matthieu-lapeyre/phd_thesis/media/poppy/conception/head_inspiration.jpg

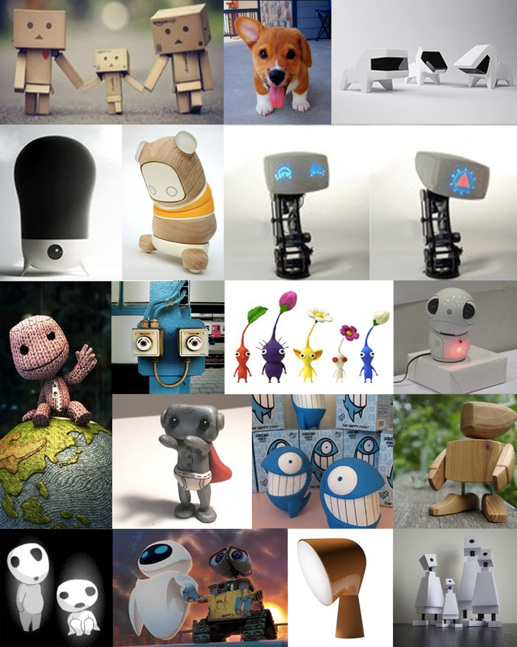
media/poppy/conception/head_inspiration.jpg
