matthieu-lapeyre/phd_thesis/media/poppy/conception/knee_w_spring.png

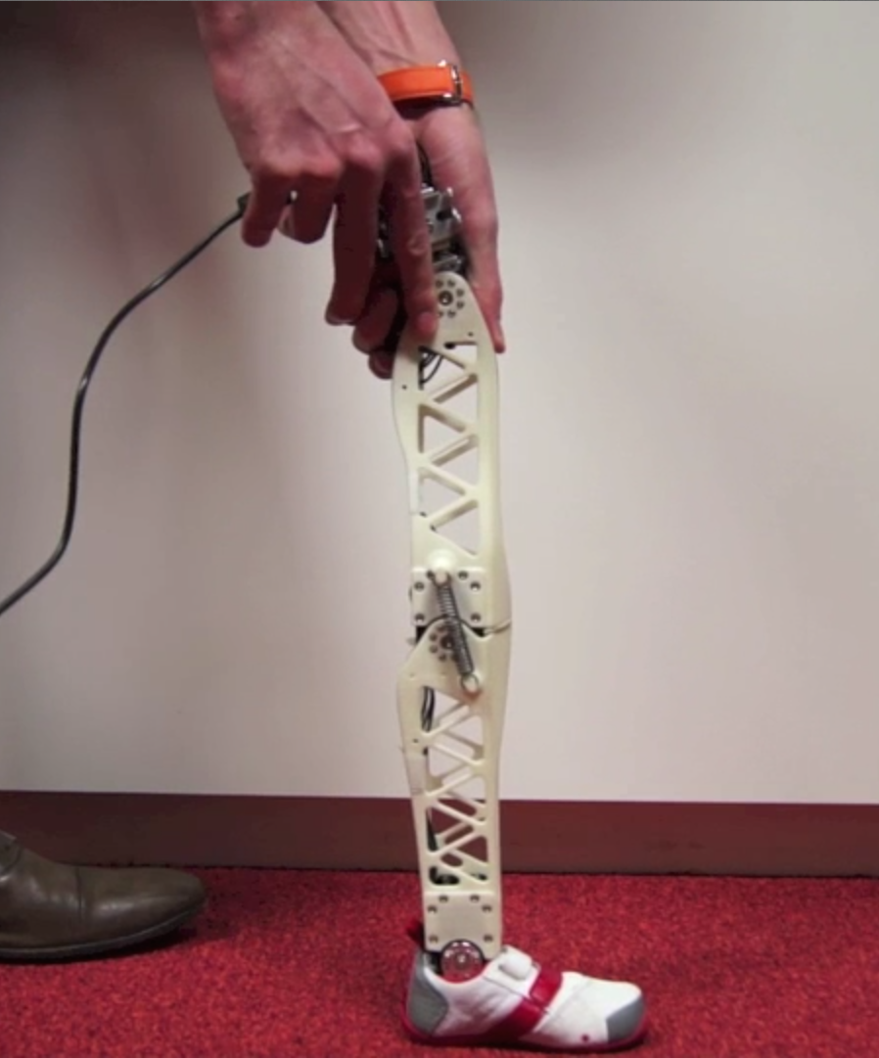
media/poppy/conception/knee_w_spring.png
