matthieu-lapeyre/phd_thesis/README.md

phd_thesis
==========

Redaction of my PhD Thesis
