matthieu-lapeyre/phd_thesis/latex/content/titlepages.tex

% !TEX root = ../thesis.tex
% %
% % ------------------------------------  --> cover title page
% \begin{titlepage}
%     \pdfbookmark[0]{Cover}{Cover}
%     \flushright
%     \hfill
%     \vfill
%     {\LARGE\thesisTitle} \par
%     \rule[5pt]{\textwidth}{.4pt} \par
%     {\Large\thesisName}
%     \vfill
%     \textit{\large\thesisDate} \\
%     Version: \thesisVersion
% \end{titlepage}

% ------------------------------------  --> main title page
\begin{titlepage}
    \pdfbookmark[0]{Titlepage}{Titlepage}
    \tgherosfont

    % \begin{figure}[!t]
    % % \centering
    %     \subfloat{\includegraphics[width=5cm]{Universite_Bordeaux_logo.jpg}}
    %     \hfil
    %     \subfloat{\includegraphics[width=5cm]{Universite_Bordeaux_logo.jpg}}
    % \end{figure}

    % \begin{figure}
      % {\raggedleft
      % \begin{minipage}{6cm}
      % \includegraphics[width=6cm]{Universite_Bordeaux_logo.jpg}
      % \end{minipage}}

    % \begin{figure}
    %     \begin{minipage}{.1\textwidth}
    %         \includegraphics[width=6cm]{Universite_Bordeaux_logo.jpg}
    %     % \hfill
    %     \end{minipage}
    % \end{figure}

    % \begin{figure}
    %     \begin{minipage}{.9\textwidth}
    %     \hfill
    %         \includegraphics[width=6cm]{Universite_Bordeaux_logo.jpg}
    %     \end{minipage}
    % \end{figure}

    \centering

    {\Large \thesisUniversitytwo} \\
    \textsf{\thesisUniversityInstitute} \\[4mm]
    % \textsf{\thesisUniversityDepartment} \\
    % \textsf{\thesisUniversityGroup} \\

    \vfill
    {\large \thesisSubject} \\[5mm]
    {\LARGE \color{ctcolormain}\textbf{\thesisTitle} \\[10mm]}
    {\Large \thesisName} \\ [2mm]
    {\large \thesisUniversity \\
    \thesisUniversityDepartment} \\[4mm]

    \vfill
    \begin{minipage}[t]{.21\textwidth}
        \raggedleft
        {\small \textit{Reviewer}}
    \end{minipage}
    \hspace*{15pt}
    \begin{minipage}[t]{.7\textwidth}
        {\large \thesisFirstReviewer} \\
        {\small \thesisFirstReviewerTitle},
        {\small \thesisFirstReviewerUniversity}
    \end{minipage} \\[5mm]
    \begin{minipage}[t]{.21\textwidth}
        \raggedleft
        {\small \textit{Reviewer}}
    \end{minipage}
    \hspace*{15pt}
    \begin{minipage}[t]{.7\textwidth}
        {\large \thesisSecondReviewer} \\
        {\small \thesisSecondReviewerTitle},
        {\small \thesisSecondReviewerUniversity}
    \end{minipage} \\[5mm]
    \begin{minipage}[t]{.21\textwidth}
        \raggedleft
        {\small \textit{President}}
    \end{minipage}
    \hspace*{15pt}
    \begin{minipage}[t]{.7\textwidth}
        {\large \thesisPresident} \\
        {\small \thesisPresidentTitle},
        {\small \thesisPresidentUniversity}
    \end{minipage} \\[5mm]
    \begin{minipage}[t]{.21\textwidth}
        \raggedleft
        {\small \textit{Examinator}}
    \end{minipage}
    \hspace*{15pt}
    \begin{minipage}[t]{.7\textwidth}
        {\large \thesisExaminator} \\
        {\small \thesisExaminatorTitle},
        {\small \thesisExaminatorUniversity}
    \end{minipage} \\[5mm]

    \begin{minipage}[t]{.21\textwidth}
        \raggedleft
        {\small \textit{Supervisor}}
    \end{minipage}
    \hspace*{15pt}
    \begin{minipage}[t]{.7\textwidth}
        {\large \thesisFirstSupervisor}\\
        {\small \thesisUniversityTitle},
        {\small \thesisUniversity}
    \end{minipage} \\[15mm]

    \thesisDate \\

\end{titlepage}

% ------------------------------------  --> lower title back for single page layout
\hfill
\vfill
{\small
\textbf{\thesisName} \\
\textit{\thesisTitle} \\
\thesisSubject\\
\thesisDate \\
Reviewers: \thesisFirstReviewer\ and \thesisSecondReviewer \\
Jury members: \thesisPresident, \thesisFirstReviewer, \thesisSecondReviewer, \thesisExaminator\ and \thesisFirstSupervisor\\
Supervisor: \thesisFirstSupervisor\\[1.5em]
\textbf{\thesisUniversity} \\
% \textit{\thesisUniversityGroup} \\
% \thesisUniversityInstitute \\
\thesisUniversityDepartment \\
\thesisUniversityStreetAddress \\
\thesisUniversityPostalCode\ \thesisUniversityCity\\
France
}
