matthieu-lapeyre/phd_thesis/latex/content/titlepages_fr.tex

% !TEX root = ../thesis.tex
%
% ------------------------------------  --> cover title page
\begin{titlepage}
    \pdfbookmark[0]{Cover}{Cover}
    \flushright
    \hfill
    \vfill
    {\LARGE\thesisTitle} \par
    \rule[5pt]{\textwidth}{.4pt} \par
    {\Large\thesisName}
    \vfill
    \textit{\large\thesisDate} \\
    Version: \thesisVersion
\end{titlepage}

% ------------------------------------  --> main title page
\begin{titlepage}
    \pdfbookmark[0]{Titlepage}{Titlepage}
    \tgherosfont
    \centering

    {\Large \thesisUniversitytwo} \\
    \textsf{\thesisUniversityInstitute} \\[4mm]
    % \textsf{\thesisUniversityDepartment} \\
    % \textsf{\thesisUniversityGroup} \\

    \vfill
    {\large \thesisSubjectFr} \\[5mm]
    {\LARGE \color{ctcolormain}\textbf{\thesisTitleFr} \\[10mm]}
    {\Large \thesisName} \\ [2mm]
    {\large \thesisUniversity \\
    \thesisUniversityDepartment} \\[4mm]

    \vfill
    \begin{minipage}[t]{.21\textwidth}
        \raggedleft
        {\small \textit{Rapporteur}}
    \end{minipage}
    \hspace*{15pt}
    \begin{minipage}[t]{.7\textwidth}
        {\large \thesisFirstReviewer} \\
        {\small \thesisFirstReviewerTitle},
        {\small \thesisFirstReviewerUniversity}
    \end{minipage} \\[5mm]
    \begin{minipage}[t]{.21\textwidth}
        \raggedleft
        {\small \textit{Rapporteur}}
    \end{minipage}
    \hspace*{15pt}
    \begin{minipage}[t]{.7\textwidth}
        {\large \thesisSecondReviewer} \\
        {\small \thesisSecondReviewerTitle},
        {\small \thesisSecondReviewerUniversity}
    \end{minipage} \\[5mm]
    \begin{minipage}[t]{.21\textwidth}
        \raggedleft
        {\small \textit{Président}}
    \end{minipage}
    \hspace*{15pt}
    \begin{minipage}[t]{.7\textwidth}
        {\large \thesisPresident} \\
        {\small \thesisPresidentTitle},
        {\small \thesisPresidentUniversity}
    \end{minipage} \\[5mm]
    \begin{minipage}[t]{.21\textwidth}
        \raggedleft
        {\small \textit{Examinateur}}
    \end{minipage}
    \hspace*{15pt}
    \begin{minipage}[t]{.7\textwidth}
        {\large \thesisExaminator} \\
        {\small \thesisExaminatorTitle},
        {\small \thesisExaminatorUniversity}
    \end{minipage} \\[5mm]

    \begin{minipage}[t]{.21\textwidth}
        \raggedleft
        {\small \textit{Directeur}}
    \end{minipage}
    \hspace*{15pt}
    \begin{minipage}[t]{.7\textwidth}
        {\large \thesisFirstSupervisor}\\
        {\small \thesisUniversityTitle},
        {\small \thesisUniversity}
    \end{minipage} \\[15mm]

    \thesisDateFr \\

\end{titlepage}

% ------------------------------------  --> lower title back for single page layout
\hfill
\vfill
{\small
\textbf{\thesisName} \\
\textit{\thesisTitleFr} \\
\thesisSubjectFr\\
\thesisDateFr \\
Rapporteurs: \thesisFirstReviewer\ and \thesisSecondReviewer \\
Membres du jury: \thesisPresident, \thesisFirstReviewer, \thesisSecondReviewer, \thesisExaminator\ and \thesisFirstSupervisor\\
Directeur: \thesisFirstSupervisor\\[1.5em]
\textbf{\thesisUniversity} \\
% \textit{\thesisUniversityGroup} \\
% \thesisUniversityInstitute \\
\thesisUniversityDepartment \\
\thesisUniversityStreetAddress \\
\thesisUniversityPostalCode\ \thesisUniversityCity\\
France
}
