matthieu-lapeyre/phd_thesis/latex/content/chapter/OP_RP_review.tex

% !TEX root = ../../thesis.tex

\cleartoleftpage
\includepdf{../media/chapter_illustration/3DprintedBlender.pdf}

\chapter{The open hardware and 3D printing revolution}
\label{cha:3Dprint-OSH}

% \cleanchapterquote{third industrial revolution}{the economist}

\section{Introduction} % (fold)

With the democratization of personal computers and the development of the internet, computer science and related applications have seen a great expansion. Open source software played a major role, indeed most of the web servers are running on the Linux operating system and Apache, while open source software like WordPress, Qt, Firefox, VLC and so on have permitted the realization of a wide variety of applications in daily life~\parencite{peeling2001analysis}.

However, while copying and sharing bits of software is virtually free and can often be run on any computer, producing the atoms of a real object both has a potentially high cost and requires expert tooling. Thus, the production of the mechanic or electronic hardware components is limited to two options: either it is handcrafted or mass produced. Also, the step between the handcrafted prototype and mass production is so large that only big companies can achieve it. Conventional manufacturing processes require the production of specific tools, the programming of complex machines, the human intervention to put the part along the different tool and so on, most of the costs are in the up-front tooling, and the more complicated a product is, the more it costs. Thus, most companies would not accept to run a whole production process just for a few units and if they accept the cost will be so high that most prototypes never find a way of reaching people outside the workshop where they had been created. So until now, production in small or medium series has been extremely difficult to achieve because it has not been profitable.
Only big companies have been able to raise enough money to produce new hardware, meaning niche products and personalization are left aside.

Over the last few years, a novel evolution has begun that is going to completely change the current rules of production and distribution of goods. This evolution is acting on both technological and political/societal front, which tends to confirm the claims of those who argue it will be the next industrial revolution~\parencite{anderson2012makers}. Indeed, new rapid prototyping technologies are emerging and make production cheap, fast and easy to anyone. At the same time, the associated machines and tools are diffused under open source hardware licenses, acting as an unexpected lever arm toward the diffusion of these technologies to anyone. All these radical changes are contextualized by the phenomenon of \emph{makers} and the exponential growth of associative production spaces (e.g Fab Lab, Makerspace, Tech Shop or Hackerspace).

In this chapter, we will first present and discuss ground-breaking 3D printing technology. Then we will present the open source hardware movement and how its interaction with 3D printing is changing the current production paradigm.

\section{The 3D printing revolution} % (fold)

Prototyping is an essential step in a product development and manufacturing cycle. It allows for the form and the functionalities of a new product to be tested before large investment in tooling for mass production. Until the last decade, prototypes were largely handmade by skilled craftsmen, adding weeks or months to the product development time.

\begin{figure}[tb]
\centering
    \subfloat[][Nylon]{\label{fig:3Dprinted_part}}
    \hfil
    \subfloat[][Steel]{\label{fig:3Dprinted_steel}}
    \hfil
    \subfloat[][Odd Guitar]{\label{fig:3Dprinted_guitar}}
    \caption{Some examples of 3Dprinted parts, which were until now impossible to produce. In addition, it can be done with a large range of material from wax to titanium.}
    \label{fig:3D_printed_objects}
\end{figure}

The term 3D printing  encompasses various processes for making a three-dimensional object from a digital model, primarily through additive processes in which successive layers of material are laid down under computer control.
Accurate parts can be produced right from a digital model in few hours and with minimum handling tasks. Consequently, errors are minimized and product development costs and lead times substantially reduced. It has been claimed that rapid prototyping can cut new product costs by up to 70\% and the time to market them by 90\%~\parencite{waterman1994rapid}.

Recent progress in the 3D printing process means 3D printing can be considered not only as a way to produce prototypes but also as an actual production technique. Indeed, the layered method of assembly allows intricate designs - geometries, which are either impossible or too expensive to achieve with conventional metal casting (see \figurename~\ref{fig:3D_printed_objects}).

In this section we detail the different 3D printing techniques available with pros and cons, then we will discuss the expected changes in the industrial sector.

\subsection{Multiple techniques} % (fold)

The term 3D printing encompasses several different additive processes.

\subsubsection{Fused Deposition Modeling (FDM)} % (fold)

The FDM technique relies on melting and selectively depositing a thin filament of thermoplastic polymer (ABS - PLA) in a cross-hatching fashion to form each layer of the part. The material is in the form of a wire supplied in sealed spools, which is mounted on the machine, and the wire is threaded through the FDM head. The head moves in the horizontal X and Y directions to produce each layer through zigzag movements. The supporting table moves in the vertical direction and is lowered after the completion of each layer (see \figurename~\ref{fig:FDM_process}).

\begin{figure}[tb]
    \centering
        \subfloat[][FDM process]{\label{fig:FDM_process}}
        \hfil
        \subfloat[][FDM result example]{\label{fig:FDM_part}}
        \hfil
    \caption{The FDM technique relies on melting and selectively depositing a thin filament of thermoplastic polymer (ABS - PLA) in a cross-hatching fashion to form each layer of the part.}
    \label{fig:FDM_technique}
\end{figure}

It is a technique that is really low-cost and friendly to the office environment but is limited by its slowness on dense parts, the need for supports and its lack of precision for detail, thin walls and surface finish (see \figurename~\ref{fig:FDM_part}).

\subsubsection{Stereo-Lithography (SLA)} % (fold)

This technique relies on a photosensitive monomer resin, which forms a polymer and solidifies when exposed to ultraviolet (UV) light. The UV laser beam moves in a horizontal direction and is focused on the top layer to polymerize the photosensitive resin (see \figurename~\ref{fig:SLA_process}). Due to the absorption and scattering of the beam this reaction only takes place near the surface. Then the cured layer of polymer is lowered by the platform (Z axis) so that a fresh layer of liquid resin covers the part.

\begin{figure}[tb]
    \centering
        \subfloat[][SLA process]{\label{fig:SLA_process}}
        \hfil
        \subfloat[][Some parts made with a SLA printer]{\label{fig:SLA_parts}}
        \hfil
    \caption{The stereolithography technique: a UV laser beam polymerizes the top layer of a photosensitive resin in a horizontal direction (X/Y) while the platform moves in a vertical direction.}
    \label{fig:SLA_technique}
\end{figure}

This technique has several advantages, such as a good surface finish (see \figurename~\ref{fig:SLA_parts}), and is capable of producing highly detailed parts with thin walls, but is limited by material (only photopolymers) and support structures are always needed which can be difficult to remove.

\subsubsection{Selective Laser Sintering (SLS)} % (fold)
The Selective Laser Sintering process uses a high-power (25-50W) CO2 laser beam that melts and fuses finely powdered material spread on a layer. Before the powder is sintered, the entire bed is heated to just below the melting point of the material in order to minimize thermal distortion and facilitate fusion with the previous layer.
While the laser moves on the horizontal plane, the platforms move along the vertical axis -through a distance corresponding to the layer thickness (usually 0.01 mm) - and a counter-rotating roller spreads a precise amount of fresh powder above the sintered layer. The unsintered powder serves as the support for overhanging portions if there are any in the subsequent layers.

\begin{figure}[tb]
    \centering
        \subfloat[][SLS process]{\label{fig:SLS_process}}
        \hfil
        \subfloat[][]{\label{fig:SLS_part}}
        \hfil
    \caption{The Selective Laser Sintering process uses a high-power laser beam that melts and fuses finely powdered material spread on a layer.}
    \label{fig:SLS_technique}
\end{figure}

This technique has a really interesting advantage: it is compatible with different materials (Polyamide, Alumide), moreover it does not require support and mechanical properties of parts are homogeneous (the same in any direction). However, this technique requires some handling to extract extra powder from the part and SLS 3D printers are very expensive (+\$50K).

\subsubsection{Direct Metal Laser Sintering (DMLS)} % (fold)

Direct Metal Laser Sintering is very similar to the SLS process but uses a high-powered 200 watt Yb-fiber optic laser in order to fuse metal powder into a solid part by melting it locally (see \figurename~\ref{fig:DMLS_Process}). Parts are built up additively layer-by-layer, typically using layers 20 micrometres thick. This process allows for highly complex geometries to be created directly from the 3D CAD data, fully automatically, in hours and without any tooling. DMLS is a net-shape process, producing parts with high accuracy and detailed resolution, good surface quality and excellent mechanical properties (see \figurename~\ref{fig:DMLS_part}). However, this is obviously the most expensive technique.

\begin{figure}[tb]
    \centering
        \subfloat[][DMLS part]{\label{fig:DMLS_Process}}
        \hfil
        \subfloat[][DMLS part]{\label{fig:DMLS_part}}
        \hfil
    \caption{Direct Metal Laser Sintering is very similar to the SLS process but uses a high-powered 200 watt Yb-fiber optic laser in order to fuse metal powder into a solid part by melting it locally.}
    \label{fig:DMLS_technique}
\end{figure}

\subsection{Major impact expected in days to come} % (fold)

The 3D printing is revolutionizing the way people can produce parts. On one hand, it brings very affordable numeric production tools to a wide audience. Using these tools, communities have emerged with Fablab, makerspace or hackerspace, where people can create together new projects involving specific and home-made hardware components. As computers have allowed people to produce in their garage new software or websites and eventually develop a novel e-economy, the 3D printing open the landscape of possibilities for hobbyists to innovate by developing novel hardware prototypes and niche products at a fraction of the cost of classical manufacturing techniques.

On the other hand, these techniques also open new horizons for the industry. At The University of Southern California, Professor Behrokh Khoshnevis has built a robot equipped with a nozzle that spews out concrete. This  colossal 3D printer can build a house in 24 hours and therefore dramatically reduces its cost.

Another example is the SuperDraco engine (see \figurename~\ref{fig:superdraco}), this rocket engine has its combustion chamber 3D-printed by direct metal laser sintering (DMLS). The regeneratively-cooled combustion chamber is made of Inconel; a family of nickel-chromium alloy that is noteworthy for its high strength and toughness.

\begin{formal}
    Through 3D printing, robust and high-performing engine parts can be created at a fraction of the cost and time of traditional manufacturing methods. SpaceX is pushing the boundaries of what additive manufacturing can do in the 21st century, ultimately making our vehicles more efficient, reliable and robust than ever before.

    \signed{Elon Musk, SpaceX CEO/CTO and Tesla Motors CEO.}
\end{formal}

Thus, parts for vehicles can be optimized to be lighter and - simultaneously - incredibly robust (see \figurename~\ref{fig:EADS_hinge}). The AMAZE project has been able to print airplane wing sections as well as jet engine parts, and the ESA hopes to one day print a satellite as one piece:
\begin{formal}
    This novel technology offers many advantages. 3D printing, formally known as additive manufacturing, can create complex shapes that are impossible to manufacture with traditional casting and machining techniques. Little to no material is wasted and cutting the number of steps in a manufacturing chain offers enormous cost benefits.

    \signed{European Space Agency (ESA)}
\end{formal}

\begin{figure}[tb]
\centering
    \subfloat[][The SuperDraco rocket engine has a combustion chamber: 3D-printed - SpaceX.]{\label{fig:superdraco}}
    \hfil
    \subfloat[][A conventional hinge is seen in the background and a 3D-printed metal hinge is seen in the foreground - EADS.]{\label{fig:EADS_hinge}}
    \caption{Thanks to its special properties, 3D printing is hitting the industry}
    \label{fig:industrie_printing}
\end{figure}

\subsection{Conclusion} % (fold)

3D printers open new horizons as they are able to produce parts which were, until now, either not possible or extremely expensive to produce using classical techniques while adding several key abilities:
\begin{itemize}
    \item \textbf{Accessible:} 3D printed parts can be obtained everywhere, either by personal printing or by using an online service\footnote{examples: i.materialise, Shapeways or Sclupteo}.
    \item \textbf{Low cost:}  from tens of cents if produced on a personal printer to tens of euros if outsourced through web services. Also, the cost is not proportional to the part’s complexity, meaning designers are free to explore the shape they want with almost no constraints.
    \item \textbf{Fast:} Production takes only a few hours from scratch and does not require any specific upfront tooling.
    \item \textbf{Skill-free:} while the production process is fully digital, few or no specialist skills are required.
    \item \textbf{Multi-material, precise and robust:} the current 3D printers can create precise (up to 0.1mm) parts from different materials such as Polyamide, PLA, ABS and even titanium or flexible material. The obtained parts are robust and can often be used as final parts for several years.
    \item \textbf{Reduces the number of parts:} 3D printing permits the printing of complex parts and even assembled parts as complex as bearings or gearboxes. This means we can replace multiple parts that have to be assembled by a single ready-to-use part right after production.
\end{itemize}

\section{The open hardware movement} % (fold)

The concept of "open-source hardware" or "open hardware" is not as well known or widespread as the free software or open-source software concepts yet. However, it shares the same principles: anyone should be able to see the source (the design documentation in case of hardware), study it, modify it and share it.

\subsection{Open hardware in the industrial history.} % (fold)

In the 18th century, London and Lyon (France) were two majors silk manufacturing towns. Because London was on the way to taking the lead, Lyon tried a new and original policy for innovation. They decided to freely diffuse new techniques. Inventors were invited to the city hall to present their innovations publicly. They were then rewarded a first time for the presentation, and a second time when the innovation was actually implemented on Lyon machines. This policy was followed by decades of cumulative inventions such as perforated paper tape (1725 B. Bouchon), punched card programming (1728, J-B. Falcon), the Jacquard loom (1801, J-M. Jacquard), and the sewing machine (1829, B.Thimonnier). Meanwhile, silk production in London was governed by patents, techniques were kept secret and monopolized by their inventors~\parencite{alain1997fate}.

The impact of these two opposed political choices turned out largely in Lyon’s favour. In 1815, Lyon had 14,500 looms and London 12,000. But in 1853, Lyon had 60,000 looms while London fell to only 5,000 and became a silk importer.

Lyon stimulated inventions and disseminated innovation: looms became programmable, order processing and production agile, parts were standardized, counter-tops parts appeared, services grew, the Lyon loom park was up to date and operational.
In London, the industry was controlled by investors, customers had to order large series, the choice available decreased, waiting periods were longer, the artisans became employees, wages fell and the state of the London looms park deteriorated.

The Lyon policy created a win-win ecosystem creating both job opportunities and advanced technology. Thanks to this choice, the city took the lead over London.

\subsection{Definition of Open Hardware } % (fold)

The Open Source Hardware Association (OSHWA) aims to be the voice of the open hardware community. It promotes the use and development of open source hardware for education and economic development, to collect, compile and publish data on the open source movement and organize the movement around shared principles.

Also the Open Source Hardware Association defines\footnote{Complete definition available on \url{http://www.oshwa.org/definition/}.} open source hardware as:

\begin{row}{4}{2}
    \begin{cell}{3}
        \emph{Hardware whose design is made publicly available so that anyone can study, modify, distribute, make, and sell the design or hardware based on that design. The hardware’s source, the design from which it is made, is available in the preferred format for making modifications to it. Ideally, open source hardware uses readily-available components and materials, standard processes, open infrastructure, unrestricted content, and open-source design tools to maximize the ability of individuals to make and use hardware. Open source hardware gives people the freedom to control their technology while sharing knowledge and encouraging commerce through the open exchange of designs.}
    \end{cell}
    \begin{cell}{1}
        \begin{NFfigure}
            \centering
                
            \caption{The open source hardware logo}
            \label{fig:ohw-logo}
        \end{NFfigure}
    \end{cell}
\end{row}

\subsection{Open source hardware licenses} % (fold)

The Open Source Hardware Association definition is not enough, a legal framework is needed to both protect and promote open hardware projects. This is the role of open source licenses which will be discussed in this section.

In general, there are two broad classes of open-source licenses: copyleft and permissive. Copyleft licenses (sometimes referred to as “viral”) are those that require derivative works to be released under the same license as the original; common copyleft licenses include the GNU General Public License (GPL) and the Creative Commons Attribution-ShareAlike license. Other copyleft licenses have been specifically designed for hardware; they include the CERN Open Hardware License (OHL) and the TAPR Open Hardware License (OHL). Permissive licenses are those that allow for proprietary (closed) derivatives; they include the FreeBSD license, the MIT license, and the Creative Commons Attribution license

\subsubsection{Creative Commons licenses} % (fold)
\begin{row}{4}{2}
    \begin{cell}{3}
        Founded in 2001, Creative Commons is a non-profit organization that enables the sharing and use of creativity and knowledge through free legal tools. They provide free and understandable licenses standardizing the way to share and use creative work. Thanks to the use of several modules, which can be combined, the Creative Commons licenses permit the creator to modify his copyright terms to best suit his needs. First intended for artistic and cultural content such as music and writing, the Creative Commons are now used also to share open source hardware files.
    \end{cell}
    \begin{cell}{1}
        \begin{NFfigure}
            \centering
                
            \caption{Creative Commons logo}
            \label{fig:cc_logo}
        \end{NFfigure}
    \end{cell}
\end{row}
The Creative Commons licenses are based on four major condition modules:
\begin{description}
    \item[Attribution (BY)]: requiring attribution to the original author.
    \item[Non Commercial (NC)]: requiring the work to not be used for commercial purposes.
    \item[No Derivative works (ND)]: allowing only the original work, without derivatives
    \item[Share Alike (SA)]: allowing derivative works under the same or a similar license (later or jurisdiction version).
\end{description}

The combination of these modules leads to six licenses (see \figurename~\ref{fig:all-cc-licenses}) but related to open hardware, only two of them are considered as open source following the OSHW definition:
\begin{description}
    \item[Attribution CC BY] People can distribute, remix, tweak and build upon the licensed work, even commercially, as long as they credit the authors of the original creation.
    \item[Attribution-ShareAlike CC BY-SA] People can distribute, remix, tweak and build upon the licensed work, even commercially, as long as they credit the authors and license their new creations under identical terms. \textbf{This license is often compared to the “copyleft” free and open source software licenses.}
\end{description}

\begin{figure}[tb]
    \begin{center}
        
    \end{center}
    \caption{The combination of the 4 Creative Commons modules give 6 licenses allowing creators to choose how they want to share their work and how "open" they are.}
    \label{fig:all-cc-licenses}
\end{figure}

\subsubsection{CERN OHL} % (fold)

Inspired by the open source software movement, the Open Hardware Repository\footnote{\url{http://www.ohwr.org/}} was created to enable hardware developers to share the results of their R\&D activities. The recently published (March 2013) CERN Open Hardware License offers the legal framework to support this knowledge and technology exchange.

The CERN–OHL is to hardware what the General Public Licence (GPL) is to software. It defines the conditions under which a licensee will be able to use or modify the licensed material and is compliant with the OSHWA definition criteria. In the spirit of knowledge sharing and dissemination, the CERN Open Hardware Licence (CERN OHL) governs the use, copying, modification and distribution of hardware design documentation, and the manufacture and distribution of products\footnote{License details available on \url{http://www.ohwr.org/projects/cernohl/wiki}}.

\subsubsection{TAPR Open Hardware License (OHL)}
Specifically designed for open hardware, and avoids the issues other licenses have with focusing on copyright protection of documentation instead of the right to make, distribute, or use a product based on that documentation\footnote{The full text of the TAPR Open Hardware License (OHL) is available here: \url{http://www.tapr.org/ohl.html}}. It requires that all derived works use the same license and include before and after documentation if any changes were made.

\subsection{Some famous open hardware projects} % (fold)

Based on the open source hardware philosophy, several companies and projects have been created over the past ten years (see \figurename~\ref{fig:oh_evolution}).

\begin{figure}[tb]
\centering
    \subfloat[][Creation of new open hardware projects per year between 2005 and 2011.]{\label{fig:oh_project_evolution}}
    \hfil
    \subfloat[][Start-up creation based on open hardware distribution]{\label{fig:oh_startup_creation}}
    \caption{Evolution of the open source hardware movement in the past decades. Graph extracted from \emph{HOPE 2010 - How to run an open source hardware company}}
    \label{fig:oh_evolution}
\end{figure}

Several kinds of object have began to have an open source version, even the most advanced ones such as laptops (Novena project\footnote{\url{https://www.crowdsupply.com/kosagi/novena-open-laptop}}), reflex camera (OpenReflex\footnote{\url{http://www.instructables.com/id/3D-Printed-Camera-OpenReflex/}}) or even cars (LocalMotors\footnote{\url{https://localmotors.com/vehicles/}}, OSVehicle\footnote{\url{http://www.osvehicle.com/}}).

\subsubsection{Arduino} % (fold)
\label{sec:arduino-review}
One of the most meaningful open hardware project is Arduino. Massimo Banzi was a teacher from the Interaction Design Institute Ivrea in Italy. His students were using \emph{BASIC Stamp}\footnote{A BASIC Stamp module is a single-board computer that runs the Parallax PBASIC language interpreter in its microcontroller.} for a cost of \$100 and often complained they couldn't find an inexpensive, powerful microcontroller to drive their arty robotic projects.

\begin{row}{4}{2}
    \begin{cell}{3}
      In 2005 Banzi and David Cuartielles, a Spanish microchip engineer, decided to design their own board. The Arduino project aimed to offer an affordable and easy to use electronics board for a student-friendly price: \$30. The first wiring design was done during the Ph.D. thesis of Hernando Barragan~\parencite{barragan2004wiring} and the software by another student: David Cuartielles.
      After the wiring platform was complete, researchers worked to make it lighter, less expensive, and available to the open source community.
    \end{cell}
    \begin{cell}{1}
        \begin{NFfigure}
            \centering
                
            \caption{The Arduino logo}
            \label{fig:arduino_logo}
        \end{NFfigure}
    \end{cell}
\end{row}

The Arduino story was one of the first hardware projects with a real desire to promote innovation through open source, so to make it work they had to find an appropriate licensing solution that could apply to their board. After some investigation, they realized that if they simply looked at their project differently, (i.e. considering the source files as documentation\footnote{\emph{"You could think of hardware as piece of culture you want to share with other people"}, Banzi. }), they could use a license from Creative Commons normally used for cultural works such as music and writing.

They define their work as:

\begin{formal}
  Arduino is a platform for prototyping interactive objects using electronics. It consists of both hardware and software: a circuit board that can be purchased at low cost or assembled from freely-available plans; and an open-source development environment and library for writing code to control the board. Arduino comes from a philosophy of learning by doing and strives to make it easy to work directly with the medium of interactivity. It extends the principles of open source to the realm of hardware, supporting a community of people working with and extending the platform. It has been used in universities around the world and in numerous works of interactive art.

  \signed{Mellis~\parencite{mellis2007arduino}}
\end{formal}

By 2006, Arduino has sold 5,000 boards, the next year 30,000. Following the idea of open source collaboration the community eventually grows until 100,000 people and thousand of side projects and derivatives emerged. In 2013, Arduino has registered over 700,000 official boards but has estimated that there is at least one derivative or clone board per every official one.

Today, Arduino is a very successful project with more than 1,000,000 boards sold and a wide range of low-cost electronics boards\footnote{http://arduino.cc/en/Main/Products}. Moreover, there are now dozens of open-hardware oriented companies building new products on top of Arduino environment, the most famous ones being Sparkfun\footnote{\url{http://www.sparkfun.com/}} and Adafruit\footnote{\url{http://www.adafruit.com/}}.

\subsubsection{Shapeoko}

\begin{figure}[!ht]
    \begin{center}
        
    \end{center}
    \caption{The shapeoko v2 is a low cost and open source CNC 2.5 axes.}
    \label{fig:shapeoko}
\end{figure}

Designed by Edward Ford, Shapeoko (see \figurename~\ref{fig:shapeoko}) is a simple, low cost (\$685) and open source (CC-BY-SA) CNC milling machine. It is based on two other open hardware projects: MakerSlide\footnote{Open a source linear bearing system under Creative Common BY-SA licenses: \url{http://makerslide.com/}} for linear motion and an Arduino board for the control.

\subsubsection{RepRap} % (fold)

The RepRap project started in 2005 and based on the Fab@Home\footnote{\url{http://www.fabathome.org/}} principles, developed a multi-purpose open source 3D printer using Fused Deposition Modeling, a technique with the particularity of being largely self-replicating:

\begin{formal}
    RepRap is an open-source, self-replicating, rapid prototyping machine. It is a robot that uses fused-filament fabrication1 to make engineering components and other products from a variety of thermoplastic polymers. RepRap has been designed to be able automatically to print out a significant fraction of its own parts. All its remaining parts have been selected to be standard engineering materials and components available cheaply worldwide. As the machine is free and open-source anyone may – without royalty payments – make any number of copies of it either for themselves or for others, using RepRap machines themselves to reproduce those copies.

    \signed{~\cite{jones2011reprap}}
\end{formal}

\begin{figure}[tb]
\centering
    \subfloat[][RepRap v2]{\label{fig:RepRap_v2}}
    \hfil
    \subfloat[][MakerBot Replicator v1]{\label{fig:makerbot-replicator}}
    \caption{Two examples of very low-cost FDM 3D printers.}
    \label{fig:RepRap_project}
\end{figure}

Distributed under GNU General Public License, the RepRap (see \figurename~\ref{fig:RepRap_v2}) was one of the first low-cost 3D printers. Thanks to the fact that it is genuinely collaborative, this project generated such a large number of variations and interpretations that is difficult to even count. One of them is the famous Makerbot Replicator (see \figurename~\ref{fig:makerbot-replicator}). Now Makerbot is one of the major worldwide general public 3D printer distributors.

\section{Conclusion}

The emergence of new and accessible rapid prototyping techniques changes ways of producing things. Because it is now quick, simple and cheap to make things, it opens the realm of possibility of sharing hardware because anyone can produce it.

The 3D printing and open source hardware are complementary. Indeed, open source projects are more relevant when, as the software, people contributing can build the project at home. In this way, 3D printing can act as a lever arms for open hardware projects while open hardware projects are meaningful to widespread the use of 3D printers.

Also, Arduino has shown how useful can be open hardware projects and opened new perspectives allowing non-expert people to easily create interactive objects. While ones could think open sourcing is dangerous for economic viability, Arduino demonstrated that it actually generates new kind of economy, derivative contributing to the development of the community rather than stealing commercial parts.

Following this example, Tesla Motor have recently released open source all their patents about electric cars. Elon Musk\footnote{SpaceX CEO/CTO and Tesla Motors CEO} is a genuine inventor, yet also a very good businessman. This act is not a philanthropic idea, it will actually permit Tesla to develop its economy. Indeed, they are the only active actor on the electric car market. To increase the market, more actor are needed. By releasing their patents, Tesla hopes to create dynamically favorable to the expansion of their market. By this way, they target to have a good part of a big market rather than having a big part of a small market.

Therefore, using 3D printing technique and open hardware distribution model appear to be promising for the future of technology and economic development.
