matthieu-lapeyre/phd_thesis/latex/content/chapter/morphology-role.tex

% !TEX root = ../../thesis.tex

\newpage
\section{Experimental evaluation of the role of the morphology: the thigh shape} % (fold)
\label{sec:morphology-role}

The role of morphology in robot bipedal locomotion has been particularly explored through the research on passive dynamic walkers~\parencite{wisse2007passive}. The most famous example concerns Tad MacGeer's work~\parencite{mcgeer1990passive}. Thanks to the understanding of the intrinsic dynamics of its structure, McGeer has managed to create a 2D biped robot capable of producing several steps without any controller or motor.
The only control of this robot is obtained through the interaction between the intrinsic inertia of the structure and gravity.
This work has been pursued with the appearance of semi-passive walkers combining both specific passive properties and low power actuation to increase their robustness~\parencite{Anderson2005}. We can note the work of Collins~\parencite{collins2005bipedal} which explored the case of a semi-passive 3D biped robot. Its morphology is based on a particular mass distribution, knee locking, round feet and springs on the legs to generate an efficient walking gait while keeping its lateral and frontal balance.
The concept of the 3D semi-passive robot has been pushed even further with the realization of a complete humanoid robot with a torso, arms and head: the robot Denise~\parencite{wisse2005three} and Flame presented in~\parencite{Hobbelen2008}.

\begin{figure}[!t]
\centering
    \subfloat[][bended thighs]{\label{fig:poppy_with_bended_legs}}
    \hfil
    \subfloat[][straight thighs]{\label{fig:poppy_with_classical_legs}}
    \caption{We evaluate the effect of thigh morphology on the bipedal locomotion dynamic.
    Experiments are made using the Poppy humanoid platform.
    In this paper, we compare two thigh morphologies: (a) thigh bended by an angle of 6\textsuperscript{o} and (b) a more classical approach with straight thighs.}
    \label{fig:poppy_compared}
\end{figure}

The geometry and distribution of mass in the body has complex influences on bipedal locomotion. Several studies have, for example, explored the role of the foot and ankle morphology for bipedal walking in both humans~\parencite{Adamczyk2006}~\parencite{Hughes1990} and robots~\parencite{hobbelen2005ankle}~\parencite{Davis2010}. However, to our best knowledge no research has focused on the role of the thigh for bipedal locomotion.  A few robots like HRP-4C~\parencite{kaneko2009cybernetic} and Kenshiro humanoid~\parencite{nakanishi2013design} robots seem to visually have a morphological design close to the thigh shape of Poppy, but no comparative study of the role of this shape was presented so far.

Thanks to the mechanical design of Poppy, allowing easy, cheap and fast morphological modifications, we are able to experiment with various thigh shapes on the robot’s dynamics and find out what impact those have. In particular, in this experiment, we will focus on its bio-inspired thigh shape, bended by an angle of 6\textsuperscript{o}. We will investigate the impact of this thigh design on balance and bipedal locomotion using a comparison with a more traditional straight thigh (see Fig.~\ref{fig:poppy_compared}).

% The results presented in the upcoming sections have been published in the Humanoids 2013 conference proceeding~\parencite{lapeyre:hal-00861110}.

\subsection{Understanding the role of the thigh shape in humans} % (fold)

If we look closely at the morphology of the human femur, it appears that it is inclined by an angle of 6\textsuperscript{o}. This makes the feet closer to the projection of the center of gravity (CoG) (see Fig.~\ref{fig:human_thigh_experiments}) therefore it reduces the distance travelled by the CoG to move from foot to another.

The model presented in appendix~\ref{appendix:thigh_model} has been used during the conception of Poppy to decide the use of bended thigh rather than classic straight one. This simple model, based on an inverted pendulum, shows this particular shape may enhance the stability in two main ways during the walking gait:

\begin{itemize}
    \item As the feet are closer to the center of gravity, the lateral translation of the CoG necessary to transfer the mass of the robot from one foot to another is reduced (see Fig~\ref{fig:human_thigh_experiments}). In the case of Poppy's morphology, thanks to the $6$\textsuperscript{o} bended thigh, the lateral motion of the CoG is reduced by about 30\% ($ 5 cm$ instead of $7.1 cm$).
    \item During the stance phase, the CoG initial conditions are slightly modified. Therefore, it reduces the CoG falling speed in the beginning. So if we consider the first 700 ms of the system behavior simulation and compare the two systems, the mean of the CoG falling speed is reduced by around 56\% in the bended thigh case.
\end{itemize}

\begin{figure}[tb]
\centering
    \subfloat[][Effect of bended human femur on human bipedal locomotion]{\label{fig:human_thigh_experiments}}
    \hfil
    \subfloat[][Implementation of the bended thigh on the poppy platform]{\label{fig:thigh_of_poppy}}
    \caption{The human femur is inclined by an angle of 6\textsuperscript{o}, this reduces the distance traveled by the CoG to be supported from one leg to the other during walking. We reproduced it on Poppy and suggest exploring its impact on the robot dynamics.}
    \label{fig:poppy_thigh_experiment}
\end{figure}

\subsection{Experimenting with variable thigh properties on Poppy} % (fold)

The simple model described in appendix~\ref{appendix:thigh_model} showed that a slight inclination (6\textsuperscript{o}) of the thigh can theoretically achieve a significant gain in the lateral stability of the robot during the two main phases of the walking gait (i.e. single stance phase and double stance phase).
Yet this model is very simple and Poppy allows to experiments easily the role of morphology in the real world with all its complexity.

Therefore, we modified the thigh shape and printed it. As shown on the \figurename~\ref{fig:thigh_drawings}, the only modified parameter is the thigh bending angle, two cases: 6\textsuperscript{o} and 0\textsuperscript{o}.

\begin{figure}[p]
    \begin{center}
        
    \end{center}
    \caption{Blueprints of the two thighs tested in this experiment. The only parameter explored is the bending angle of the thigh: 6\textsuperscript{o} and 0\textsuperscript{o}}
    \label{fig:thigh_drawings}
\end{figure}

In this section, we describe representative experiments, which evaluate the actual gain of the thigh shape on the real Poppy platform. To do this, we used both a pair of straight thighs and the bended thighs presented above. We will compare Poppy's reactions with those different legs (see \figurename~\ref{fig:poppy_compared} and \figurename~\ref{fig:thigh_drawings}) on three experiments:
\begin{itemize}
    \item Evaluate the falling speed during single support stance.
    \item Measure the lateral translation to move the CoG Form one foot to the other.
    \item Record the upper body motion during bipedal locomotion.
\end{itemize}

\subsubsection{Single support falling velocity} % (fold)
\label{ssub:falling_velocity}
The experiment evaluates the velocity of fall when Poppy is supported on only one foot and compare it with the theoretical results obtained in~\ref{sub:exp_theoritical_model}. To do so, the robot's head is tracked by an Optitrack\footnote{\url{http://www.naturalpoint.com/optitrack/products/v120-trio/}} device and markers are placed on the head. In postural balance on two feet, a motor order triggers the rise of a foot which unbalances the robot (see Fig.~\ref{fig:falling_experiment_dispositif}) and causes its lateral fall (see Fig.~\ref{fig:fall_of_poppy}). This experiment was repeated about fifteen times for the two cases studied, i.e. with bended legs (Fig.~\ref{fig:poppy_with_bended_legs}) and with straight legs (Fig.~\ref{fig:poppy_with_classical_legs}).

\begin{figure}[ht]
\centering
    \subfloat[][ Initial perturbation provoked by the sudden raise of one foot]{\label{fig:falling_experiment_dispositif}}
    \hfil
    \subfloat[][ view of Poppy’s lateral fall over time]{\label{fig:fall_of_poppy}}
    \caption{Run of the single support falling experiment.
    The markers on Poppy’s headband track its absolute position over time.}
    \label{fig:falling_experiment}
\end{figure}

Experiments results are shown in Fig.~\ref{fig:falling_results}. The blue color is assigned to experiments with bended thighs while the red color is assigned to straight thighs. For each case, the light color corresponds to the standard deviation and the dark color to the 95\% confidence interval of the mean value. The first figure~(\ref{fig:fall_result_position}) refers to the head altitude position over time and the second~(\ref{fig:fall_result_velocity}) to the falling velocity of the head. Dashed lines represent theoretical results obtained with the model presented in section~\ref{fig:model_thigh_appendix}. We notice the strong similarity both on the shape and on the difference between the two morphologies studied. Yet, there is a slight time shift between theoretical and experimental results. This can be explained by the inertia of the real robot which was not taken into account during the simulation.

\begin{figure}[ht]
\centering
    \subfloat[][Vertical head position]{\label{fig:fall_result_position}}
    \hfil
    \subfloat[][Vertical head falling velocity]{\label{fig:fall_result_velocity}}
    \caption{Results of the single support falling experiment.
    The blue color is associated with experiments conducted with bended thighs while the red color is assigned to straight thighs.
    For each case, the light color corresponds to the standard deviation and the dark color to the 95\% confidence interval of the mean value while dashed lines represent theoretical results.
    These figures show the vertical position (a) and vertical falling velocity (b) of the head of Poppy over time for each case studied.
    The curve’s behavior change after 800 min is due to the fact that we catch the robot before it touches the ground.}
    \label{fig:falling_results}
\end{figure}

These figures show a clear improvement for the version of Poppy with bended thighs (blue curves) with a 200 min time shift compared to the straight thighs (as illustrated on the attached video\footnote{\url{http://flowers.inria.fr/Humanoid2013/}\label{video}}).
Thanks to this delay, the falling speed is reduced by about 56\% during the first 700ms. Thus, the robot remains almost stationary for 600 min (400 min in the case of straight thigh).  Poppy’s typical walking gait  takes a period of one second so the mono-pedal stance phase lasts around 420 min~\parencite{lapeyre2013poppy}. Considering that the robot remains stationary during more time than the single stance phase, we can imagine that the lateral balance control will be reduced during the walking gait.

\subsubsection{Double support CoG transfer} % (fold)
\label{sub:cog_motion}

In this experiment, we evaluate the lateral movement of the robot necessary to cause a displacement of its center of gravity from one foot to the other and we verify the theoretical results obtained previously. For this, Poppy is placed on a force platform to measure the displacement of its center of pressure. The absolute movements of the robot are tracked with an OptiTrack device and markers placed at the head and lower back (approximately the position of the actual center of gravity). The robot is kept rigid in a neutral position and a human physically pushed it from left to right until it reached its lateral falling limit. As this operation is not very accurate, the experiment is repeated one hundred times.

\begin{table}[ht]
\centering
\begin{tabular}{|l|c|c|c|}
  \hline &      Straight tigh &                     Bended Tigh &                   diff(\%) \\
  \hline CoP & 74.6 {\scriptsize$\pm$9.0} mm &     49.8 {\scriptsize$\pm$7.7} mm & 33\\
  Head & 100.1{\scriptsize$\pm$14.4} mm&     62.9{\scriptsize$\pm$22.0} mm &  37\\
  Lower Back & 64.1{\scriptsize$\pm$11.5} mm&      43.4{\scriptsize$\pm$15.0} mm &  32 \\
  \hline
\end{tabular}
\caption{Summary of the results obtained during the experiment on the lateral motion needed to transfer the robot’s mass from one foot to the other.}
\label{tab:CoG_motion}
\end{table}

Table~\ref{tab:CoG_motion} presents for each area considered (i.e. center of pressure (under feet), lower back and head motion) the amplitude of the lateral motion (in millimeters) needed to translate the CoG of the robot from one foot to the other for the two versions of Poppy’s thigh design. The last columns summarize the relative difference between the two conceptions (in percent). One can note that the results show a reduction of lateral movement of around 30\%. Thanks to the shape of the thigh, the lateral displacement of the upper body required to move the CoG from one foot to the other can be reduced.

The results presented on the two first experiments show improvement for two main aspects needed during bipedal locomotion: lateral stability and mass transfer. In the next experiment, we will evaluate if there is a significant performance gain in a complex dynamic phase such as bipedal walking.

\subsubsection{Walking dynamic} % (fold)
\label{sub:walking_dynamic}

As explained in the introduction and description of the platform, Poppy has been specially designed to study bipedal walking and human-robot interaction.

Here the experiment consists of playing an open-loop walking pattern while the robot is guided through the physical interaction with a human. The user’s role is to provide both balance and control of mass transfer. By producing small lateral motion on the upper-body, they can help the robot to move its CoG from one foot to another.

\begin{figure}[tb]
    \centering
    
    \caption{Proceeding of the walking experiment.
    Poppy is tracked by an Optitrack trio while it is walking on a treadmill set at 1.8km/h.
    An expert user provides the sagittal balance needed throughout the experiment.}
    \label{fig:walking_experiment}
\end{figure}

The gait is based on the actual human sagittal joint kinematic~\parencite{Nester2003}: hip, knee, ankle (see Fig.~\ref{fig:CPG}.a). A direct transposition of the human joint kinematic on the Poppy's morphology results in a walking speed which is too fast to be handled by users (see Fig.~\ref{fig:CPG}.b). A simple reduction of a joint’s amplitude leads to an unsuitable leg trajectory where toes bump into the ground during the swing phase (see Fig.~\ref{fig:CPG}.c). So to ensure enough clearance during the swing phase and suitable walking speed for the guidance with a user, we modified the trajectories of the joints by hand to both reduce the length step and increase the foot clearance (see Fig.~\ref{fig:CPG}.d). The actual gait on Poppy is shown in Fig.~\ref{fig:humanoids2013_cpg_on_poppy}.

\begin{figure}[tb]
    \centering
    
    \caption{Trajectories of toes generated by the walking pattern a) Kinematics of human walking
    with human morphology b) Direct transposition of human kinematics onto Poppy's morphology
    c) Reducing amplitude of the human kinematics joints with Poppy's morphology d) Walking pattern
    used for the experiment with Poppy}
    \label{fig:CPG}
\end{figure}

\begin{figure}[tb]
    \centering
    
    \caption{Walking gait CPG described on Fig.~\ref{fig:CPG}.d applied on the actual Poppy robot.
    The CPG generates a human-like walking gait allowing the robot to walk at 1.8km/h and involves straight legs during the stance phase.
    There is no balance control, but stability is obtained through physical guidance with a trained expert user.}
    \label{fig:humanoids2013_cpg_on_poppy}
\end{figure}

In this experiment, we are interested in the dynamic of Poppy especially on the frontal plane and we will compare the effect of the thigh shape on this dynamic. Poppy walks on a treadmill following the walking gait described above. An expert user trained to keep the robot in the correct walking cycle provides guidance to the robot. This is done by keeping the robot in a vertical position and supporting, in a compliant manner, the lateral movement of the robot as illustrated in attached videos. The user is asked to do the best he can to minimize the movement/forces he applies in both morphologies to reduce the bias towards the two designs experimented. All proprioceptive sensors are recorded at 50hz while an Optitrack device associated  with markers located at the head and lower back measure the absolute displacements of the robot (see Fig.~\ref{fig:walking_experiment}).

Poppy’s movement is recorded for around 1800 walking gait cycles for each thigh design (around 90,000 data points for each case). Data are folded over to extract the gait behavior over a gait cycle. Results are presented in Fig.~\ref{fig:walk_result}. As previously, the blue color is assigned to experiments with bended thighs, the red color is assigned to straight thighs. For each case, the light color corresponds to the standard deviation and the dark color to the 95\% confidence interval of the mean value.

\begin{figure}[p]
    \subfloat[][Lateral head displacement]{\label{fig:head_position}}
    \hfil
    \subfloat[][Lateral lower back displacement]{\label{fig:low_back_position}}
    \hfil
    \subfloat[][Sagittal head acceleration]{\label{fig:head_acceleration_x}}
    \hfil
    \subfloat[][Lateral head acceleration]{\label{fig:head_acceleration_y}}
    \hfil
    \subfloat[][Speed of rotation in the frontal plane]{\label{fig:head_gyro_x}}
    \hfil
    \subfloat[][Head inclinaison]{\label{fig:head_tilt_x}}
    \caption{Results obtained during the walking experiment.
    The blue color is associated with experiments conducted with bended thighs while the red color is assigned to straight thighs.
    For each case, the light color corresponds to the standard deviation and the dark color to the 95\% confidence interval of the mean value.
    All data are folded over to extract the mean gait behavior and its standard deviation over a walking gait cycle expressed in percent.}
    \label{fig:walk_result}
\end{figure}

The two first figures (i.e. ~\ref{fig:head_position} and ~\ref{fig:low_back_position}) show the lateral motion of the upper body in millimeters over the gait cycle. We notice that for the two designs, the motion pattern shown by the upper body (head and lower back) is similar. However, in the case of the bended thigh (blue) the amplitude of the motion is reduced by about 45\%. Another interesting effect concerns the head perturbations shown on figures ~\ref{fig:head_acceleration_x}, and ~\ref{fig:head_acceleration_y}. Here also, patterns are similar but in the case of the bended thigh the head is clearly less perturbed by the walking dynamic, with a reduction in amplitude of approximately 30\%. Five pictures were taken while Poppy was walking and were stacked in Fig.~\ref{fig:poppy_walking_compared}. This shows a qualitative point of view of the walking dynamic for both studied cases.
We notice that the lateral motion of the version of Poppy with bended thighs~\ref{fig:poppy_walking_bended} is small compared to the version with straight thighs~\ref{fig:poppy_walking_straight}.

\begin{figure}[ht]
\centering
    \subfloat[][bended thigh]{\label{fig:poppy_walking_bended}}
    \hfil
    \subfloat[][straight thigh]{\label{fig:poppy_walking_straight}}
    \caption{Five pictures have been taken while Poppy was walking and were stacked to obtain a qualitative view of the difference in the walking behavior in relation to the morphology of the thigh.}
    \label{fig:poppy_walking_compared}
\end{figure}

\subsection{Conclusion on the thigh shape role for bipedal locomotion} % (fold)
We focus on the shape of the Poppy thigh and its effect on the robot’s dynamic. We studied the role of morphology in the reduction and simplification of the control needed to perform a complex task such as bipedal walking. We have presented the simple theoretical model we used for the design of Poppy’s thigh based on the inverse pendulum dynamic. We have conducted experiments to evaluate the improvements of the bended thigh on the real robot dynamic and compared it to the model. Since Poppy’s structural design allows easy, cheap and fast morphological modifications, we were able to try another thigh design. We also used a pair of straight thighs which is a more classical approach in humanoid conception. The experimental comparison between the two thighs design confirmed the theoretical results, the bio-inspired thigh design improves Poppy’s dynamic in two main ways useful for bipedal walking:
\begin{itemize}
    \item It reduces the falling velocity by almost 60\% when the robot is on one foot (single support phase).
    \item It reduces the lateral motion needed to transfer the mass of the robot from one foot to the other (double support phase) by 30\%.
\end{itemize}
It is really interesting to note that such a small modification of the robot morphology has a very significant impact on the robot’s behaviour.

These results are interesting, but they do not reflect the Poppy’s real walking dynamic. To evaluate the effect of the bended thigh on bipedal locomotion, we conducted a third experiment where Poppy is walking on a treadmill. In this experiment, we show that the bended thigh has an effect on a complex dynamic task such as the biped locomotion: it reduces the motion amplitude on the upper body  by 45\% and increases the head stability by 30\%. We choose these metrics due to our experimental constraints (fixed speed, social guidance) as a qualitative evaluation of the walking gait. Moreover, it provides us with an intuitive, yet incomplete evaluation of the walking. Many other measures could have been chosen or combined such as speed, energy consumption or robustness to external perturbations. It is still complicated to understand which metric is the most adapted for robotic biped locomotion. As human beings are trained to recognize a bipedal gait, users can provide guidance to the robot for both safety of exploration and evaluation of the walking behaviour.

% subsection Results (end)
