matthieu-lapeyre/phd_thesis/latex/content/chapter/poppy.tex

% !TEX root = ../../thesis.tex

\cleartoleftpage
\includepdf{../media/chapter_illustration/papaver_rhoeas}
\chapter{The development of Poppy} % (fold)
\label{cha:poppy-dev}

\section{Introduction} % (fold)

\begin{figure}[tb]
\centering
    \subfloat[][Nao]{\label{fig:nao_platform}}
    \hfil
    \subfloat[][Darwin-Op]{\label{fig:darwin_platform}}
    \hfil
    \subfloat[][Acroban]{\label{fig:acroban_platform}}
    \caption{None of the existing platforms in 2012 was suitable for exploring the role of morphology. Nao was impossible to modify. Darwin Op and Acroban used aluminium parts that are really difficult and expensive to produce.}
    \label{fig:2012_Humanoids}
\end{figure}

In 2012, when we started this project, none of the existing humanoid platforms was suitable for exploring the role of morphology. There were two kinds of platforms. On one hand commercial robots that are rather easy to use and accessible but with a static and frozen morphology. On the other hand, prototype robots produced in labs to address specific experimentation needs, studying interesting morphologies but complicated to use and impossible to reproduce outside the lab. In both cases, only a few are open source, limiting hacks, extensions or modifications of their morphologies even further.

In the Flowers Lab, we had both kinds of robots. We used Nao (see \figurename~\ref{fig:nao_platform}) to study human-robot interaction (\cite{rouanet2009integrated} \cite{rouanet2012apprendre}). It was really convenient for use by researchers who are not interested in hardware issue since they are addressing more high-level research challenges. Yet such a platform is limited as it is not possible to modify the robot if it is not strictly adapted to our experiment. For example, back at this time the Nao camera was not efficient, with a closed field of view and a slow frame rate. We have difficulty achieved 5 frames/seconds. Although we had the necessary skills to hack Nao and change the camera to fit our needs, its hardware was not designed to be changed. Improving the vision performance would only be possible with the addition of an external camera on the Nao head which could ruin the user experience. In addition, it would have been interesting to explore how the camera parameters (FOV, framerate, resolution...) can change the user experience but again, it is not possible with this robot.

We also used Acroban (see \figurename~\ref{fig:acroban_platform}) designed by Olivier Ly~\parencite{ly2011bio}. It is a handcrafted humanoid platform created to explore certain morphological properties, especially compliance, with the aim of achieving dynamic locomotion and playful physical human-robot interaction.
While it actually allows modification of its is morphology, it is manufactured from aluminium mechanical parts, Robotis Dynamixel motors, scotch, and rubber bands cobbled together, and changing it requires a lot of efforts. The manufacture of aluminium parts required is especially complicated and requires either very good handiwork or a 3-axis CNC.
In addition, its use was quite complicated and while several researchers could have been interested in Acroban to study human-robot interaction and social acceptance, It was not possible to use it without significant mechanical work.
Finally, the material and manufacturing process make the platform non-stationary. Even if a lab manages to reproduce it, there is a high probability that the physical properties will not be the same. Therefore, the diffusion and the reproducibility of results are limited.

A last alternative would be the use of Darwin Op robot (see \figurename~\ref{fig:darwin_platform}) which is both open source and easily accessible (Robotis sells it already assembled for \$10K), yet as Acroban its hardware consists of manufactured metal parts making its morphology very difficult and expensive to modify. Moreover, even if Darwin is open source and very popular, to our knowledge its morphology has never be modified by the research community\footnote{We can also notice the lack of community management tools such as wiki, forum and correct versioning system. If someone create a variation of Darwin, there is no place where he can share it.}.

Thus one of the main goals was to successfully design a humanoid robot which can merge the advantages of both kind of robot, i.e. simple, accessible, reproducible and allowing to easily change and hack its morphology for scientific experiments that can be both customized and shared.

\subsection{An experiment-proof robot} % (fold)
\label{sec:experiment-proof}

Most researchers can attest to the difficulty and frustration faced while conducting robotic experimentation in the real world. We are challenged daily by bugs, technical issues, unpredicted events and side effects. While a bug in software can be fixed, an error with a hardware platform can cause damage to the robot and postpone the results of an experiment by several weeks.

Therefore, many researchers in robotics avoid technical issues associated with the real world experimentation by using simple models and physical simulation. But the real world is extremely more complex and richer than the virtual one.
Some high-level behaviour experiments are conducted in simulators based on the hypothesis that real-world constraints are not relevant, yet it is really certain?
Indeed, while the real world constitutes a lot of constraints, it is also rich in complex physical effects (gravity, friction, inertia), which should be taken into consideration and could be very useful if interacting with the agent.

As we saw in the related work (chapter~\ref{cha:morphology-review}), the emergence of complex behaviours appears thanks to the interaction between the real world and simple robotic systems. We cannot program behaviour because behaviour is the result of interaction  between the program and the real world. Thus, we cannot design behaviour without the ecological niche of the robot~\cite{Steels1991emergence}.

While using simulators can be helpful as a first step to design robots, it appears incomplete when showing results on the role of morphology without real world experimentation.
Therefore, when one wants to study the role of morphology on robot behavior, being able to explore it in the real world is of paramount importance. Unfortunately, current tools make the experimental step really hard to achieve for researchers.

Throughout our work on building cognitive and developmental learning algorithms~(\cite{Oudeyer07},\cite{moulin2013exploration}), we have experienced these issues, especially while building and using Acroban~\cite{ly2011bio} and during the Ergo robot experience (see chapter~\ref{cha:art}). Much time has been spent debugging non-robust technologies, but it has been very instructive for understanding those that are efficient and those that should be avoided.
Therefore, Poppy has been designed based on the background experience we have acquired building using robots acting in the real world.

\begin{description}
    \item[Robustness and Safety:] Demanding and lengthy real-world experimentation necessitates that the robot be robust and safe. It should be able to sustain experiments and fall down without easily breaking. At the same time, one should ensure that physical interaction with the robot is safe for humans.
    \item [Precision, stationary:]Experiments should be repeatable, implying that the robot properties should be stationary.
    \item [Breakable, repairable:] Breaking should not be costly and the robot should be easily repairable.
    \item [Transportable:] To allow for experiments in natural environments, possibly involving interaction with non-technical humans, the robot should be transportable outside the laboratory.
    \item [Easy and fast to duplicate:]If the robotic platform is to be reused  in this way, it must be easy and fast to duplicate.
    \item [Affordable:] To ensure widespread use, a key factor is to keep the cost of the platform relatively low. The more labs can be involved, the greater the scientific impact.
\end{description}

To respond to these needs we created Poppy (see \figurename~\ref{fig:poppyv0.1_overview}).

\subsection{Overview} % (fold)

Poppy is a small and lightweight 25-DoFs humanoid robot (see section~\ref{sec:poppy-modularity}), whose morphological design allows for quick and simple modification by non-expert people. This is achieved thanks to the use of the 3D printing technique for the mechanical structure and Arduino based electronics architecture (see section~\ref{sec:poppy-electronic}). Its motors are common and widely used off-the-shelf Robotis actuators, and allow for compliant control and soft physical human-robot interaction. The pypot library (see chapter~\ref{cha:pypot}) enables programming beginners as well as advanced roboticists to control the robot and is adapted to the modularity of Poppy’s hardware.

\begin{figure}[tb]
    \begin{center}
        
    \end{center}
    \caption{Overview of Poppy beta with the main specs and features. This figure will be updated when the final release of Poppy is ready.}
    \label{fig:poppyv0.1_overview}
\end{figure}

Its current morphology takes inspiration from the human functional morphology: a large number of joints (25 motors), the limbs respect human proportions, it has five joints in the torso and its thighs are bended by a $6\deg$ angle, similar to human ones (see section~\ref{sub:poppy-leg-design}).

All the work and material involved in building, creating and using Poppy is distributed under open source and open hardware licenses. The 3D-printed skeleton and the electronics boards are under Creative Commons licenses while the pypot library is distributed under GPLv3 licenses.

Poppy is the first open source and 3D-printed complete humanoid robot, the design of such a novel platform will be discussed in the following sections.

\section{Exploring morphological variants} % (fold)
\label{sec:poppy-modularity}

The whole structure must be easily reconfigurable both for the purposes of repairing and hacking. This means the process of replacing Poppy's parts must be simple, low-cost and not require time or special tooling. Also, in order to have a real impact in the open hardware community, special attention is given to the modularity and the reusability of our technological bricks.
Poppy is fully modular (mechanic, electronic, software) allowing freely exploration and modification of Poppy's body.
Its modularity and the use of 3D printing make Poppy highly hackable. Therefore, it can be easily adapted to particular experimental setups and allows diverse exploration into its morphology.

\subsection{3D printed parts} % (fold)

We introduced for the first time the use of 3D-printed mechanical parts in our work when we built the ergo-robot installation (August 2011 - see chapter~\ref{cha:art}). The result was impressive as the parts were robust, precise, low-cost and fast to produce. Very convinced by this technology and with a keen desire to be free to explore robot morphology, we decided to build the whole mechanical structure of Poppy based on 3D printing techniques.

\subsubsection{Technique used} % (fold)

Several 3D techniques exist and were presented in the related work (see chapter~\ref{cha:3Dprint-OSH}). The Stereo-Lithography\footnote{This technique relies on a photosensitive monomer resin, which forms a polymer and solidifies when exposed to ultraviolet (UV) light.} (SLA) is very precise yet the material is not well adapted to support mechanical stresses.

Alternatively, we can use Fused Deposition Modelling\footnote{The FDM technique relies on melting and selectively depositing a thin filament of thermoplastic polymer (ABS - PLA) in a cross-hatching fashion to form each layer of the part.} (FDM), which has the great advantage of being very low cost (2000\$ for the printer + 40\$/kg of material) and therefore, accessible directly in the lab. The parts produced are good yet the finish is not perfect and often needs to be reworked by hand. Also, the process creates non-uniform parts, less resistant on one axis. Above all the FDM printers have low reliability, leading to a large number of printing failures. Nevertheless, low-cost FDM printers are really useful when we just want to produce initial or single-use parts.

We preferred the use of Selective Laser Sintering (SLS)\footnote{The process uses a high power (25-50W) CO2 laser beam, which melts and fuses finely powdered material spread on a layer.}. This 3D printing process allows the production of almost any shape without constraint. In addition, the price of the part depends on the total size and not on the complexity of the shape. This permits the production of very optimized shapes without increasing the total price of the robot. Moreover, the use of polyamide material produces high-quality parts with very good mechanical properties: uniform, lightweight, flexible and robust.

The table~\ref{tab:materials} compares mechanical properties of polyamide with classic metallic materials. We can see the relatively good properties of the polyamide material. The young modulus represents the stiffness of the part. The polyamide one has a very low young modulus meaning it is very flexible while keeping correct yield strength and very low density.

\begin{table}[tb]
    \centering
    \begin{tabularx}{0.8\linewidth }{l X X X}
        \textbf{Material} & \textbf{Mass Density $\rho$ ($kg/m^3$)} &  \textbf{Yield strength $\sigma$~($MPa$)} & \textbf{Young Modulus $E$($GPa$)}\\
        % \hline
        Polyamide & $930$ & $49$ & $1.65$\\

        Aluminum & $2700$ & $200$ & $70$\\

        Steel & $7500-8000$ & $350$ & $200$\\

        Titanium & $4500$ & $1200$ & $114$\\

    \end{tabularx}

    \caption{Comparison of material properties.
    The Young modulus represents the stiffness of the material while the yield strength corresponds to the maximal stress tolerable before plastic deformation.}
    \label{tab:materials}
\end{table}

An SLS printer is much too costly for a lab, but outsourcing the production to an external company\footnote{\url{http://i.materialise.com/}} is real easy\footnote{In most cases, the company offers automatic scalable orders through an on-line platform} and relatively low cost\footnote{Printing all the parts to build a Poppy costs about 1200\texteuro HT.}

\subsection{Exploring morphological variants} % (fold)

3D printing is a key feature of Poppy that permits the exploration of morphological variants. Indeed, it is now cheap and easy to produce custom parts, and because Poppy is open source, anyone has access to the source files and can freely change the parameters he or she wants. Indeed, Poppy is designed using Solidworks, a parametric CAD Software very widespread in small-size engineering companies. The parametric modeling allows to create mechanical parts those design are based on a set of parametric sketches and functions. Parameters can be modified and the final part will be changed accordingly\footnote{If designed correctly}. Therefore, it is possible to easily change the mechanical structure and properties just by tuning associated parameters in the source file and re-printing the part (see \figurename~\ref{fig:exploring-morpho-poppy}).

\begin{figure}[p]
    \centering
        
    \caption{The use of 3D printing open new perspectives to explore the role of morphology in the robotics field. Indeed, we can now easily produce on-site new mechanical parts, therefore it is possible to create numerous variations of body properties. Poppy's modularity makes the part substitution easy and fast so we can directly iterate with real world experiments. Then we can share online a reproducible experimental setup.}
    \label{fig:exploring-morpho-poppy}
\end{figure}

Moreover, 3D printing does not only permit the shape of a part to be changed, it can actually produce it with different materials. In particular, Direct Metal Laser Sintering (DMLS) - very similar to the SLS process - permits to produce the same parts using materials such as steel\footnote{http://i.materialise.com/materials/stainless-steel} or titanium\footnote{\url{http://i.materialise.com/materials/titanium}}. It is, therefore, possible to extend the exploration to material mechanical properties (e.g. flexibility, density).

\subsection{Scalable actuation} % (fold)
\label{sub:scalable-actuation}
As explained in chapter~\ref{cha:methodology}, the chosen methodology relies on the all-in-one Robotis actuator. They are really convenient to use as they directly embed drivers, encoders and communication buses. They are also quite powerful, robust and rather precise. This is done by the combination of Maxon motors, metal gearbox and precise magnetic rotation sensor (resolution: 0.1\textsuperscript{o}).

Also, Robotis offers a range of motors with different actuation power (see \figurename~\ref{fig:dynamixel_powa}). They are different in size and power but their API remains the same and we can easily switch from one to another without either changing the code or the electronic integration. Yet, even if the size changes, the footprint keeps the same pattern (see \figurename~\ref{fig:dynamixel_dimension}).

Poppy is designed with Solidworks, a parametric modeler that offers features like configurations which define sets of parameters. Configurations allow to create multiple variations of a part or assembly model within a single document. Configurations provide a convenient way to develop and manage families of models with different dimensions, components, or other parameters. It is, therefore, possible to create, for each part, a configuration compatible with each motor just by setting the suitable parameters. The \figurename~\ref{fig:leg_configuration} shows an example with Poppy's leg.

\begin{figure}[p]
    \centering
        
    \caption{Example of the use of mechanical configuration. Here the CAD source of the leg involves 2 configurations so it can be compatible with Dynamixel MX-28 (up) or Dynamixel MX-64 (down). Configuration defines the set of parameter suitable for both and can be changed just in one mouse click.}
    \label{fig:leg_configuration}
\end{figure}

It just takes a couple of minutes to transform a part designed for Dynamixel MX-28 to one compatible with Dynamixel MX-64 as we only have to change the parametric dimensions accordingly to the Robotis motor shape. Then it is possible to switch from one to another with one click.
On Poppy, most of the parts are already distributed with multiple configurations suitable for different motors power. It allows the actuation power to be scaled and introduces it also as an experimental (discrete) variable.

\subsection{Electronic} % (fold)

Unlike the mechanical parts, there is no quick and low-cost solution for producing custom electronics yet.
However, exploring morphology may also require the sensors space (e.g. number, type, properties, positions) to be varied. As we explained in the chapter~\ref{cha:morphology-review}, we address this challenge through the use of the Arduino environment.

Arduino has developed both hardware and software, so creating and programming electronics systems becomes very easy. Their boards have plenty of I/O pins (digital and analog) suitable to power and control almost any electronics components. Also, these pins can be used to handle low-level communication such as UART, SPI and I2C, useful to plug sub-module (e.g. IMU, LCD Matrix, tactile interface and so on).
The software they developed abstracts the complexity of low level control\footnote{we can turn a led on/off with just one line of code.} and communication\footnote{Using just print-like functions we can communicate on serial bus.} very well. Therefore, it allows wide variety and flexibility in the extension of the electronic system while keeping an ease of use adapted to a non-expert audience.
In addition, Arduino has a growing community - already relatively large - which creates, shares and produces low-cost, various and multipurpose electronic components. Actually almost all kinds of sensors have an Arduino version with ready-to-use hardware and software.

Being able to change the morphology easily is of paramount importance in the Poppy project. Using Arduino-compatible architecture permits electronic modularity, which means the sensory-motor space can be considered as an experimental variable.

\section{Lightweight} % (fold)
\label{sec:lightweight-robot}

Many humanoid robots use powerful motors often associated with highly accurate sensors. This has a cost, both in terms of weight and computation resources. Moreover, to ensure the accuracy of the sensory-motor space it is necessary to design very rigid mechanical parts. The whole structure obtained is powerful but very heavy and not very agile due to inertia.
In the Poppy platform, lightness is very important both for dynamic properties and safety:
\begin{itemize}
    \item for a given actuation power, reducing the link mass reduces its inertia and permits the agility and the responsiveness to be increased,
    \item makes Poppy a platform that is easier to manipulate and transport outside the lab,
    \item makes the robot safer for people as well as for itself when it falls (and it will definitely fall a number of times).
\end{itemize}

\begin{figure}[!t]
    \centering
        
    \caption{Using small actuation power reduces the amount of stress applied on the mechanical structure. Thus, it is possible to reduce the robustness of mechanical parts by removing the matter. Because the global weight is reduced, we can use smaller actuation power, and so on.}
    \label{fig:virtuous_circle}
\end{figure}

The lightness was achieved by combining low-power actuation and optimized structure. Indeed when combined, it creates a kind of virtuous circle where the reduction of the maximum torque reduces the strength on mechanical parts. Because less force intensity is applied, we can remove material from parts. Because we have a lighter mechanical structure we can reduce the actuation power required and so on.

Also using low-power actuation has several interesting advantages:

\begin{itemize}
    \item The actuation being the main cost of the robot (>60\%), using the least powerful motors significantly reduces the total cost of the robot.
    \item Low-power actuators mean a safer robot. Indeed, in the case of a programming error, the robot is not powerful enough to hurt someone or itself.
    \item on a research challenge level, it constrains the possible movements to the ones requiring little strength, the result being certainly more human-like.
\end{itemize}

Therefore Poppy was designed using the weakest and lightest motors i.e. MX-28\footnote{Robotis motors are quite heavy (72, 126 and 153g respectively for MX-28, MX-64 and MX-106) in comparison of the Futaba servo-motors, 20-50g for a comparable output torque see \url{http://www.futaba-rc.com/servos/brushless.html}}, except for a few particular joints (such as the hips) while the mass reduction of the mechanical parts was achieved by using truss design.

Truss is a well-known design technique from structural mechanics to create lightweight yet very robust structures. It is mainly used in civil engineering (see \figurename~\ref{fig:truss_bridges}) but can also be used in planes, which require lightness and strength resistance.

\begin{figure}[tb]
    \begin{center}
        
    \end{center}
    \caption{The truss structure has been massively used in civil engineering, especially to construct bridges. Here is shown several truss structure configurations.}
    \label{fig:truss_bridges}
\end{figure}

The principle is based on beam theory and permits to increase the second moment of area of a beam cross-section (see \figurename~\ref{fig:leg_section}), which is an important property in the calculation of deflection, the main weakness of a long beam.

The second moment of area is computed as follow:
\begin{center}
    $I_x = \iint_s y^2 dxdy$

    $I_y = \iint_s x^2 dxdy$
\end{center}
where $s = dxdy$ is the surface integrated along the two axes of the cross-sectioned surface. We can see the  on each dimension varies with a quadratic factor meaning the variation is not linear. Therefore, matter placed far away from the origin is much more effective in increasing the second moment of area.
Thus, the main idea is to remove -the no effective- matter at the center and place it on the rim. In truss structure, the matter is assembled by linkage avoiding local deformation.

\begin{figure}[!ht]
\centering
    \subfloat{\label{fig:Poppy_leg_section}}
    \hfil
    \subfloat{\label{fig:basic_leg_section}}
    \caption{Comparison of poppy's leg section and a rectangular beam having the same second moment of area.}
    \label{fig:leg_section}
\end{figure}

The \figurename~\ref{fig:leg_section} shows the comparative cross section of two beams with the same second moment of area value. More precisely, the \figurename~\ref{fig:Poppy_leg_section} is a cross section of Poppy's leg while the figure \figurename~\ref{fig:basic_leg_section} is a basic beam with a rectangular profile.
It would require a section such as $b=27.72 mm$ and $h=27.59 mm$ for the rectangular to have the same quadratic momentum as the truss design (i.e. $I_x = 54.862 mm^4$ and $I_y = 53.260 mm^4$ measured with Solidworks).
Considering the length of the leg part (i.e. $190 mm$), the total mass would be equal to $142 g$ instead of $47 g$ for the actual leg. This corresponds to a reduction of 70\% of the mass.

\begin{figure}[!tb]
\centering
    \subfloat[][Poppy's arm mechanical structure]{\label{fig:poppy_arm_truss}}
    \hfill
    \subfloat[][Poppy's leg mechanicalt structure]{\label{fig:poppy_leg_truss}}
    \caption{The whole design of Poppy is based on the use of truss structure to reduce its weight while keeping sufficient robustness.}
    \label{fig:poppy_truss_structure}
\end{figure}

All of Poppy’s limbs are based on this structure and have been optimized using finite element analysis (FEA) to perform structural simulation and validate the performance and safety factors of parts.
Thanks to the use of this design on all of Poppy's limbs (see \figurename~\ref{fig:poppy_truss_structure}), we managed to have -certainly- the most lightweight humanoid robot with 3.5kg relative to its 83 cm height.

\clearpage
\input{content/chapter/poppy-design-details.tex}
\input{content/chapter/poppy-electronic.tex}
\input{content/chapter/poppy-head-design.tex}

\section{Limitations} % (fold)

The design and the choices we made have raised several limitations:

\subsection{Simplicity} % (fold)
Creating a robot  for which one of the main objectives is to be easy to duplicate imposes strong constraints on the design. As we saw in chapter~\ref{cha:experimental-methods}, humanoid robots often have a complex design involving many components. Achieving such complexity is not possible if we want to keep the robot easy and quick to assemble by non-expert users. Therefore, Poppy's mechanics is simple, with only one part per motor. However, there are several joints whose performance could be improved by changing the design. For example, just by adding a complementary mechanism such as a reduction gear, we could increase the applied torque on a critical joint (e.g. knee, ankle, hip).

\subsection{No hands} % (fold)
The current version of Poppy does not have articulated hands. The grasping ability was not a top priority and is challenging, so we preferred to only design fixed hands. There are several laboratories working on this topic so we hope one of them will be interested in contributing to the Poppy project and design articulated hands. We have already been in contact with the Bristol Robotics Lab and the Open hand project for this purpose.

\subsection{Motor modularity} % (fold)
Parametric modelling is great if we want to create a variation of the same pattern with different dimensions. Thus, we can easily create configurations of all Robotis Dynamixel motors. Yet, if we are interested in using another motor brand, the configuration will not be direct and we will have to redo a part of the design process to ensure the compatibility.

\subsection{Electronic} % (fold)
\label{sub:electronic-limitations}

The electronics we developed are compatible with the exploration of morphology for sensory space because they have a lot of I/O ports to extend Poppy's sensorimotor space. Yet there are several limitations that make the final solution unsatisfactory.

Commonly used electronic components are not designed for robotic integration but rather for building small personal computers. Thus even if the electronic boards are often quite small, they have big common connectors such as USB, HDMI and Ethernet, which are of course never placed exactly where they should be for integration on the robot.
Above all, cables are really annoying; they take up a surprising amount of room (connector size, the wire length and they are heavy) while being totally useless for our applications.

Also the size of the IO Board is finally fairly big, more so than expected and while it is still compatible with Poppy’s design, it is too large, with a shape that is too strange to be appropriate for other open source projects.

Great open source projects keep their work modular so other projects can use one or several modules directly. Therefore the IO Board is not compatible with such principles and we are currently moving toward building modular Poppy electronics (we will discuss this new version in the discussion see section~\ref{sec:improve-hardware-modularity}). Yet this IO Board was the first electronic board developed in the Poppy project and through the experience we acquired a better understanding of electronic integration.

\section{Conclusion} % (fold)

Thanks to the methodology presented in the chapter~\ref{cha:methodology}, the design and production of a completely new humanoid robot has been very fast and low cost. Indeed, the project began at the end of May 2012 and the first fully-functional version of Poppy (the one we can see in \figurename~\ref{fig:TER_cognitic}) was presented at the end of September 2012 at Collège de France. The cumulative work of all the different people involved was equivalent to about 8 months and cost less than \texteuro10,000 in the material.

Because of the lack of easy and cheap tooling to produce a custom electronics board, the new design of the electronic architecture took more time and several elements are still in progress for.

\begin{figure}[tb]
    \begin{center}
        
    \end{center}
    \caption{Time lapse of the assembly is available here: \url{https://vimeo.com/96262428}}
    \label{fig:poppy_components}
\end{figure}

Yet Poppy cost about \texteuro8,000 and it only takes one or two days to assemble (see \figurename~\ref{fig:poppy_components}). Also its morphological design allows for modularity both for the mechanics, as the parametric parts can be easily customized and reprinted, and for the electronics thanks to the compatibility with the Arduino environment. This modularity is completed by the control library which will be presented in the next chapter.

Examples of variations in Poppy’s morphology will be presented in chapter~\ref{cha:changing_morphology}. Also thanks to its simple design, Poppy can be relevant for educational and artistic purposes. Applications will be presented in chapter~\ref{cha:education} and chapter~\ref{cha:art}.

% If we had to do it today we would make the same mistakes.

% In particular, even if we tried to remove most of the necessary cables, we saw it is still complicated to integrate. We really have to develop a board that does not require any wires at all.

% Actually, I spent more time looking for the fitting cable on the web than thinking about the electronics architecture. The wire-problem is often underestimated and, therefore, becomes one of the biggest problems for robotics. We experienced the same issue during the ergo-robot experiment and during the use of Poppy with artists (see chapter REF). So basically, the wire problem is one of the most overlooked issues…
