matthieu-lapeyre/phd_thesis/media/poppy/conception/IO_board.pdf

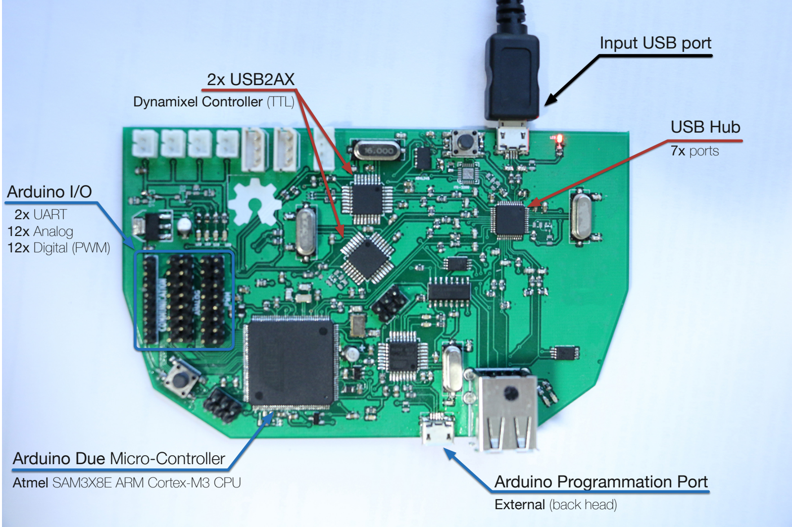
[picture p3: page 1]

### Arduino I/O

2x UART
12x Analog
12x Digital (PWM)

### Arduino Due Micro-Controller

Atmel SAM3X8E ARM Cortex-M3 CPU

### USB Hub

### 2x USB2AX

Dynamixel Controller (TTL)

7x ports

### Arduino Programmation Port

External (back head)

### Input USB port
