matthieu-lapeyre/phd_thesis/media/poppy/approach/conception_iterative.pdf

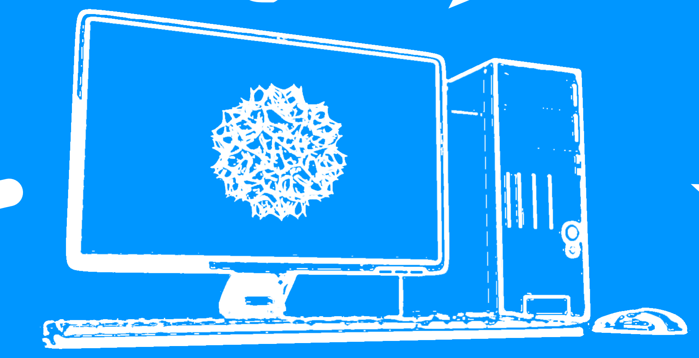
[picture p4: figure]
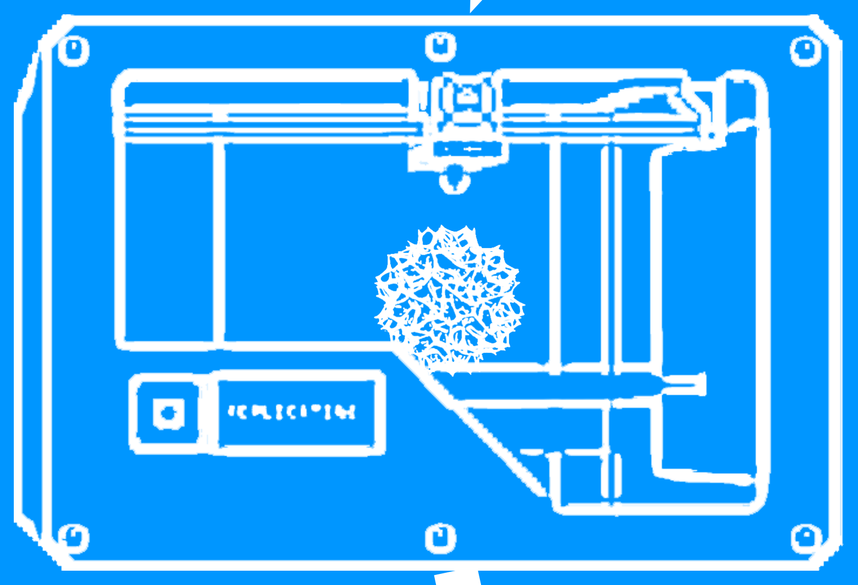
[picture p5: figure]

3D printing

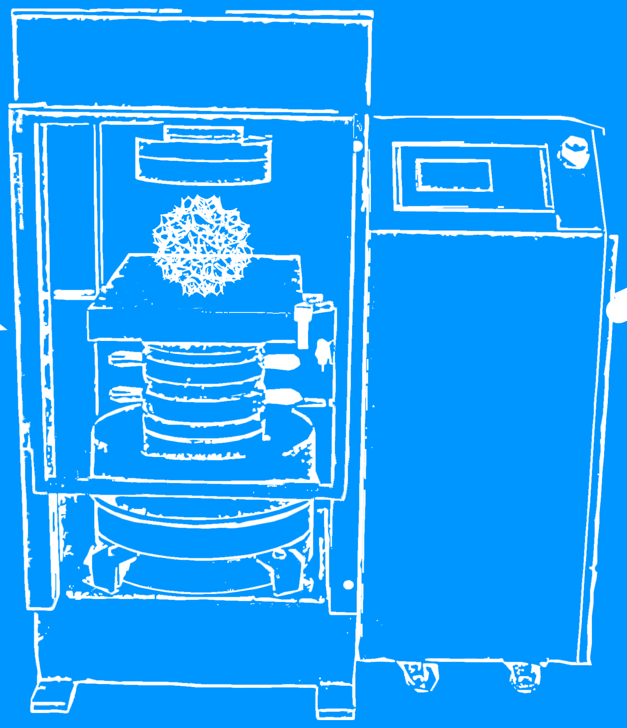
[picture p6: figure]

Experiences/Tests/Measures

CAD Design Initial Idea

## Fast design process:
