matthieu-lapeyre/phd_thesis/media/poppy/approach/arduino_electronique.pdf

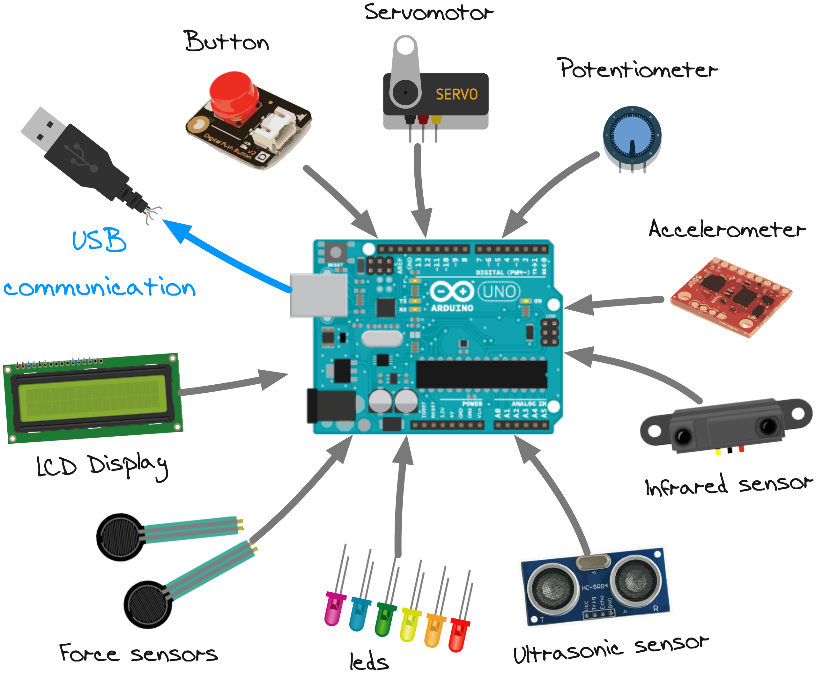
[picture p7: page 1]

Force sensors | leds | Ultrasonic sensor

LCD Display

Servomotor

Infrared sensor

Potentiometer

Button

Accelerometer USB
communication
