matthieu-lapeyre/phd_thesis/latex/thesis.tex

% **************************************************
% Document Class Definition
% **************************************************
\documentclass[%
    paper=A4,                   % paper size --> A4 is default in Germany
    twoside=true,               % onesite or twoside printing
    openright,                  % doublepage cleaning ends up right side
    parskip=full,               % spacing value / method for paragraphs
    chapterprefix=true,         % prefix for chapter marks
    11pt,                       % font size
    headings=normal,            % size of headings
    bibliography=totoc,         % include bib in toc
    listof=totoc,               % include listof entries in toc
    titlepage=on,               % own page for each title page
    captions=tableabove,        % display table captions above the float env
    draft=false,                % value for draft version
]{scrreprt}%
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
       {\printtext[bibhyperref]{% Include labelname in hyperlink
          \DeclareFieldAlias{bibhyperref}{default}% Prevent nested hyperlinks
          \usebibmacro{cite:label}%
          \setunit{\addspace}%
          \usebibmacro{cite:labelyear+extrayear}}%
          \usebibmacro{cite:reinit}}
       {\iffieldequals{namehash}{\cbx@lasthash}
          {\ifthenelse{\iffieldequals{labelyear}{\cbx@lastyear}\AND
                       \(\value{multicitecount}=0\OR\iffieldundef{postnote}\)}
             {\setunit{\addcomma}%
              \usebibmacro{cite:extrayear}}
             {\setunit{\compcitedelim}%
              \usebibmacro{cite:labelyear+extrayear}%
              \savefield{labelyear}{\cbx@lastyear}}}
          {\printtext[bibhyperref]{% Include labelname in hyperlink
             \DeclareFieldAlias{bibhyperref}{default}% Prevent nested hyperlinks
             \printnames{labelname}%
             \setunit{\nameyeardelim}%
             \usebibmacro{cite:labelyear+extrayear}}%
             \savefield{namehash}{\cbx@lasthash}%
             \savefield{labelyear}{\cbx@lastyear}}}}
    {\usebibmacro{cite:shorthand}%
     \usebibmacro{cite:reinit}}%
  \setunit{\multicitedelim}}

\renewbibmacro*{textcite}{% Based on textcite bib macro from authoryear-comp.cbx
  \iffieldequals{namehash}{\cbx@lasthash}
    {\iffieldundef{shorthand}
       {\ifthenelse{\iffieldequals{labelyear}{\cbx@lastyear}\AND
                    \(\value{multicitecount}=0\OR\iffieldundef{postnote}\)}
          {\setunit{\addcomma}%
           \usebibmacro{cite:extrayear}}
          {\setunit{\compcitedelim}%
           \usebibmacro{cite:labelyear+extrayear}%
           \savefield{labelyear}{\cbx@lastyear}}}
       {\setunit{\compcitedelim}%
        \usebibmacro{cite:shorthand}%
        \global\undef\cbx@lastyear}}
    {\ifnameundef{labelname}
       {\printtext[bibhyperref]{% Include labelname in hyperlink
          \DeclareFieldAlias{bibhyperref}{default}% Prevent nested hyperlinks
          \iffieldundef{shorthand}
            {\usebibmacro{cite:label}%
             \setunit{%
               \global\booltrue{cbx:parens}%
               \addspace\bibopenparen}%
             \ifnumequal{\value{citecount}}{1}
               {\usebibmacro{prenote}}
               {}%
             \usebibmacro{cite:labelyear+extrayear}}
            {\usebibmacro{cite:shorthand}}%
          \ifthenelse{\iffieldundef{postnote}\AND
                      \(\value{multicitetotal}=0\AND\value{citetotal}=1\)}
            {\bibcloseparen% Include closing parenthesis in hyperlink
             \global\boolfalse{cbx:parens}}
            {}}}
       {\printtext[bibhyperref]{% Include labelname in hyperlink
          \DeclareFieldAlias{bibhyperref}{default}% Prevent nested hyperlinks
          \printnames{labelname}%
          \setunit{%
            \global\booltrue{cbx:parens}%
            \addspace\bibopenparen}%
          \ifnumequal{\value{citecount}}{1}
            {\usebibmacro{prenote}}
            {}%
          \iffieldundef{shorthand}
            {\iffieldundef{labelyear}
               {\usebibmacro{cite:label}}
               {\usebibmacro{cite:labelyear+extrayear}}%
             \savefield{labelyear}{\cbx@lastyear}}
            {\usebibmacro{cite:shorthand}%
             \global\undef\cbx@lastyear}%
          \ifthenelse{\iffieldundef{postnote}\AND
                      \(\value{multicitetotal}=0\AND\value{citetotal}=1\)}
            {\bibcloseparen% Include closing parenthesis in hyperlink
             \global\boolfalse{cbx:parens}}
            {}}%
          \savefield{namehash}{\cbx@lasthash}}}%
  \setunit{%
    \ifbool{cbx:parens}
      {\bibcloseparen\global\boolfalse{cbx:parens}}
      {}%
    \multicitedelim}}

\makeatother

\DefineBibliographyStrings{english}{%
backrefpage={cited on p\adddot},
backrefpages={cited on pp\adddot}
}

% **************************************************
% Document CONTENT
% **************************************************
\begin{document}

% --------------------------
% rename document parts
% --------------------------
\renewcaptionname{english}{\figurename}{Fig.}
\renewcaptionname{english}{\tablename}{Tab.}
\newcommand{\equationname}{Equation}

% --------------------------
% Front matter
% --------------------------
%French Part
\pagenumbering{roman}           % roman page numbing (invisible for empty page style)
\pagestyle{empty}               % no header or footers
\input{content/titlepages_fr}      % INCLUDE: all titlepages
\cleartoleftpage 
\cleardoublepage
\input{content/french_abstract}    

%English part
\cleartoleftpage 
\cleardoublepage
\pagenumbering{roman}           % roman page numbing (invisible for empty page style)
\pagestyle{empty}               % no header or footers
\input{content/titlepages}      % INCLUDE: all titlepages
\cleartoleftpage 
\input{content/abstract}        % INCLUDE: the abstracts (english and german)
\cleartoleftpage              % display just page numbers
\input{content/acknowledgement} % INCLUDE: acknowledgement

\pagestyle{plain} 
\cleartoleftpage 
\cleardoublepage
\setcounter{tocdepth}{1}        % define depth of toc
\tableofcontents                % display table of contents
\cleardoublepage

% --------------------------
% Body matter
% --------------------------
\pagenumbering{arabic}          % arabic page numbering
\setcounter{page}{1}            % set page counter
\pagestyle{maincontentstyle}    % fancy header and footer

\input{content/chapter/introduction.tex} %OK
\cleartoleftpage
\part{Related Work}
\input{content/chapter/robot_morphology_review.tex} %OK
\input{content/chapter/experimental_review.tex}
\input{content/chapter/OP_RP_review.tex}

\cleartoleftpage
\part{The Poppy project} % (fold)
\input{content/chapter/approach.tex} %OK
\input{content/chapter/poppy.tex} %ok
\input{content/chapter/pypot.tex} %OK

\cleartoleftpage
\part{Applications} % (fold)
\input{content/chapter/morphology.tex} %OK
\input{content/chapter/education.tex} %OK
\input{content/chapter/art.tex} %OK

\cleartoleftpage
\part{Discussions} % (fold)
\input{content/chapter/diffusion.tex}
\input{content/chapter/conclusion.tex}

% % --------------------------
% % Back matter
% % --------------------------
\cleardoublepage
\begin{appendices}
% \part*{Appendix}
\input{content/appendix/thigh_theory_model.tex}
\input{content/appendix/knee_optimization.tex}
\input{content/appendix/foot_fsr_optimization.tex}
% \input{content/appendix/education_material.tex}
% \input{content/appendix/blueprint.tex}
% \input{content/appendix/electronics.tex}
\end{appendices}

\cleardoublepage

{%
\setstretch{1.1}
\renewcommand{\bibfont}{\normalfont\small}
\setlength{\biblabelsep}{0pt}
\setlength{\bibitemsep}{0.5\baselineskip plus 0.5\baselineskip}
\printbibliography[nottype=online]
}
\cleardoublepage

\listoffigures
\cleardoublepage

\listoftables

\newpage
\thispagestyle{empty}
\mbox{}

\cleardoublepage

\input{content/colophon}
\cleardoublepage

% \input{template/content/declaration}
% \clearpage
% \newpage
% \mbox{}

% **************************************************
% End of Document CONTENT
% **************************************************
\end{document}
