matthieu-lapeyre/phd_thesis/media/chapter_illustration/seymour-papert.pdf

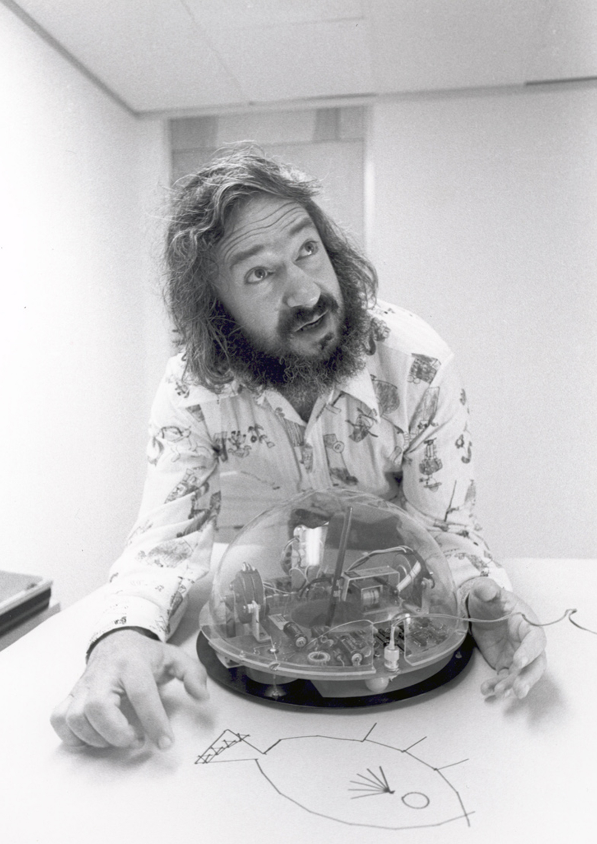
[picture p8: page 1]
