matthieu-lapeyre/phd_thesis/media/poppy/conception/knee_kinematic.pdf

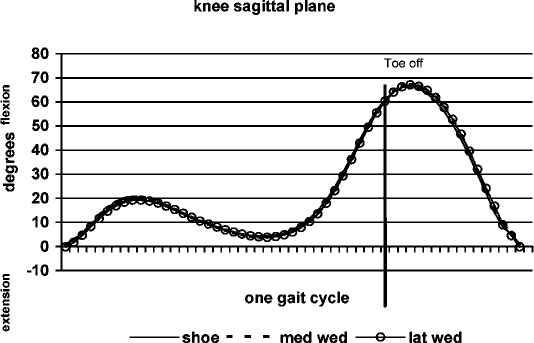
[picture p9: page 1]
