matthieu-lapeyre/phd_thesis/media/poppy/conception/leg_section.pdf

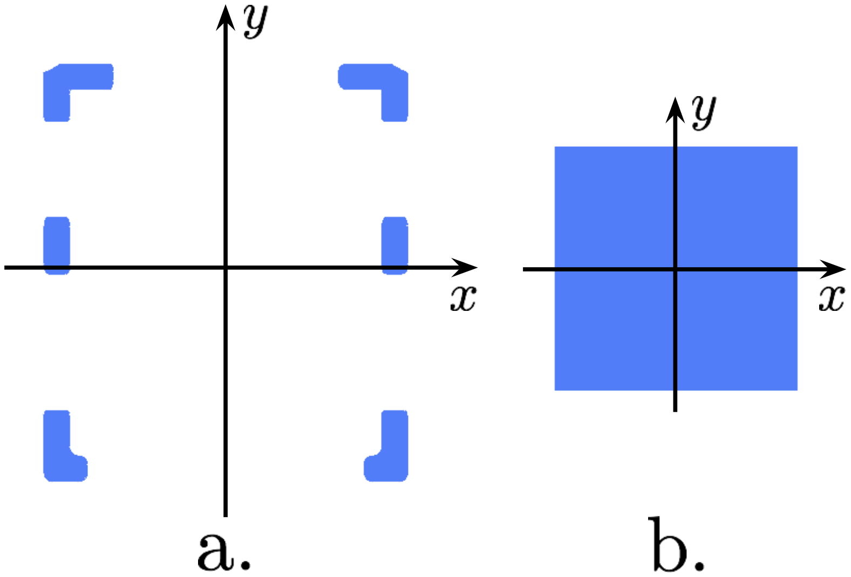
[picture p10: page 1]
