matthieu-lapeyre/phd_thesis/media/chapter_illustration/pypot.pdf

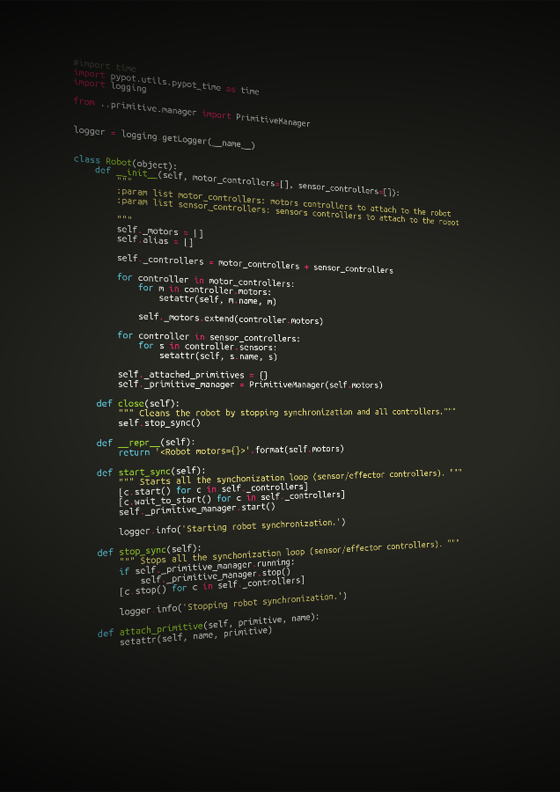
[picture p11: page 1]
