matthieu-lapeyre/phd_thesis/media/chapter_illustration/Nam_Jun_Paik.pdf

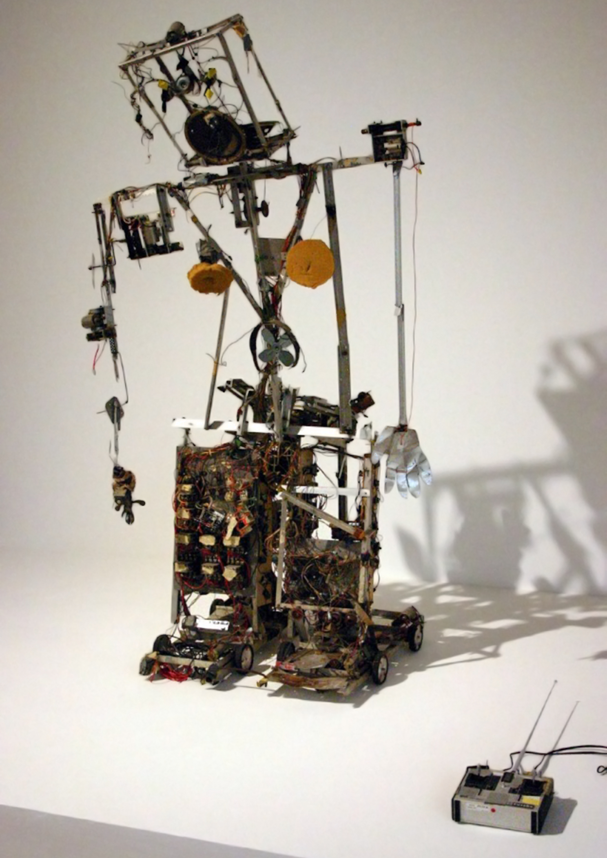
[picture p12: page 1]
