matthieu-lapeyre/phd_thesis/media/chapter_illustration/frankenstein.pdf

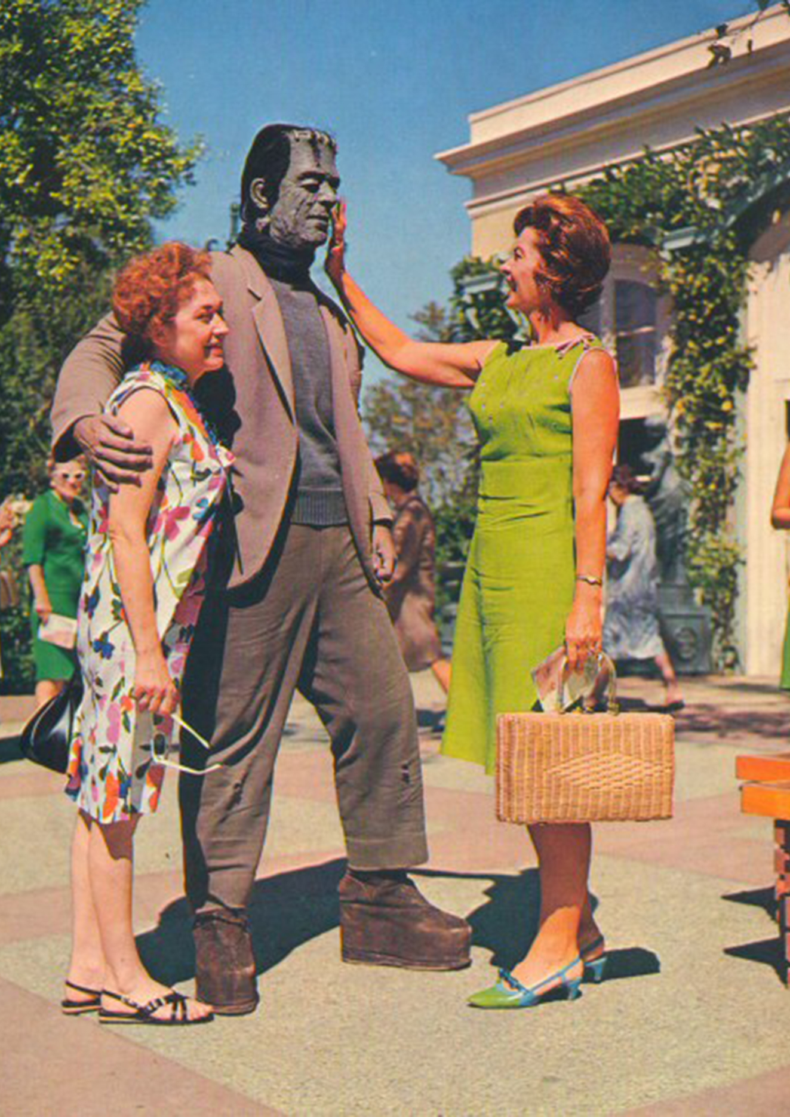
[picture p13: page 1]
