matthieu-lapeyre/phd_thesis/media/chapter_illustration/franki.pdf

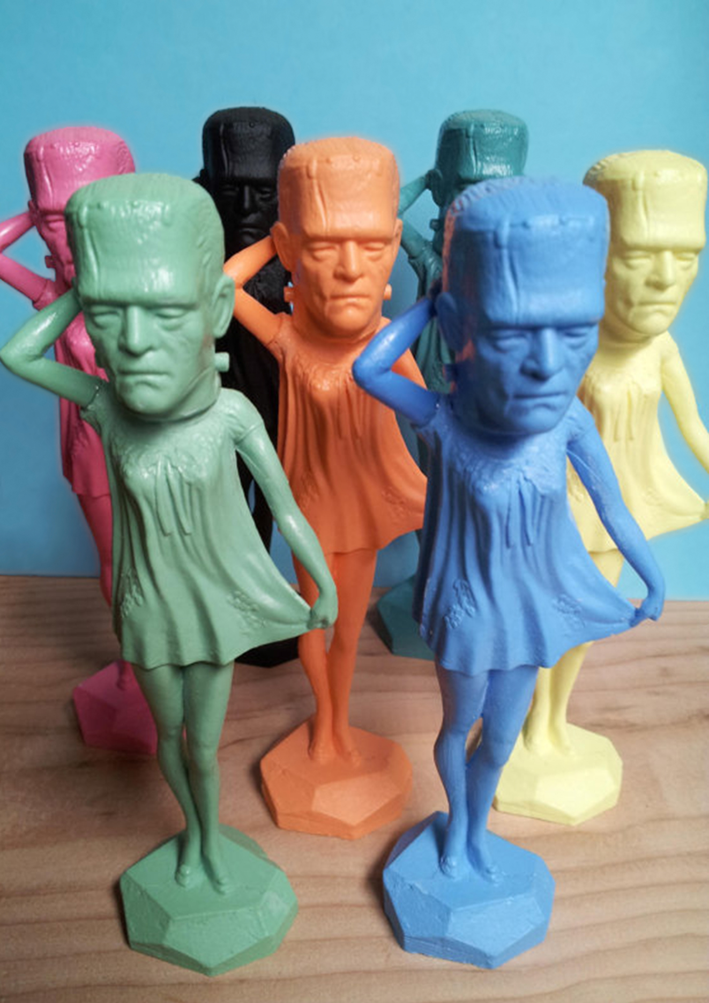
[picture p14: page 1]
