matthieu-lapeyre/phd_thesis/media/chapter_illustration/jansen.pdf

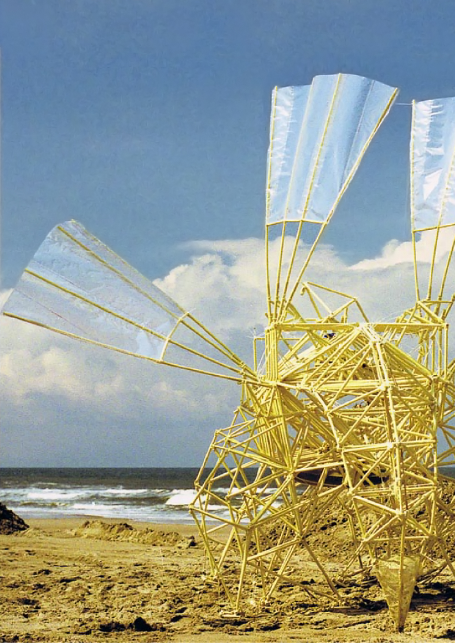
[picture p15: page 1]
