matthieu-lapeyre/phd_thesis/media/chapter_illustration/papaver_rhoeas.pdf

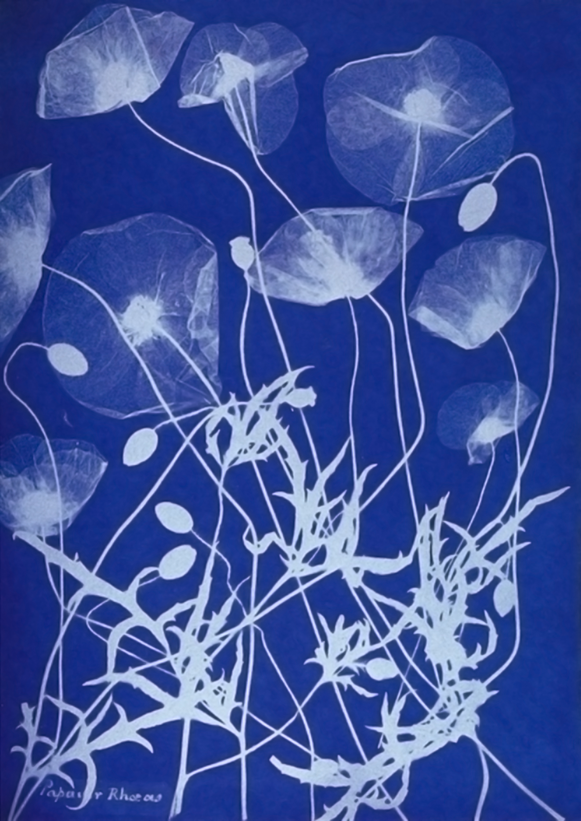
[picture p16: page 1]
