matthieu-lapeyre/phd_thesis/media/chapter_illustration/3DprintedBlender.pdf

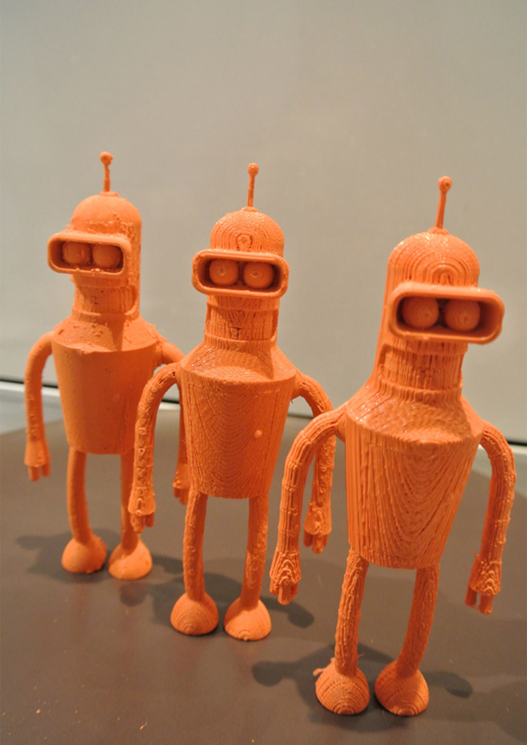
[picture p17: page 1]
