matthieu-lapeyre/phd_thesis/media/chapter_illustration/poppy_artist.pdf

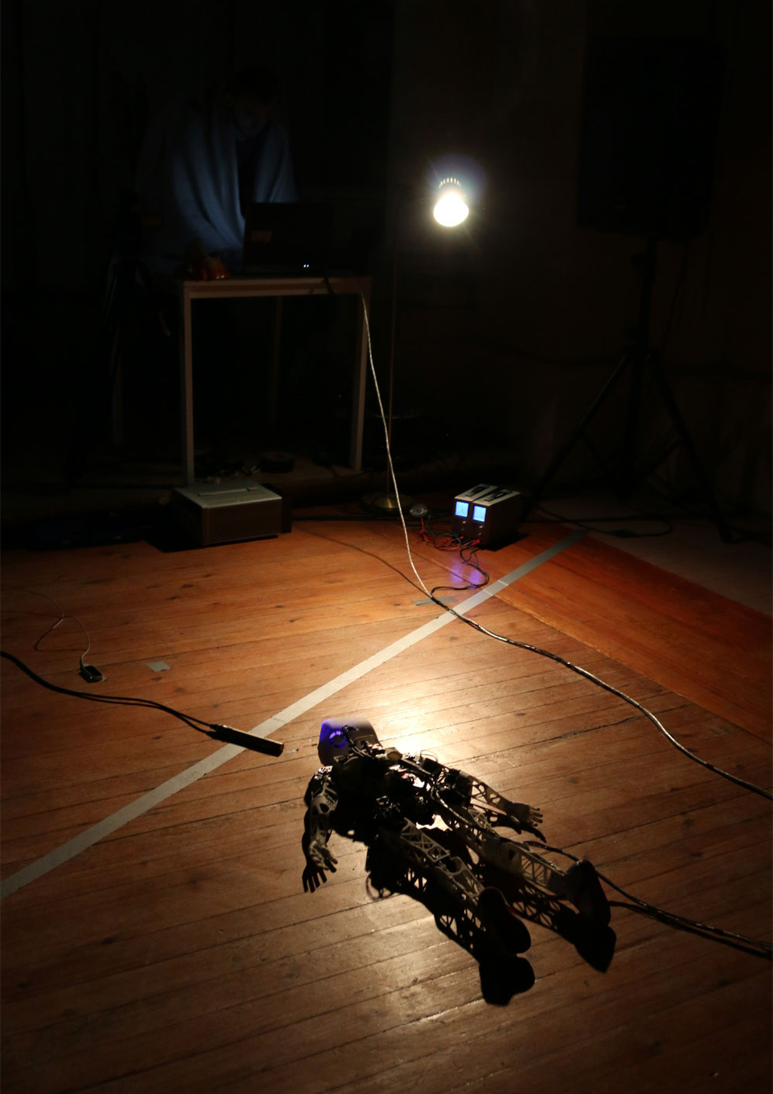
[picture p18: page 1]
