matthieu-lapeyre/phd_thesis/media/chapter_illustration/old_factory.pdf

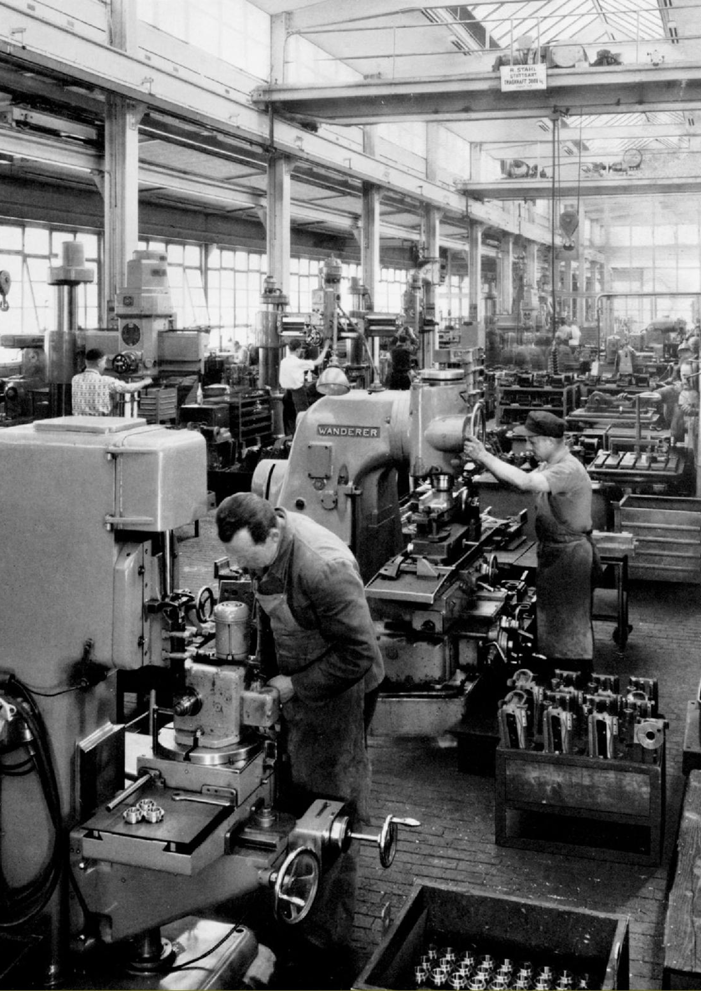
[picture p19: page 1]
