matthieu-lapeyre/phd_thesis/media/applications/art/etres-numerique/art_floor.jpg

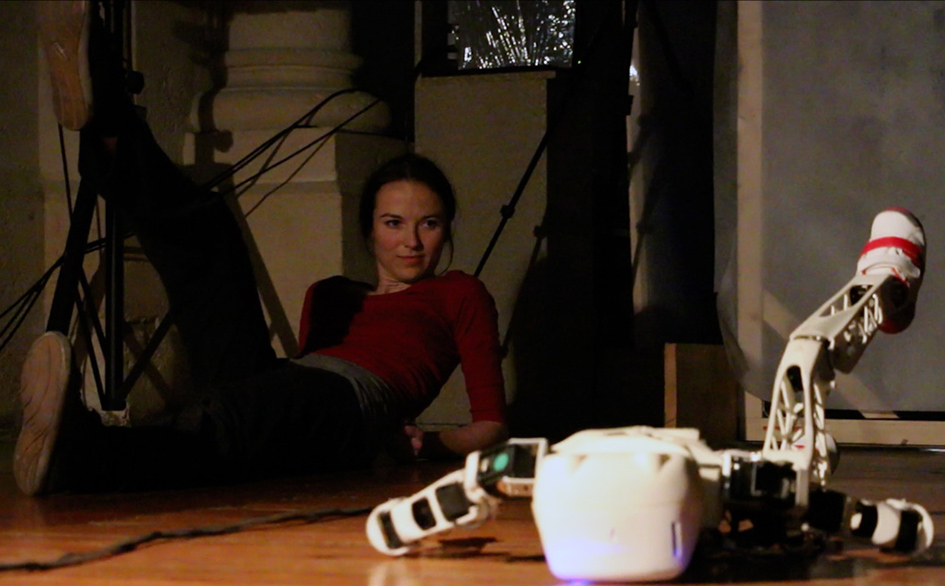
media/applications/art/etres-numerique/art_floor.jpg
