matthieu-lapeyre/phd_thesis/media/applications/art/etres-numerique/ENP_img2.jpg

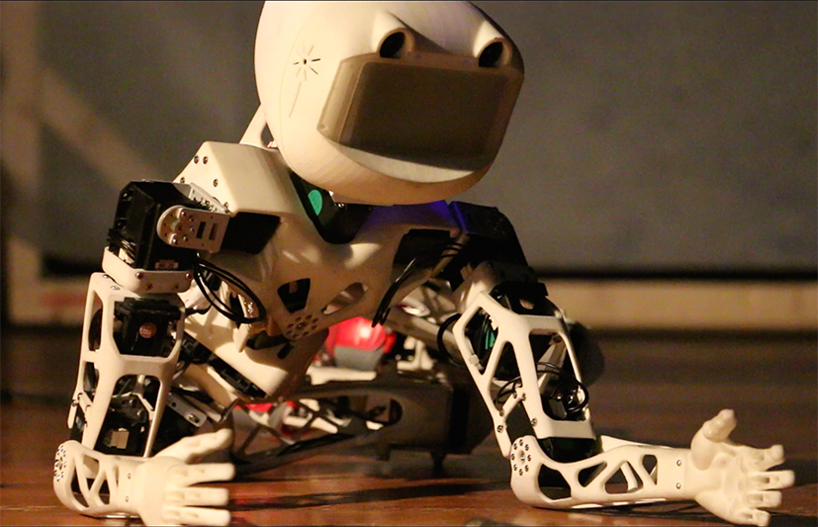
media/applications/art/etres-numerique/ENP_img2.jpg
