matthieu-lapeyre/phd_thesis/media/applications/art/etres-numerique/img3.jpg

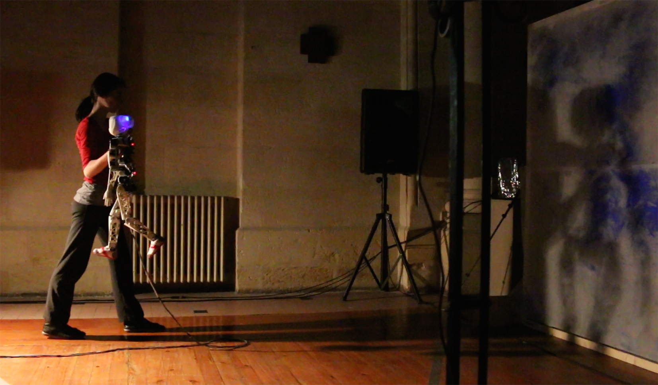
media/applications/art/etres-numerique/img3.jpg
