matthieu-lapeyre/phd_thesis/media/applications/art/etres-numerique/img6.jpg

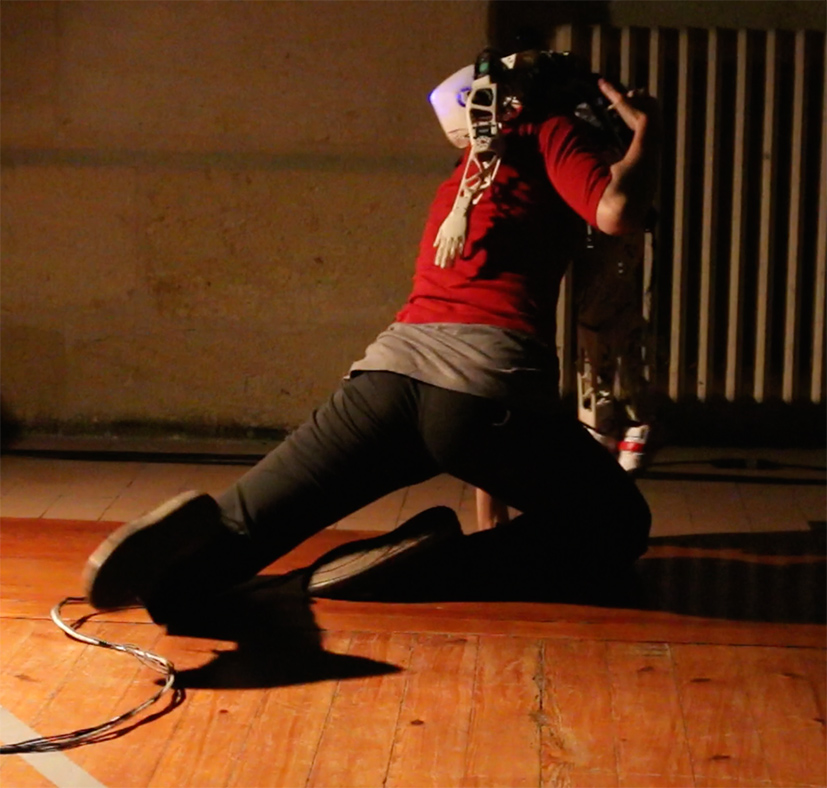
media/applications/art/etres-numerique/img6.jpg
