matthieu-lapeyre/phd_thesis/media/applications/art/etres-numerique/poppy_4ans.jpg

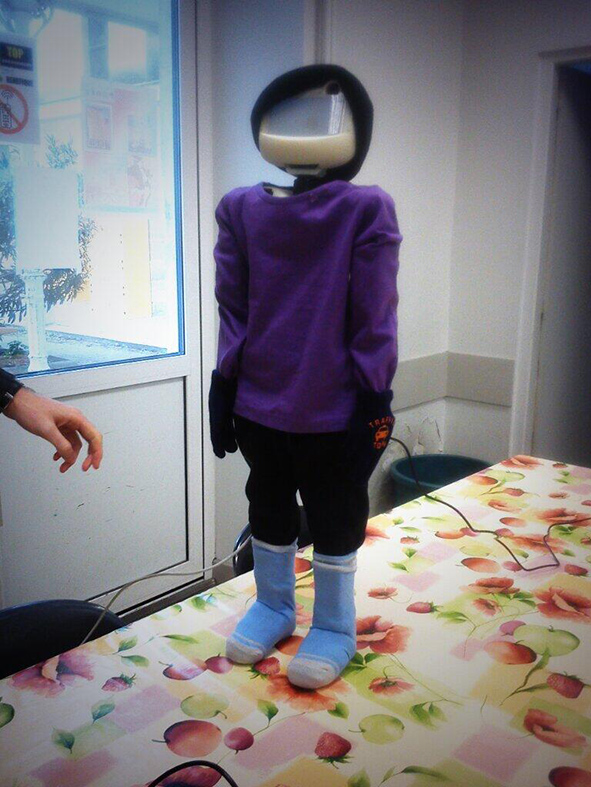
media/applications/art/etres-numerique/poppy_4ans.jpg
