matthieu-lapeyre/phd_thesis/media/applications/art/etres-numerique/poppy_dancer_stand_up.jpg

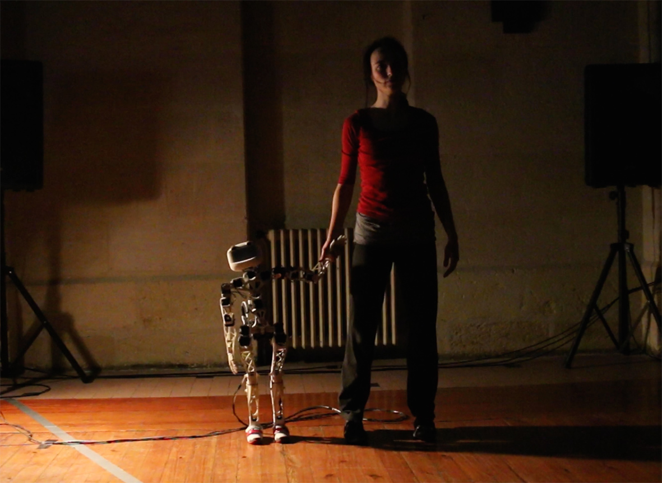
media/applications/art/etres-numerique/poppy_dancer_stand_up.jpg
