matthieu-lapeyre/phd_thesis/media/applications/art/etres-numerique/saintonge_chapel.JPG

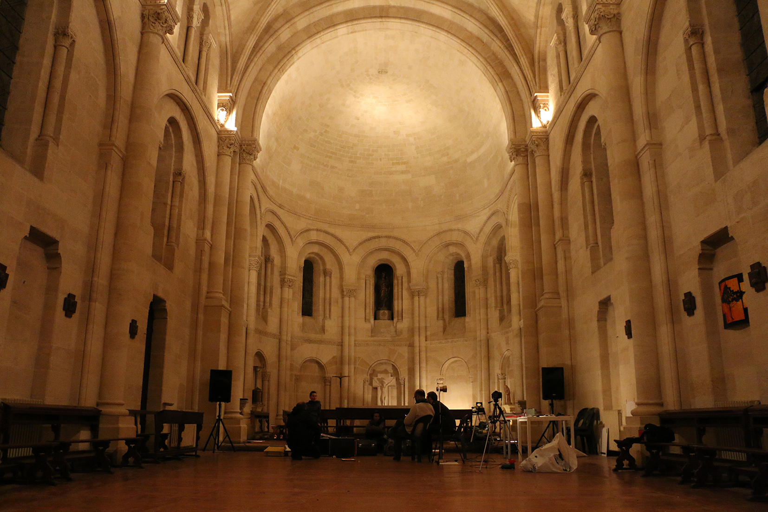
media/applications/art/etres-numerique/saintonge_chapel.JPG
