matthieu-lapeyre/phd_thesis/media/applications/art/references/bob_potts.gif

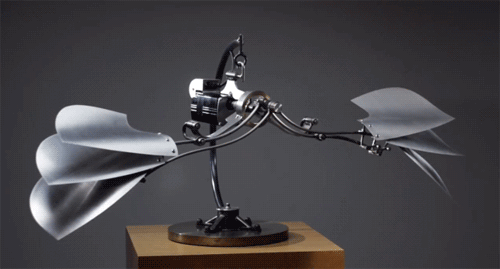
media/applications/art/references/bob_potts.gif
