matthieu-lapeyre/phd_thesis/media/applications/art/references/bob_potts.jpg

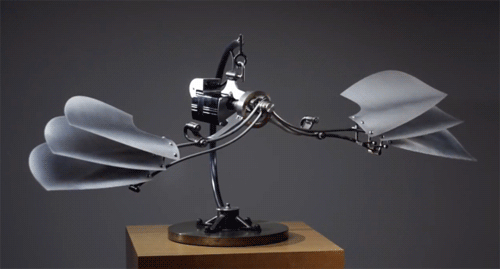
media/applications/art/references/bob_potts.jpg
