matthieu-lapeyre/phd_thesis/media/applications/art/references/chronophotography.jpg

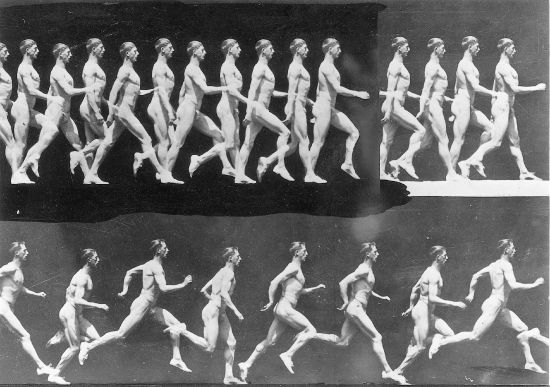
media/applications/art/references/chronophotography.jpg
