matthieu-lapeyre/phd_thesis/media/applications/art/references/chronophotography_duchamp.jpg

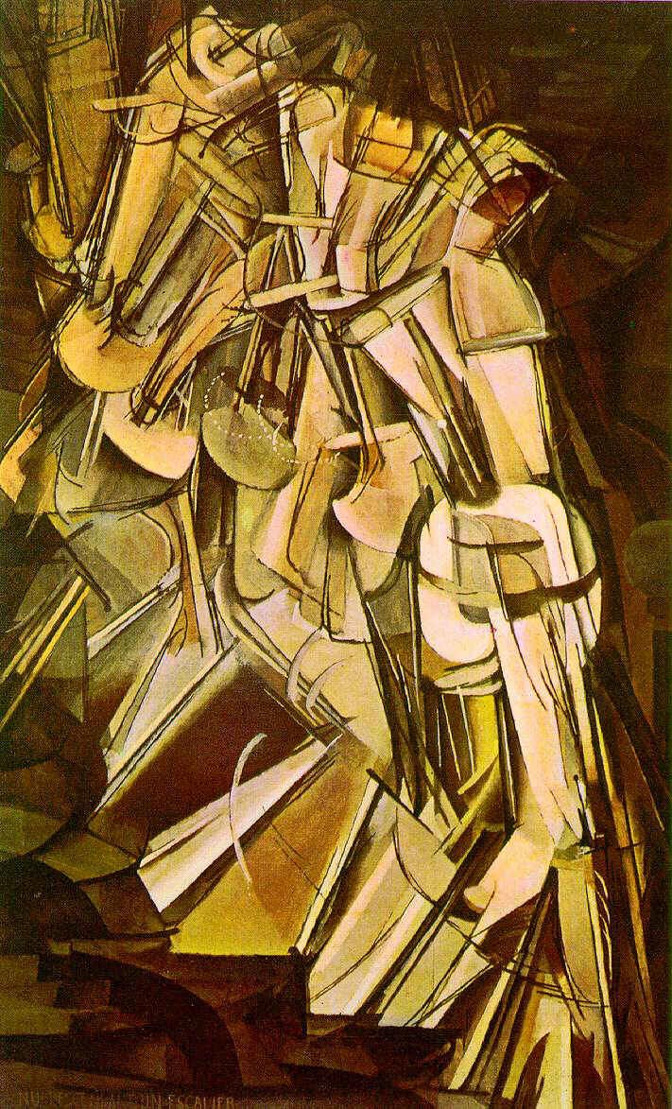
media/applications/art/references/chronophotography_duchamp.jpg
