matthieu-lapeyre/phd_thesis/media/applications/art/references/chronophotography_russolo.jpg

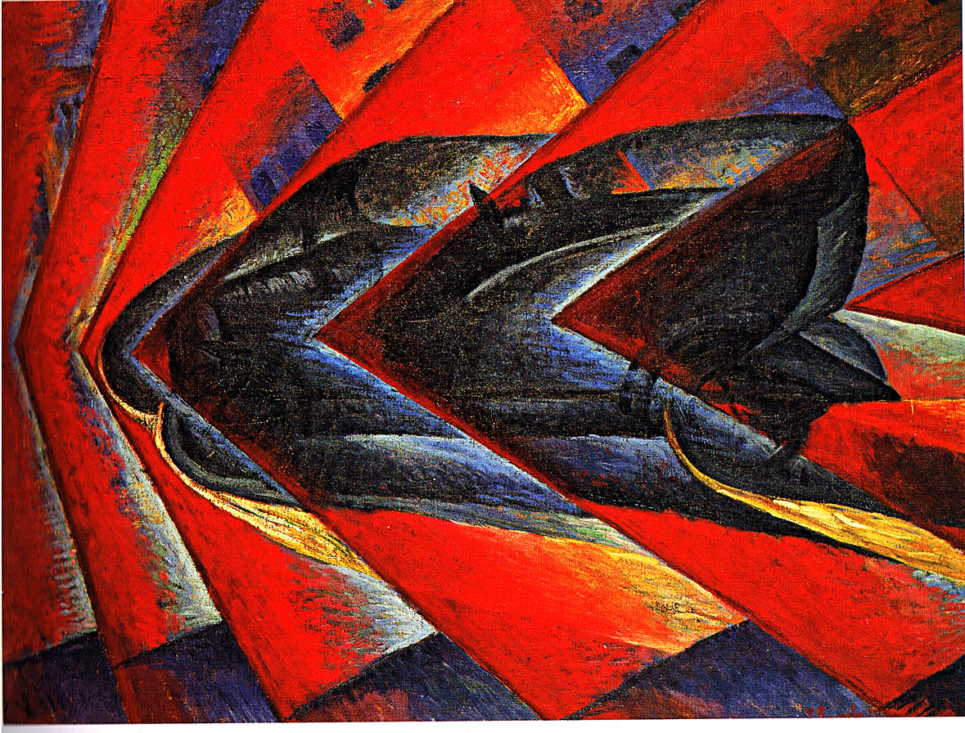
media/applications/art/references/chronophotography_russolo.jpg
