matthieu-lapeyre/phd_thesis/media/applications/art/references/ErgoRobots13.jpg

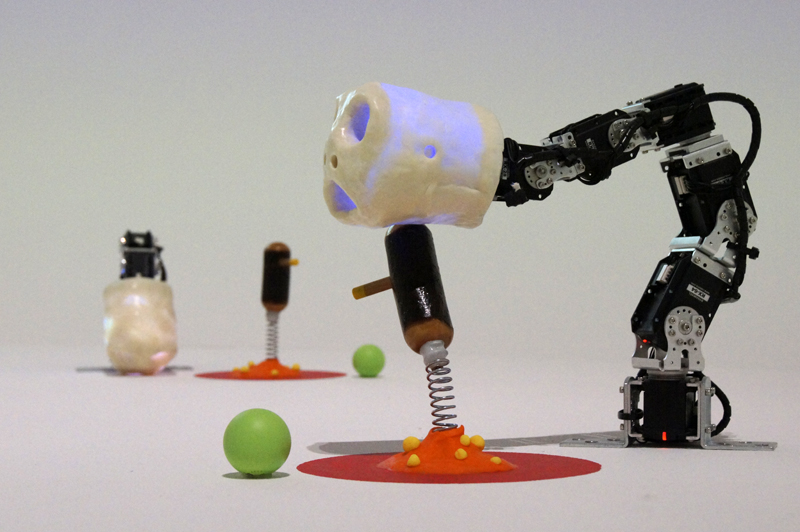
media/applications/art/references/ErgoRobots13.jpg
