matthieu-lapeyre/phd_thesis/media/applications/art/references/ErgoRobots14.jpg

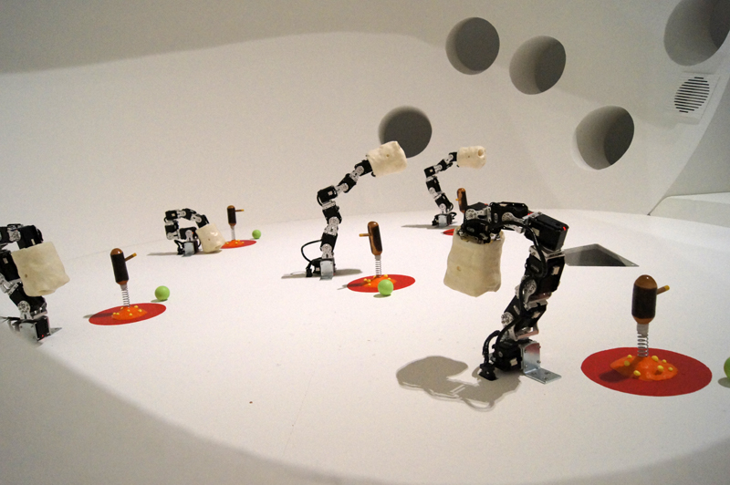
media/applications/art/references/ErgoRobots14.jpg
