matthieu-lapeyre/phd_thesis/media/applications/art/references/her-samantha.jpg

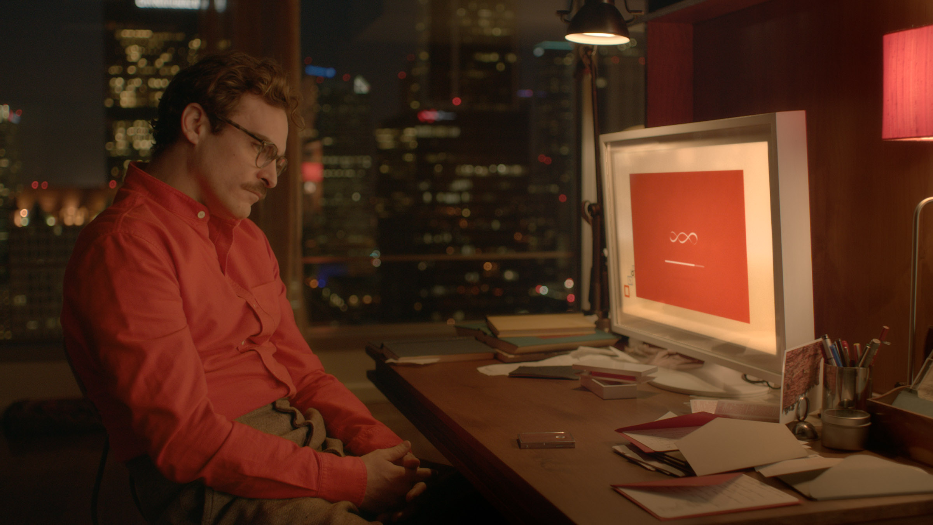
media/applications/art/references/her-samantha.jpg
