matthieu-lapeyre/phd_thesis/media/applications/art/references/r2d2.jpg

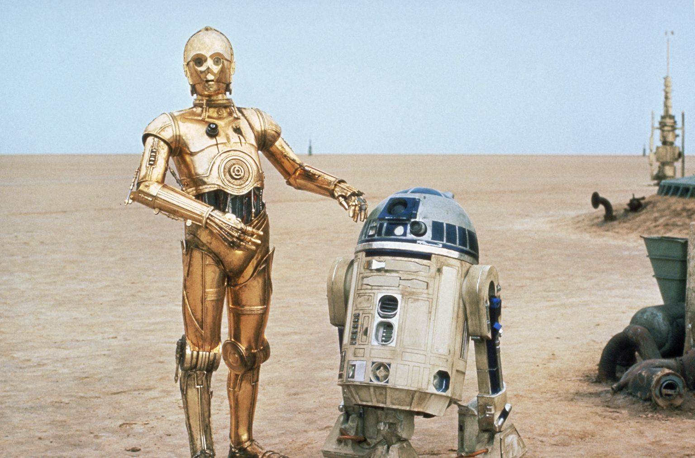
media/applications/art/references/r2d2.jpg
