matthieu-lapeyre/phd_thesis/media/applications/art/references/robot_and_frank.jpg

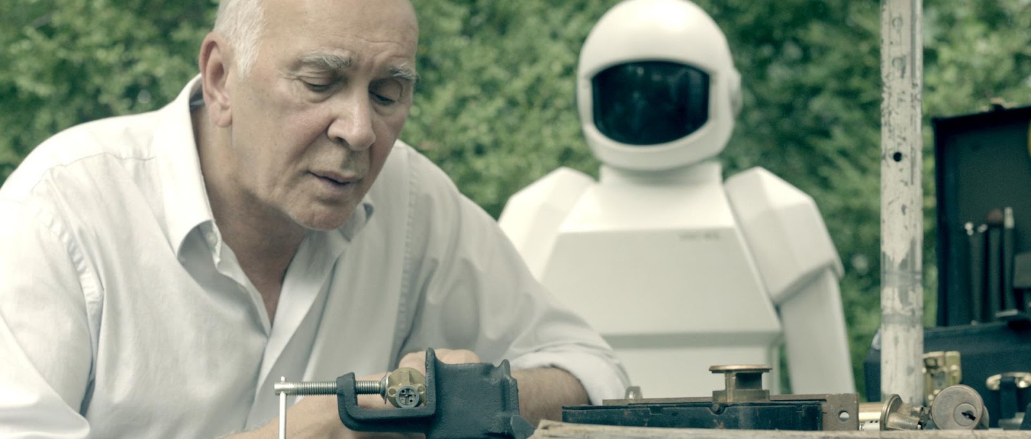
media/applications/art/references/robot_and_frank.jpg
