matthieu-lapeyre/phd_thesis/media/applications/education/arduino_IDE.png

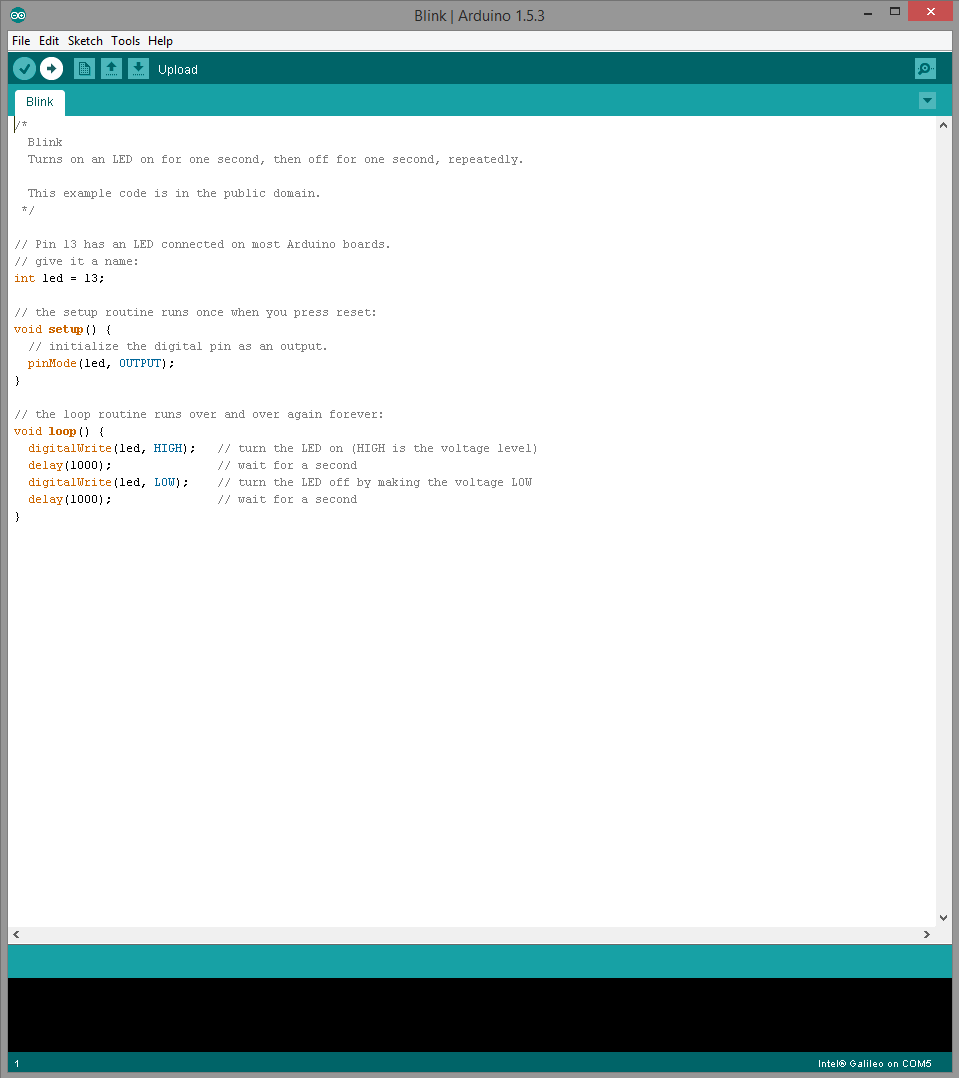
media/applications/education/arduino_IDE.png
