matthieu-lapeyre/phd_thesis/media/applications/education/TER_fear.jpg

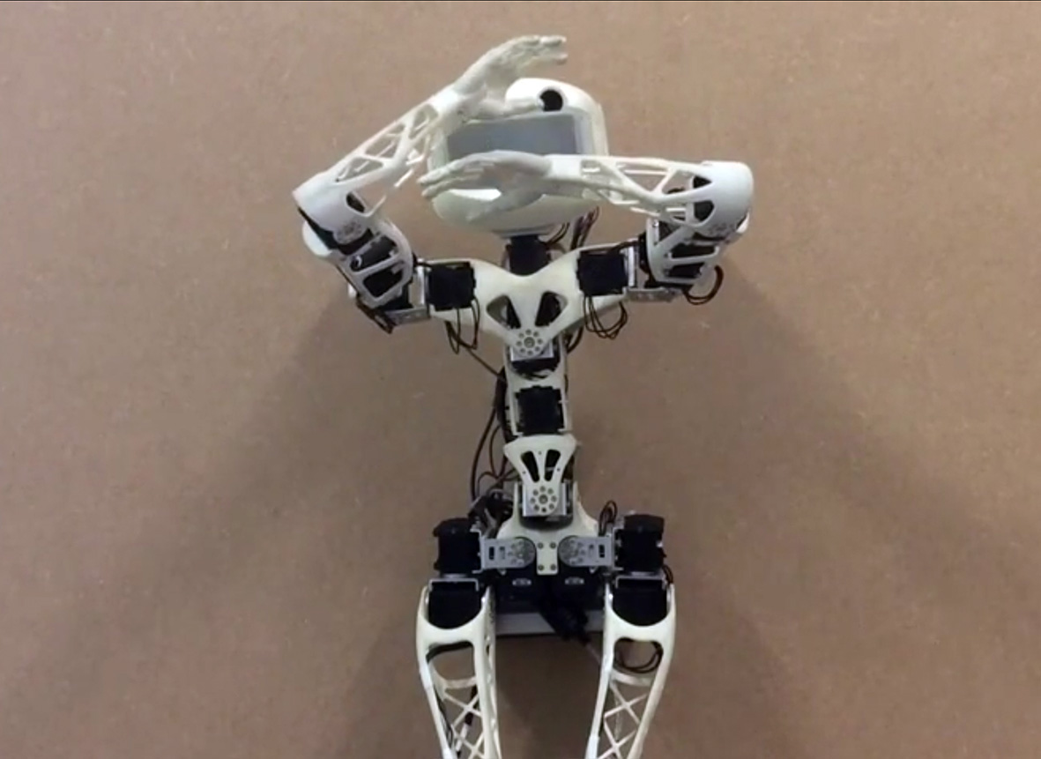
media/applications/education/TER_fear.jpg
