matthieu-lapeyre/phd_thesis/media/applications/education/TER_joy.jpg

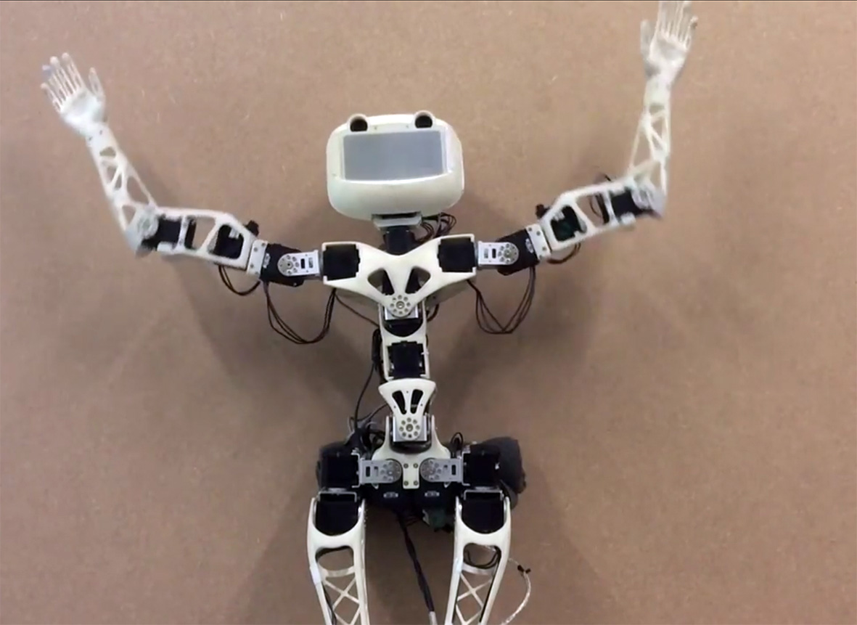
media/applications/education/TER_joy.jpg
