matthieu-lapeyre/phd_thesis/media/applications/education/TER_sad.jpg

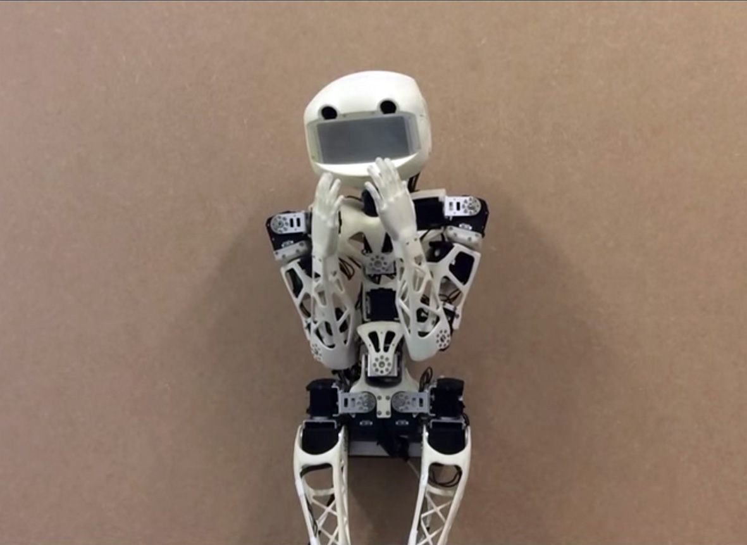
media/applications/education/TER_sad.jpg
