matthieu-lapeyre/phd_thesis/media/applications/education/TER_surprise.jpg

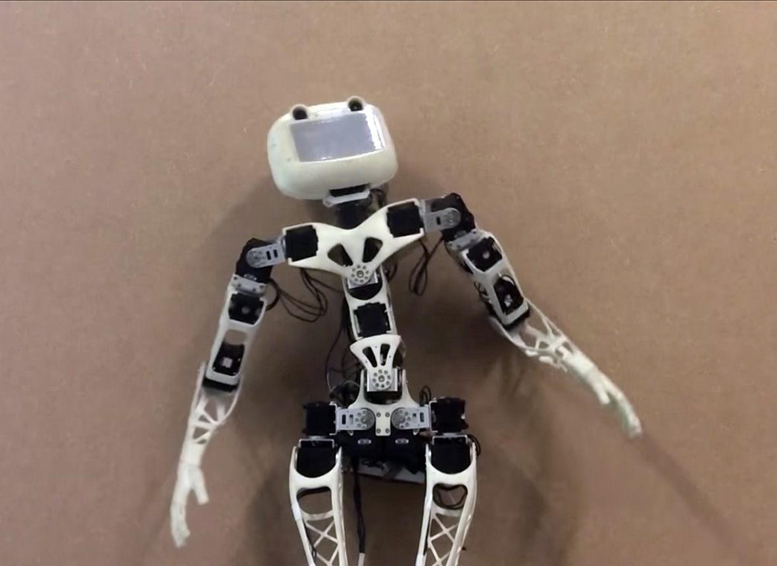
media/applications/education/TER_surprise.jpg
