matthieu-lapeyre/phd_thesis/media/applications/hackathon/art-robotique_universcience.jpg

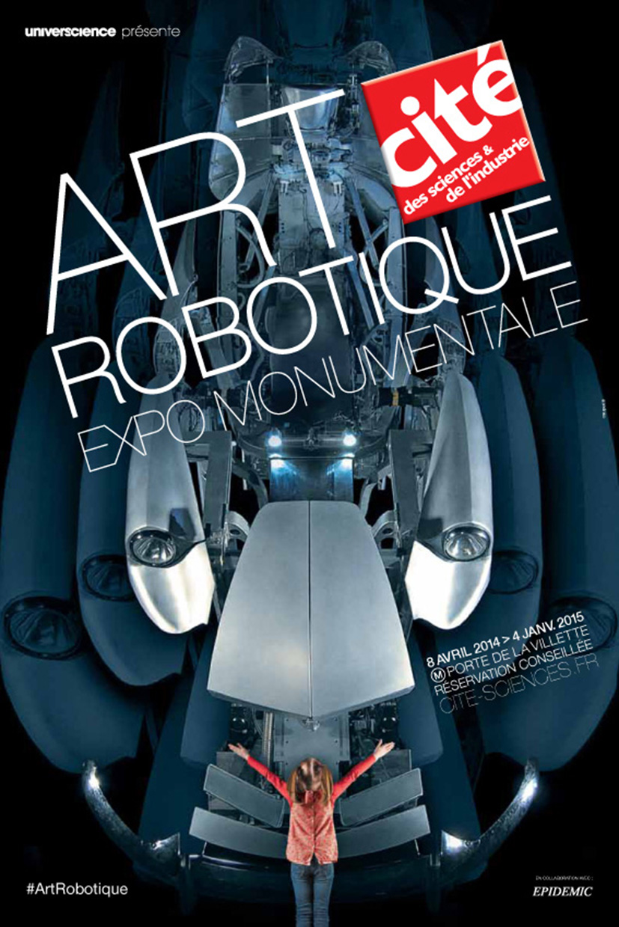
media/applications/hackathon/art-robotique_universcience.jpg
