matthieu-lapeyre/phd_thesis/media/applications/hackathon/hackathon_conception1.jpg

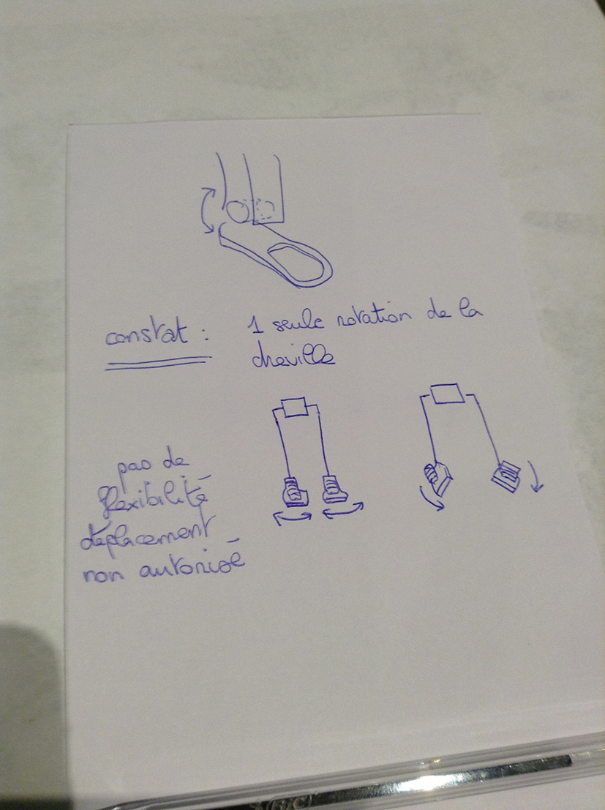
media/applications/hackathon/hackathon_conception1.jpg
