matthieu-lapeyre/phd_thesis/media/applications/hackathon/hackathon_conception2.jpg

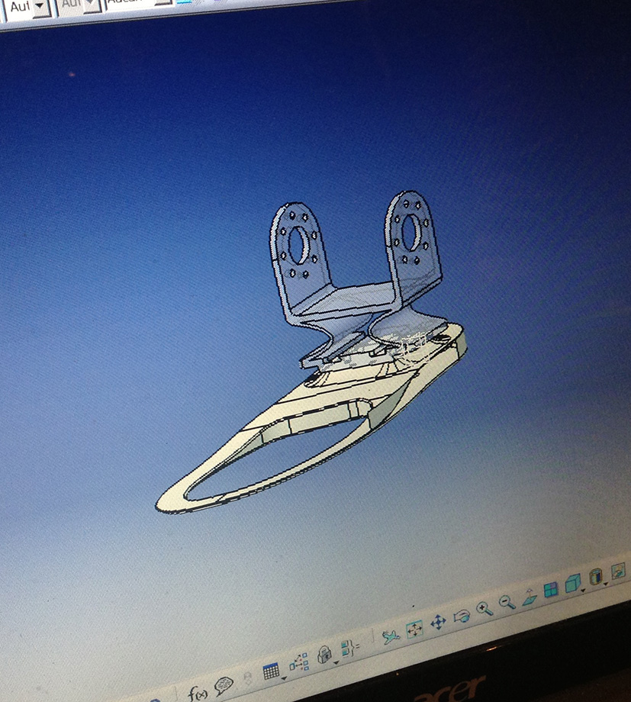
media/applications/hackathon/hackathon_conception2.jpg
