matthieu-lapeyre/phd_thesis/media/applications/hackathon/hackathon_conception3.jpg

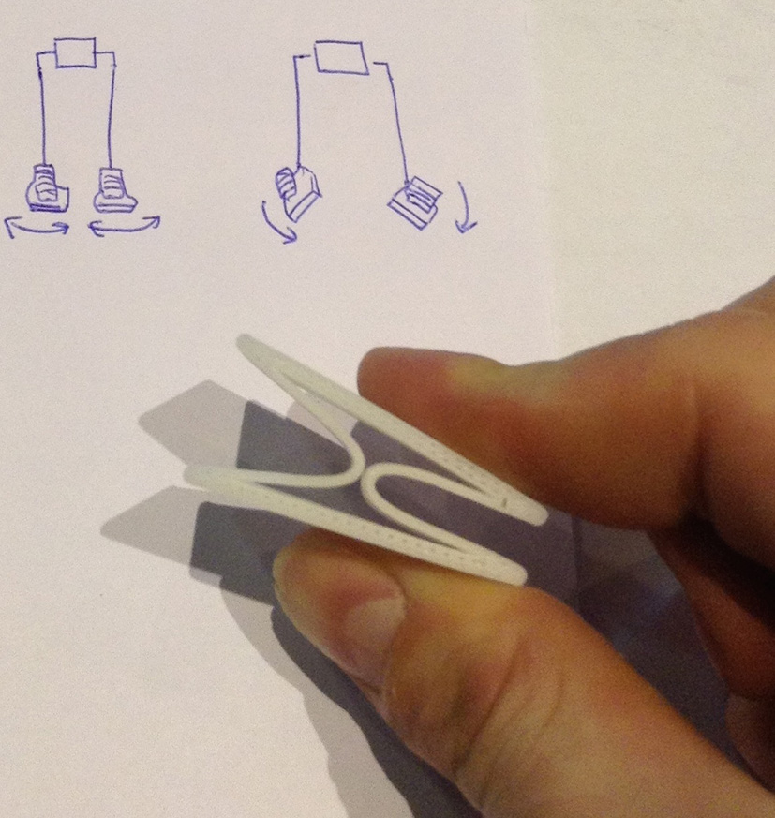
media/applications/hackathon/hackathon_conception3.jpg
