matthieu-lapeyre/phd_thesis/media/applications/hackathon/hackathon_intro.jpg

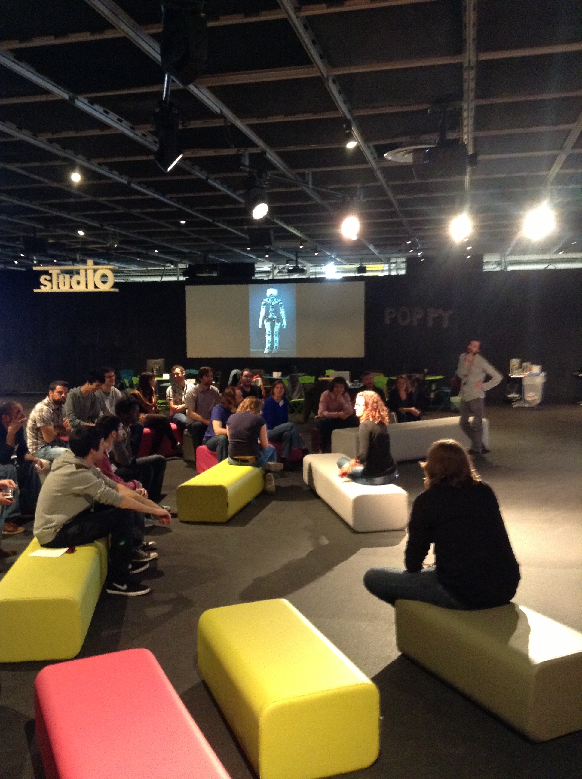
media/applications/hackathon/hackathon_intro.jpg
