matthieu-lapeyre/phd_thesis/media/applications/hackathon/photos_lowD/Photo 207.jpg

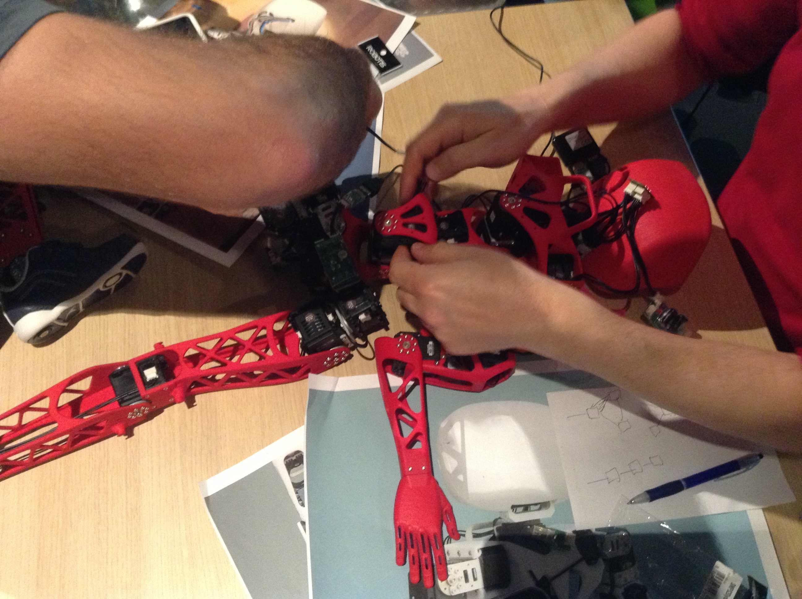
media/applications/hackathon/photos_lowD/Photo 207.jpg
