matthieu-lapeyre/phd_thesis/media/applications/hackathon/photos_lowD/Photo 219.jpg

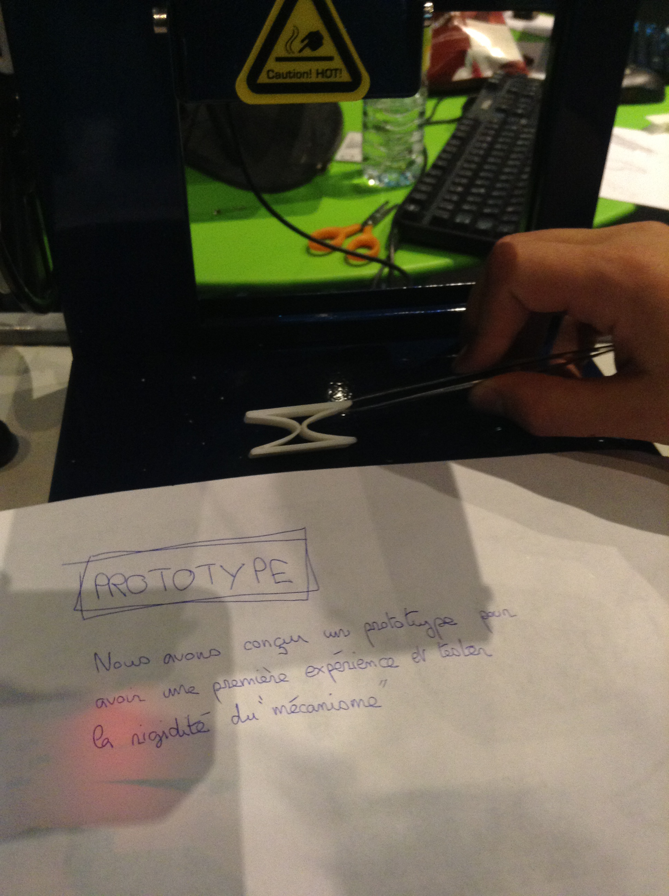
media/applications/hackathon/photos_lowD/Photo 219.jpg
