matthieu-lapeyre/phd_thesis/media/applications/hackathon/photos_lowD/Photo 221.jpg

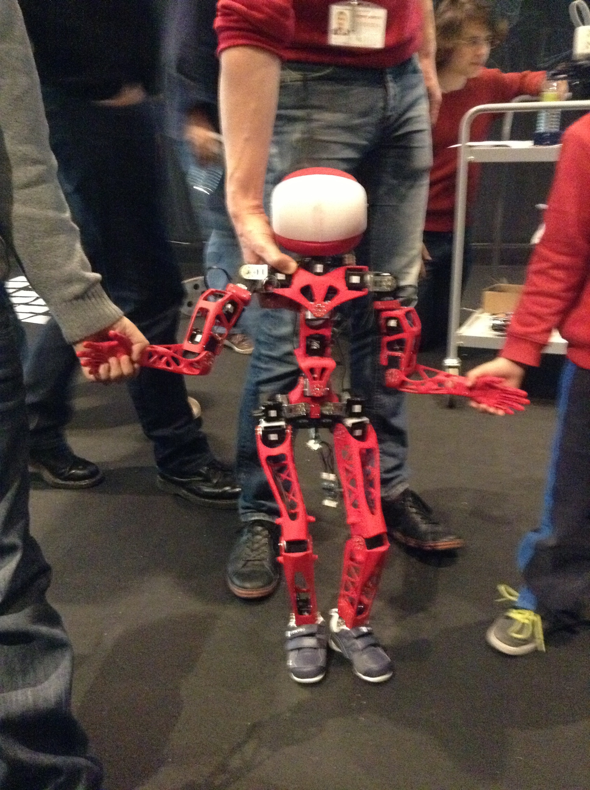
media/applications/hackathon/photos_lowD/Photo 221.jpg
