matthieu-lapeyre/phd_thesis/media/applications/hackathon/photos_lowD/Photo 249.jpg

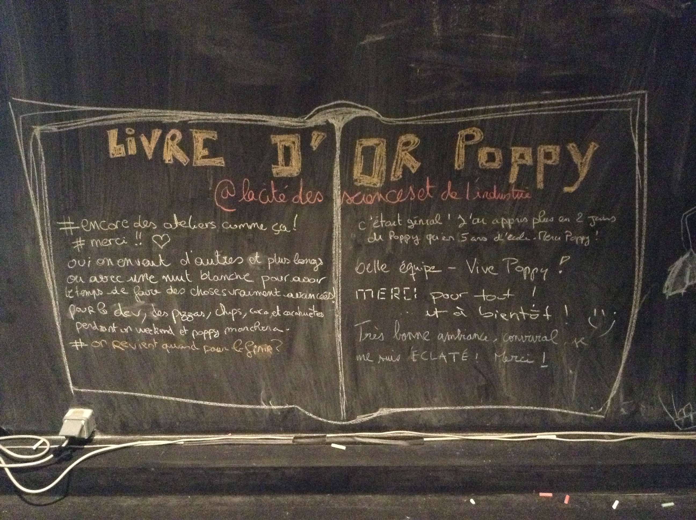
media/applications/hackathon/photos_lowD/Photo 249.jpg
