matthieu-lapeyre/phd_thesis/media/applications/hackathon/poppy_demo_universcience.jpg

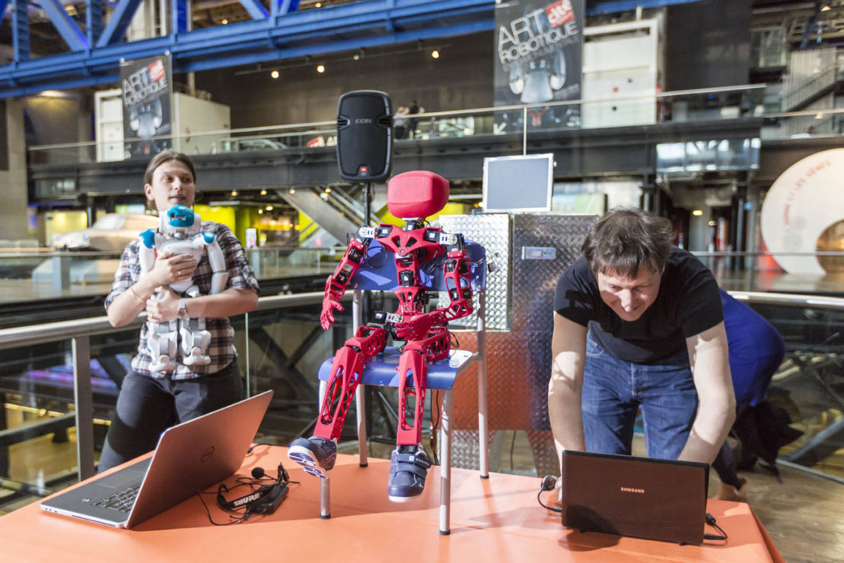
media/applications/hackathon/poppy_demo_universcience.jpg
