matthieu-lapeyre/phd_thesis/media/applications/morphology/foot_sensors.jpg

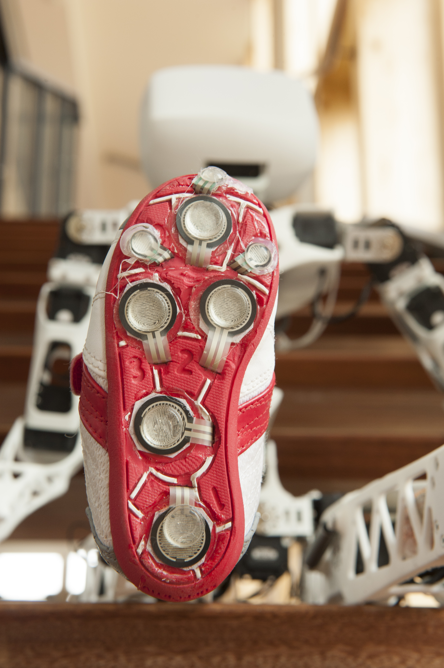
media/applications/morphology/foot_sensors.jpg
