matthieu-lapeyre/phd_thesis/media/applications/morphology/foot_sensors_proto.jpg

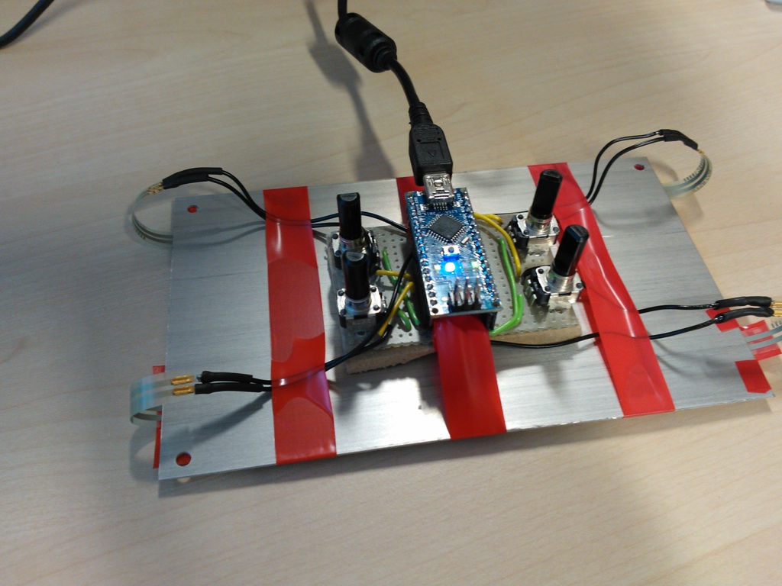
media/applications/morphology/foot_sensors_proto.jpg
