matthieu-lapeyre/phd_thesis/media/applications/morphology/FSR_explode_view.jpg

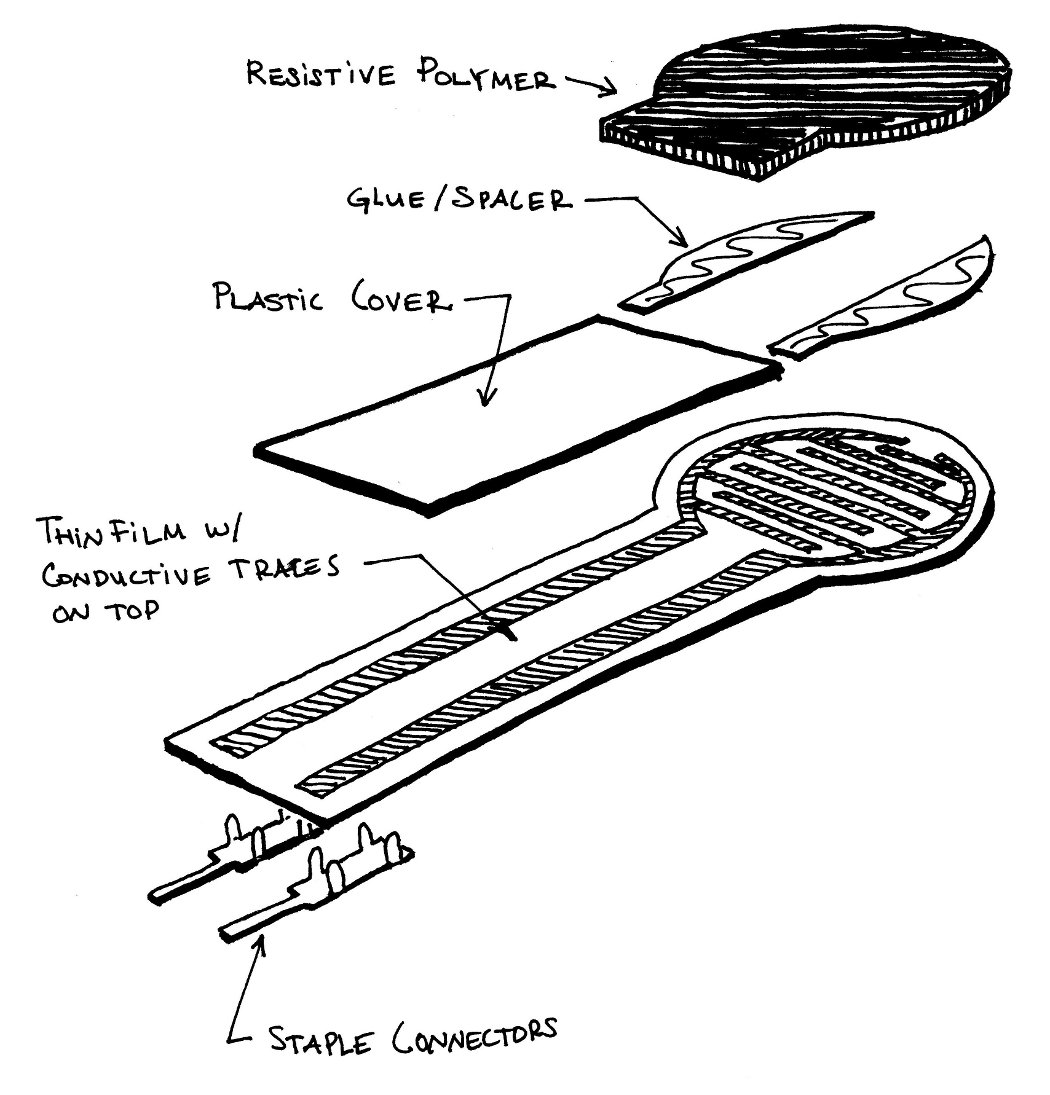
media/applications/morphology/FSR_explode_view.jpg
