matthieu-lapeyre/phd_thesis/media/applications/morphology/Gini_knee_design.jpg

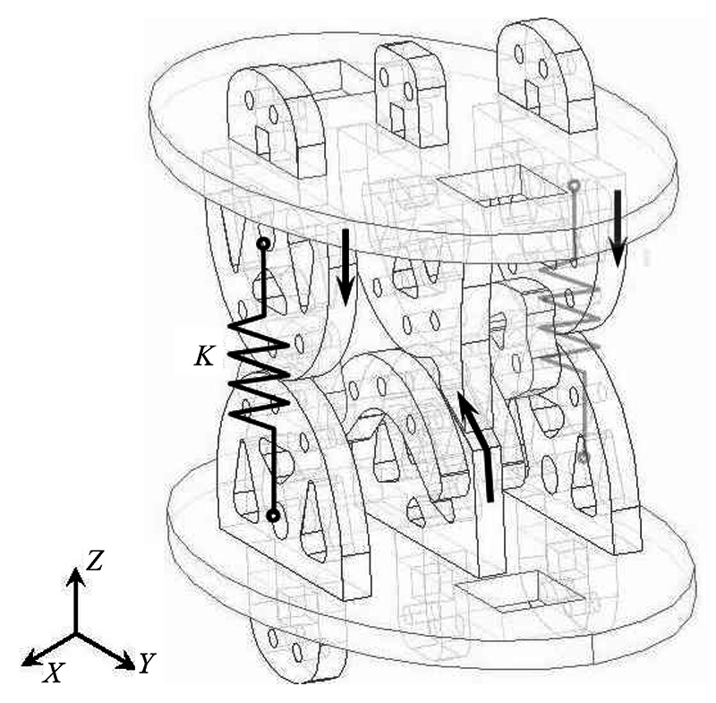
media/applications/morphology/Gini_knee_design.jpg
