matthieu-lapeyre/phd_thesis/media/applications/morphology/Gini_knee_mechanism.jpg

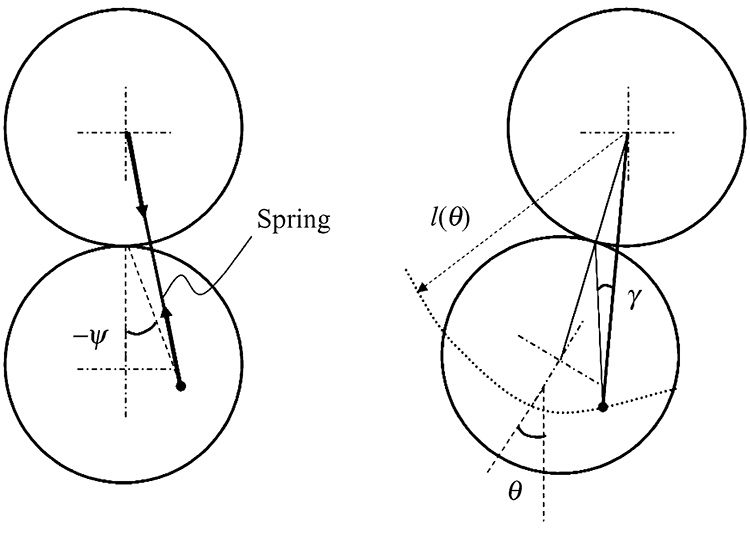
media/applications/morphology/Gini_knee_mechanism.jpg
