matthieu-lapeyre/phd_thesis/media/applications/morphology/human_GRF.jpg

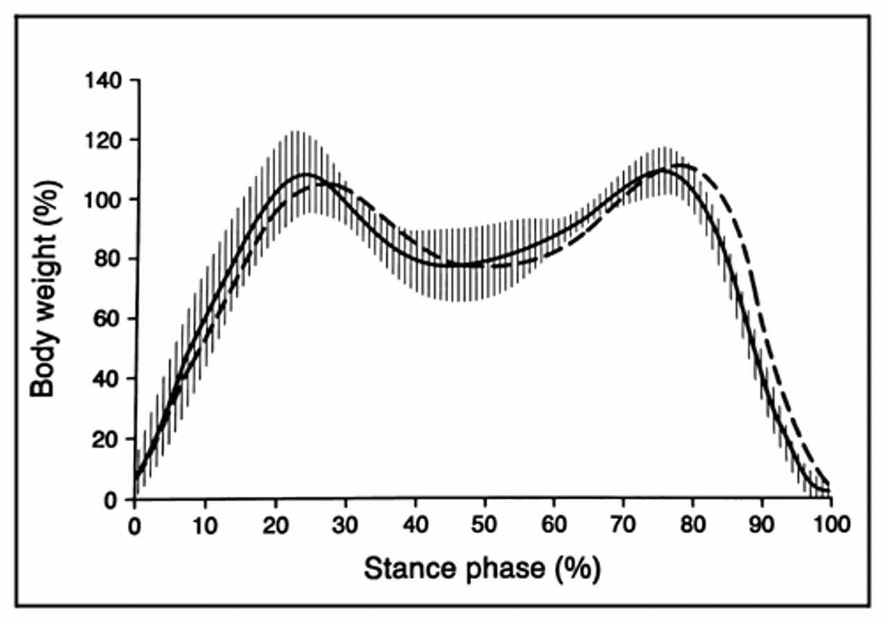
media/applications/morphology/human_GRF.jpg
