matthieu-lapeyre/phd_thesis/media/applications/morphology/human_GRF_variation.jpg

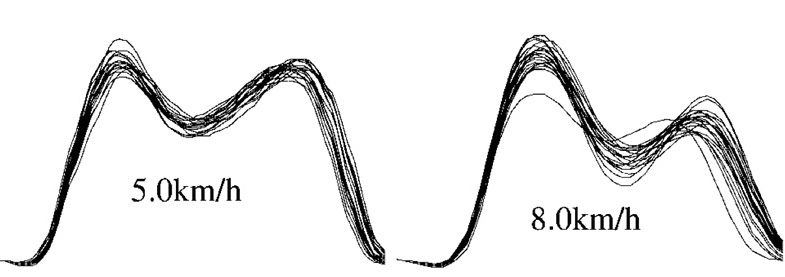
media/applications/morphology/human_GRF_variation.jpg
