matthieu-lapeyre/phd_thesis/media/applications/morphology/pic_foot_1.JPG

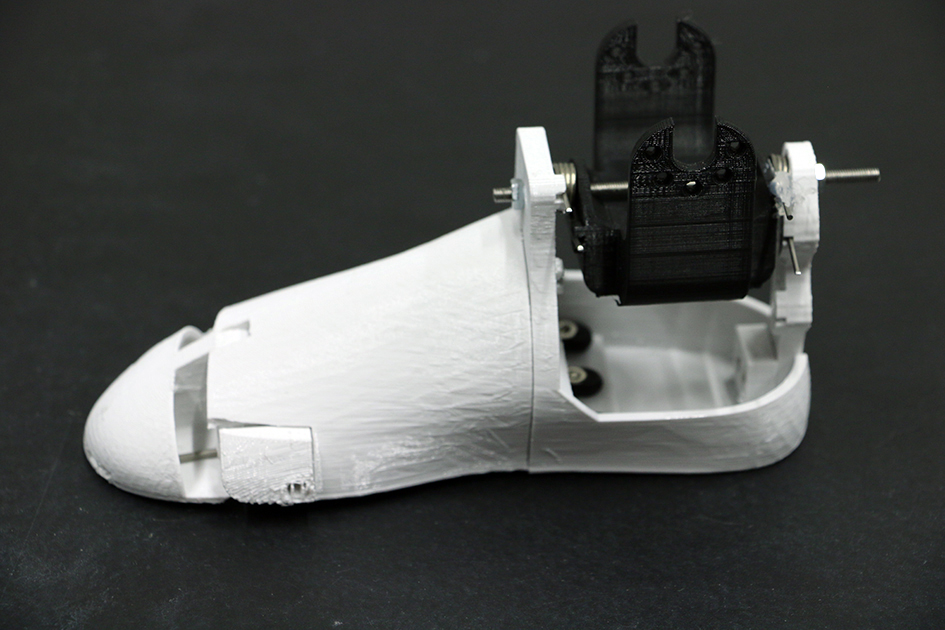
media/applications/morphology/pic_foot_1.JPG
