matthieu-lapeyre/phd_thesis/media/applications/morphology/pic_foot_2.JPG

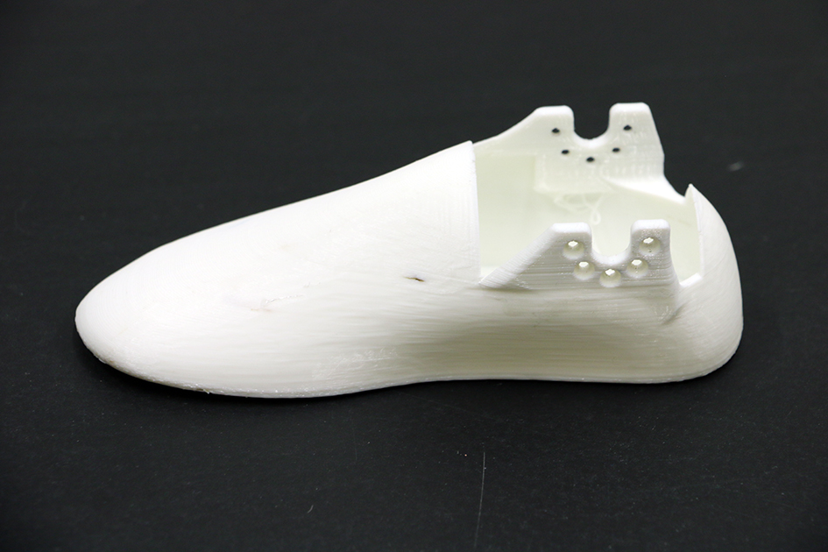
media/applications/morphology/pic_foot_2.JPG
