matthieu-lapeyre/phd_thesis/media/applications/morphology/pic_foot_3.JPG

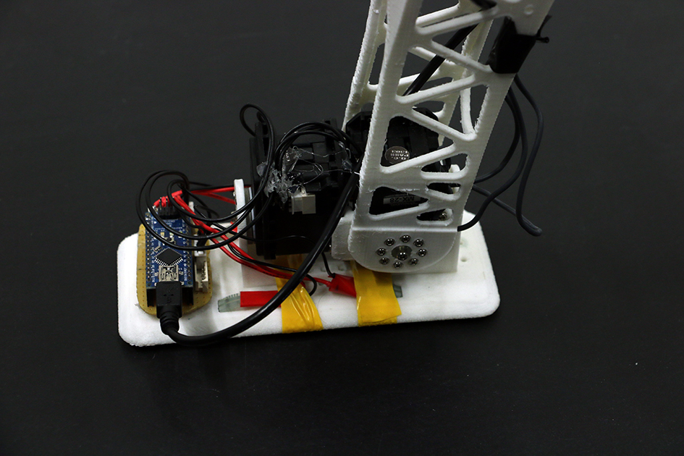
media/applications/morphology/pic_foot_3.JPG
