matthieu-lapeyre/phd_thesis/media/applications/morphology/pic_foot_4.JPG

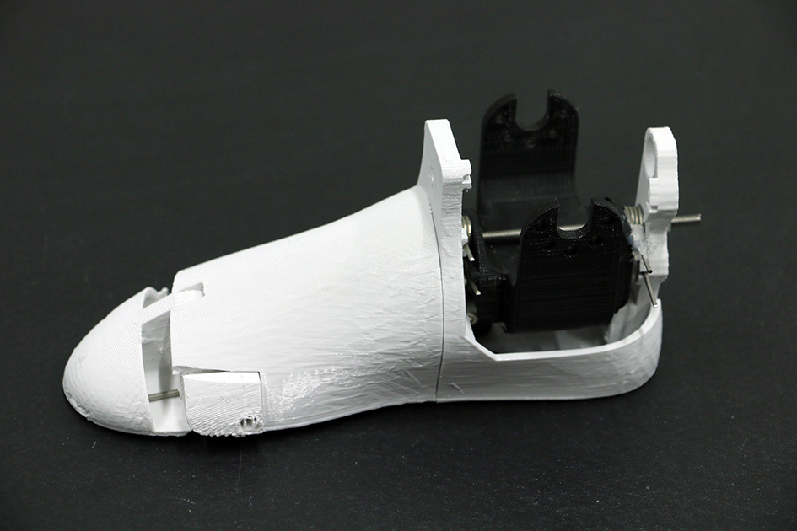
media/applications/morphology/pic_foot_4.JPG
