matthieu-lapeyre/phd_thesis/media/applications/morphology/pic_shoe.JPG

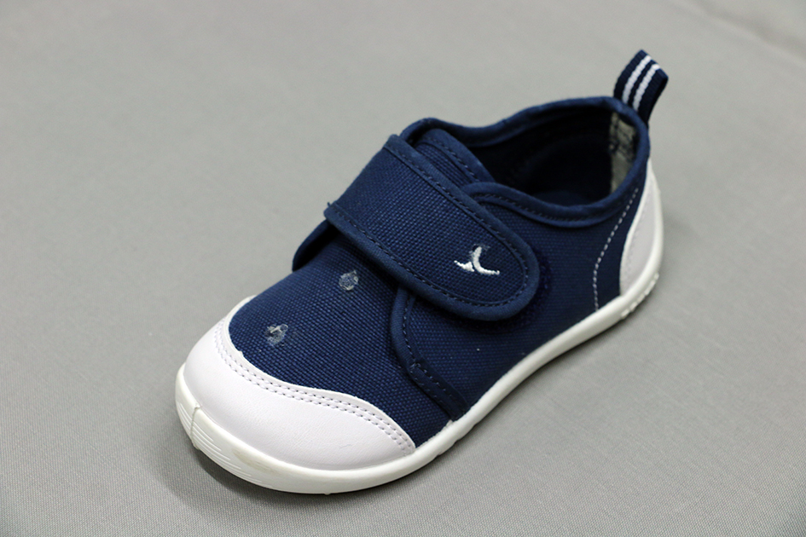
media/applications/morphology/pic_shoe.JPG
