matthieu-lapeyre/phd_thesis/media/applications/morphology/poppy_leg_arduino_nano.jpg

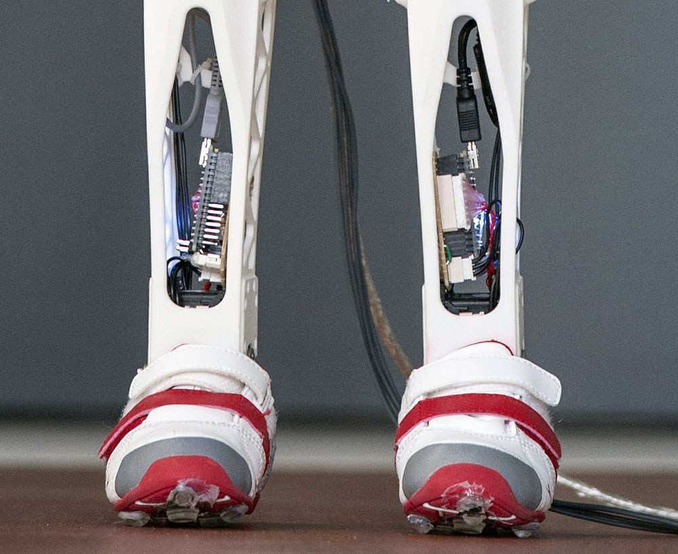
media/applications/morphology/poppy_leg_arduino_nano.jpg
