matthieu-lapeyre/phd_thesis/media/applications/morphology/poppy_semi_passive_knee.jpg

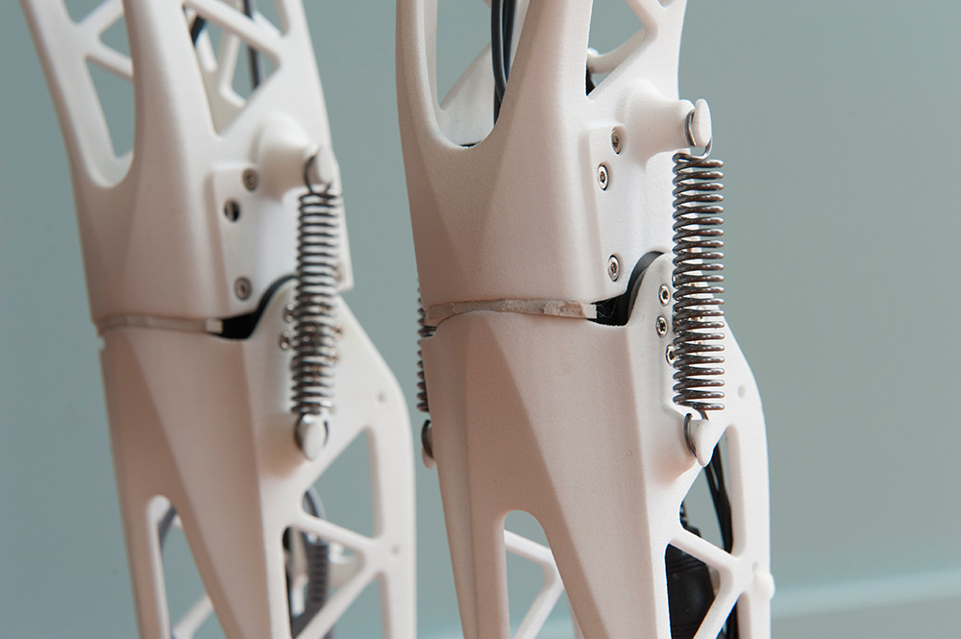
media/applications/morphology/poppy_semi_passive_knee.jpg
