matthieu-lapeyre/phd_thesis/media/classic_production_distribution.jpg

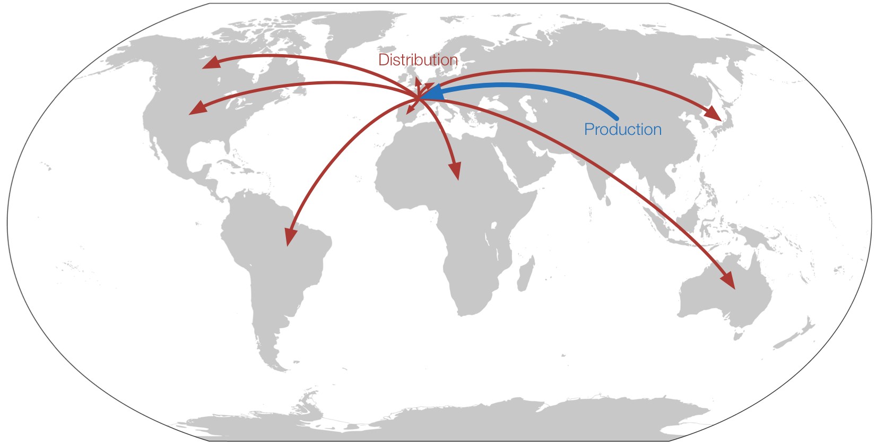
media/classic_production_distribution.jpg
