matthieu-lapeyre/phd_thesis/media/discussion/breazeal_and_jibo.jpg

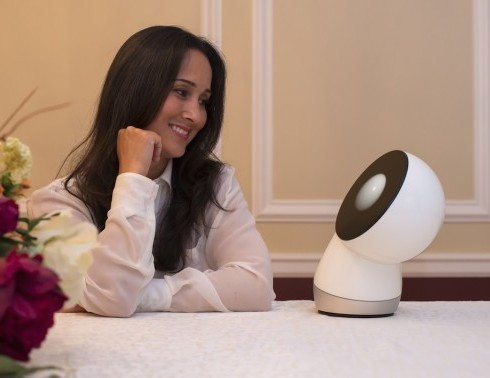
media/discussion/breazeal_and_jibo.jpg
