matthieu-lapeyre/phd_thesis/media/discussion/brooks_and_baxter.jpg

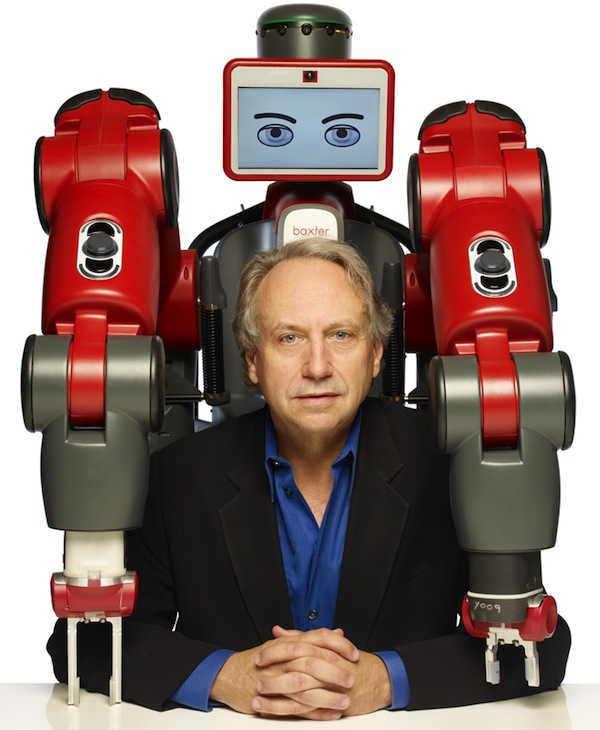
media/discussion/brooks_and_baxter.jpg
