matthieu-lapeyre/phd_thesis/media/discussion/compare-io-boards.jpg

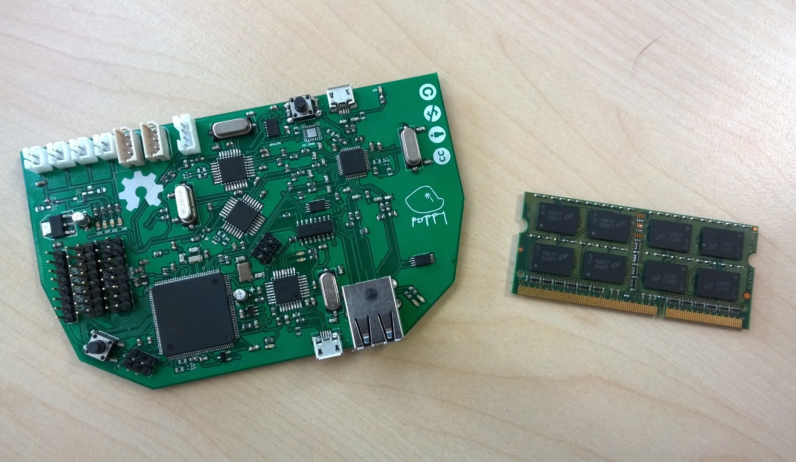
media/discussion/compare-io-boards.jpg
