matthieu-lapeyre/phd_thesis/media/discussion/io-module.png

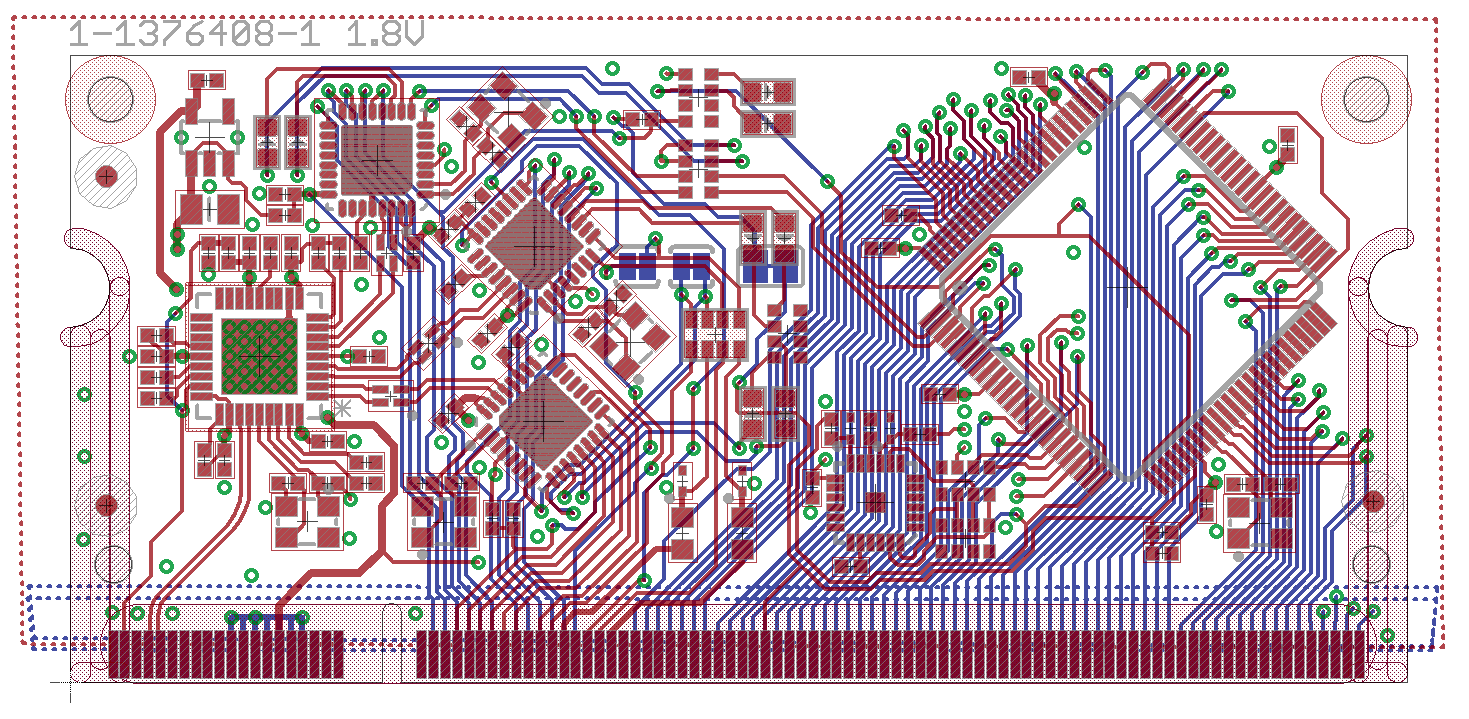
media/discussion/io-module.png
