matthieu-lapeyre/phd_thesis/media/discussion/motor_orientation.png

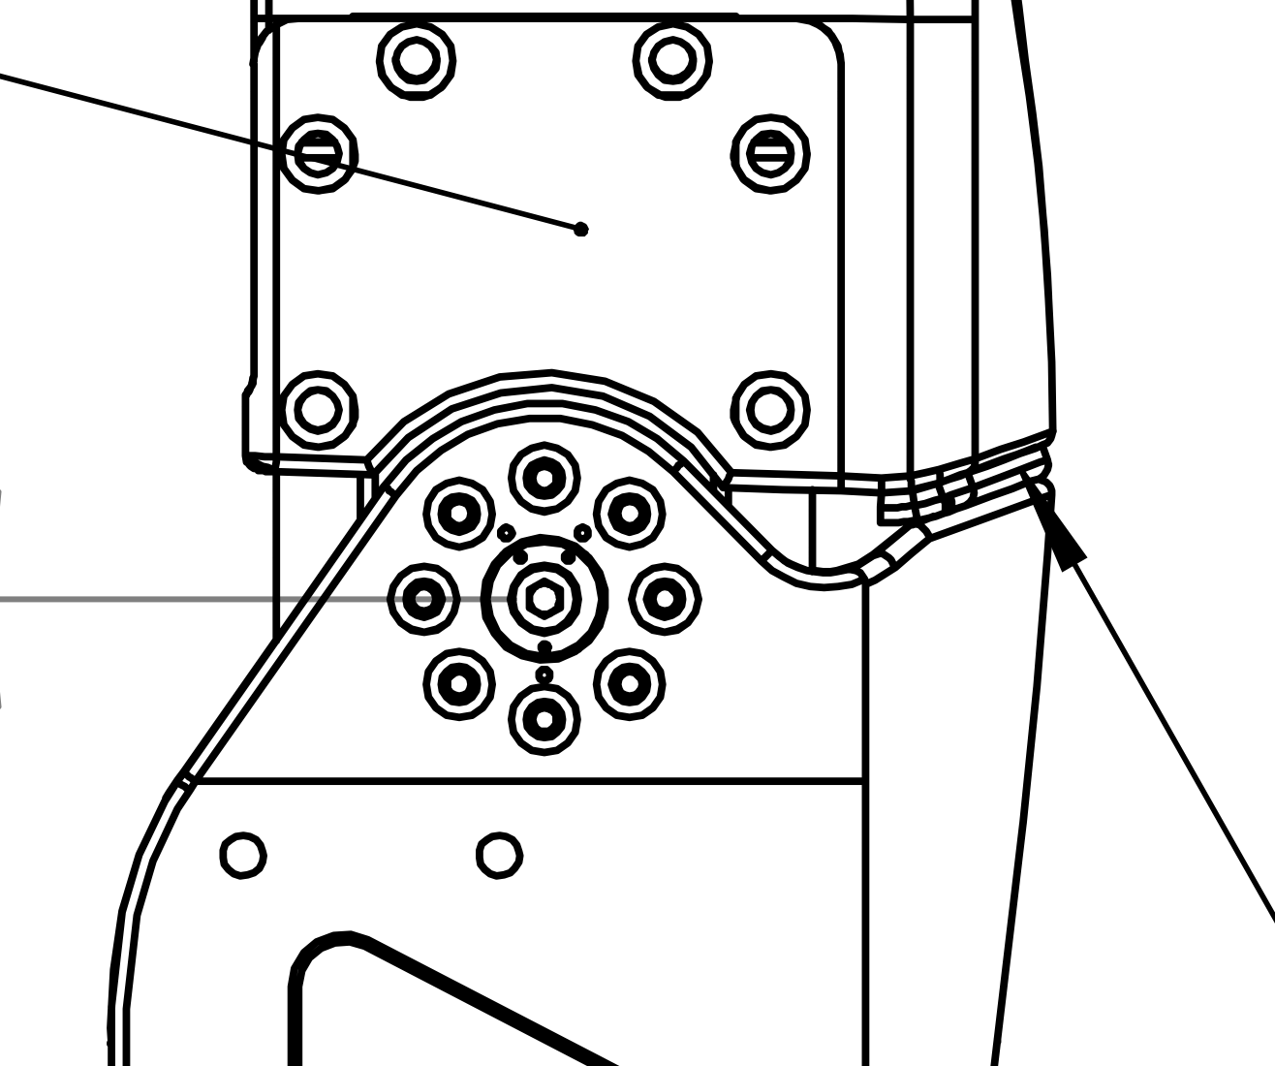
media/discussion/motor_orientation.png
