matthieu-lapeyre/phd_thesis/media/discussion/project-ara.jpg

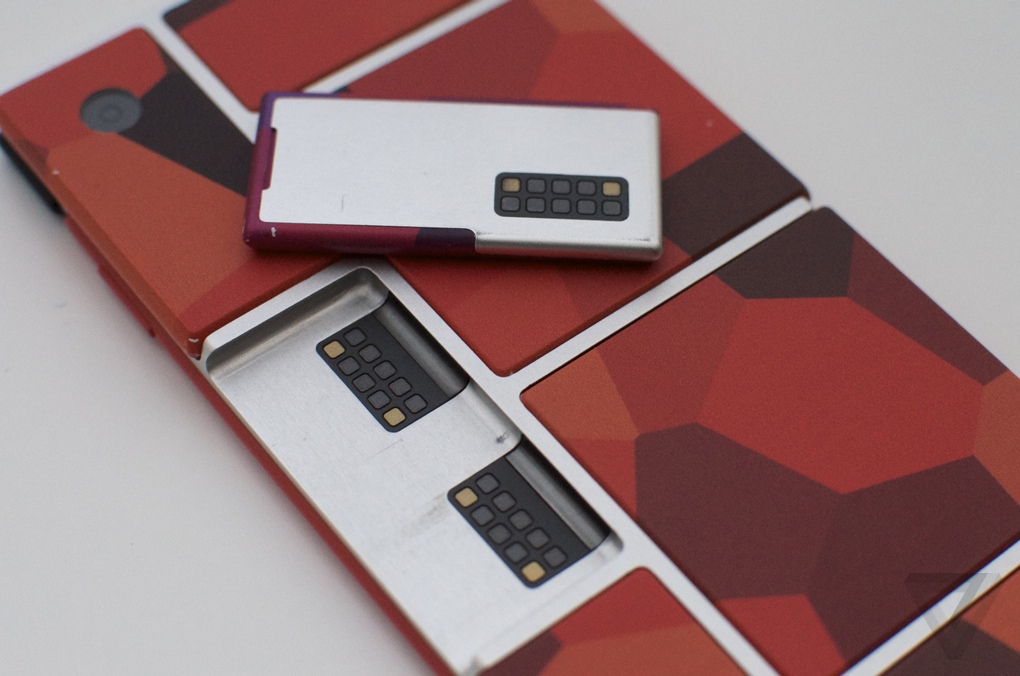
media/discussion/project-ara.jpg
