matthieu-lapeyre/phd_thesis/media/discussion/world_map.jpg

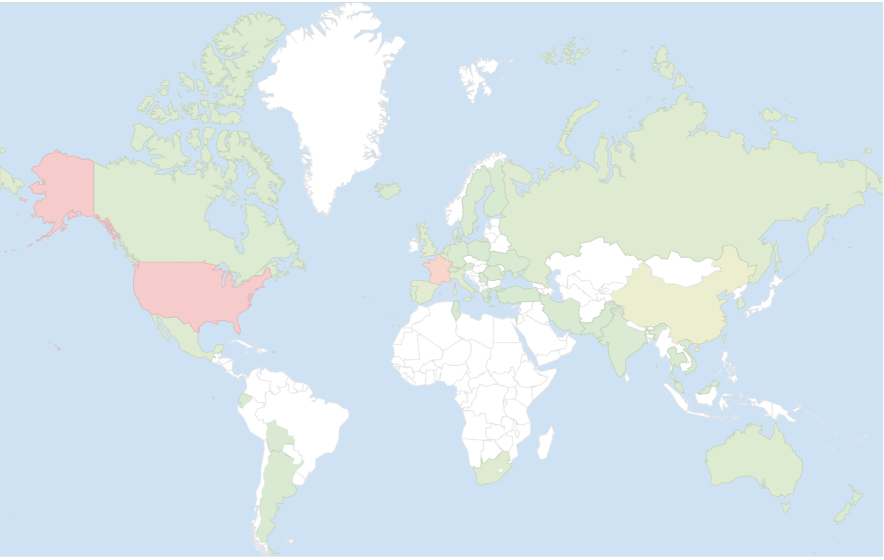
media/discussion/world_map.jpg
