matthieu-lapeyre/phd_thesis/media/fabusine_local.jpg

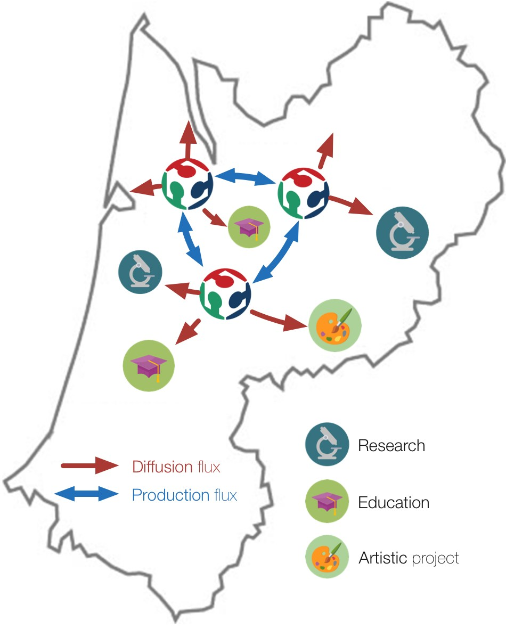
media/fabusine_local.jpg
