matthieu-lapeyre/phd_thesis/media/open_hardware/oh_project_evolution.jpg

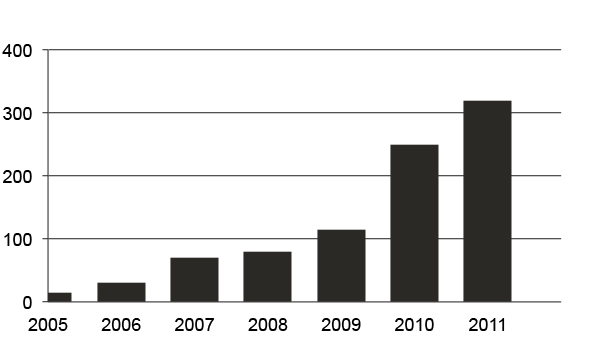
media/open_hardware/oh_project_evolution.jpg
