matthieu-lapeyre/phd_thesis/media/open_hardware/oh_startup_creation.jpg

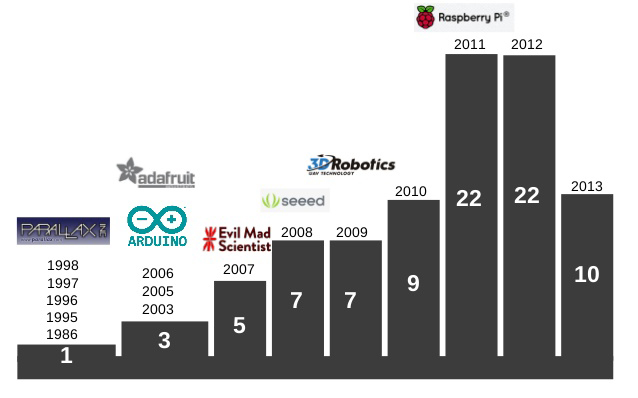
media/open_hardware/oh_startup_creation.jpg
