matthieu-lapeyre/phd_thesis/media/open_hardware/reprap_family_tree.png

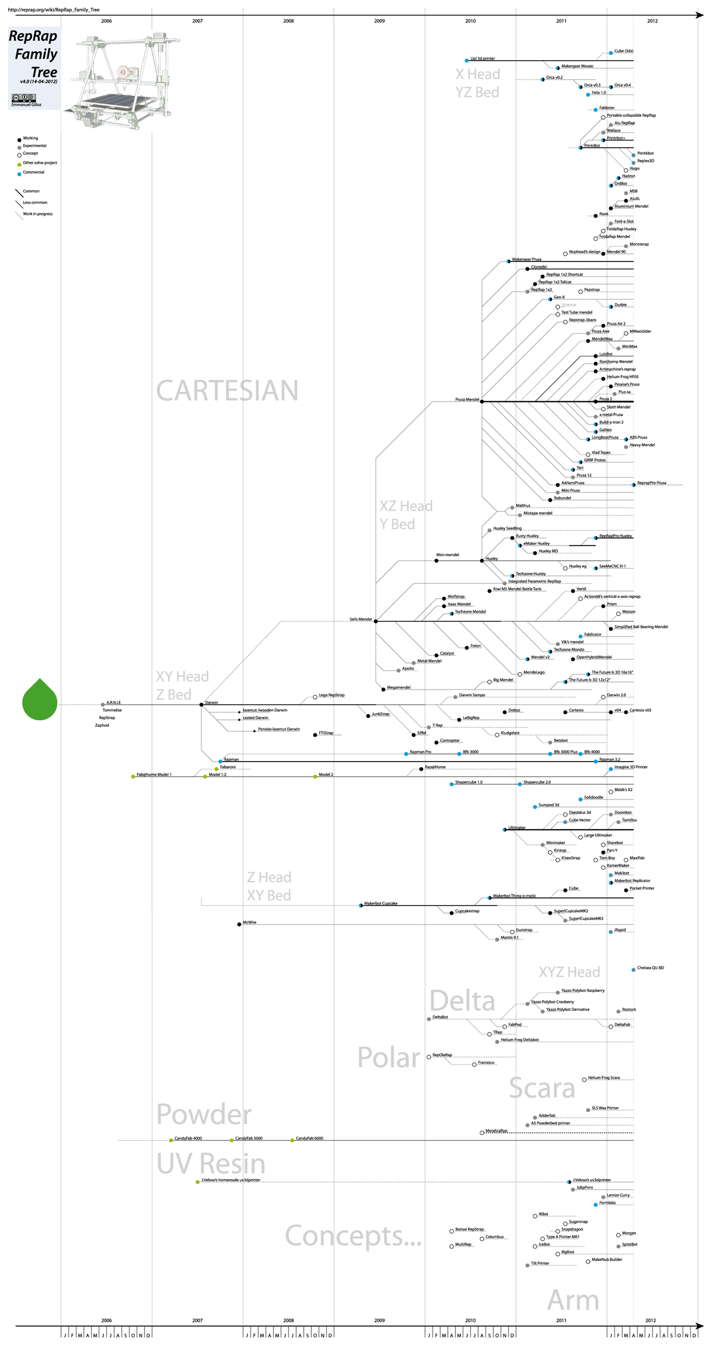
media/open_hardware/reprap_family_tree.png
