matthieu-lapeyre/phd_thesis/media/open_hardware/RepRap_v2.jpg

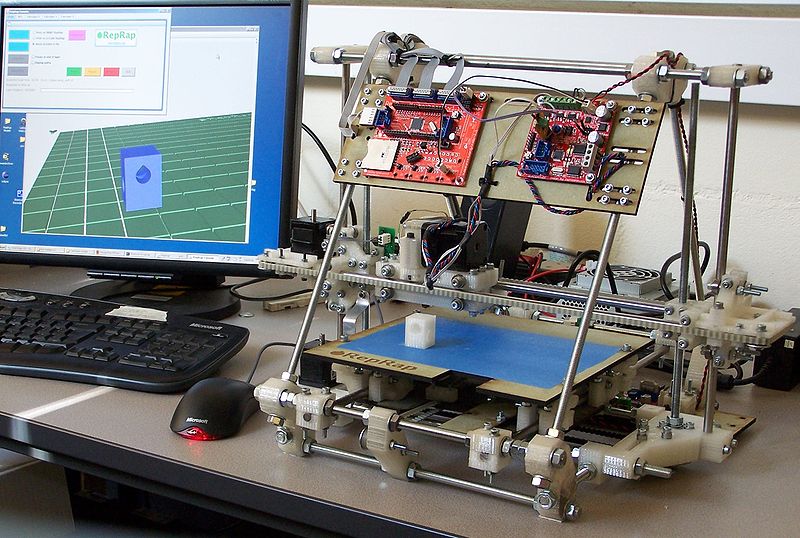
media/open_hardware/RepRap_v2.jpg
