matthieu-lapeyre/phd_thesis/media/open_hardware/shapeoko_v2.jpg

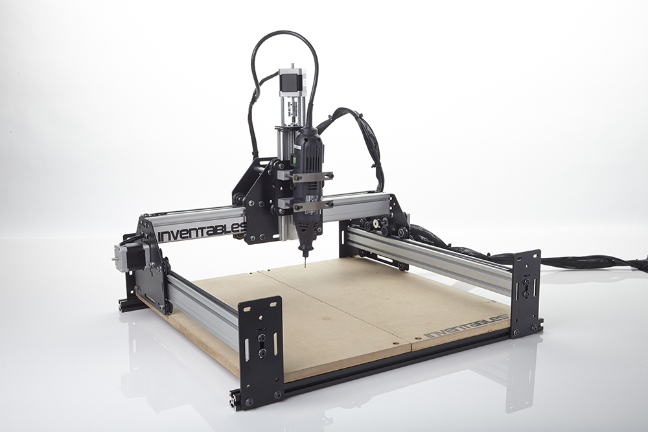
media/open_hardware/shapeoko_v2.jpg
