matthieu-lapeyre/phd_thesis/media/poppy/approach/comparaison-servomoteurs-dynamixel-robotis.png

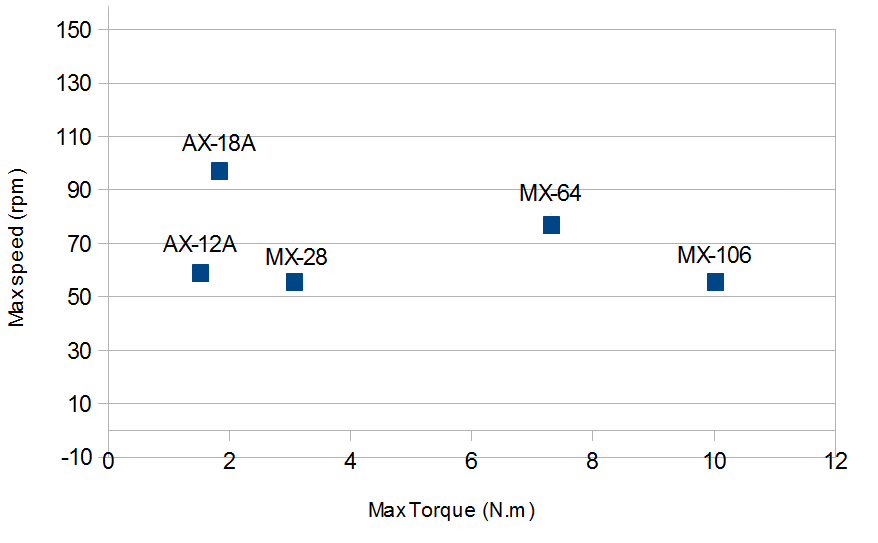
media/poppy/approach/comparaison-servomoteurs-dynamixel-robotis.png
