matthieu-lapeyre/phd_thesis/media/poppy/approach/dynamixel_actuator.jpg

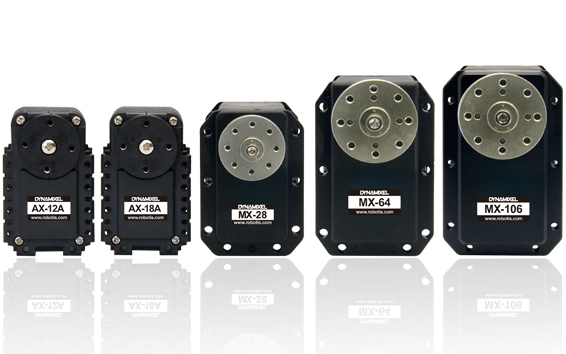
media/poppy/approach/dynamixel_actuator.jpg
