matthieu-lapeyre/phd_thesis/media/poppy/breazeal_kismet.jpg

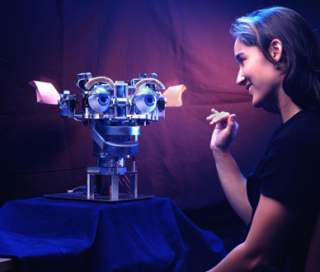
media/poppy/breazeal_kismet.jpg
