matthieu-lapeyre/phd_thesis/media/poppy/brooks_and_cog.jpg

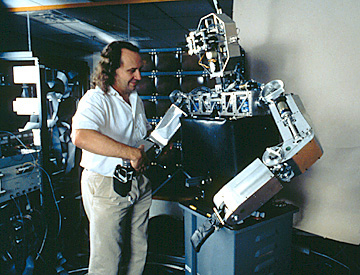
media/poppy/brooks_and_cog.jpg
