matthieu-lapeyre/phd_thesis/media/poppy/community/poppy_forum_bbpress.jpg

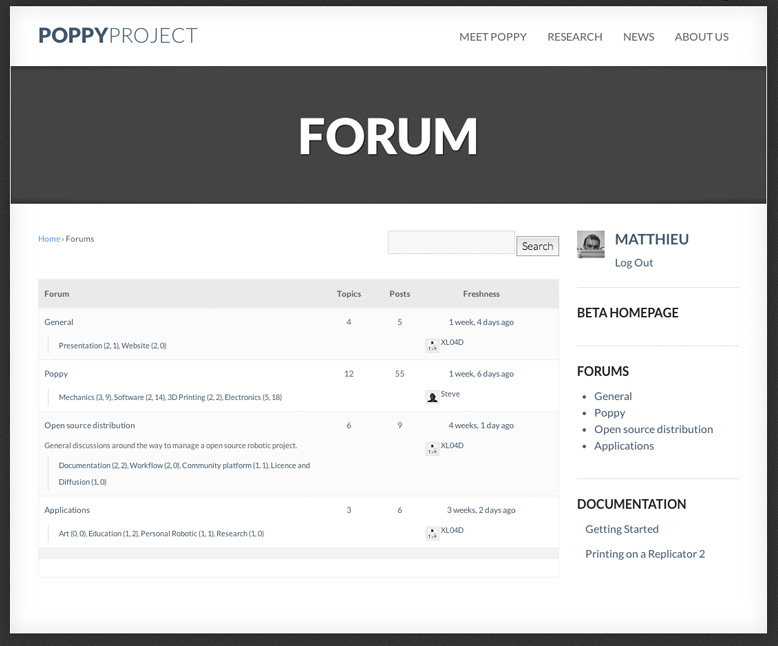
media/poppy/community/poppy_forum_bbpress.jpg
