matthieu-lapeyre/phd_thesis/media/poppy/community/poppy_forum_discourse.jpg

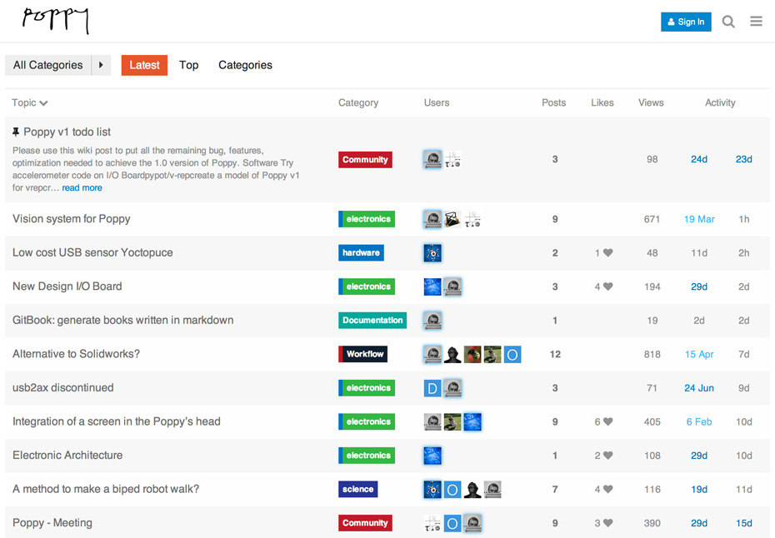
media/poppy/community/poppy_forum_discourse.jpg
