matthieu-lapeyre/phd_thesis/media/poppy/conception/basic_leg_section.jpg

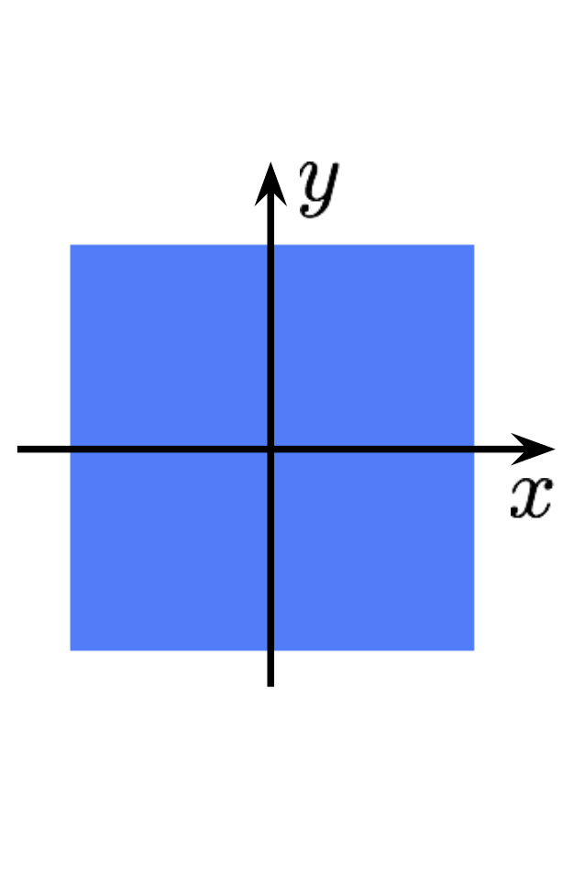
media/poppy/conception/basic_leg_section.jpg
