matthieu-lapeyre/phd_thesis/media/poppy/conception/first_poppy_clay.jpg

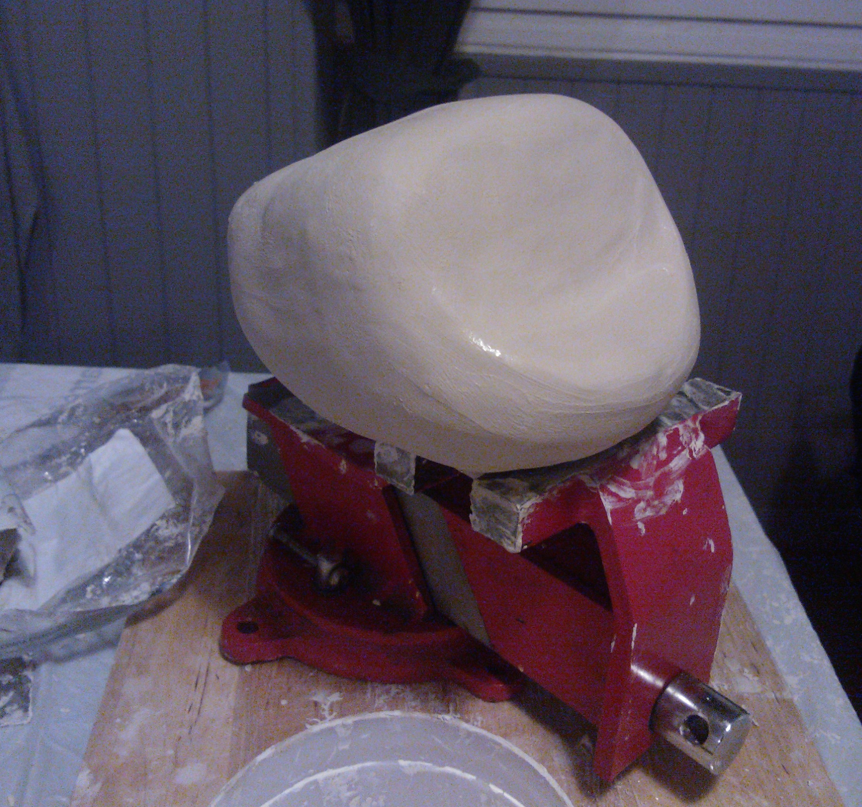
media/poppy/conception/first_poppy_clay.jpg
