matthieu-lapeyre/phd_thesis/media/poppy/conception/first_sketch.jpg

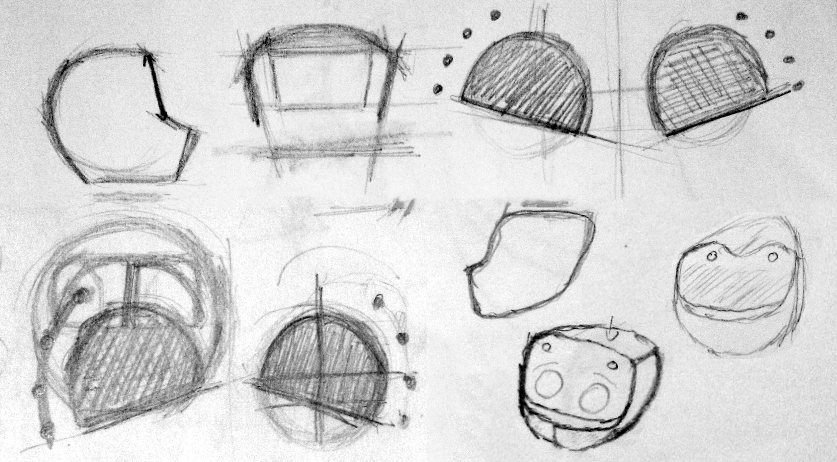
media/poppy/conception/first_sketch.jpg
