matthieu-lapeyre/phd_thesis/media/poppy/conception/head_beta.JPG

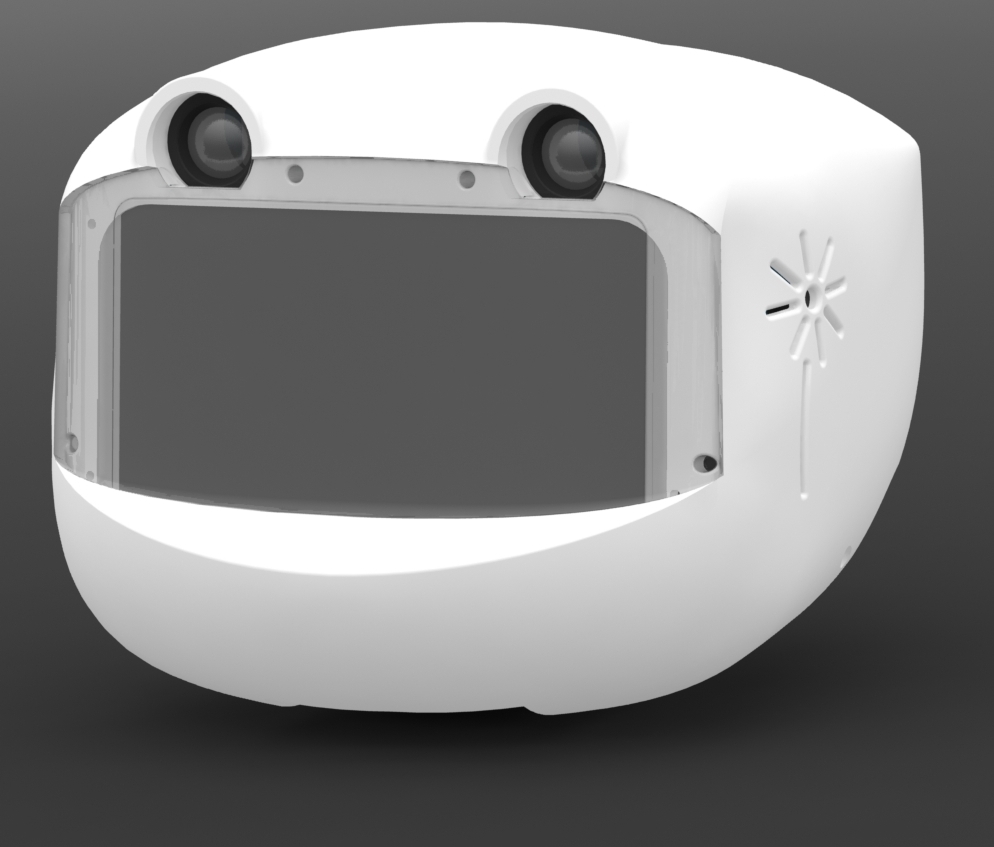
media/poppy/conception/head_beta.JPG
