matthieu-lapeyre/phd_thesis/media/poppy/conception/head_first_trial.jpg

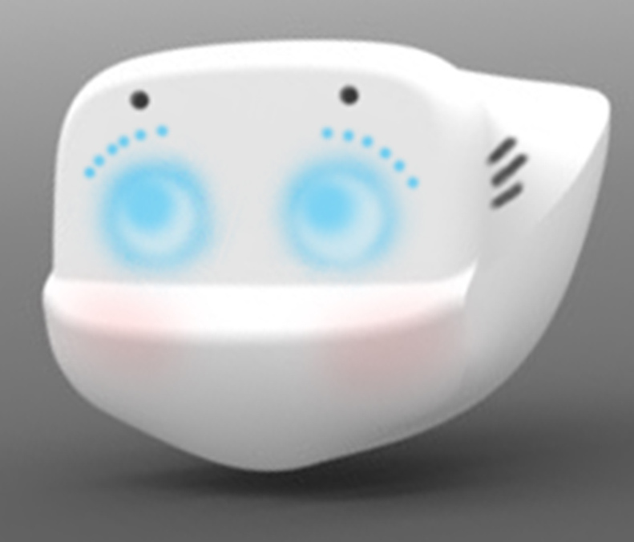
media/poppy/conception/head_first_trial.jpg
