matthieu-lapeyre/phd_thesis/media/poppy/conception/human_foot_lateral.png

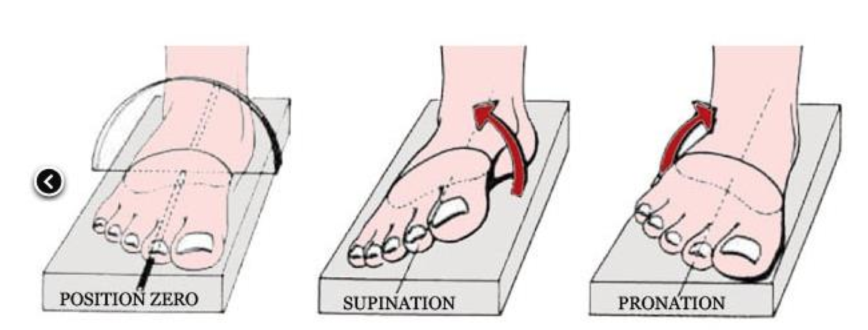
media/poppy/conception/human_foot_lateral.png
