matthieu-lapeyre/phd_thesis/media/poppy/conception/human_foot_sagittal.png

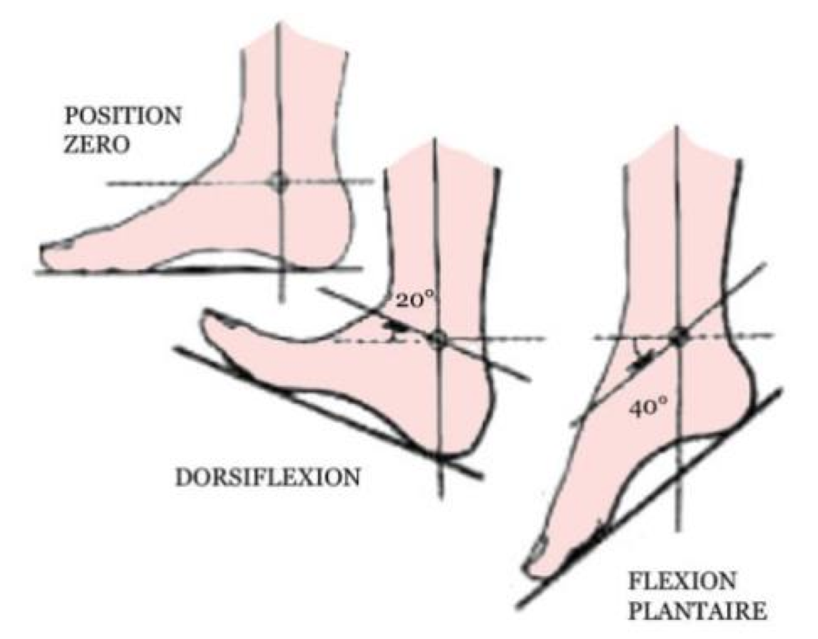
media/poppy/conception/human_foot_sagittal.png
