matthieu-lapeyre/phd_thesis/media/poppy/conception/human_trunk.jpg

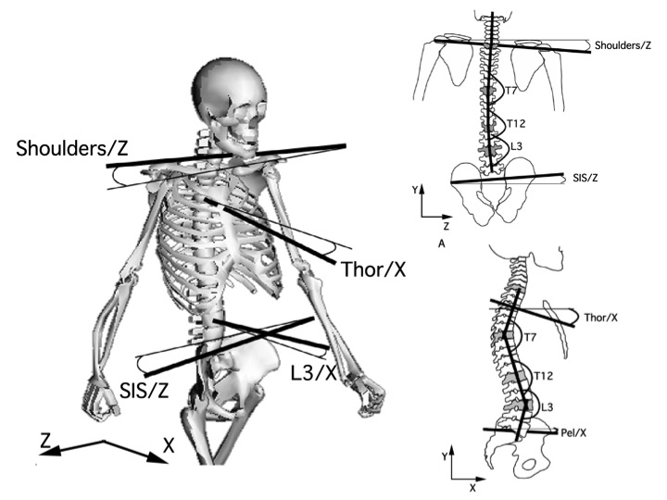
media/poppy/conception/human_trunk.jpg
