matthieu-lapeyre/phd_thesis/media/poppy/conception/io_board.jpg

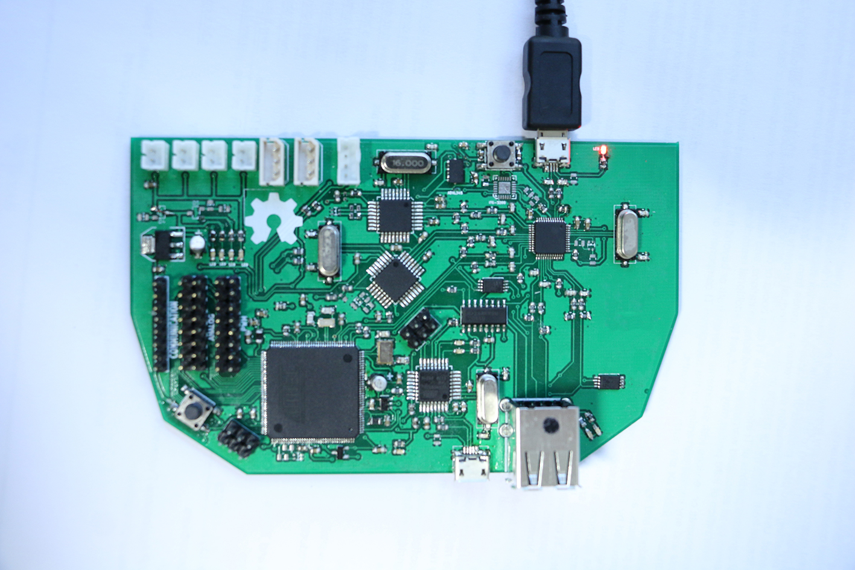
media/poppy/conception/io_board.jpg
