matthieu-lapeyre/phd_thesis/media/poppy/conception/io_board_simplify.jpg

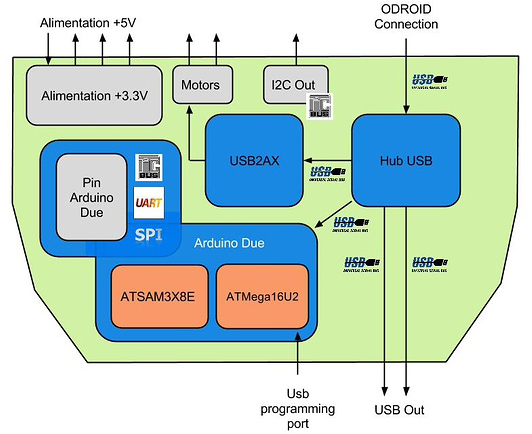
media/poppy/conception/io_board_simplify.jpg
