matthieu-lapeyre/phd_thesis/media/poppy/conception/knee_spring.jpg

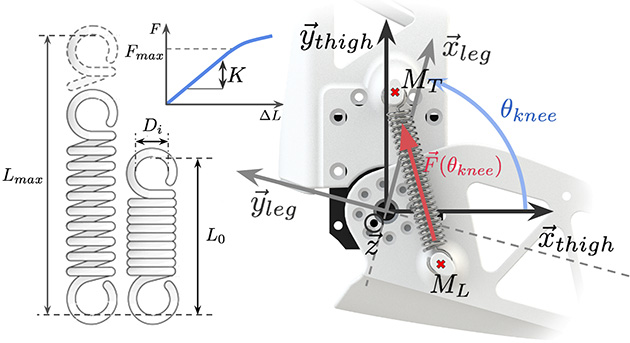
media/poppy/conception/knee_spring.jpg
