matthieu-lapeyre/phd_thesis/media/poppy/conception/knee_wout_spring.png

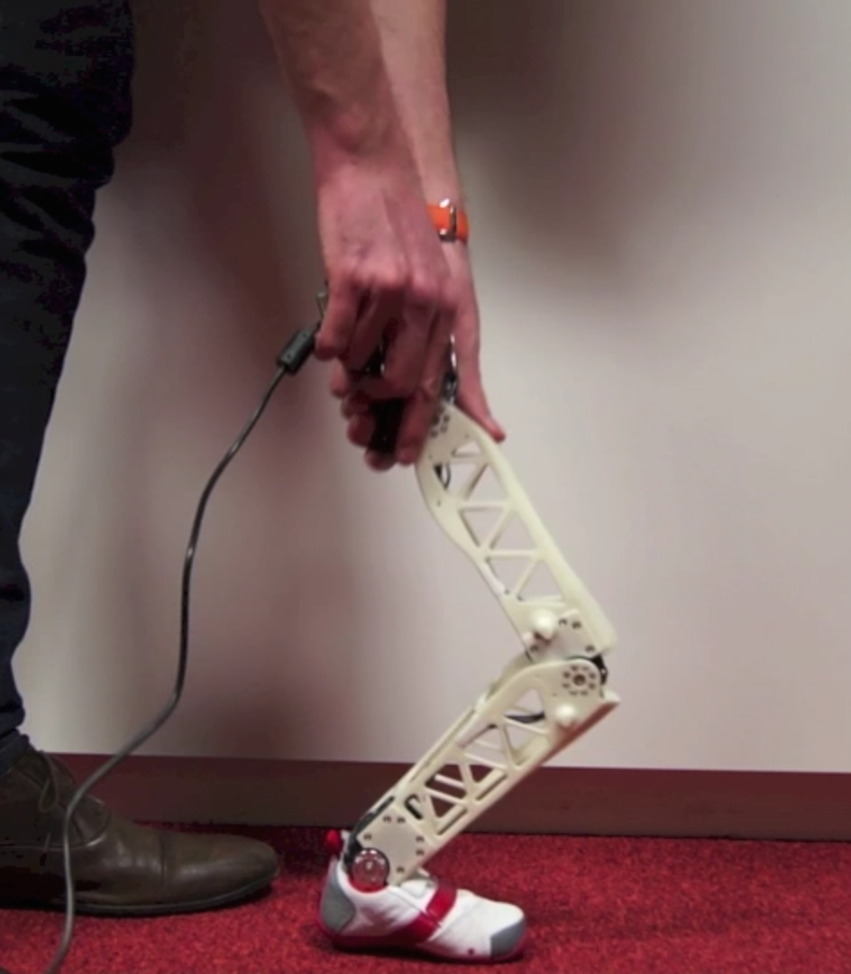
media/poppy/conception/knee_wout_spring.png
