matthieu-lapeyre/phd_thesis/media/poppy/conception/manga-screen.png

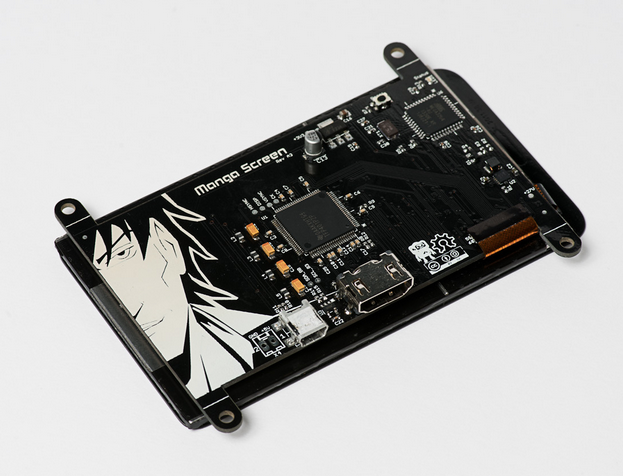
media/poppy/conception/manga-screen.png
