matthieu-lapeyre/phd_thesis/media/poppy/conception/poppy_beta_eyes.jpg

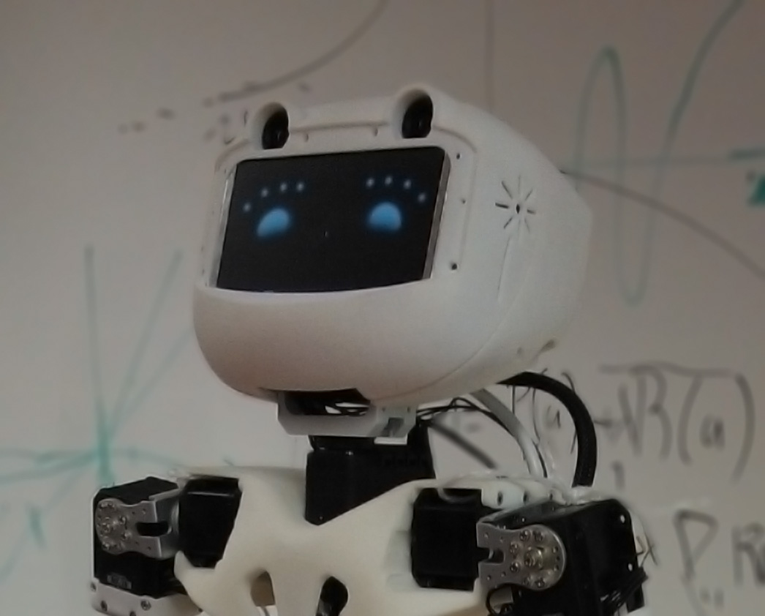
media/poppy/conception/poppy_beta_eyes.jpg
