matthieu-lapeyre/phd_thesis/media/poppy/conception/poppy_head_sketch.jpg

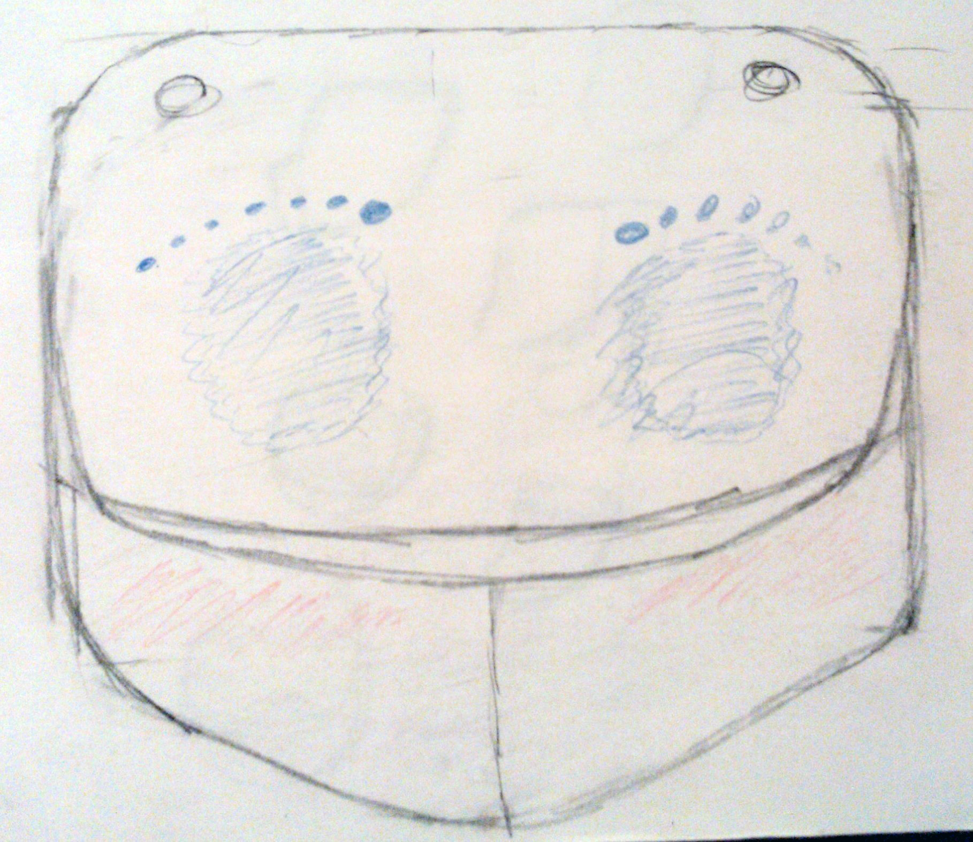
media/poppy/conception/poppy_head_sketch.jpg
