matthieu-lapeyre/phd_thesis/media/poppy/conception/Poppy_leg_section.jpg

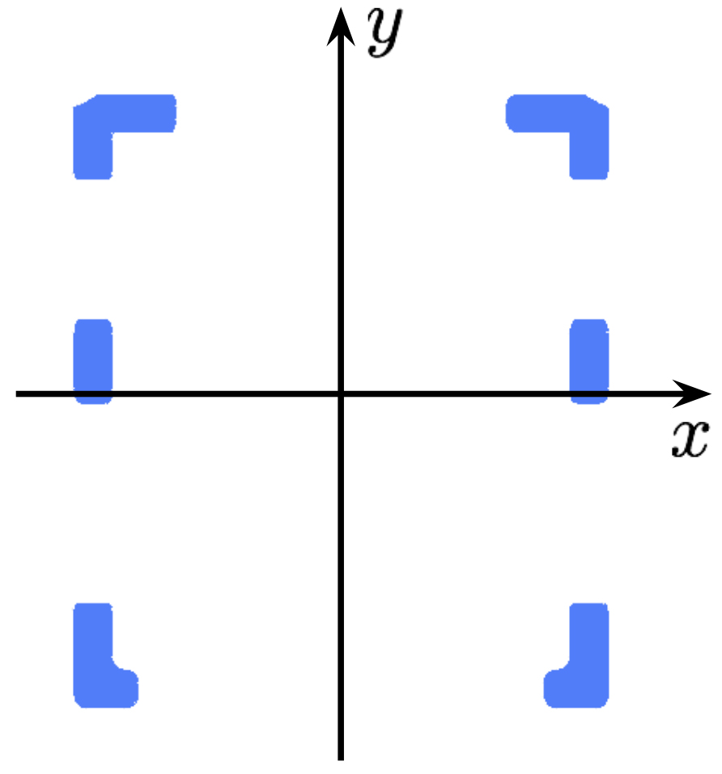
media/poppy/conception/Poppy_leg_section.jpg
