matthieu-lapeyre/phd_thesis/media/poppy/conception/poppy_screen.jpg

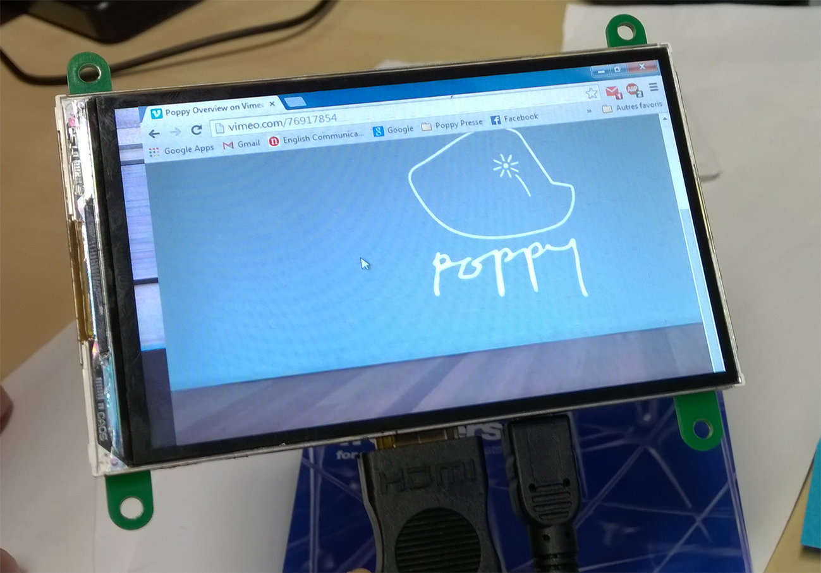
media/poppy/conception/poppy_screen.jpg
