matthieu-lapeyre/phd_thesis/media/poppy/conception/poppy_v1_head.JPG

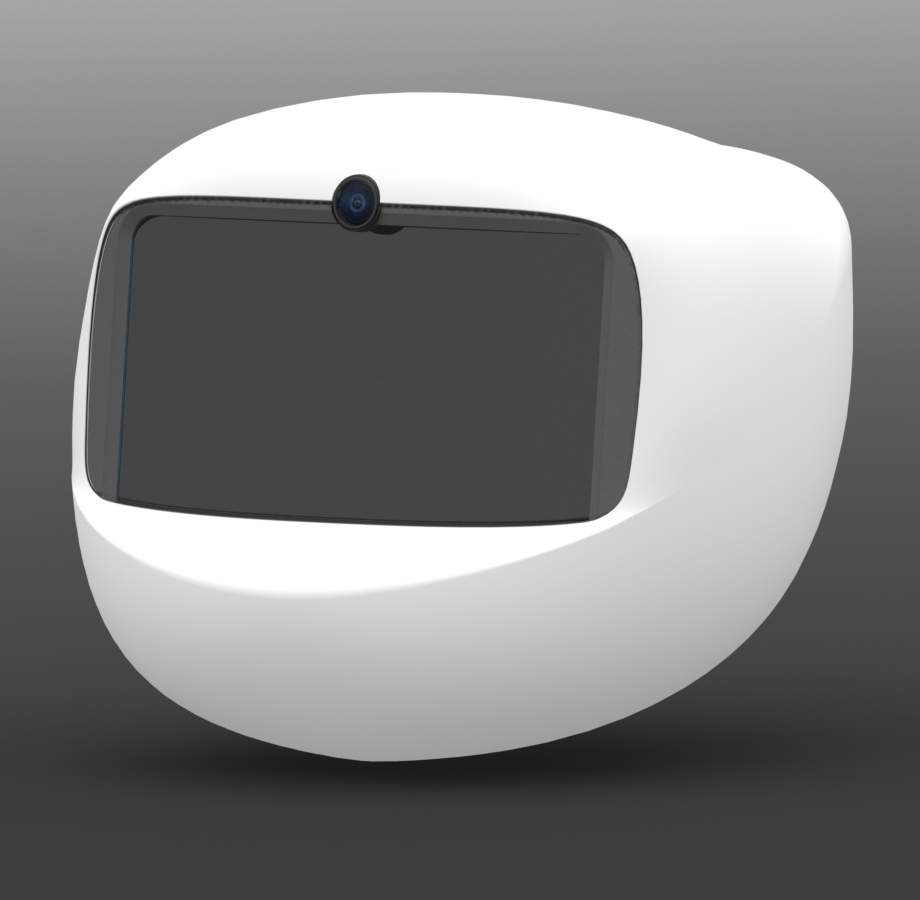
media/poppy/conception/poppy_v1_head.JPG
