matthieu-lapeyre/phd_thesis/media/poppy/conception/proportion_poppy.jpg

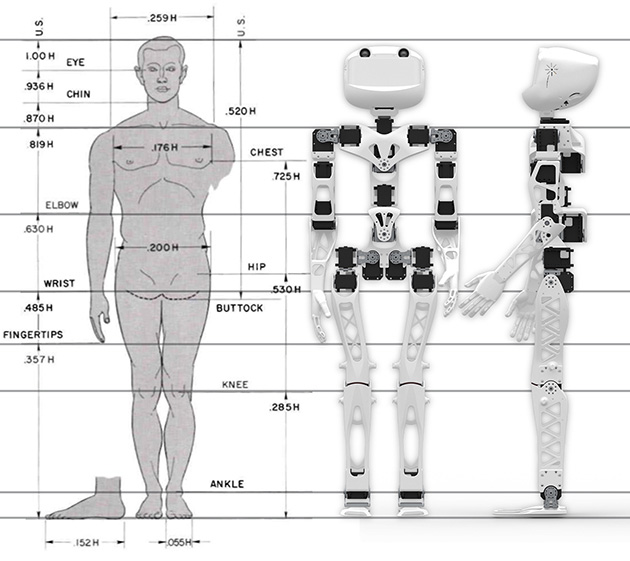
media/poppy/conception/proportion_poppy.jpg
