matthieu-lapeyre/phd_thesis/media/poppy/conception/torque_knee.png

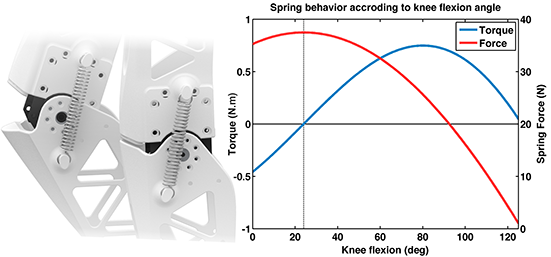
media/poppy/conception/torque_knee.png
