matthieu-lapeyre/phd_thesis/media/poppy/conception/truss_bridges.jpg

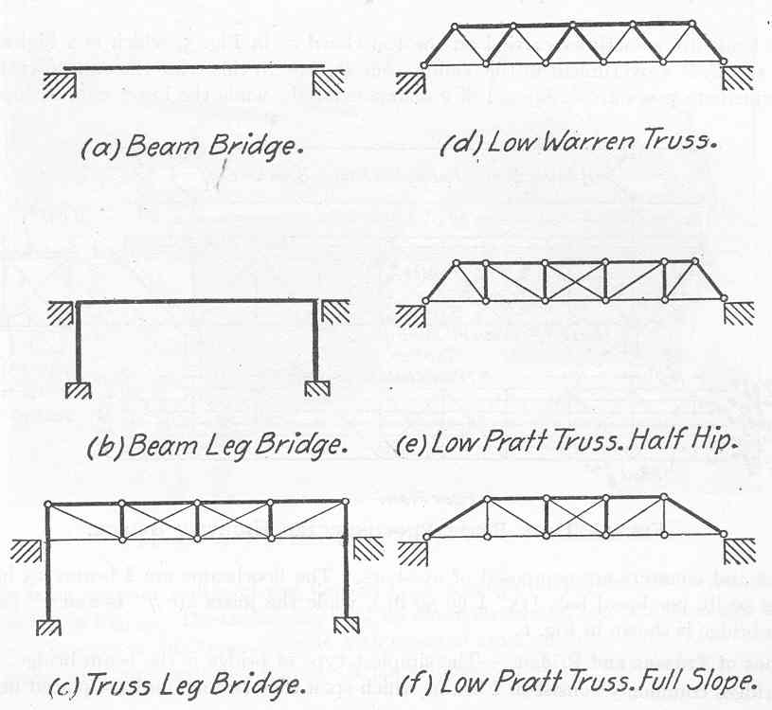
media/poppy/conception/truss_bridges.jpg
