matthieu-lapeyre/phd_thesis/media/poppy/conception/tyva_batteries.png

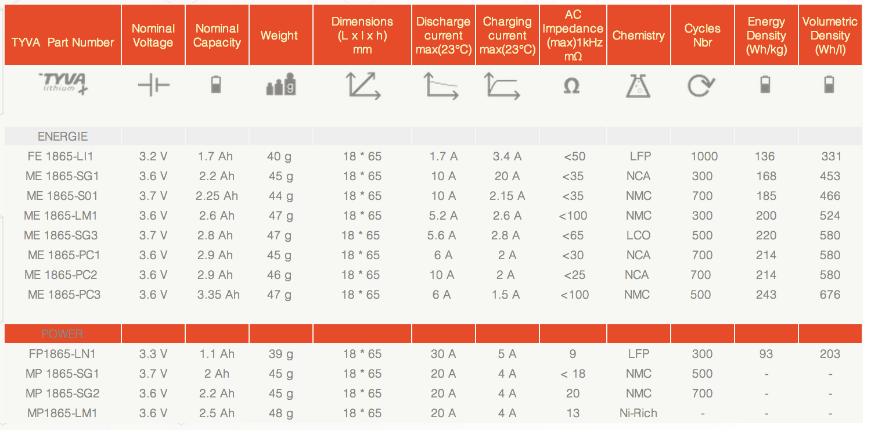
media/poppy/conception/tyva_batteries.png
