matthieu-lapeyre/phd_thesis/media/poppy/conception/tyva_battery_pack.jpg

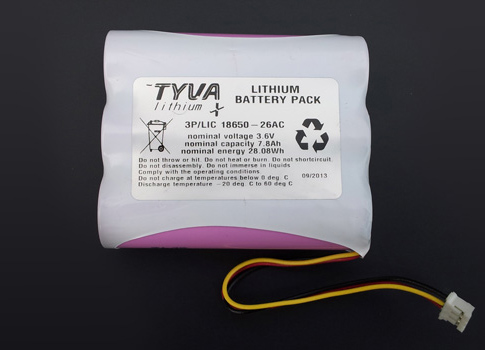
media/poppy/conception/tyva_battery_pack.jpg
