matthieu-lapeyre/phd_thesis/media/poppy/conception/usb2ax.jpg

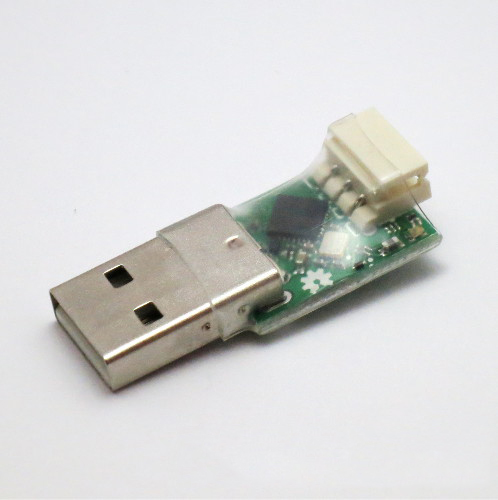
media/poppy/conception/usb2ax.jpg
