matthieu-lapeyre/phd_thesis/media/poppy/conception/USB2AX_vs_USB2Dxl.jpg

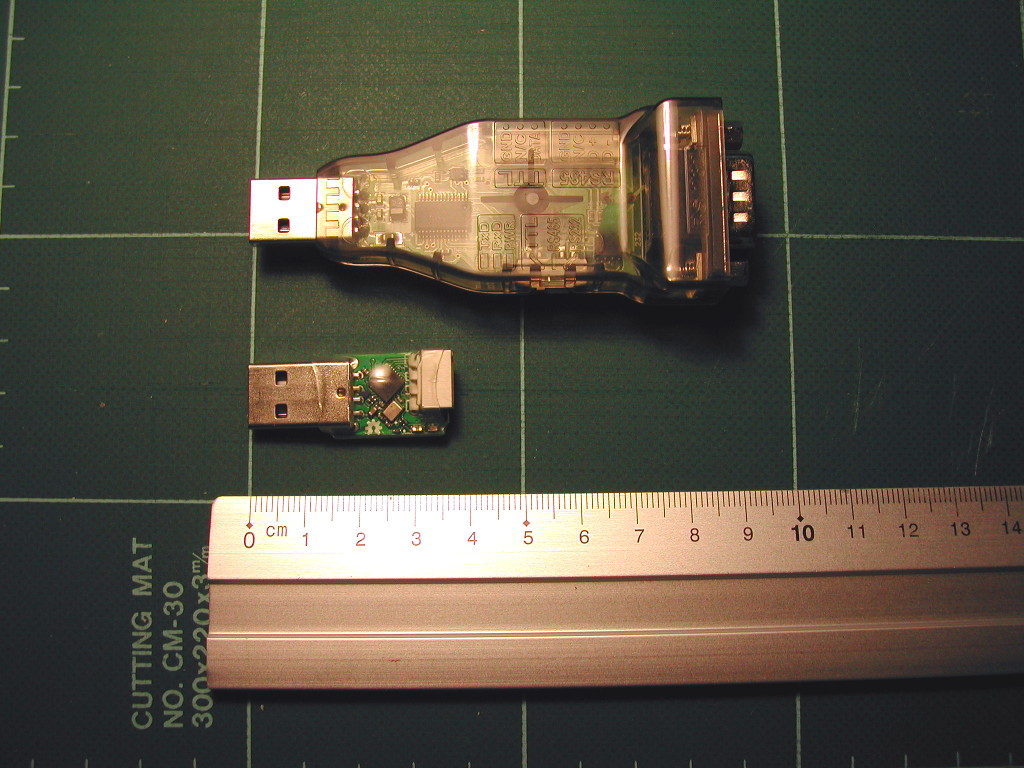
media/poppy/conception/USB2AX_vs_USB2Dxl.jpg
