matthieu-lapeyre/phd_thesis/media/poppy/conception/virtuous_circle.png

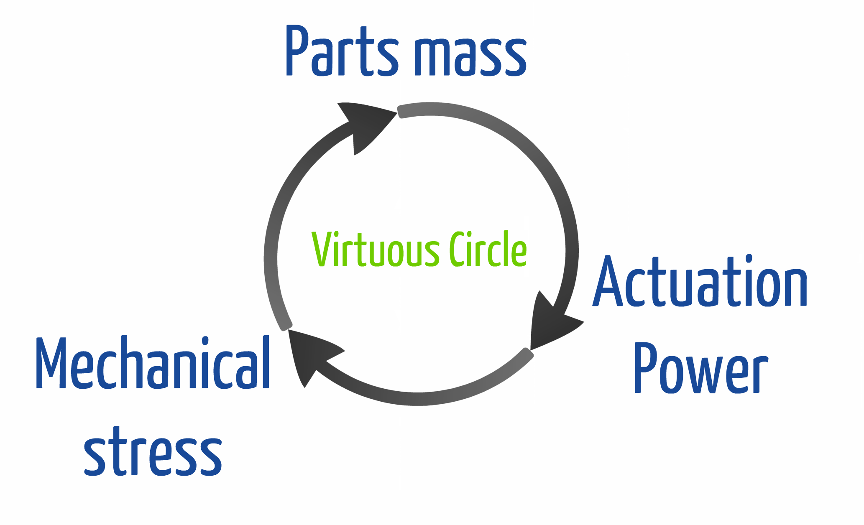
media/poppy/conception/virtuous_circle.png
