matthieu-lapeyre/phd_thesis/media/poppy/lapeyre_and_poppy.jpg

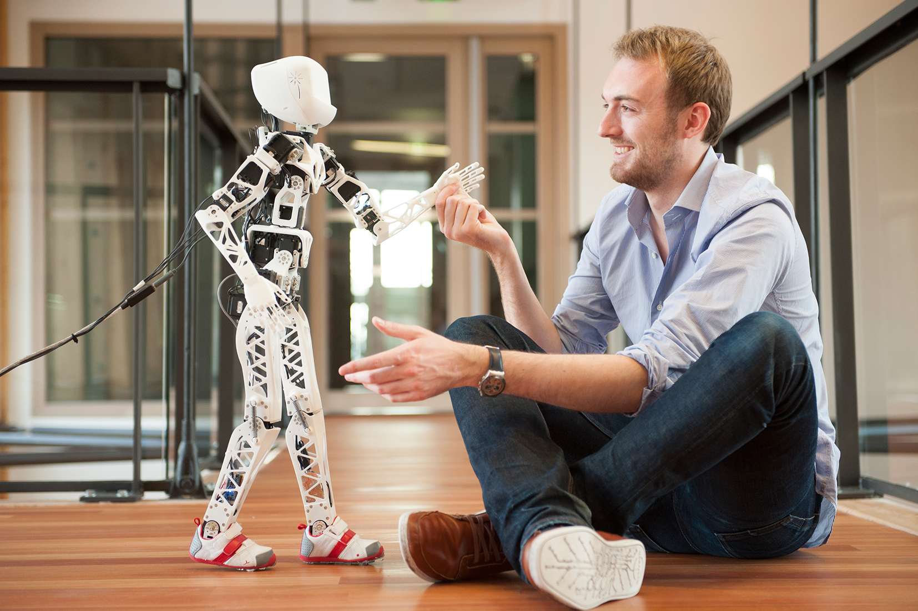
media/poppy/lapeyre_and_poppy.jpg
