matthieu-lapeyre/phd_thesis/media/poppy/pypot/ergo-robot-stem.jpg

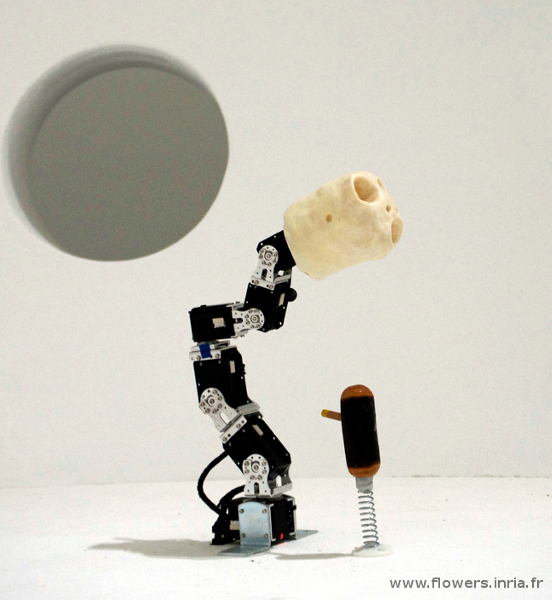
media/poppy/pypot/ergo-robot-stem.jpg
