matthieu-lapeyre/phd_thesis/media/poppy/pypot/ergo-robot.jpg

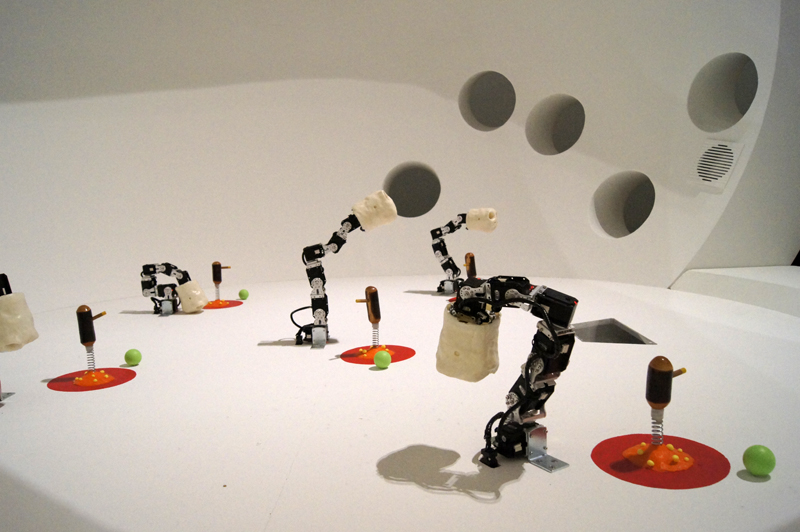
media/poppy/pypot/ergo-robot.jpg
