matthieu-lapeyre/phd_thesis/media/poppy/pypot/pypot_vrep.jpg

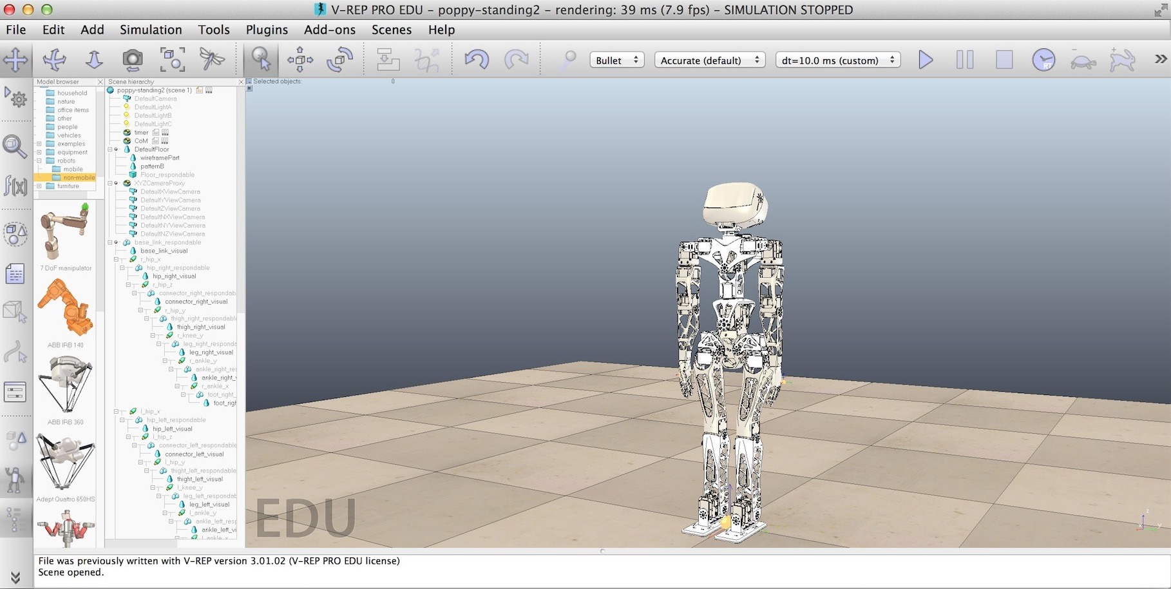
media/poppy/pypot/pypot_vrep.jpg
