matthieu-lapeyre/phd_thesis/media/related_work/3D_printing/nice_leg_prothesis.jpg

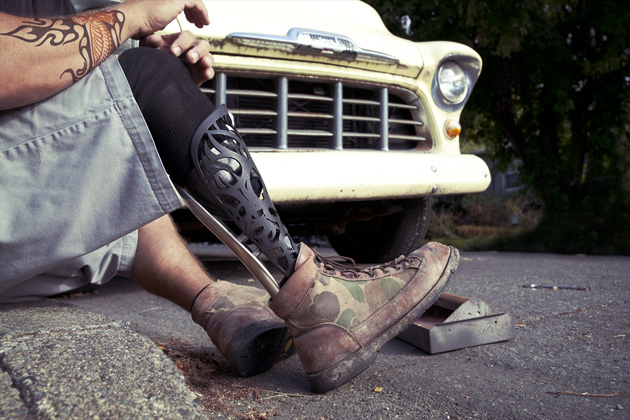
media/related_work/3D_printing/nice_leg_prothesis.jpg
