matthieu-lapeyre/phd_thesis/media/related_work/morphology/airfoil_bernouilli.png

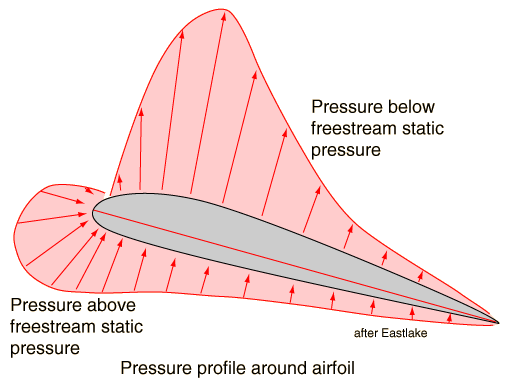
media/related_work/morphology/airfoil_bernouilli.png
