matthieu-lapeyre/phd_thesis/media/related_work/morphology/bernoulli_wing_lift.png

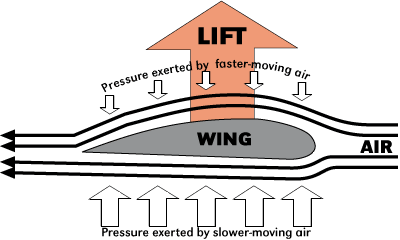
media/related_work/morphology/bernoulli_wing_lift.png
