matthieu-lapeyre/phd_thesis/media/related_work/morphology/cornell_biped_series.JPG

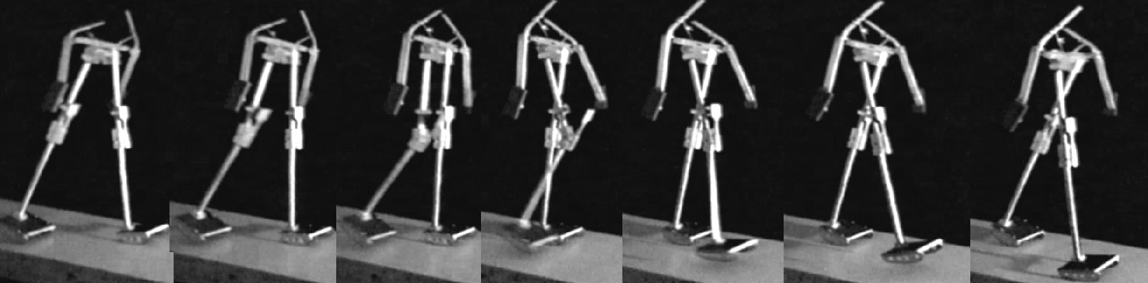
media/related_work/morphology/cornell_biped_series.JPG
