matthieu-lapeyre/phd_thesis/media/related_work/morphology/curta_calculator.jpg

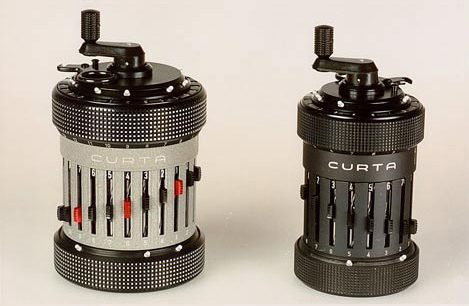
media/related_work/morphology/curta_calculator.jpg
