matthieu-lapeyre/phd_thesis/media/related_work/morphology/mcgeer_walker.jpg

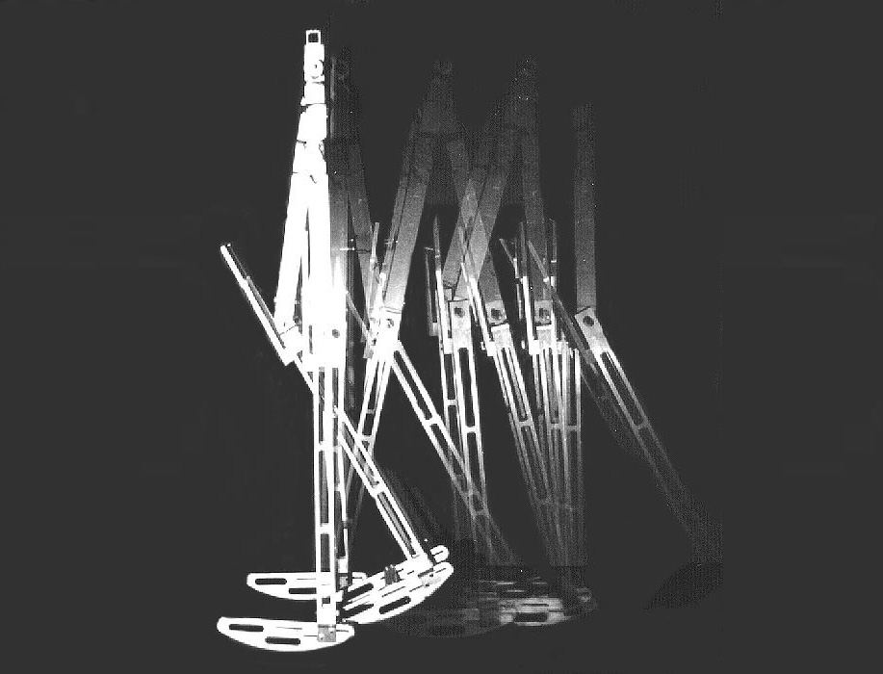
media/related_work/morphology/mcgeer_walker.jpg
