matthieu-lapeyre/phd_thesis/media/related_work/morphology/passive_walkers.jpg

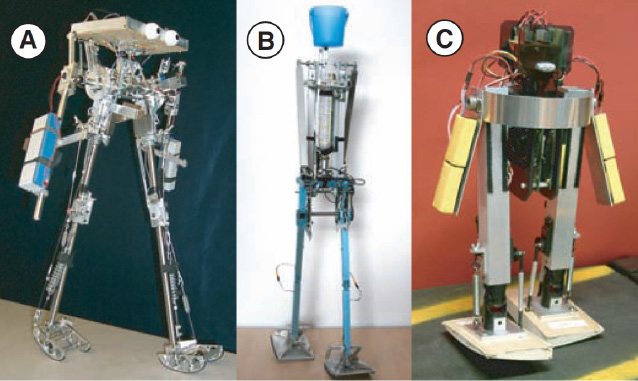
media/related_work/morphology/passive_walkers.jpg
