matthieu-lapeyre/phd_thesis/media/related_work/morphology/plane_explanation.jpg

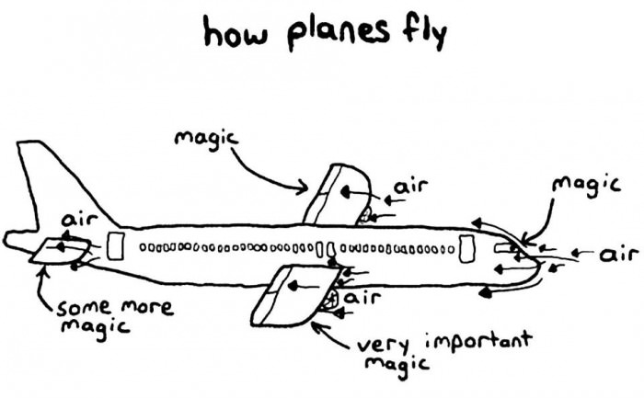
media/related_work/morphology/plane_explanation.jpg
