matthieu-lapeyre/phd_thesis/media/related_work/morphology/raptor-robot.jpg

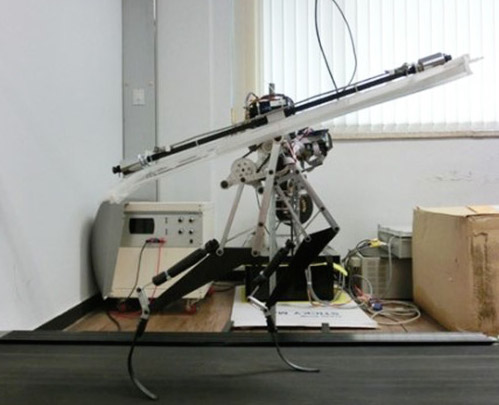
media/related_work/morphology/raptor-robot.jpg
