matthieu-lapeyre/phd_thesis/media/related_work/morphology/rhex.jpg

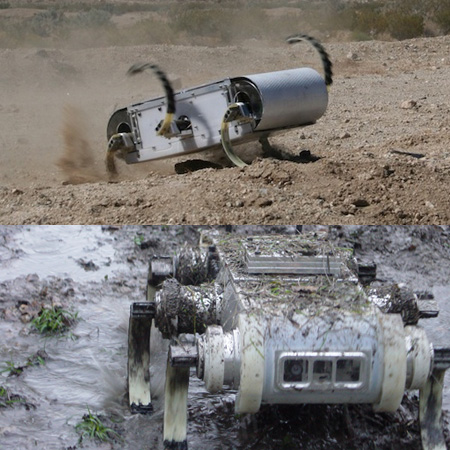
media/related_work/morphology/rhex.jpg
