matthieu-lapeyre/phd_thesis/media/related_work/morphology/simple_leg_wheel.jpg

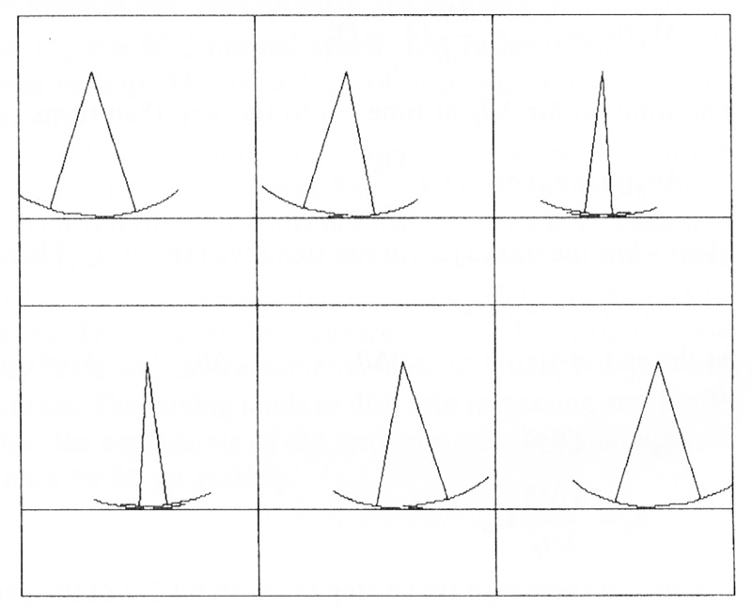
media/related_work/morphology/simple_leg_wheel.jpg
