matthieu-lapeyre/phd_thesis/media/related_work/morphology/simple_leg_wheel_trajectories.jpg

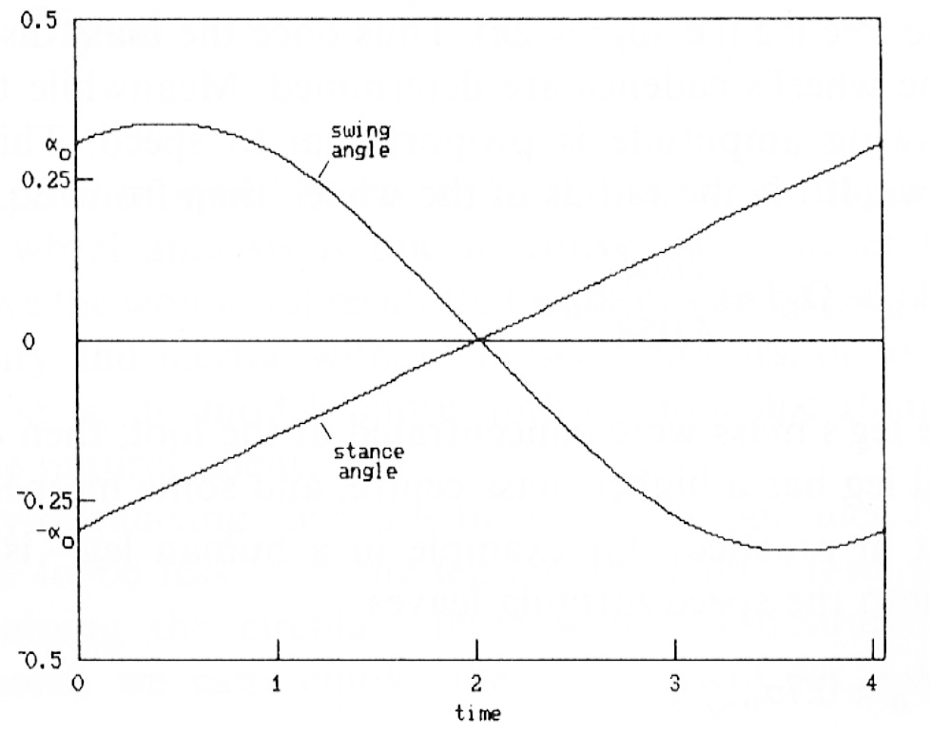
media/related_work/morphology/simple_leg_wheel_trajectories.jpg
