matthieu-lapeyre/phd_thesis/media/related_work/morphology/strandbeest_leg_element.jpg

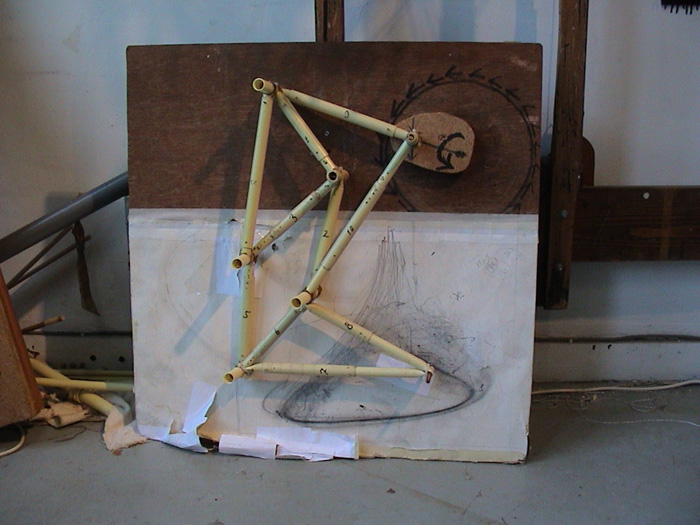
media/related_work/morphology/strandbeest_leg_element.jpg
