matthieu-lapeyre/phd_thesis/media/related_work/morphology/strandbeest_motion.jpg

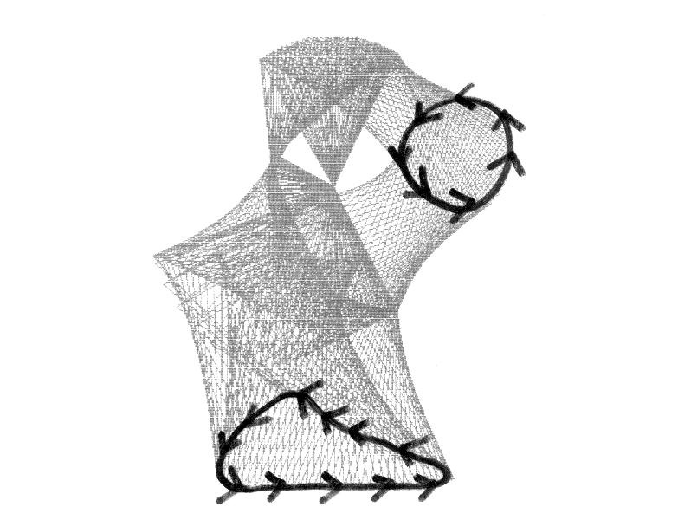
media/related_work/morphology/strandbeest_motion.jpg
