matthieu-lapeyre/phd_thesis/media/related_work/morphology/strandbeest_motion_pictures.jpg

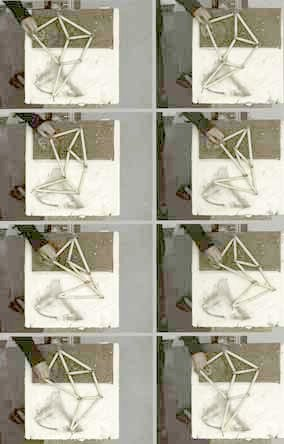
media/related_work/morphology/strandbeest_motion_pictures.jpg
