matthieu-lapeyre/phd_thesis/media/related_work/morphology/strandbeest_theory.jpg

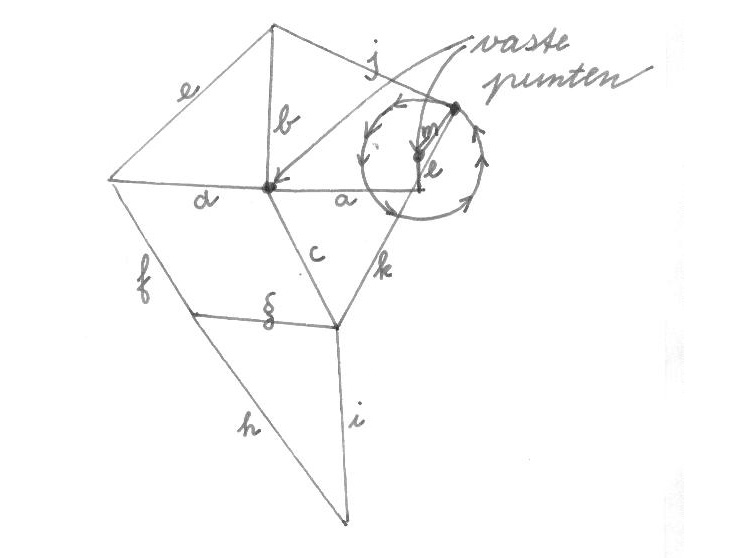
media/related_work/morphology/strandbeest_theory.jpg
