matthieu-lapeyre/phd_thesis/media/related_work/morphology/tad_mcgeer.jpg

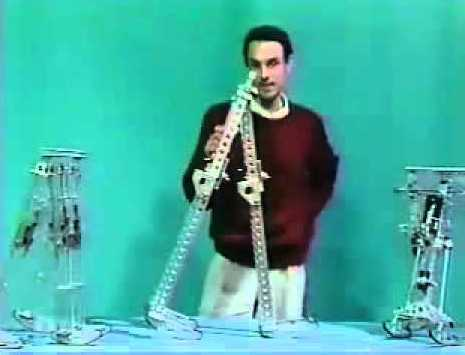
media/related_work/morphology/tad_mcgeer.jpg
