matthieu-lapeyre/phd_thesis/media/related_work/morphology/theo_jansen_beast.jpg

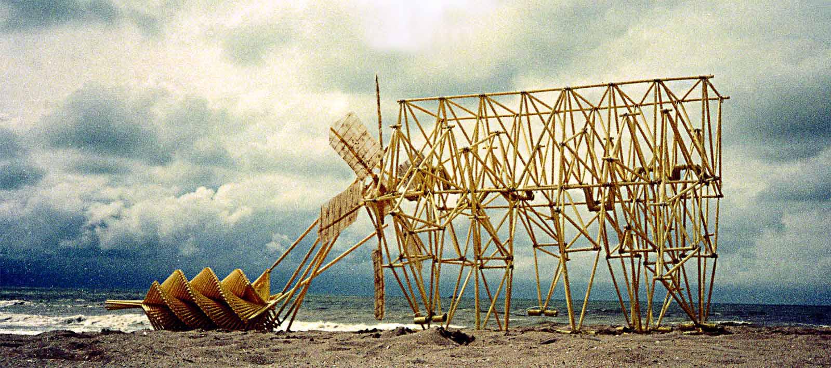
media/related_work/morphology/theo_jansen_beast.jpg
