matthieu-lapeyre/phd_thesis/media/related_work/morphology/turtoise_behavior.jpg

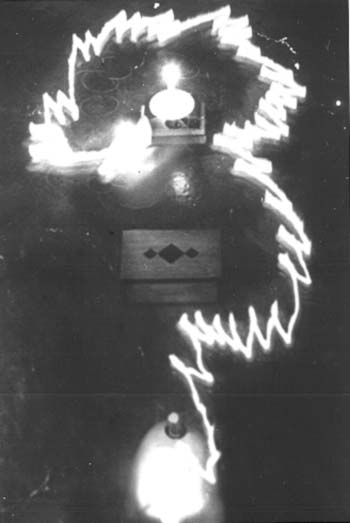
media/related_work/morphology/turtoise_behavior.jpg
