matthieu-lapeyre/phd_thesis/media/related_work/morphology/walter_turtoise_robot.jpg

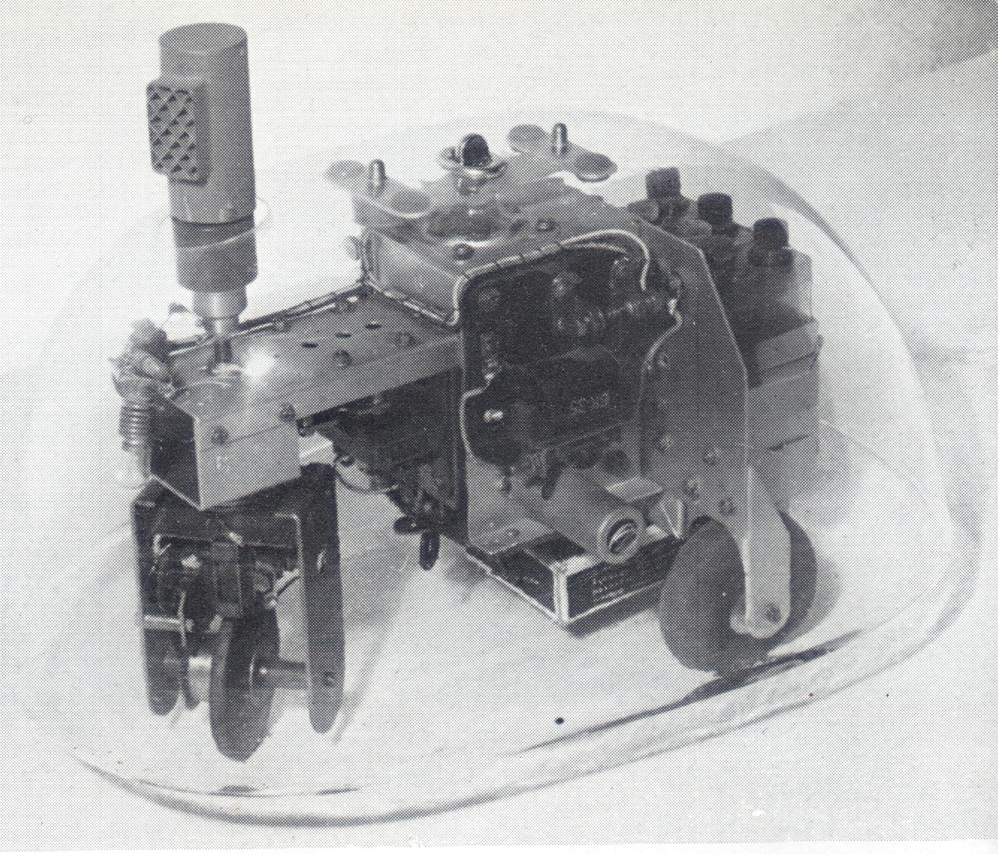
media/related_work/morphology/walter_turtoise_robot.jpg
