matthieu-lapeyre/phd_thesis/media/related_work/robotic_platforms/darwin_op_face.jpg

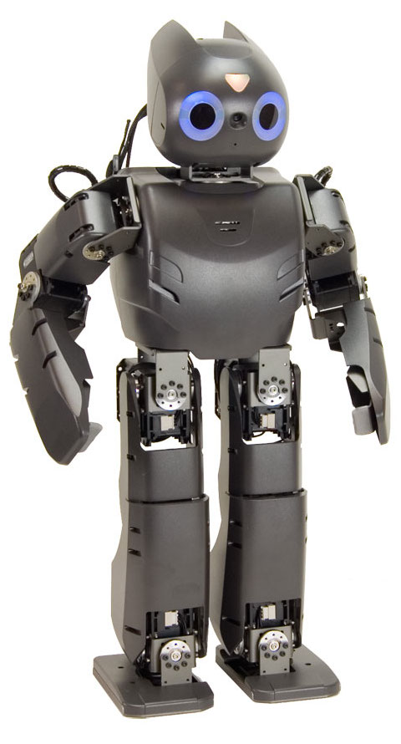
media/related_work/robotic_platforms/darwin_op_face.jpg
