matthieu-lapeyre/phd_thesis/media/related_work/robotic_platforms/denise.jpg

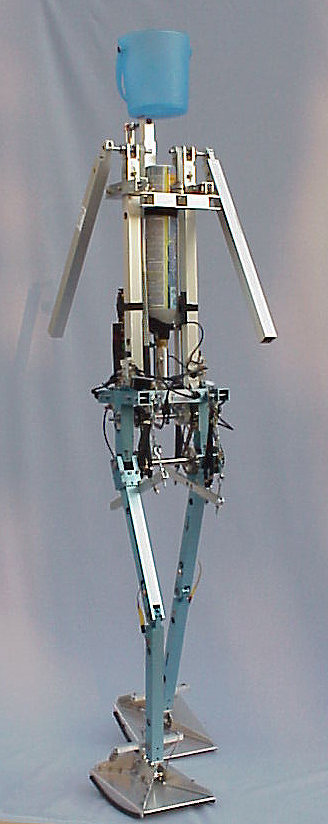
media/related_work/robotic_platforms/denise.jpg
