matthieu-lapeyre/phd_thesis/media/related_work/robotic_platforms/eccerobot.jpg

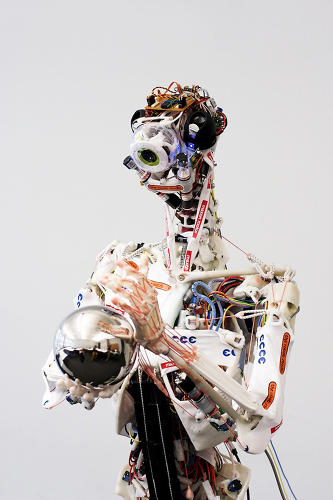
media/related_work/robotic_platforms/eccerobot.jpg
