matthieu-lapeyre/phd_thesis/media/related_work/robotic_platforms/flame.jpg

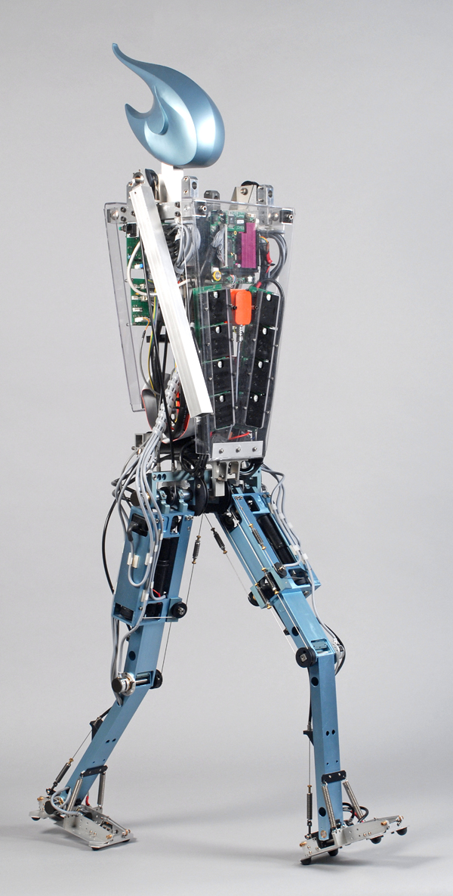
media/related_work/robotic_platforms/flame.jpg
