matthieu-lapeyre/phd_thesis/media/related_work/robotic_platforms/locokit-example.png

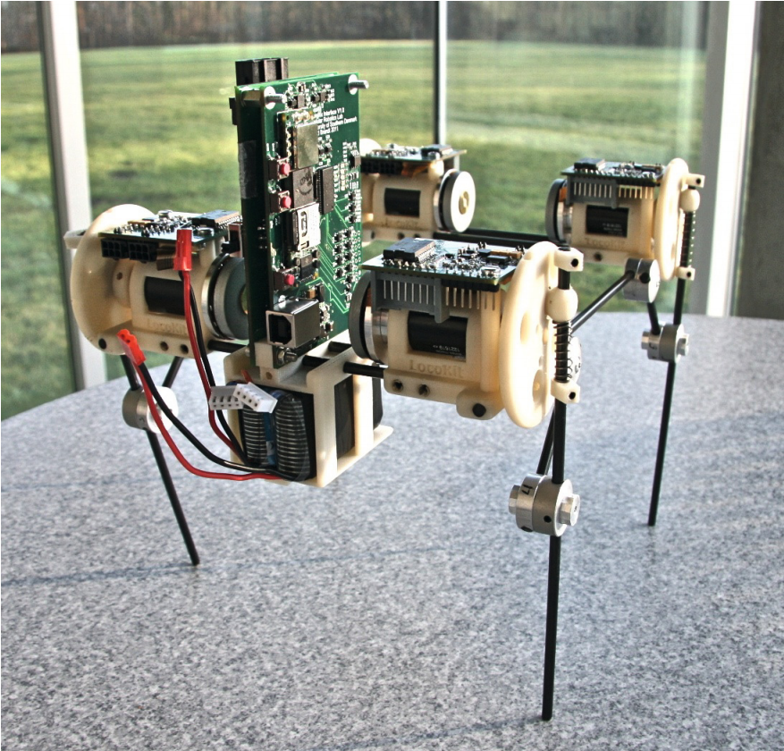
media/related_work/robotic_platforms/locokit-example.png
