matthieu-lapeyre/phd_thesis/media/related_work/robotic_platforms/nao_face.png

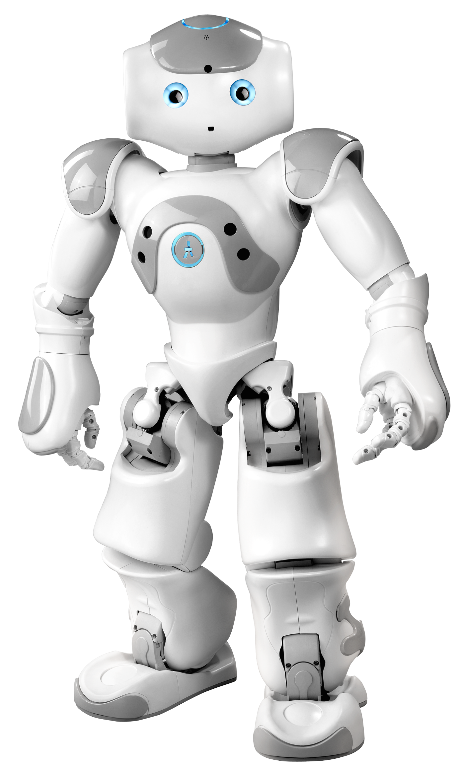
media/related_work/robotic_platforms/nao_face.png
