matthieu-lapeyre/phd_thesis/media/related_work/robotic_platforms/nimbro-op_1.jpg

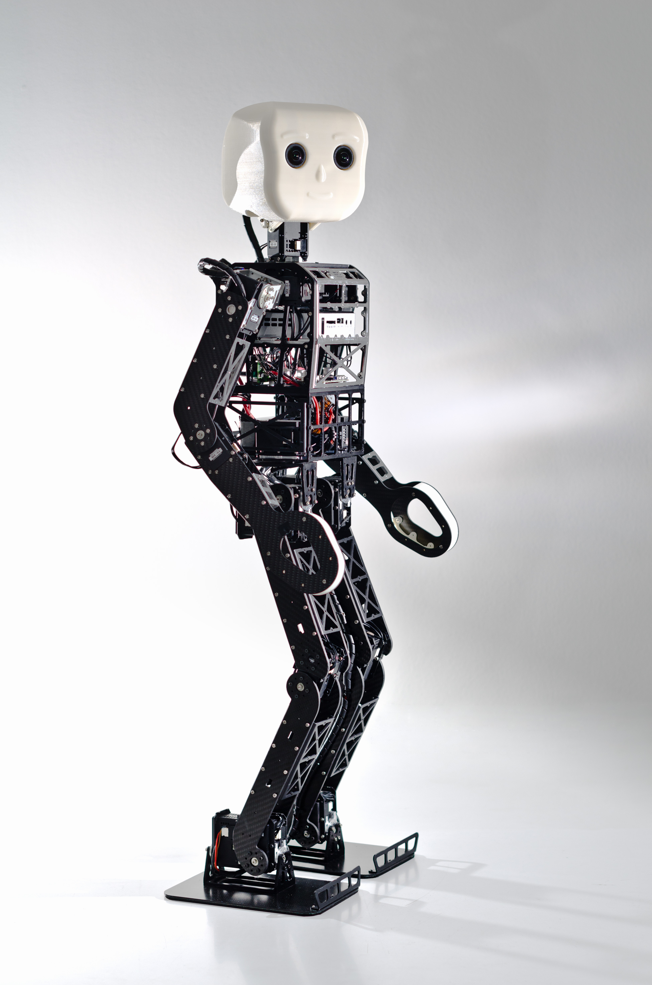
media/related_work/robotic_platforms/nimbro-op_1.jpg
