matthieu-lapeyre/phd_thesis/media/related_work/robotic_platforms/roombots.jpg

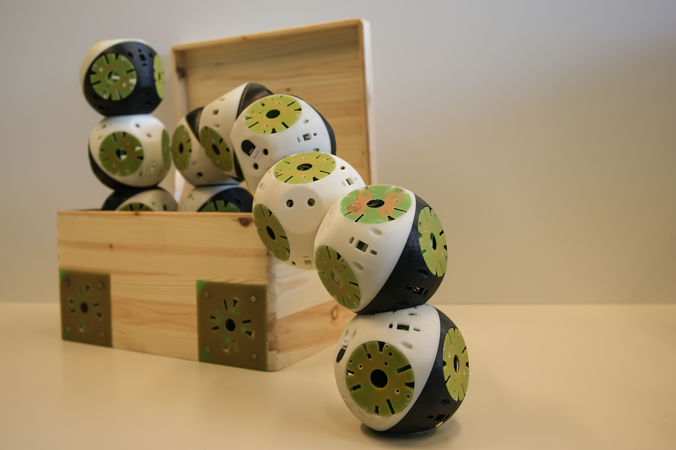
media/related_work/robotic_platforms/roombots.jpg
