matthieu-lapeyre/phd_thesis/media/related_work/robotic_platforms/SEA_basic_principle.png

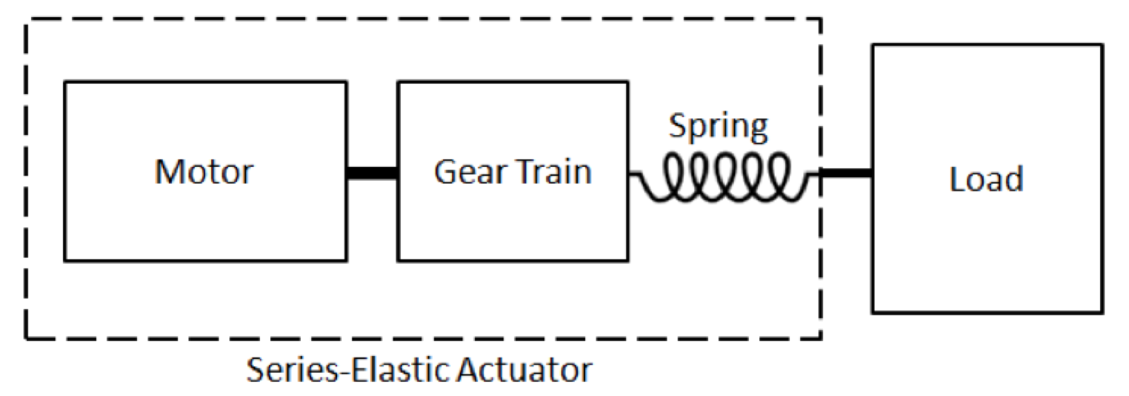
media/related_work/robotic_platforms/SEA_basic_principle.png
