matthieu-lapeyre/phd_thesis/media/poppy/poppy_components.jpg

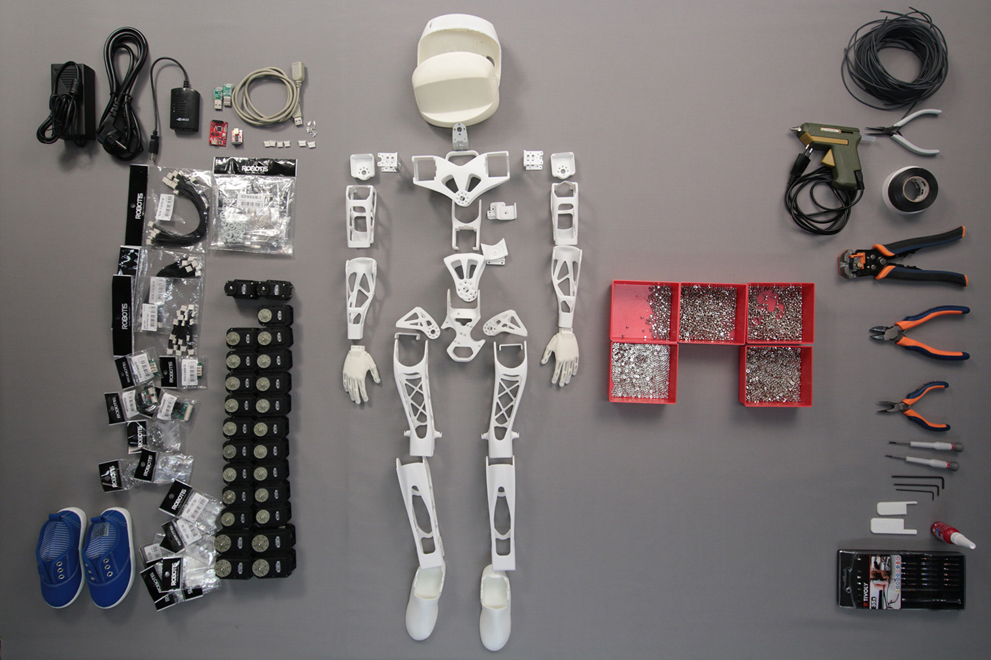
media/poppy/poppy_components.jpg
