matthieu-lapeyre/phd_thesis/media/related_work/morphology/comparison_cost_transport.jpg

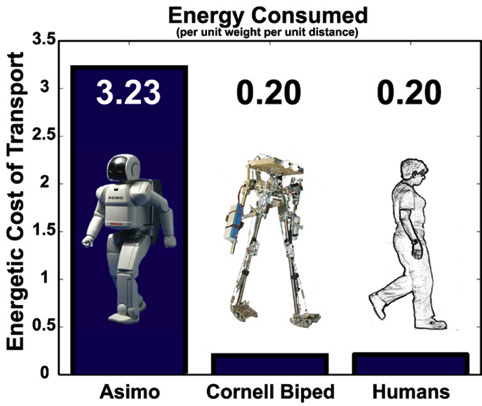
media/related_work/morphology/comparison_cost_transport.jpg
