matthieu-lapeyre/phd_thesis/media/related_work/robotic_platforms/locokit-parts.jpg

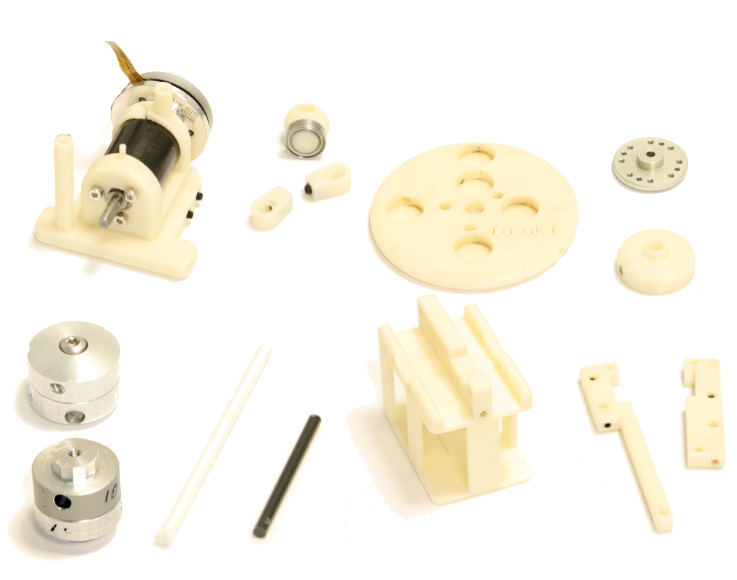
media/related_work/robotic_platforms/locokit-parts.jpg
