matthieu-lapeyre/phd_thesis/media/chapter_illustration/robot_setup.pdf

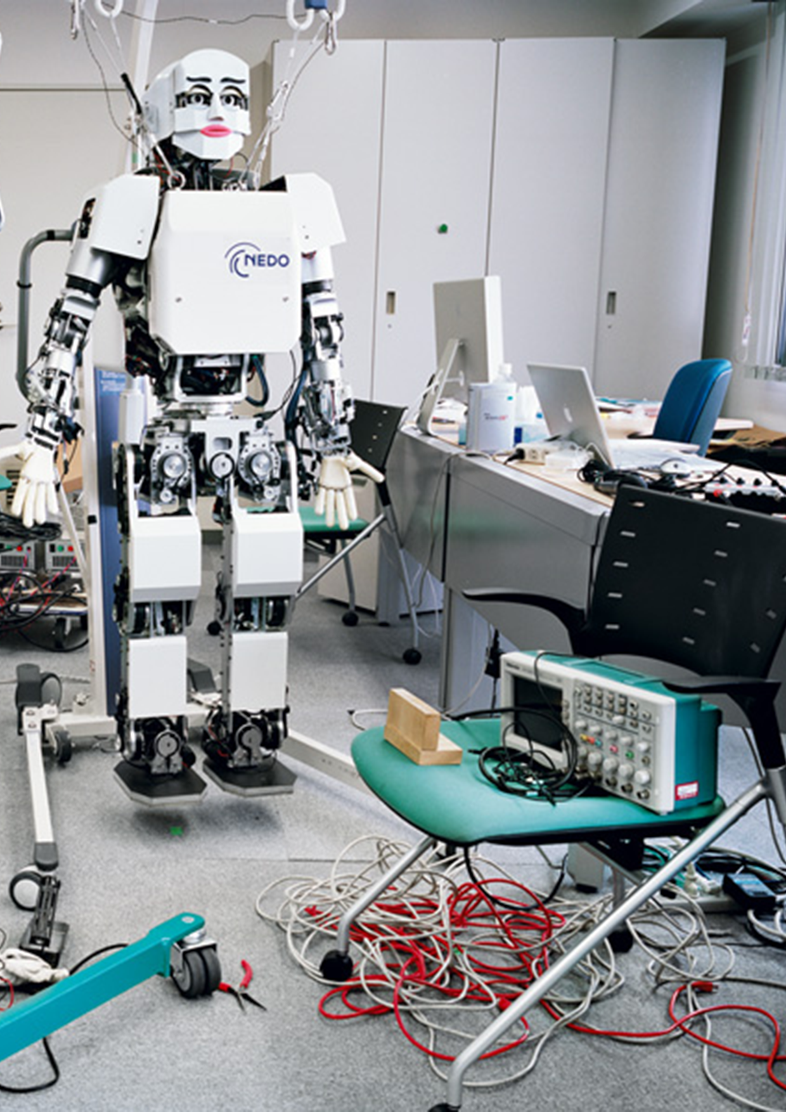
[picture p148: page 1]
