matthieu-lapeyre/phd_thesis/media/applications/hackathon/hackathon_assembly2.jpg

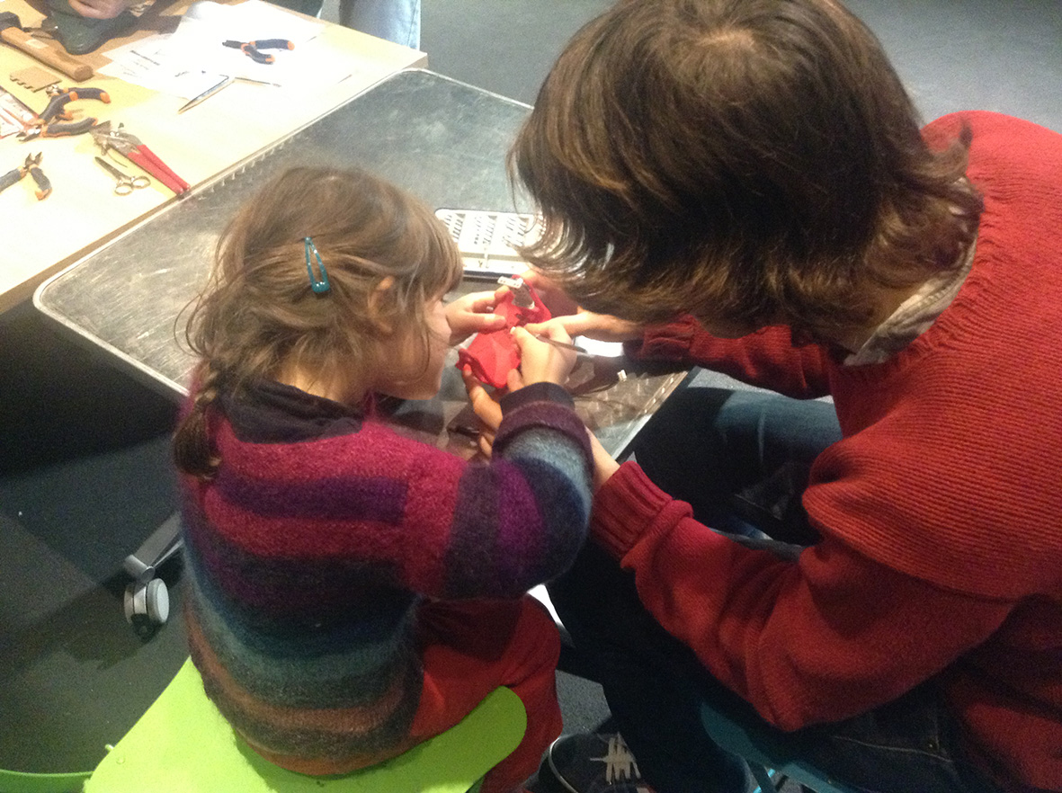
media/applications/hackathon/hackathon_assembly2.jpg
