matthieu-lapeyre/phd_thesis/media/applications/morphology/pic_setup.jpg

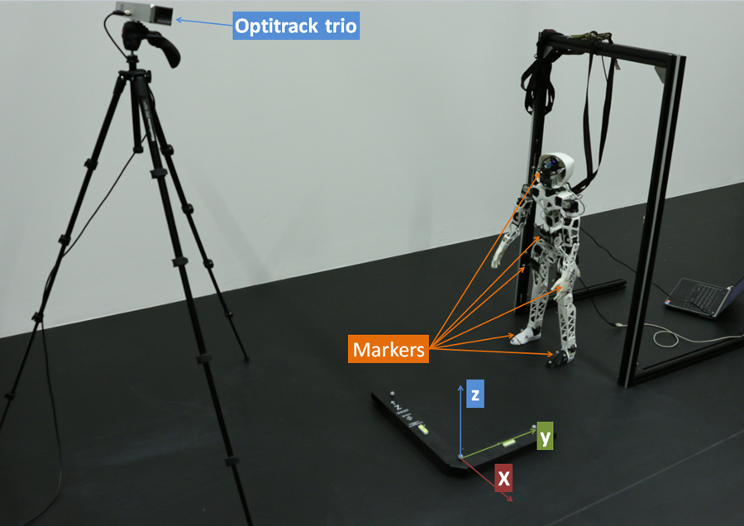
media/applications/morphology/pic_setup.jpg
