matthieu-lapeyre/phd_thesis/media/open_hardware/makerbot-replicator.jpg

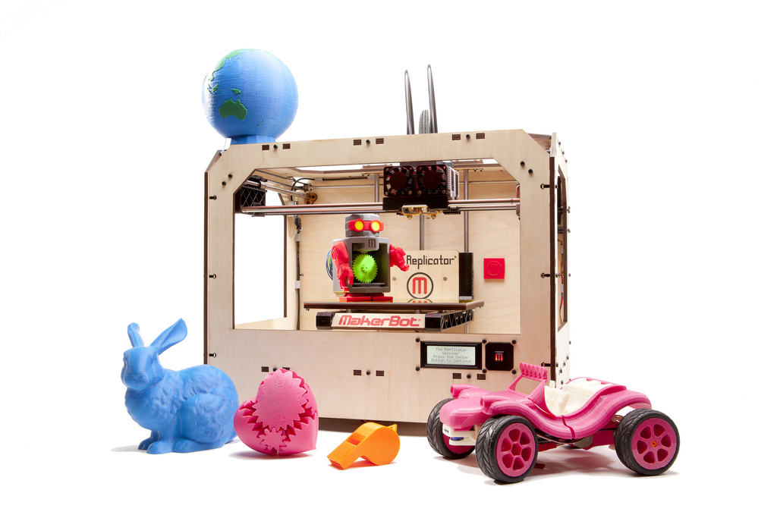
media/open_hardware/makerbot-replicator.jpg
