matthieu-lapeyre/phd_thesis/media/poppy/conception/head_beta_assembled.jpg

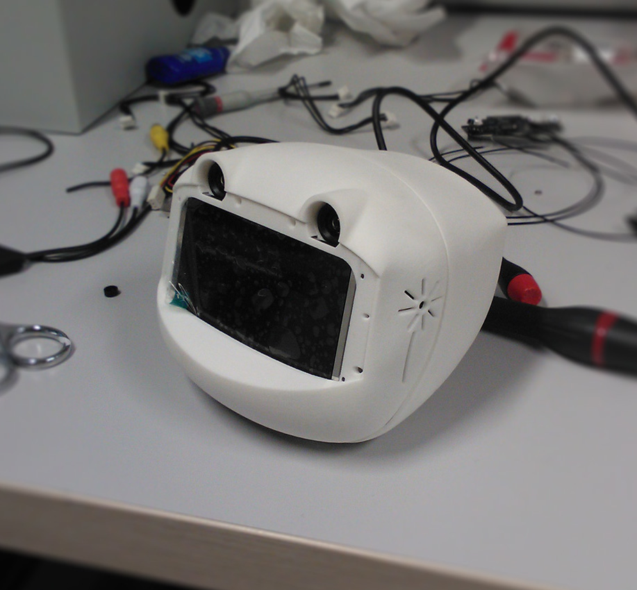
media/poppy/conception/head_beta_assembled.jpg
