matthieu-lapeyre/phd_thesis/media/related_work/3D_printing/3D_printed_odd_guitar.jpg

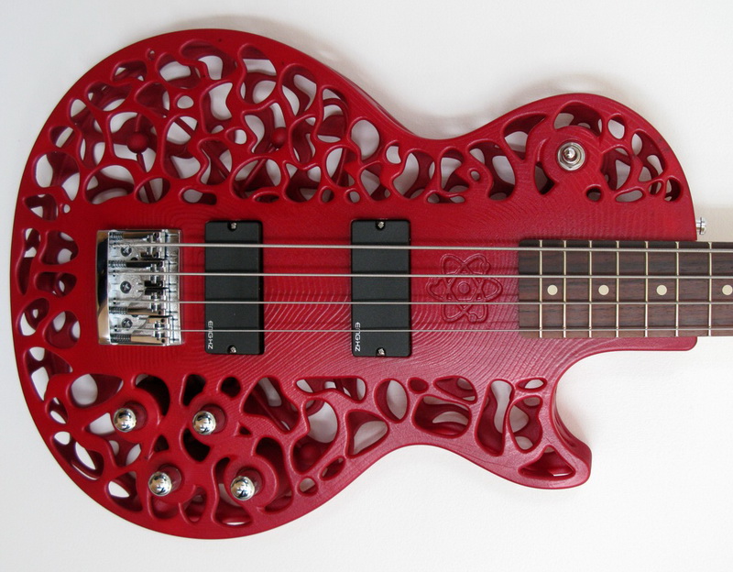
media/related_work/3D_printing/3D_printed_odd_guitar.jpg
