matthieu-lapeyre/phd_thesis/media/related_work/3D_printing/complex_3Dprint_steel.jpg

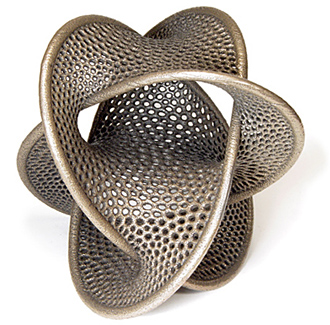
media/related_work/3D_printing/complex_3Dprint_steel.jpg
