matthieu-lapeyre/phd_thesis/media/related_work/3D_printing/complex_heat_exchanger.jpg

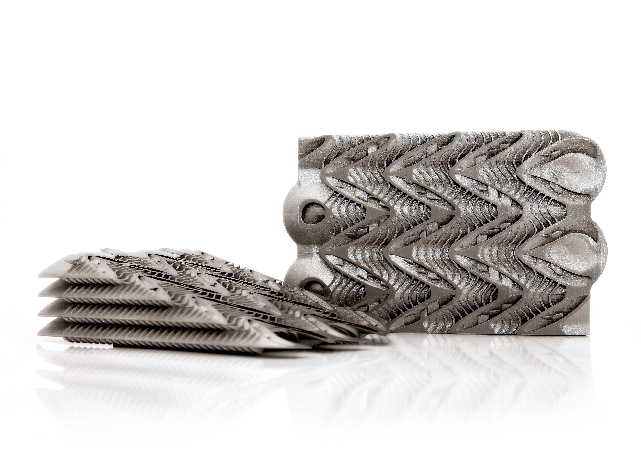
media/related_work/3D_printing/complex_heat_exchanger.jpg
