matthieu-lapeyre/phd_thesis/media/related_work/3D_printing/EADS_3D_printed_hinge.jpg

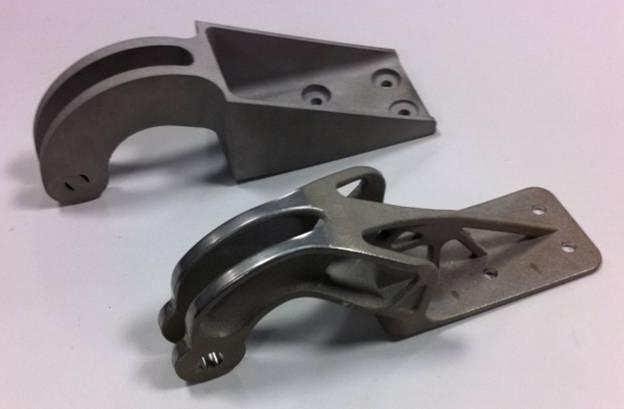
media/related_work/3D_printing/EADS_3D_printed_hinge.jpg
