matthieu-lapeyre/phd_thesis/media/related_work/3D_printing/SLS-printer.jpg

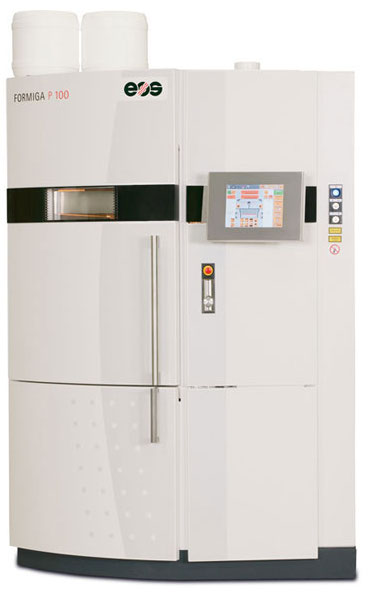
media/related_work/3D_printing/SLS-printer.jpg
