matthieu-lapeyre/phd_thesis/media/related_work/3D_printing/SLS_part.jpg

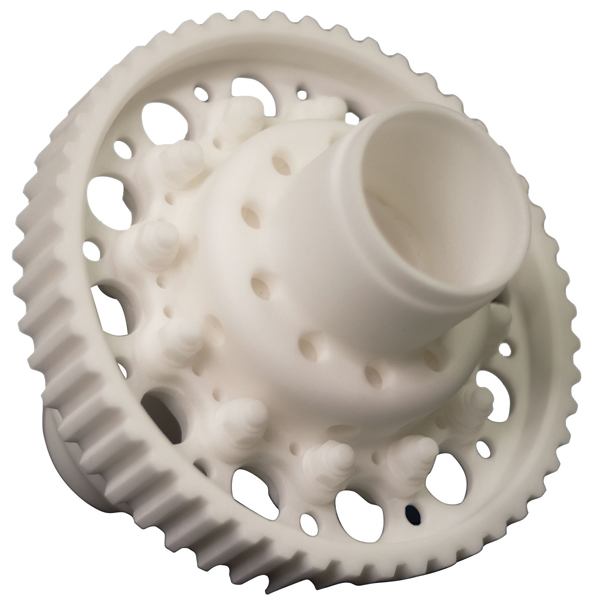
media/related_work/3D_printing/SLS_part.jpg
