matthieu-lapeyre/phd_thesis/media/related_work/3D_printing/SLS_technique.jpg

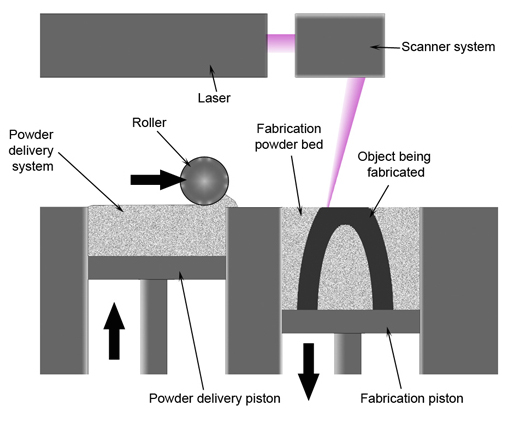
media/related_work/3D_printing/SLS_technique.jpg
