matthieu-lapeyre/phd_thesis/media/related_work/3D_printing/sPro60_SLS_printer.png

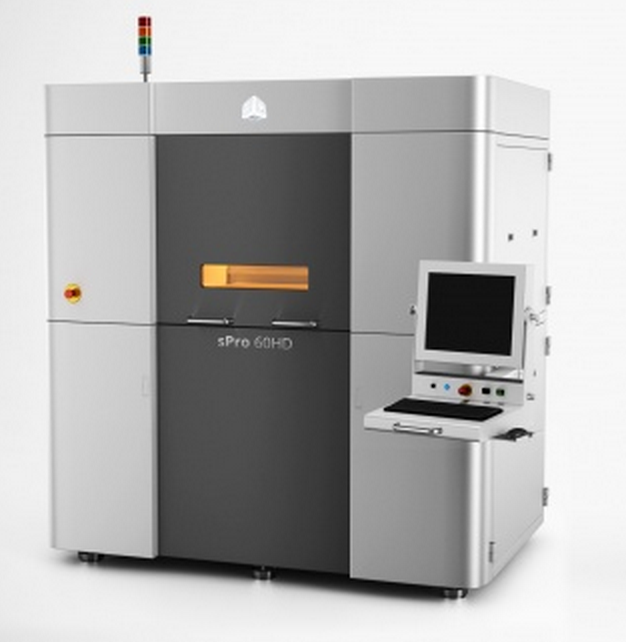
media/related_work/3D_printing/sPro60_SLS_printer.png
