matthieu-lapeyre/phd_thesis/media/related_work/3D_printing/superdraco.jpg

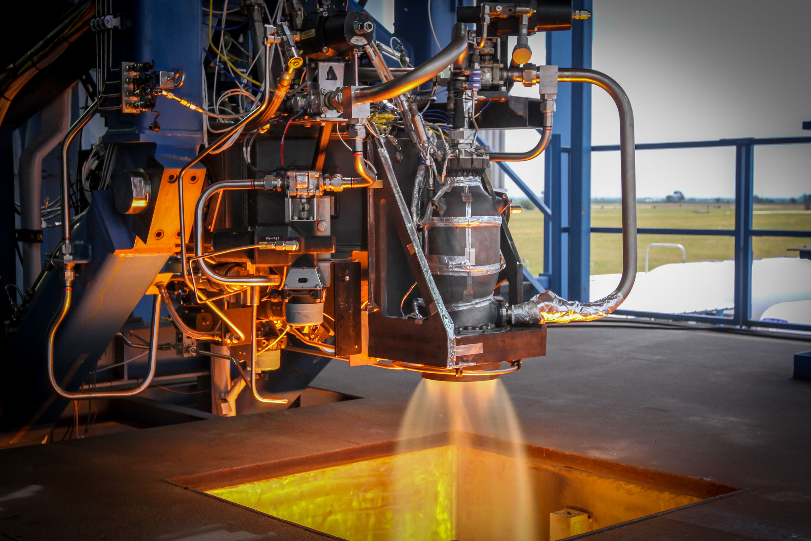
media/related_work/3D_printing/superdraco.jpg
