matthieu-lapeyre/phd_thesis/media/related_work/morphology/hist-z1-reconstruct.jpg

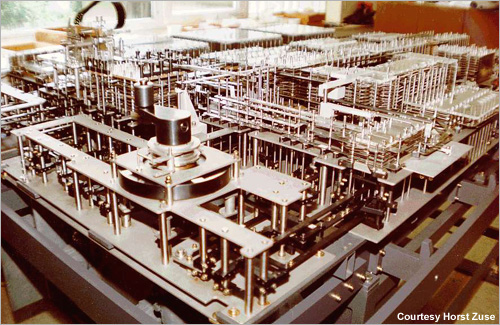
media/related_work/morphology/hist-z1-reconstruct.jpg
