matthieu-lapeyre/phd_thesis/media/applications/morphology/results/criteria_dist.pdf

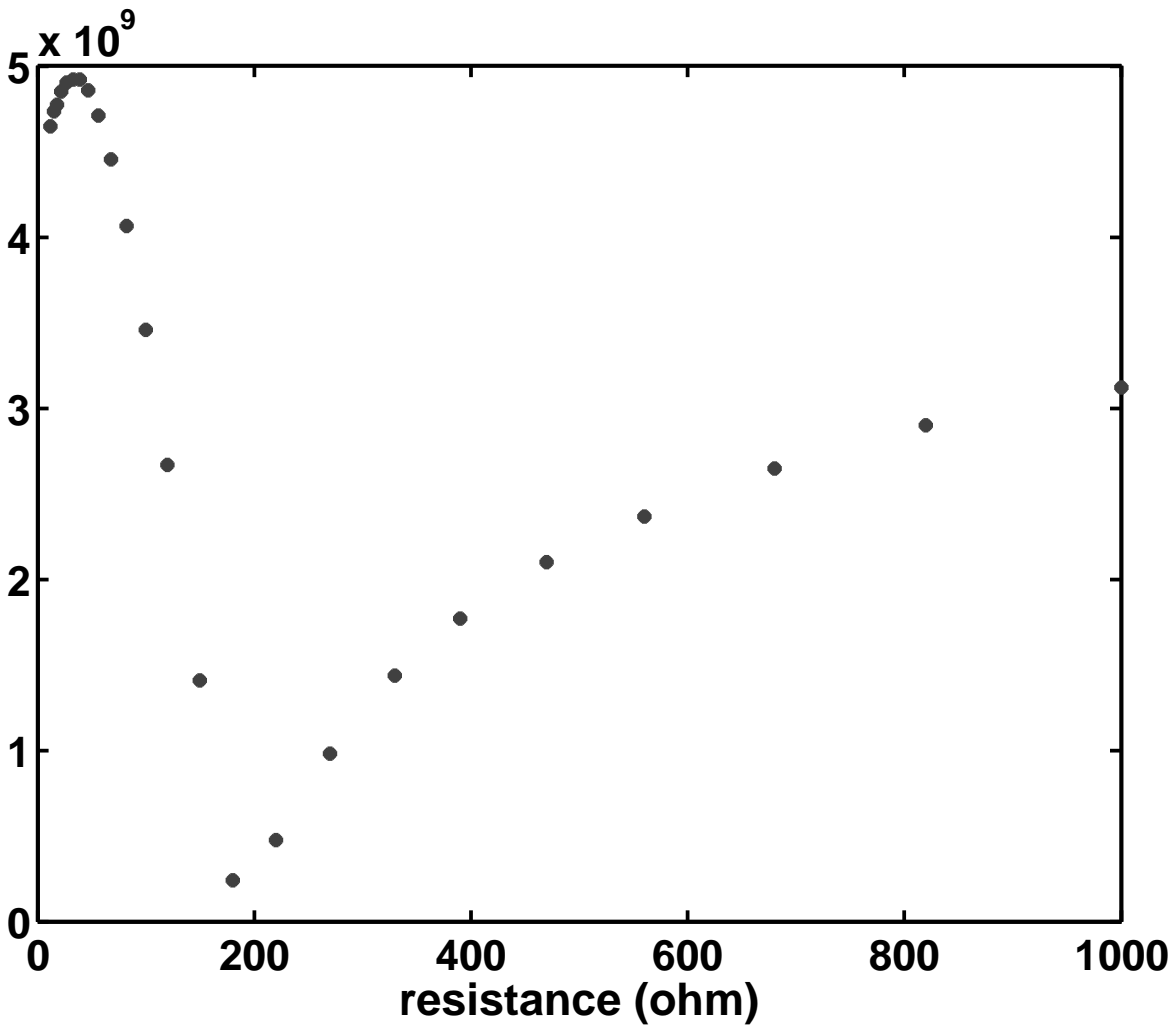
[picture p169: figure]
resistance (ohm)
