matthieu-lapeyre/phd_thesis/media/thigh_experiment/dispositif_experience_marche.pdf

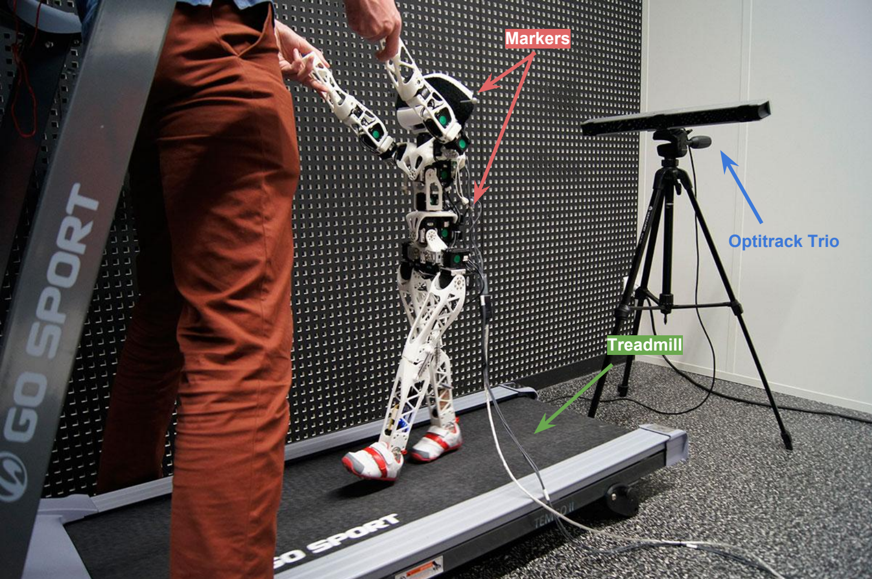
[picture p170: page 1]

Markers

Optitrack Trio

Treadmill
