matthieu-lapeyre/phd_thesis/media/thigh_experiment/dynamic_thigh_model.pdf

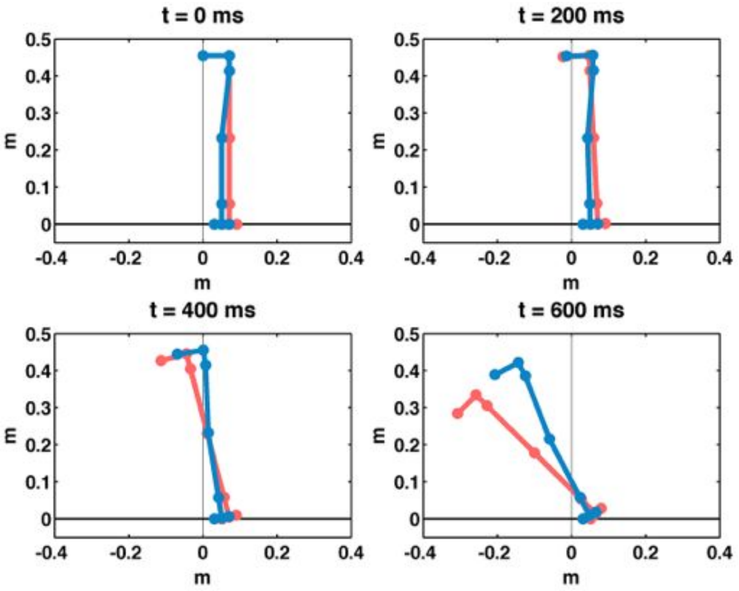
[picture p171: page 1]
