matthieu-lapeyre/phd_thesis/media/thigh_experiment/falling_compare.pdf

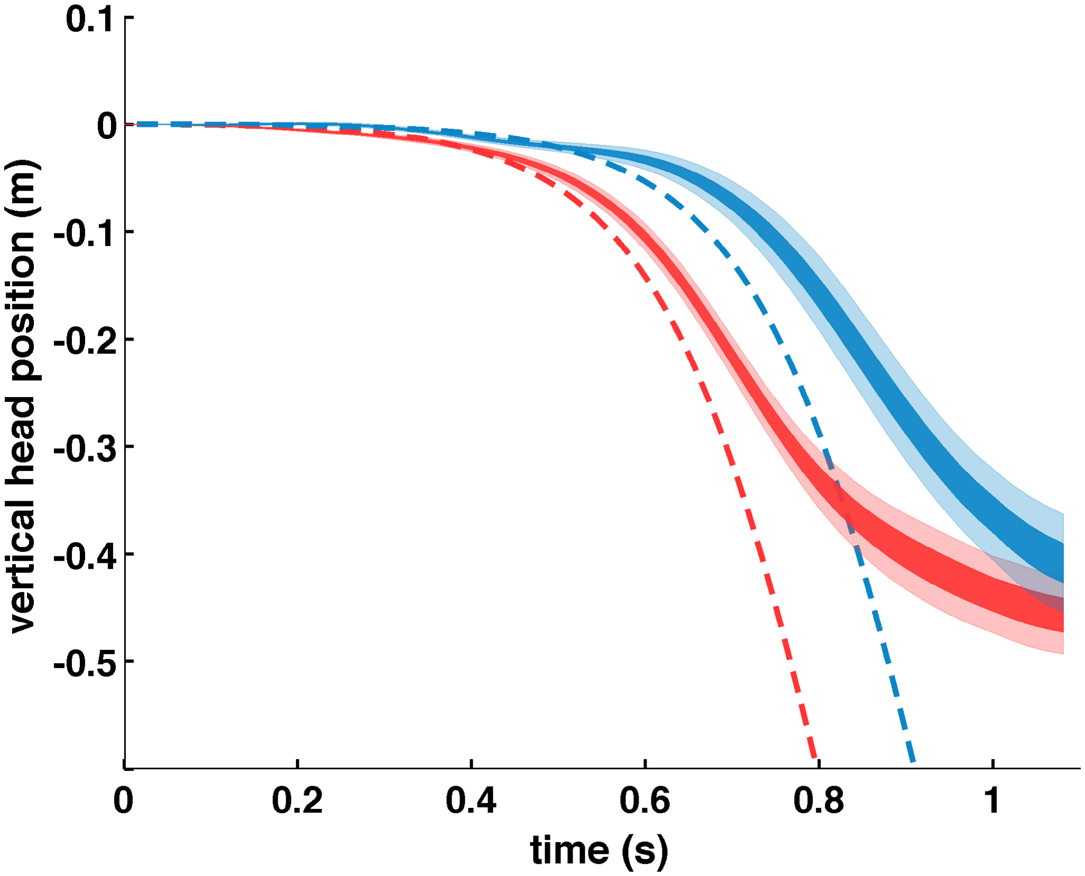
[picture p172: page 1]
