matthieu-lapeyre/phd_thesis/media/thigh_experiment/marche_accel_x_signal.pdf

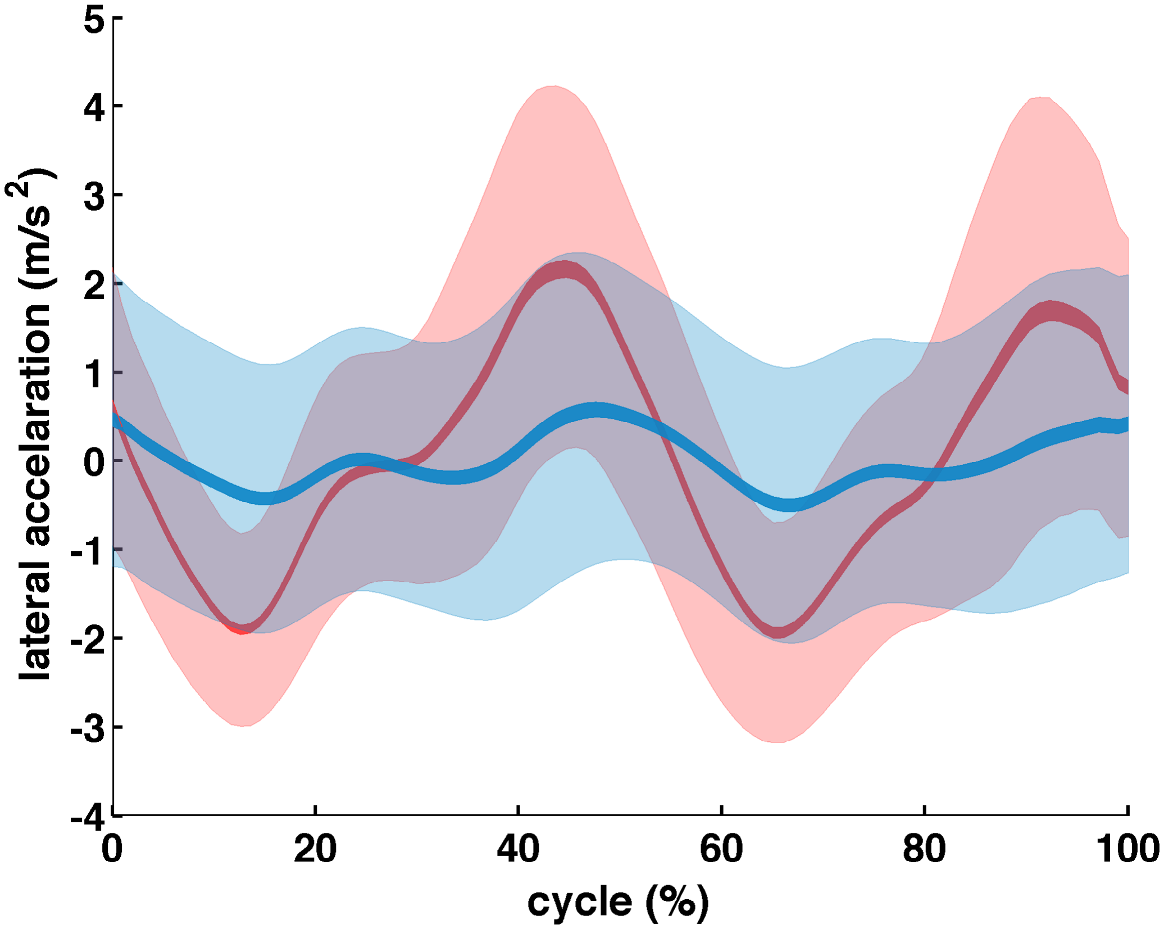
[picture p173: page 1]
