matthieu-lapeyre/phd_thesis/media/thigh_experiment/marche_accel_y_signal.pdf

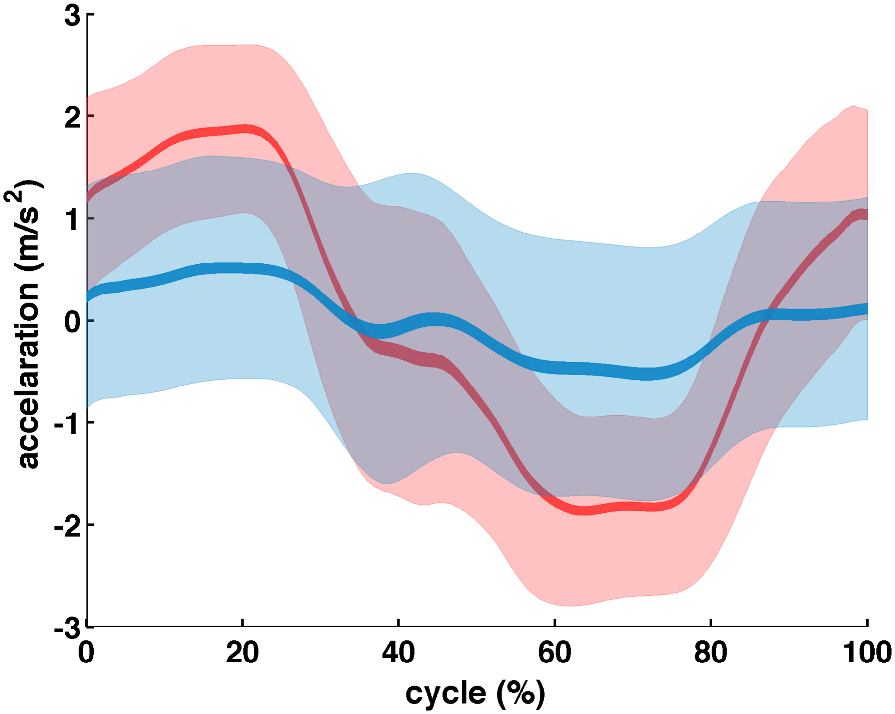
[picture p174: page 1]
