matthieu-lapeyre/phd_thesis/media/thigh_experiment/marche_head_motion.pdf

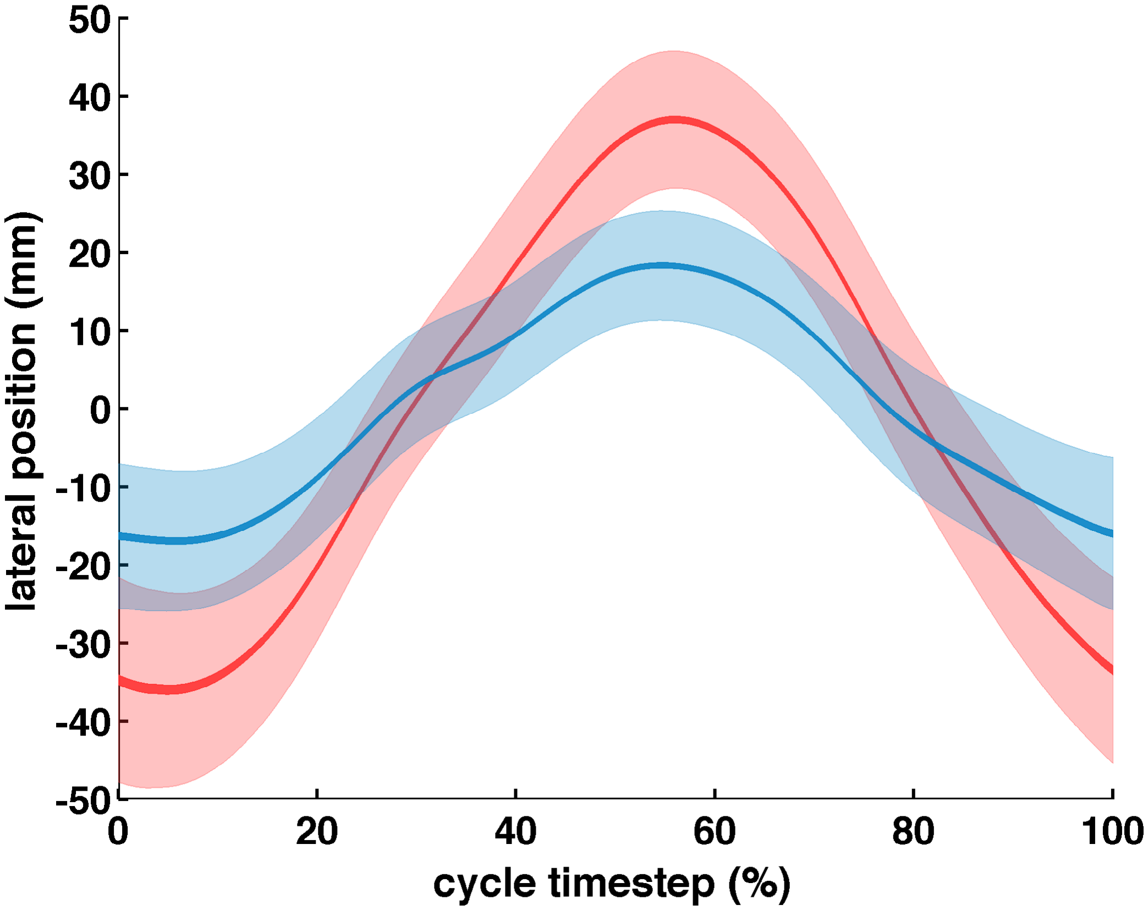
[picture p175: page 1]
