matthieu-lapeyre/phd_thesis/media/thigh_experiment/marche_low_back_motion.pdf

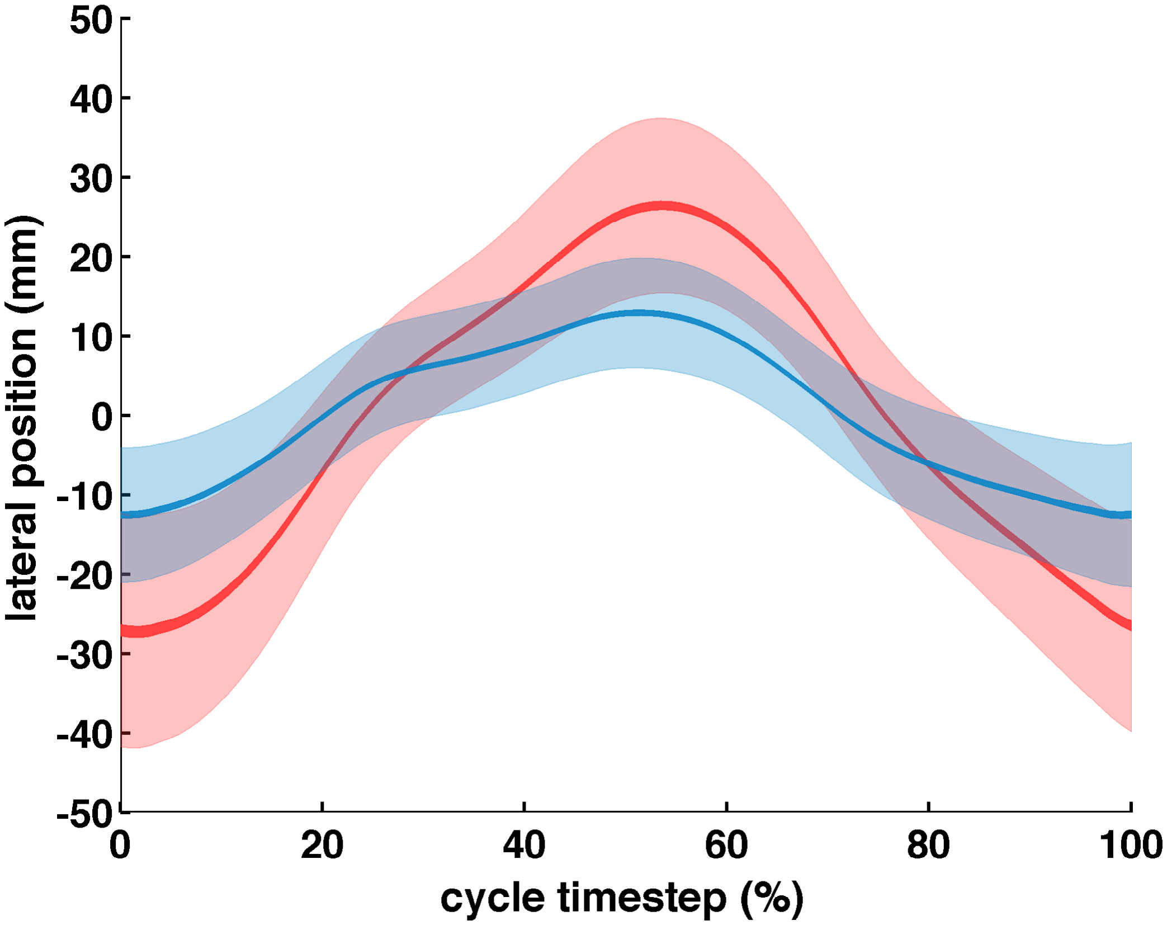
[picture p176: page 1]
