matthieu-lapeyre/phd_thesis/media/thigh_experiment/marche_tilt_x_signal.pdf

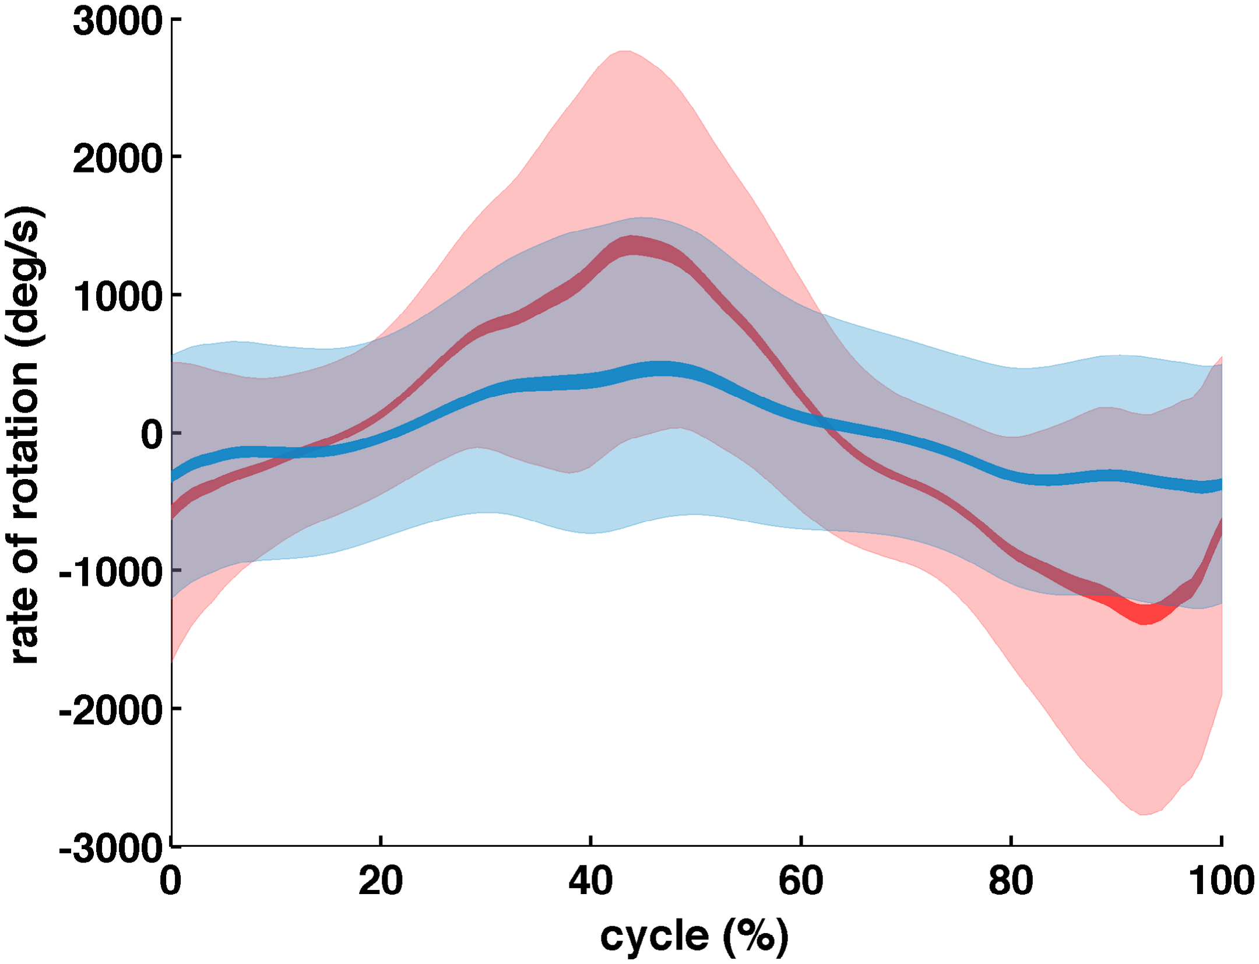
[picture p177: page 1]
