matthieu-lapeyre/phd_thesis/media/thigh_experiment/marche_tilt_y_signal.pdf

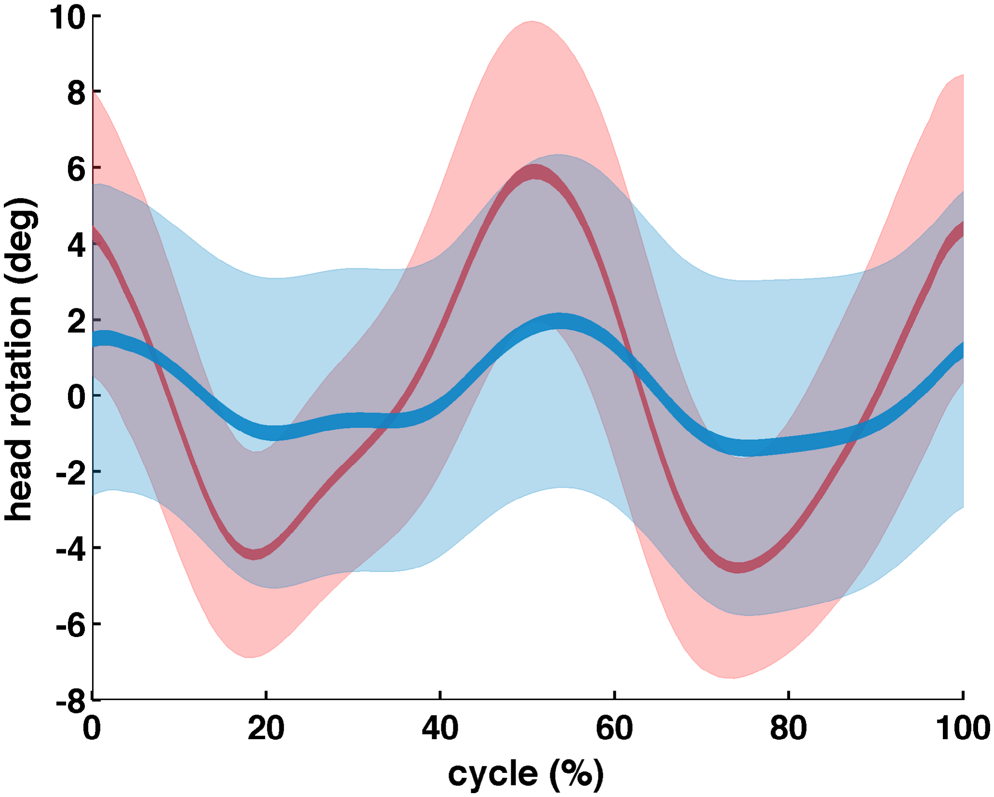
[picture p178: page 1]
