matthieu-lapeyre/phd_thesis/media/thigh_experiment/poppy_bended_tigh_square.pdf

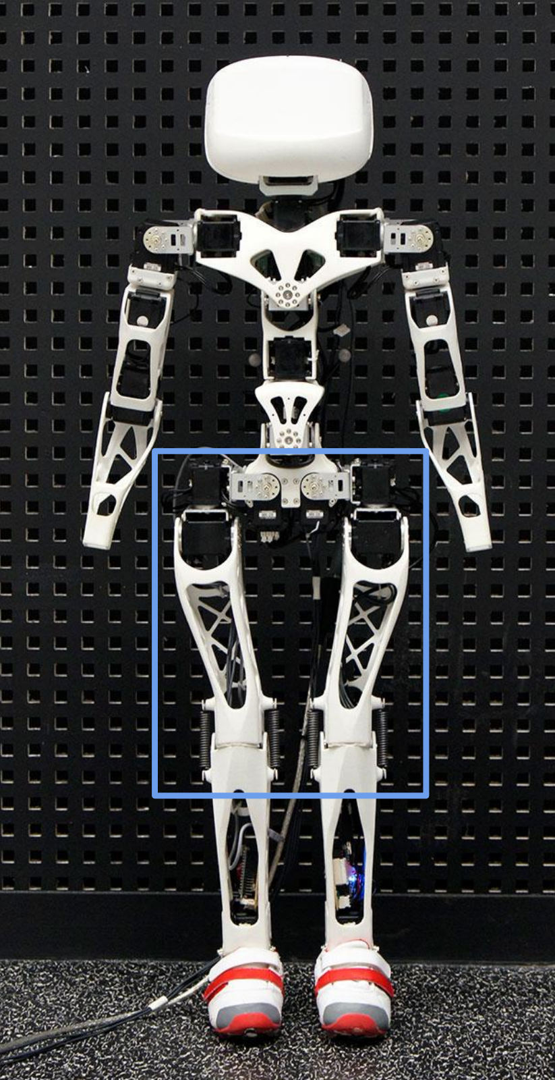
[picture p179: page 1]
