matthieu-lapeyre/phd_thesis/media/thigh_experiment/poppy_straight_tigh_square.pdf

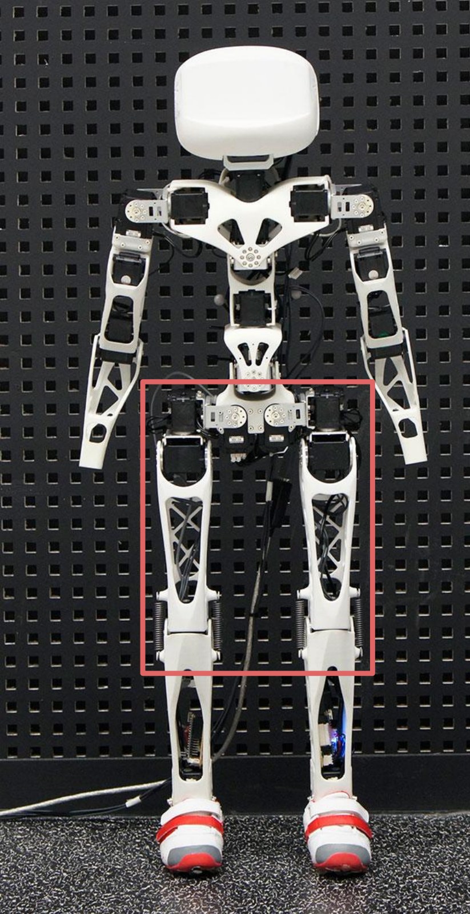
[picture p180: page 1]
