matthieu-lapeyre/phd_thesis/media/thigh_experiment/velocity_compare.pdf

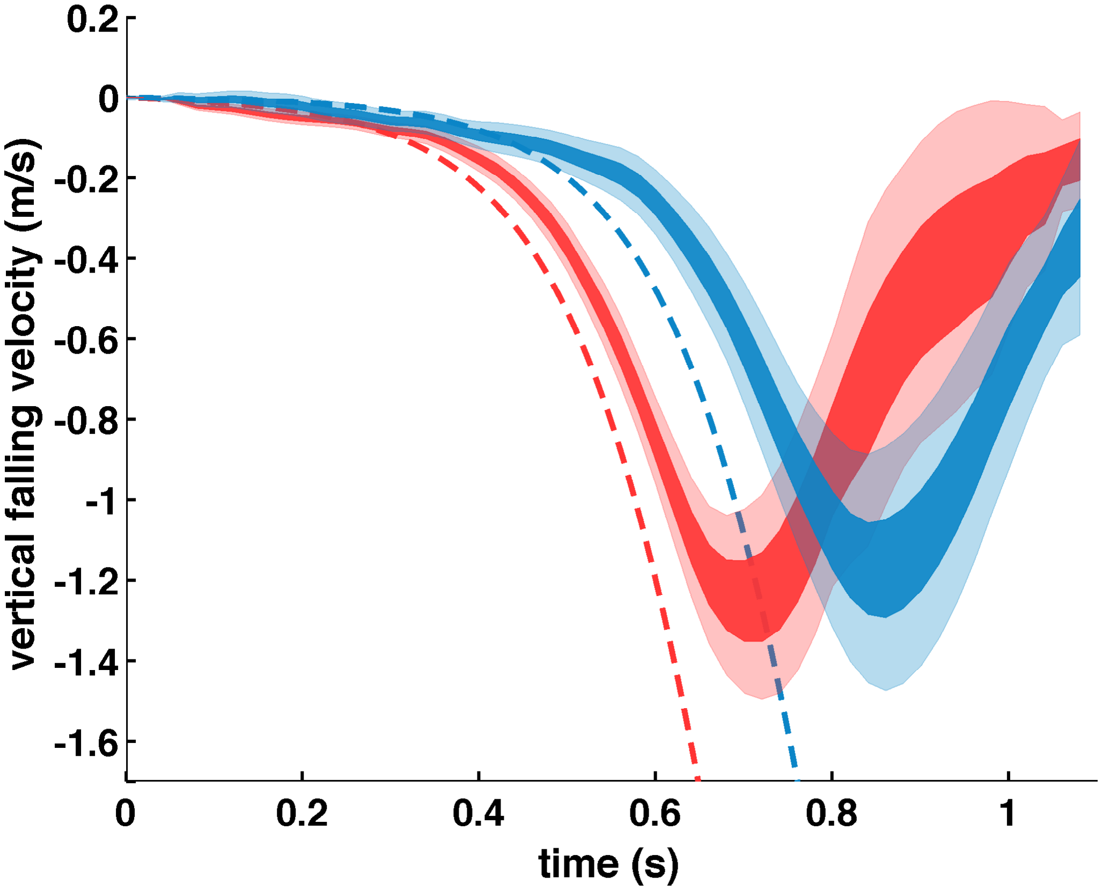
[picture p181: page 1]
