matthieu-lapeyre/phd_thesis/media/applications/morphology/results/knee_compliance.pdf

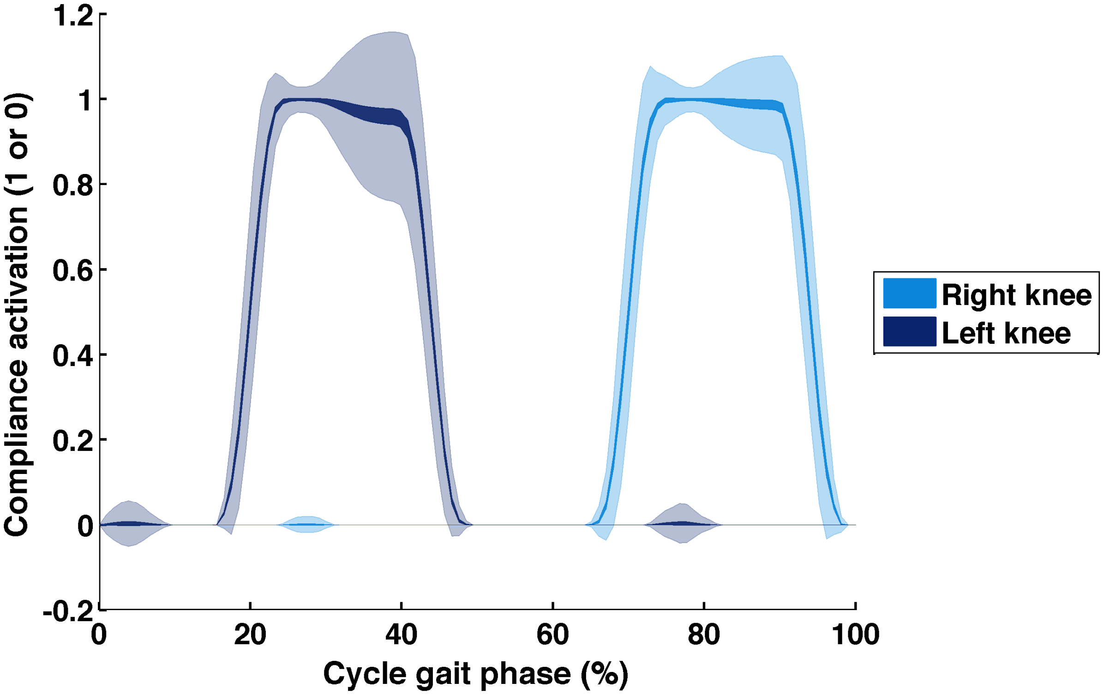
[picture p182: page 1]
