matthieu-lapeyre/phd_thesis/media/applications/morphology/results/left_GRF.pdf

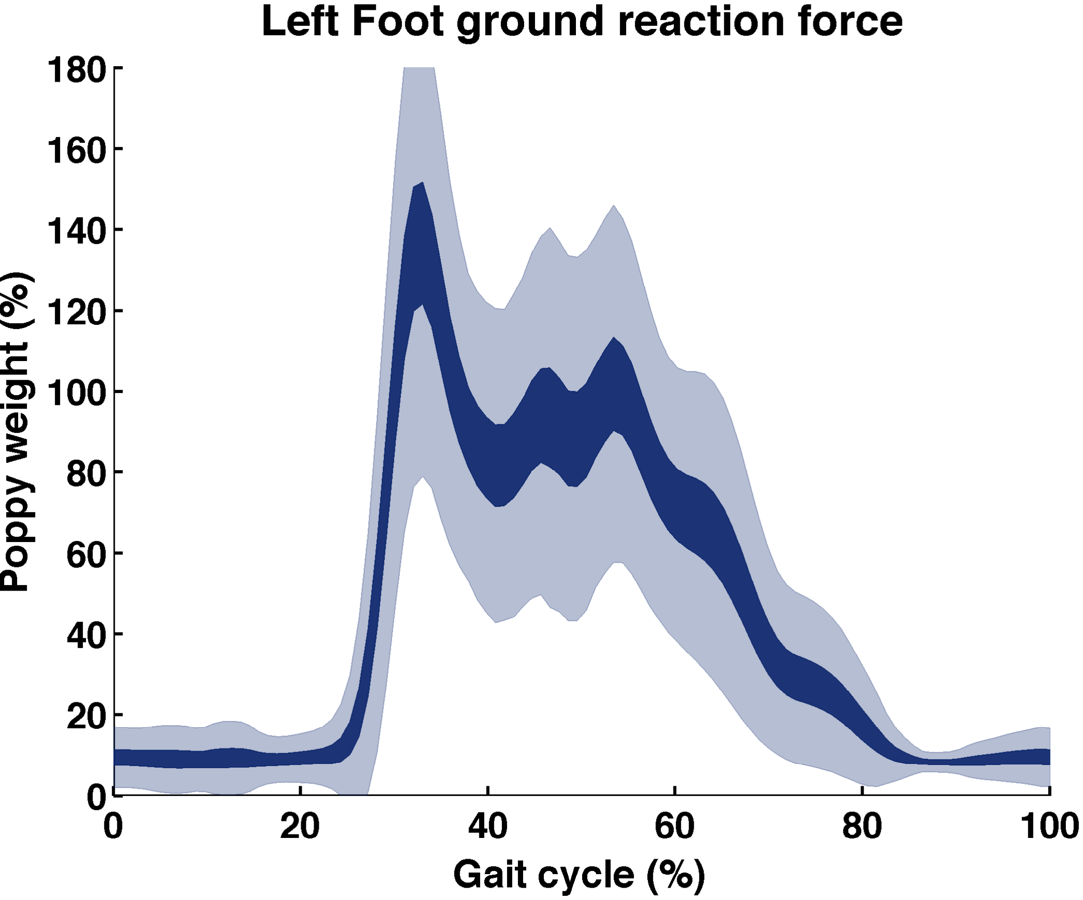
[picture p183: page 1]
