matthieu-lapeyre/phd_thesis/media/applications/morphology/results/right_GRF.pdf

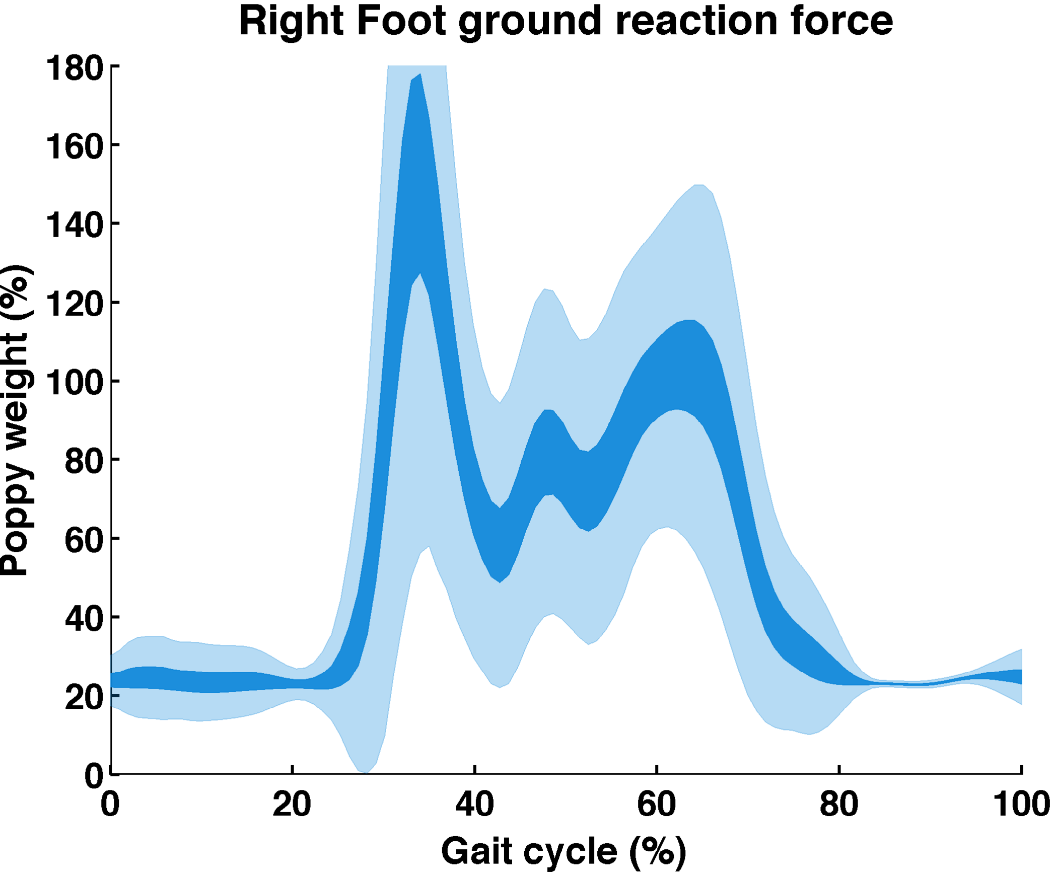
[picture p184: page 1]
