matthieu-lapeyre/phd_thesis/media/applications/morphology/force_sensors_test.jpg

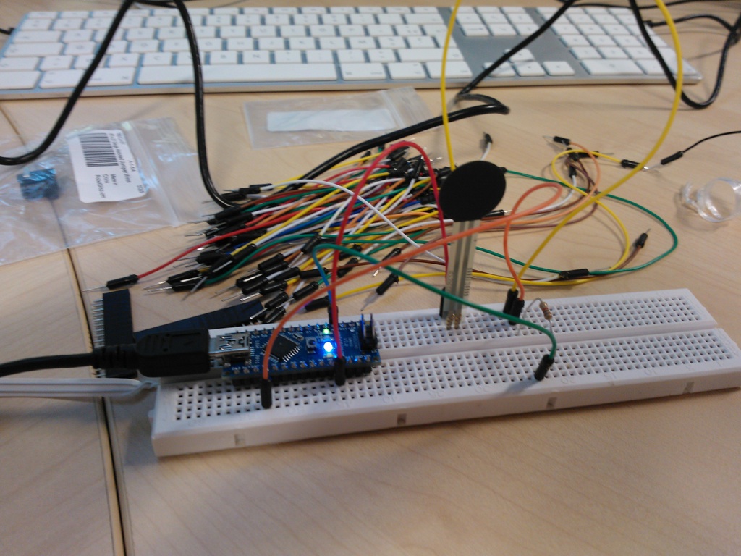
media/applications/morphology/force_sensors_test.jpg
