matthieu-lapeyre/phd_thesis/media/thigh_experiment/experience_fall_illu.jpg

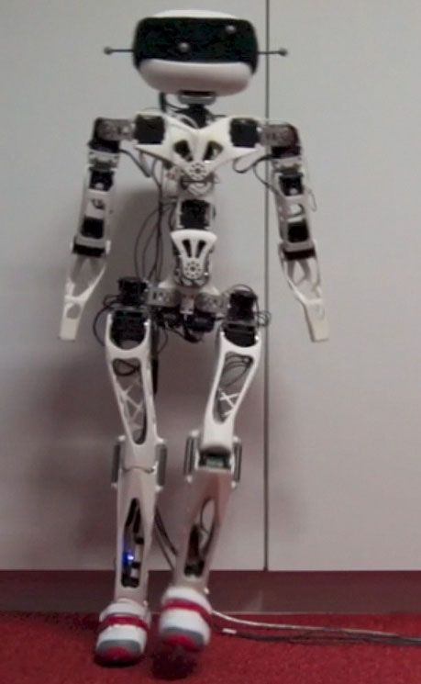
media/thigh_experiment/experience_fall_illu.jpg
