matthieu-lapeyre/phd_thesis/media/thigh_experiment/experience_fall_mean.jpg

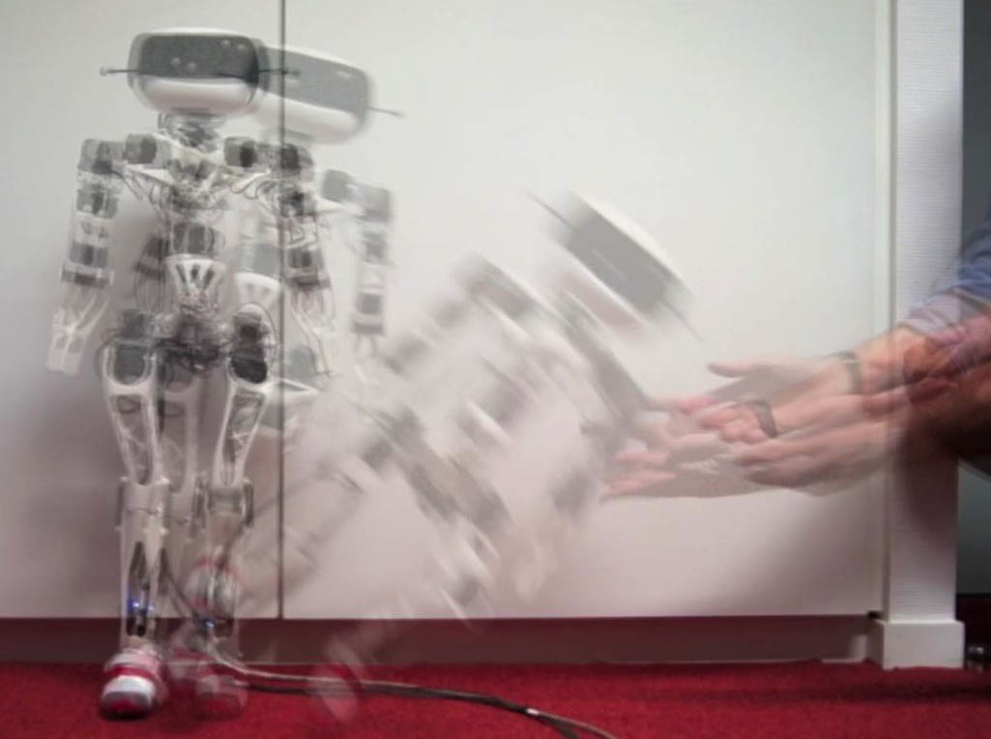
media/thigh_experiment/experience_fall_mean.jpg
