matthieu-lapeyre/phd_thesis/media/thigh_experiment/human_thigh.jpg

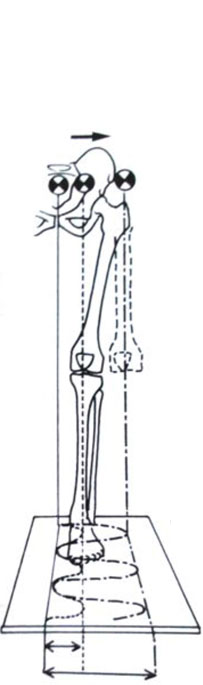
media/thigh_experiment/human_thigh.jpg
