matthieu-lapeyre/phd_thesis/media/thigh_experiment/marche_bended.jpg

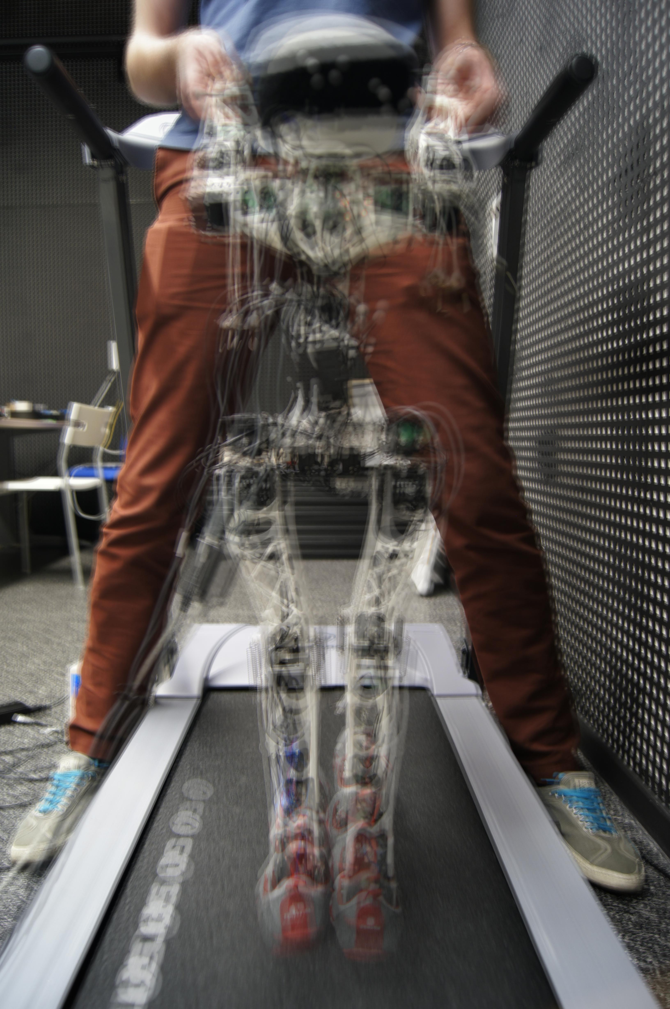
media/thigh_experiment/marche_bended.jpg
