matthieu-lapeyre/phd_thesis/media/thigh_experiment/marche_straight.jpg

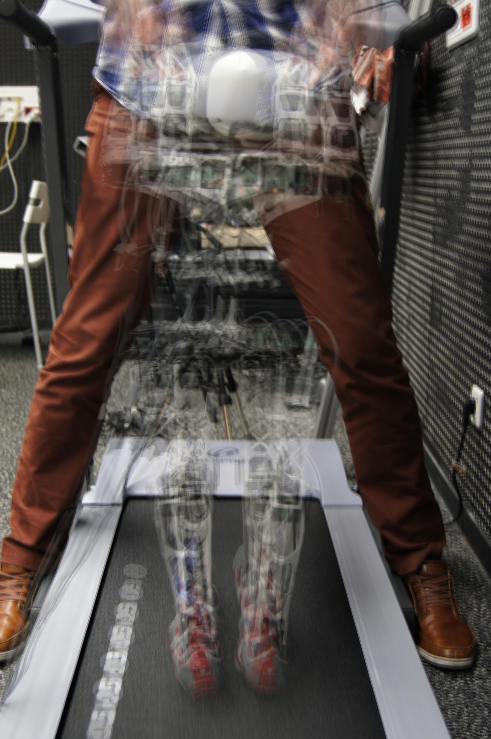
media/thigh_experiment/marche_straight.jpg
