matthieu-lapeyre/phd_thesis/media/thigh_experiment/model_thigh.jpg

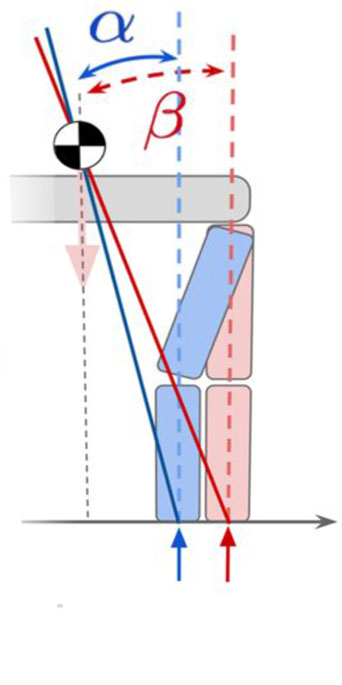
media/thigh_experiment/model_thigh.jpg
