matthieu-lapeyre/phd_thesis/media/thigh_experiment/thigh_shape_large.jpg

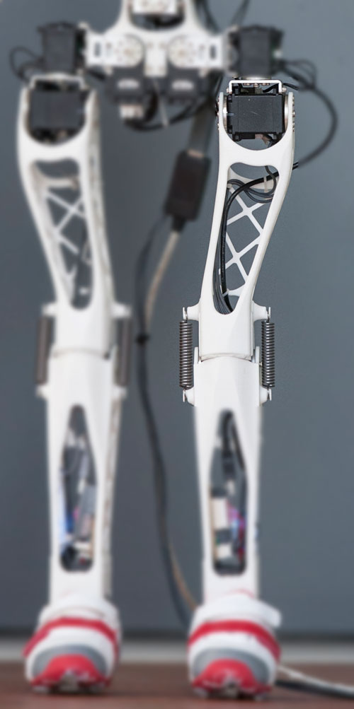
media/thigh_experiment/thigh_shape_large.jpg
