matthieu-lapeyre/phd_thesis/media/thigh_experiment/walking_poppy.jpg

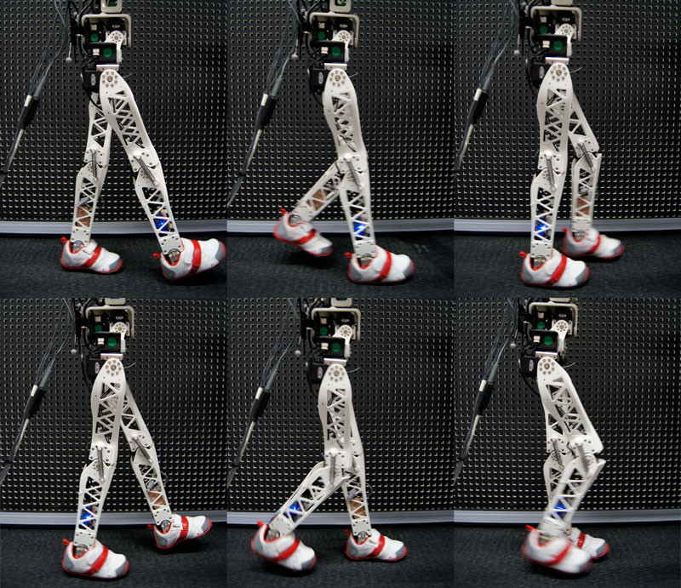
media/thigh_experiment/walking_poppy.jpg
