matthieu-lapeyre/phd_thesis/changelog.md

# Changelog
## v.0.3
Add lot of content, yet still at 45%

## v.0.2
First version of the thesis outline

## v.0.1
Set up the cleanthesis template as a git submodule
