matthieu-lapeyre/phd_thesis/media/poppy/conception/poppy_foot_v1.PDF

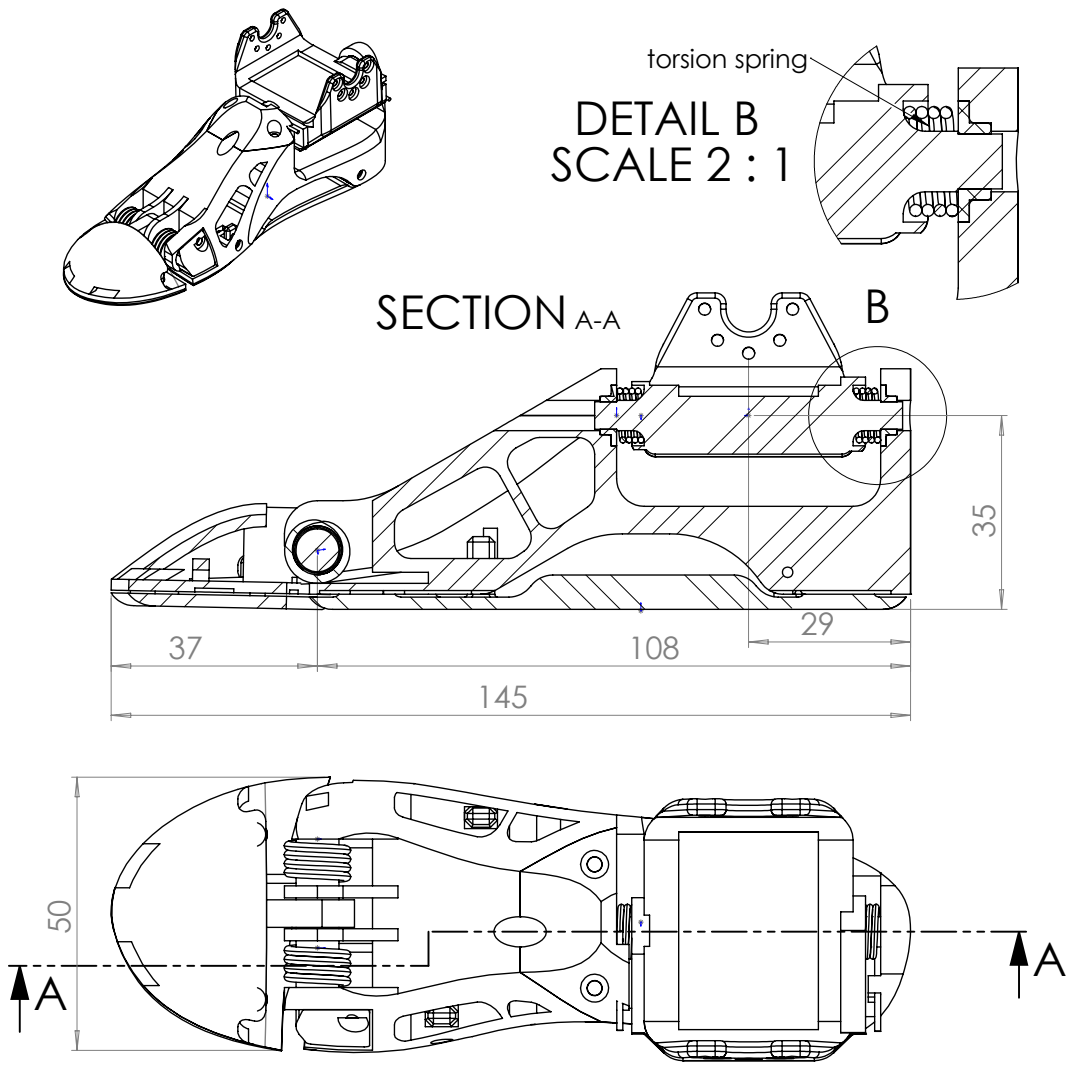
[picture p194: page 1]
SECTION A-A; DETAIL B SCALE 2 : 1; torsion spring
