matthieu-lapeyre/phd_thesis/media/poppy/conception/poppy_electro_archi_overview.pdf

# Poppy robot

### HDMI

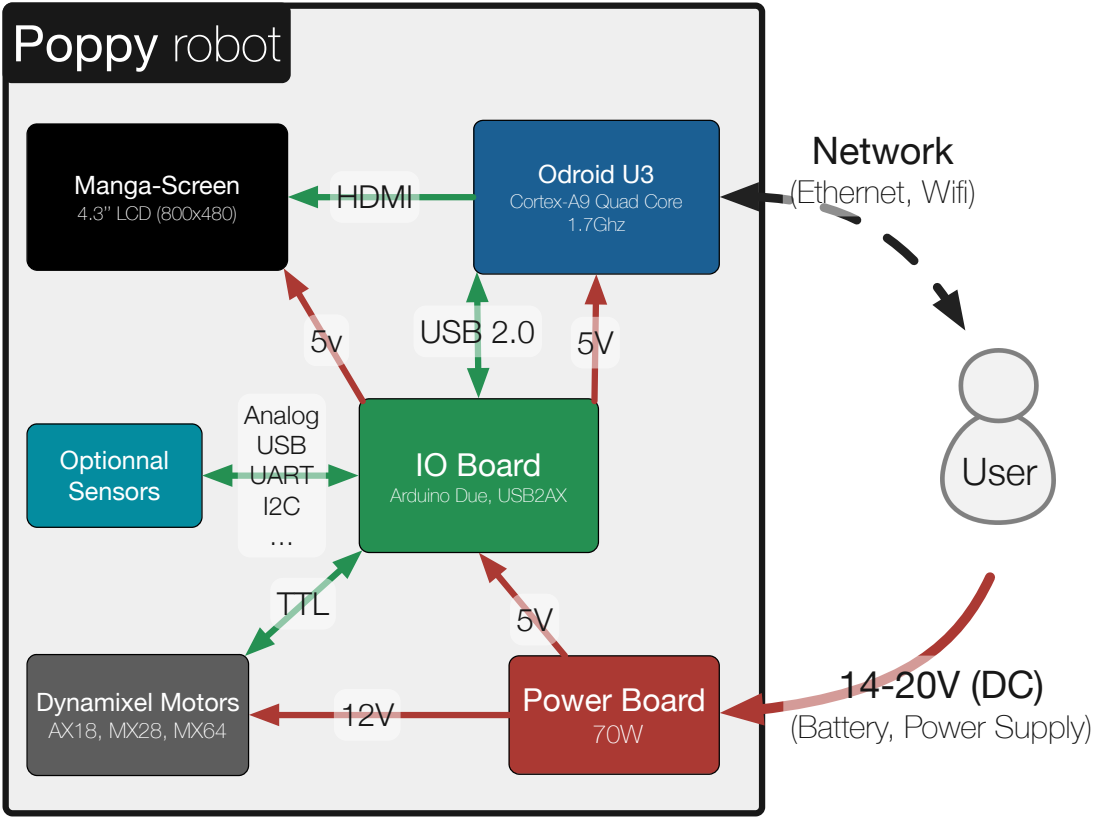
[picture p195: page 1]
Odroid U3 Cortex-A9 Quad Core 1.7Ghz; Manga-Screen 4.3’’ LCD (800x480); IO Board; Arduino Due, USB2AX; Dynamixel Motors AX18, MX28, MX64; TTL; USB 2.0; Power Board 70W 12V; Network (Ethernet, Wifi); Optionnal Sensors; Analog USB UART I2C …; User

(Battery, Power Supply)
