matthieu-lapeyre/phd_thesis/media/applications/morphology/results/FSR_behavior_log.pdf

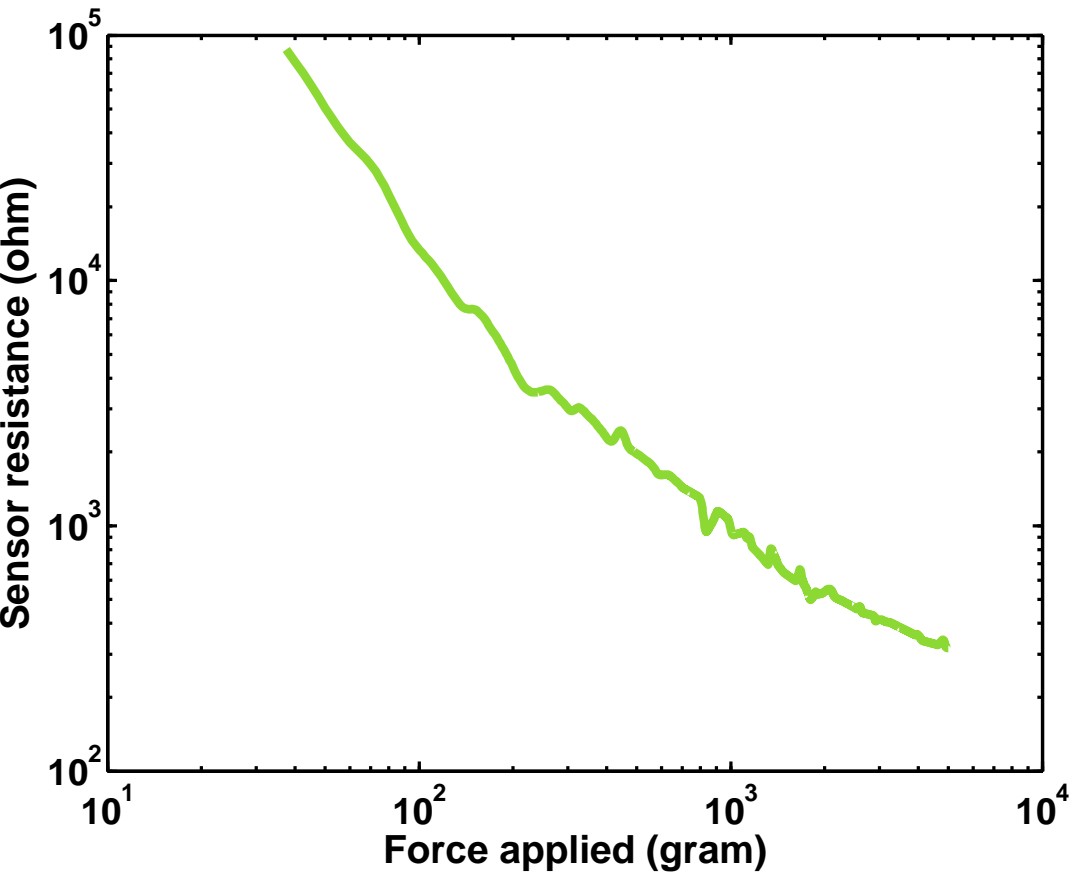
[picture p196: page 1]
Force applied (gram)

Sensor resistance (ohm)
