matthieu-lapeyre/phd_thesis/media/applications/morphology/results/FSR_behavior.pdf

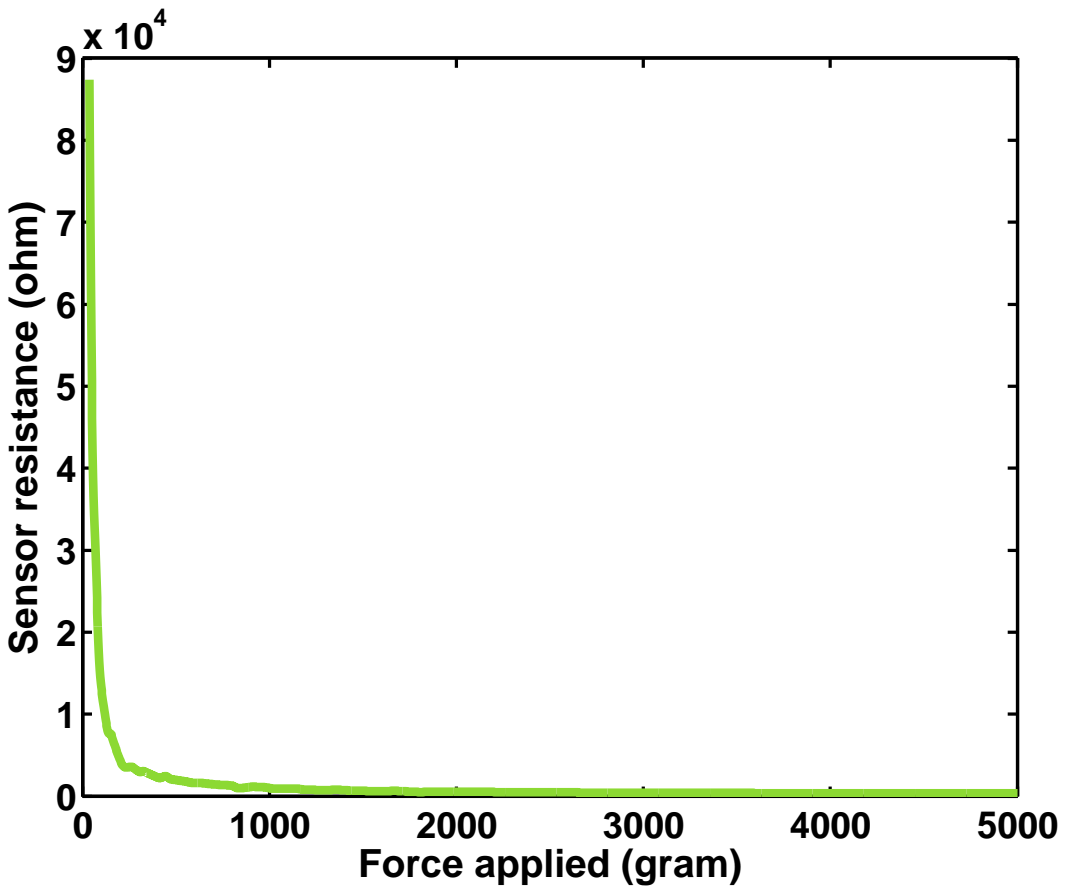
[picture p197: page 1]

Sensor resistance (ohm)

Force applied (gram)
