matthieu-lapeyre/phd_thesis/media/applications/morphology/results/voltage_behavior.pdf

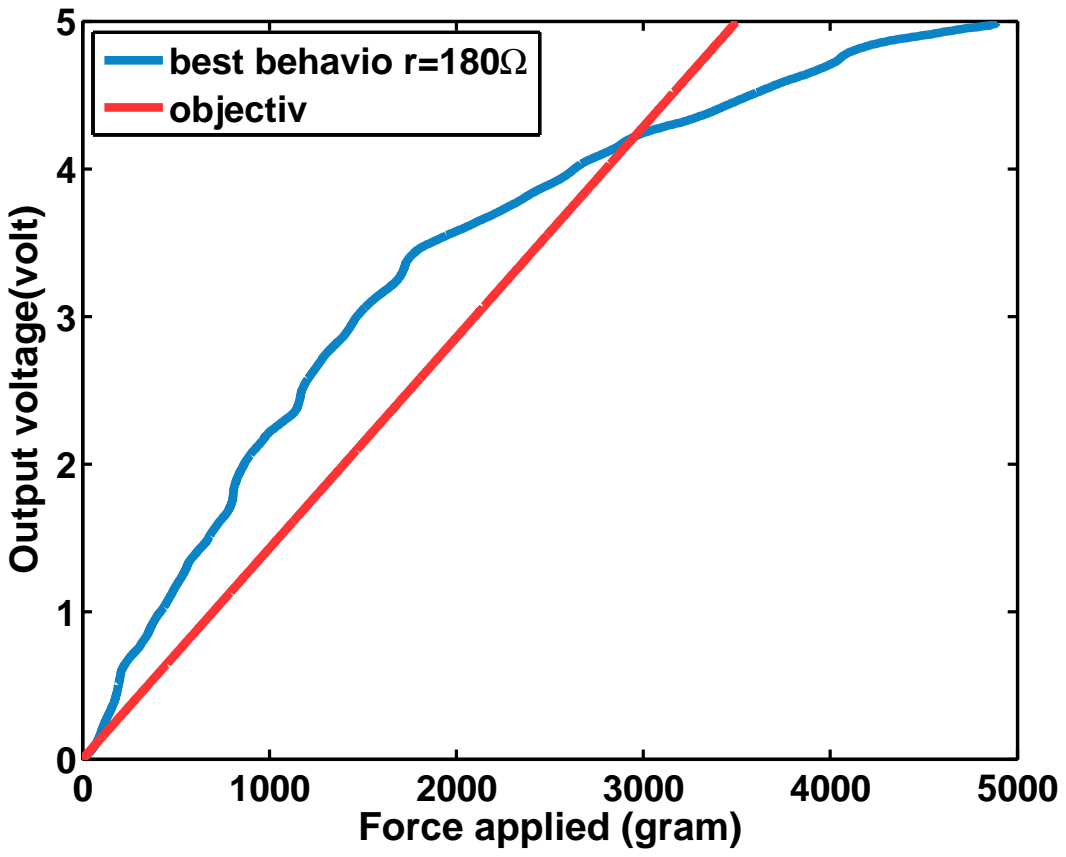
[picture p198: page 1]
best behavio r=180Ω objectiv

Output voltage(volt)

Force applied (gram)
