matthieu-lapeyre/phd_thesis/media/poppy/pypot/pypot.pdf

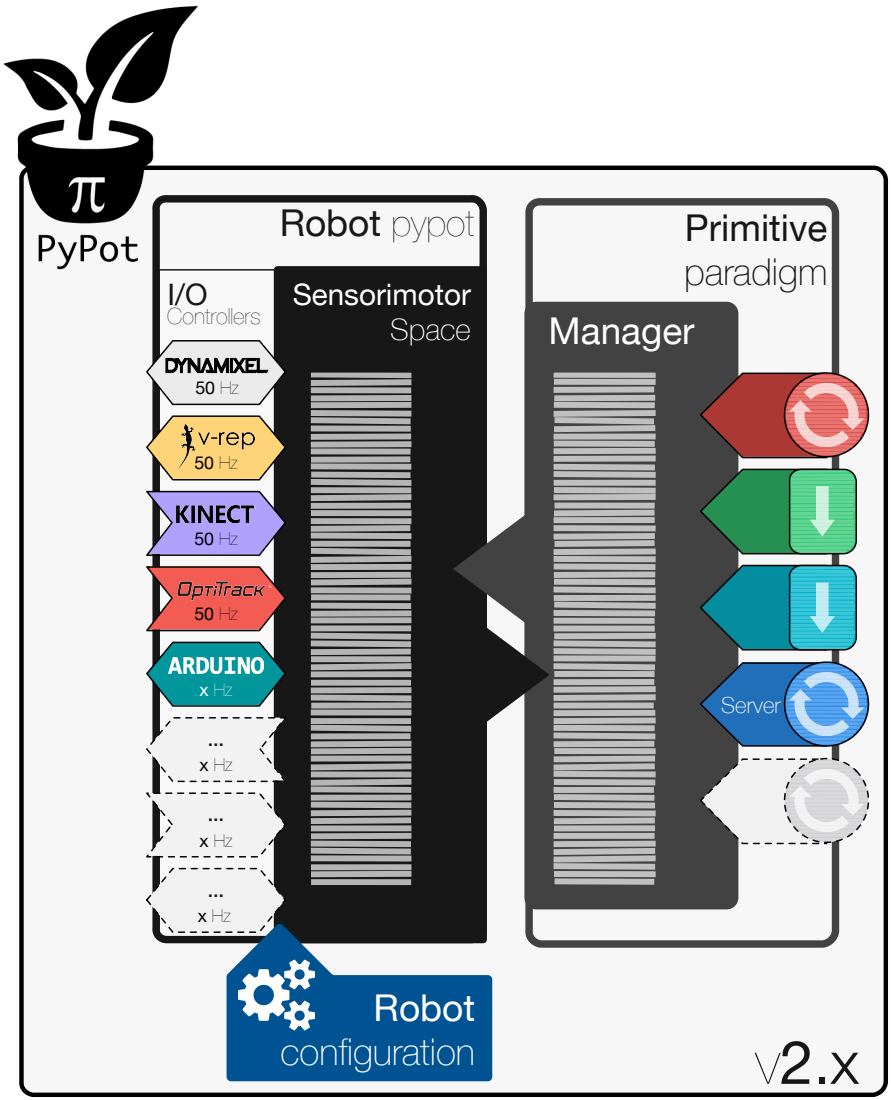
[picture p199: page 1]
Robot pypot; Sensorimotor Space Controllers; Robot configuration; Primitive paradigm Manager; Server
