matthieu-lapeyre/phd_thesis/media/poppy/approach/morpho_variation.pdf

# Exploring morphological variants with Poppy

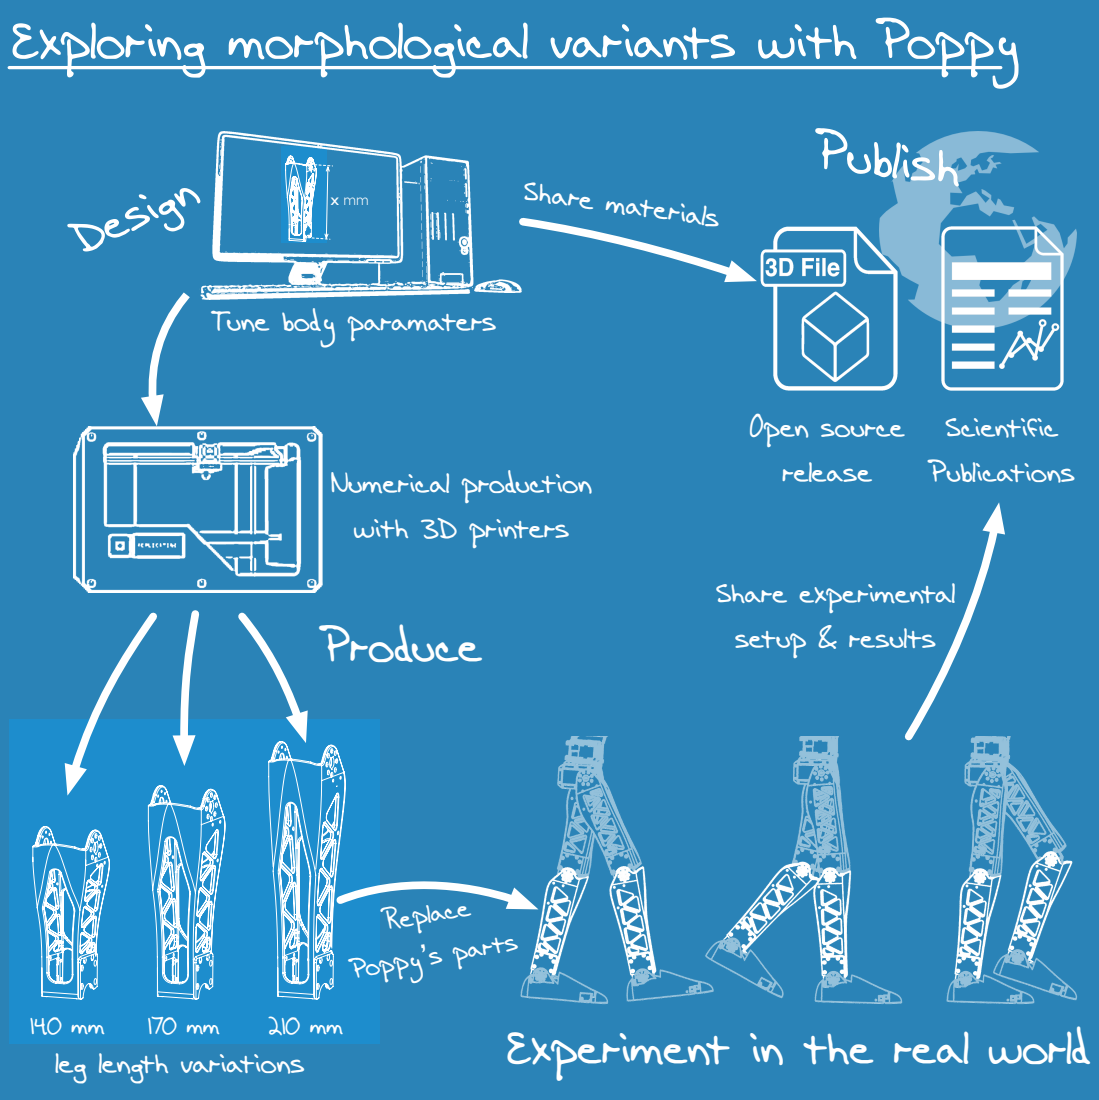
[picture p200: page 1]
Numerical production with 3D printers; Share experimental setup & results; Scientific Publications; Open source release; Poppy’s parts; Publish; Share materials; Design; Produce

Tune body paramaters

Replace
Experiment in the real world

leg length variations
