matthieu-lapeyre/phd_thesis/media/poppy/approach/dynamixel_dimension.pdf

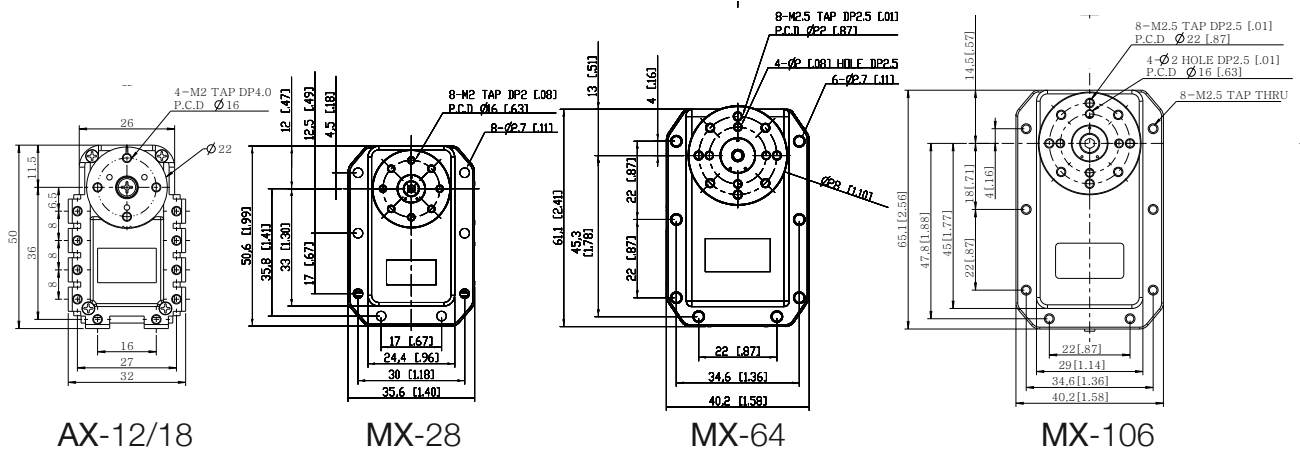
[picture p201: page 1]
TAP THRU; 8-M2.5 TAP DP2.5 [.01]; 4- 2 HOLE DP2.5 [.01]; TAP DP4.0
