matthieu-lapeyre/phd_thesis/media/thigh_experiment/thigh_morpho.pdf

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

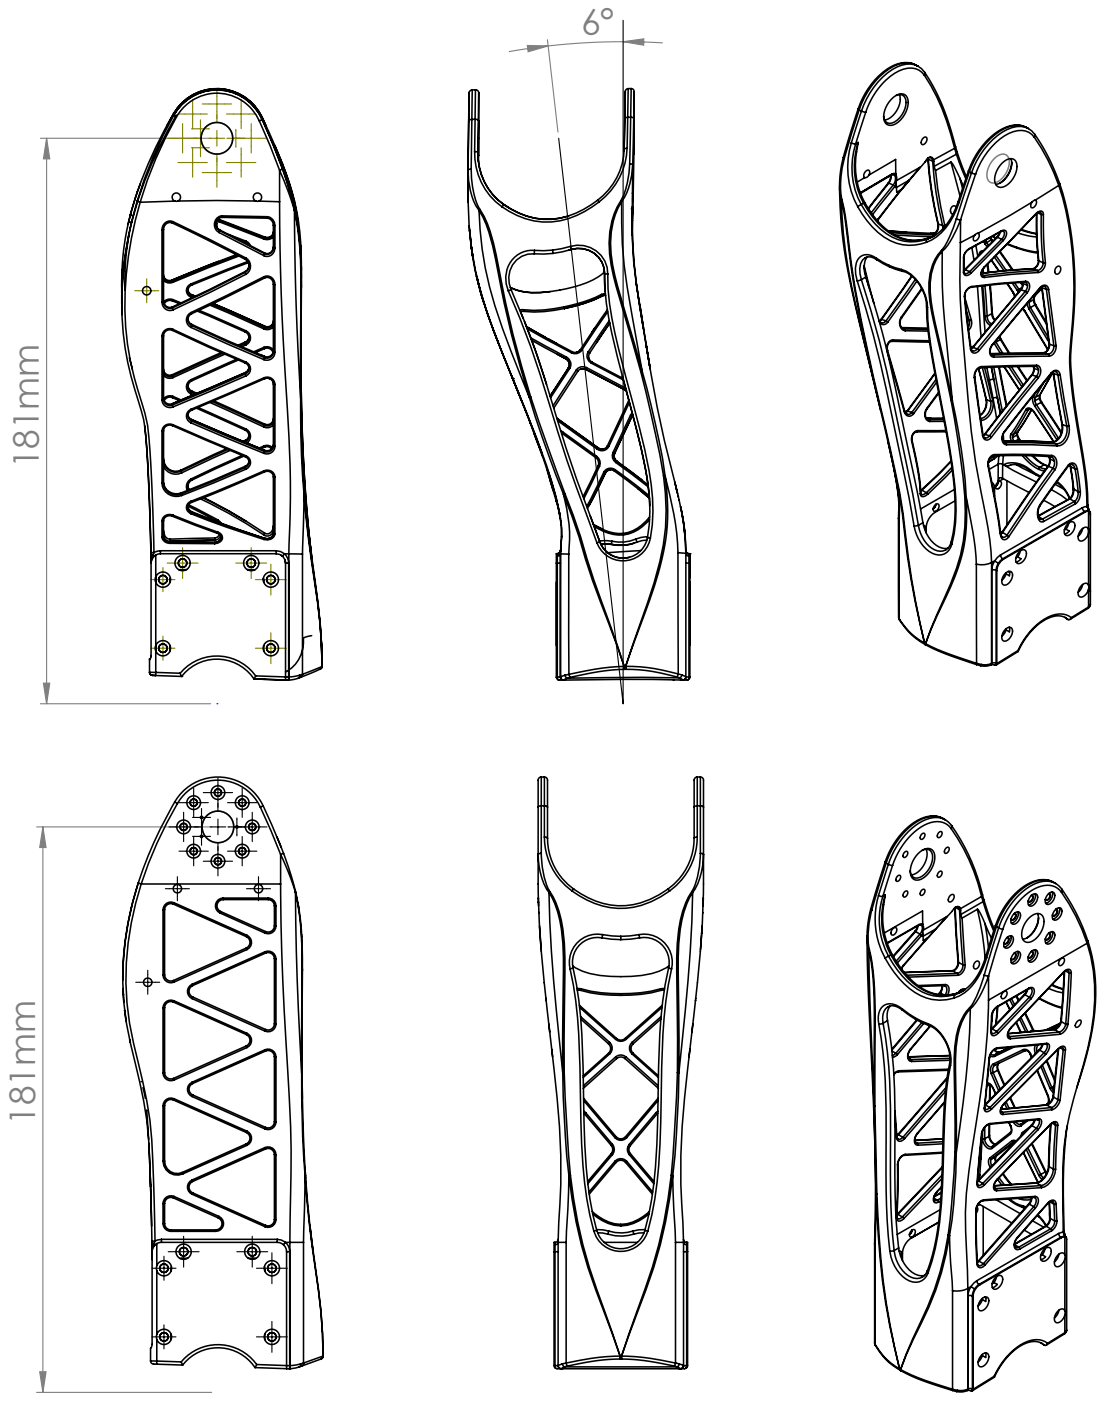
[picture p202: page 1]
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
