matthieu-lapeyre/phd_thesis/media/thigh_experiment/CPG.pdf

(a)

(b)

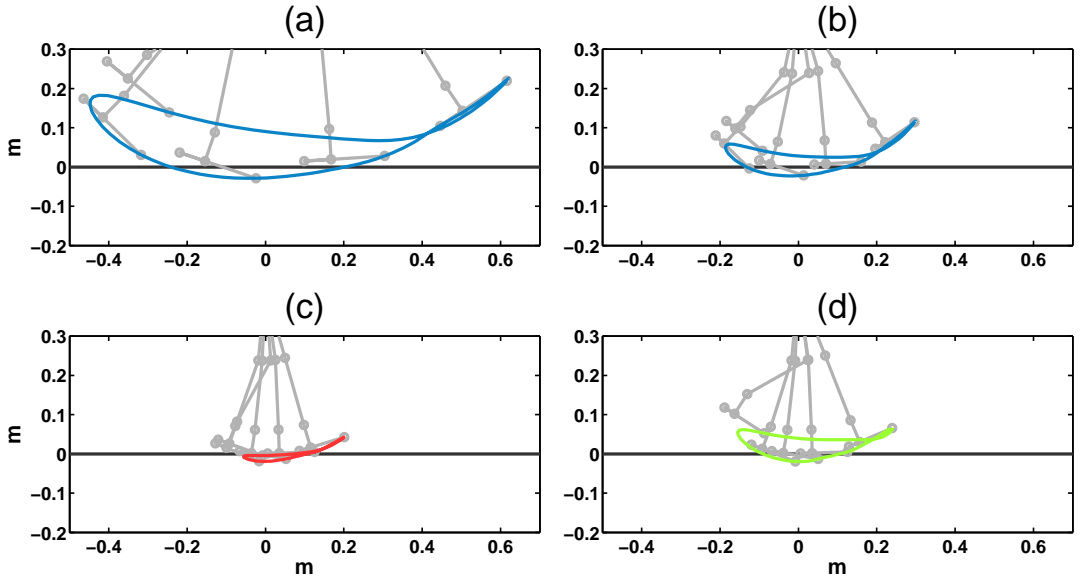
[picture p203: page 1]
