matthieu-lapeyre/phd_thesis/media/poppy/conception/poppy_leg_design.PDF

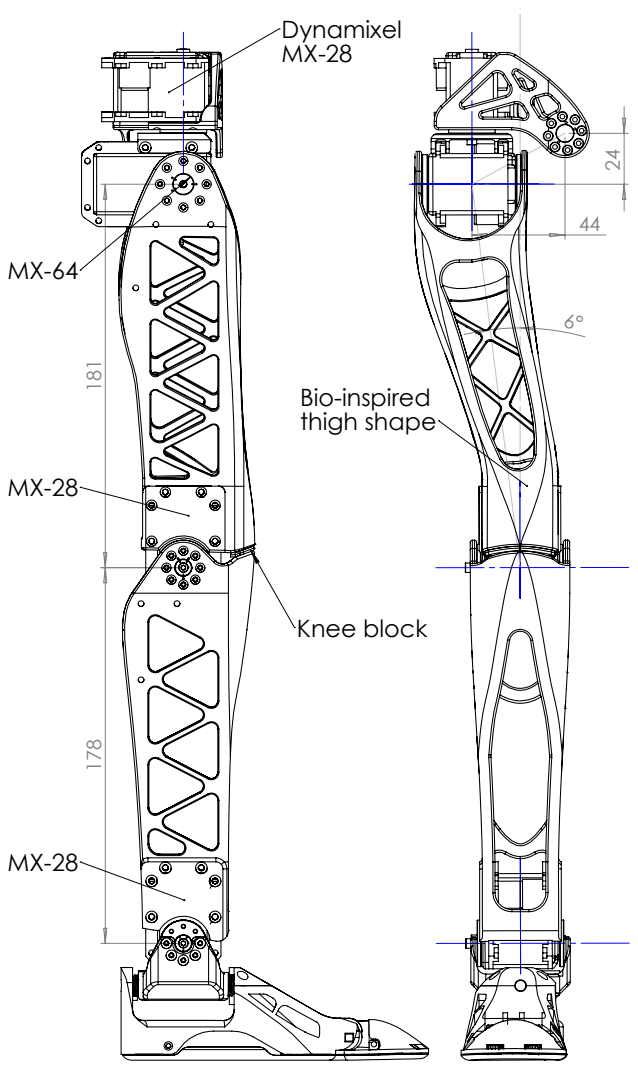
[picture p205: page 1]
thigh shape; Knee block
