matthieu-lapeyre/phd_thesis/media/poppy/conception/poppy_torso.PDF

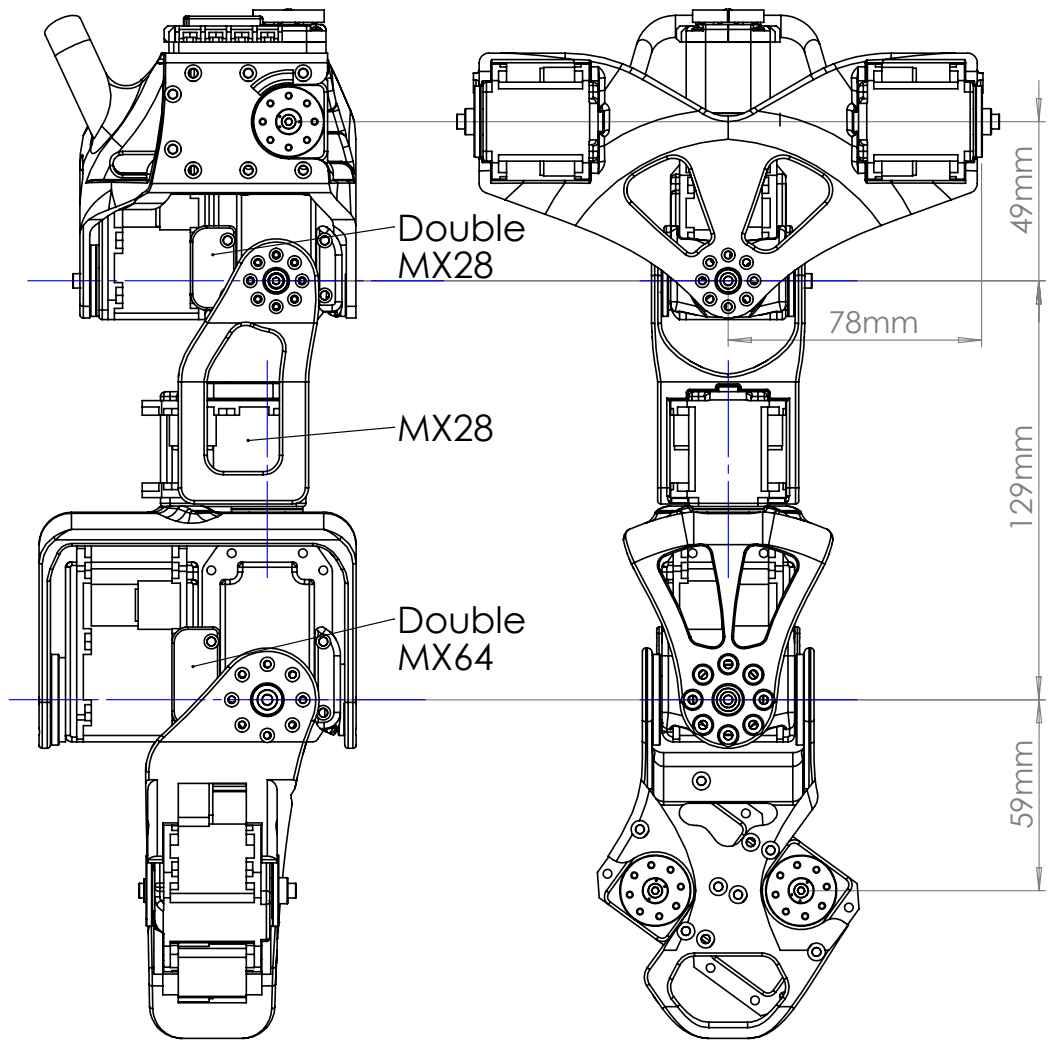
[picture p206: page 1]
