matthieu-lapeyre/phd_thesis/media/poppy/conception/poppy_zoom_hip_blueprint.PDF

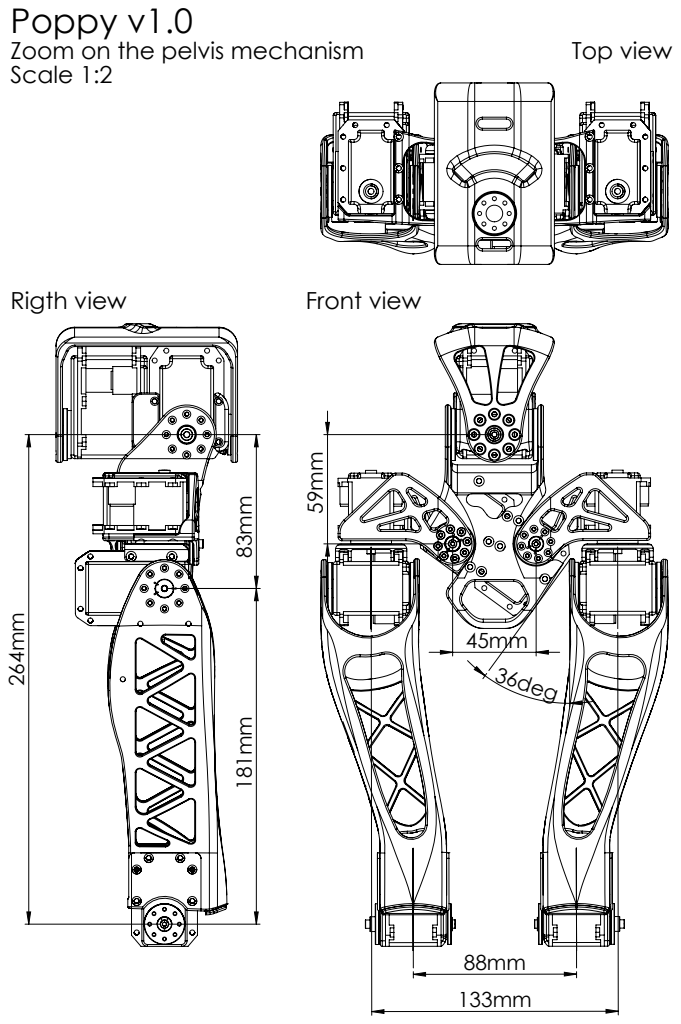
[picture p208: page 1]
Rigth view; Front view; Top view

Poppy v1.0
Zoom on the pelvis mechanism
Scale 1:2
