matthieu-lapeyre/phd_thesis/media/applications/morphology/results/head_x.pdf

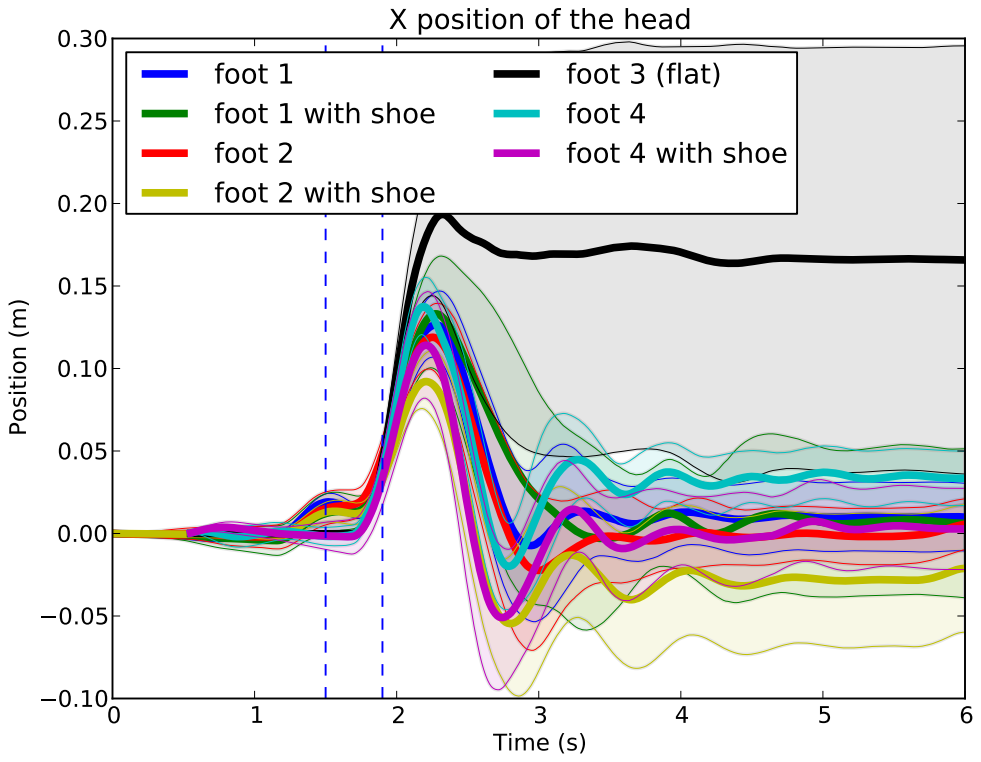
[picture p209: page 1]
Time (s); Position (m)

X position of the head

foot 1
foot 1 with shoe
foot 2
foot 2 with shoe

foot 3 (flat)
foot 4
foot 4 with shoe
