matthieu-lapeyre/phd_thesis/media/applications/morphology/foot_experience.PDF

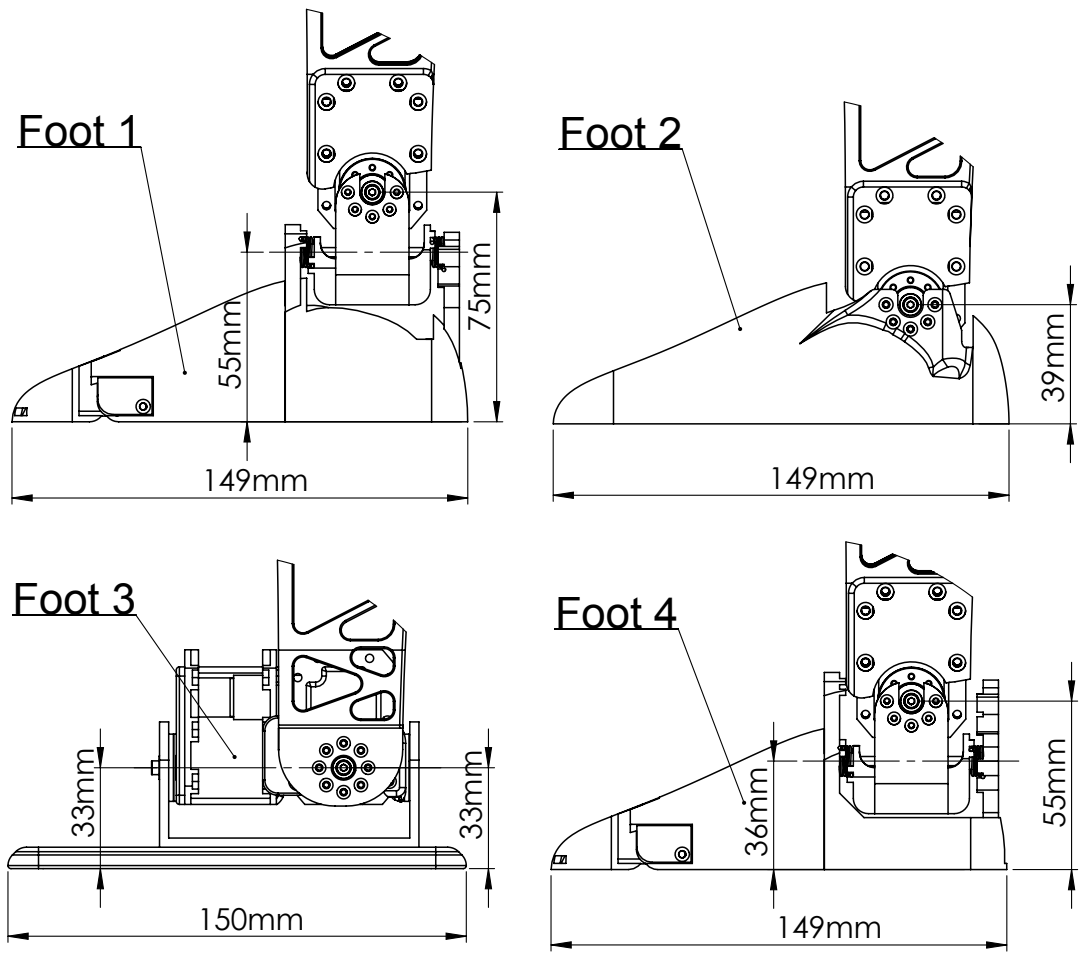
[picture p210: page 1]
Foot 4; Foot 1; Foot 3; Foot 2
