matthieu-lapeyre/phd_thesis/(commit log)

2014-07-27 add poppy flowers chapter illustration
2014-07-27 remove grain from the poppy flowers illustration
2014-07-27 Tired to sort which pictures are actually used, add them all !
